FFsteve/zynq_vibration_monitor/report/final_board_record.md

# 最终实物验收记录表

> 2026-11-02 当前版本说明：传感器校准、真实滤波/ILA 数值对照及比赛演练已有记录，用户现确认最终蜂鸣器上板正常。当前下载、版本和复现入口以 [当前交付](current_release.md) 与工程根 README.md 为准；下文阶段描述保留各自历史时点。

范围说明：2026-11-01用户明确按比赛原型目标收尾。**本表是较完整的实物证据清单，不是比赛必须逐项全部通过的门槛**；“未验证”包含证据或版本登记不完整，不应解释为相应核心功能尚未实现。比赛当前完成度与最后建议见 [比赛收尾范围](../docs/competition_closeout_20261101.md)。保留以下实际结果及缺项，下一步默认一次完整演练和材料/版本整理，不继续按表机械追加测试。

最新比赛结果：`filter_test_final/`静止—X报警—正常恢复三种有效状态检查通过，见 [演练报告](competition_rehearsal_validation_20261101.md)。演练已完成，当前转入比赛材料与版本归档，不再把下表扩展未测项作为交付阻塞。

后续用户新增蜂鸣器：独立system_buzzer_top的软件对照及Vivado构建通过，新bit/ltx位于build/buzzer_release/debug，见 [蜂鸣器报告](buzzer_validation_20261101.md)。原演练结论继续对应原版；新声音尚未上板确认，只补报警响/解除停，不将旧截图当作新增蜂鸣器已验证，也不重开完整工程验收。

状态：**比赛核心功能演示已完成，B03、B07及B08按比赛范围通过，进入材料与演示版本归档**。filter_test_4取得3个窗口特征精确匹配及单拍发布证据；filter_test_final完成静止、X报警和有效恢复状态检查。详见 [演练报告](competition_rehearsal_validation_20261101.md)、[第四次报告](filter_test_4_validation_20261101.md)、[第三次报告](filter_test_3_validation_20261101.md)、[更新报告](calibration_firmware_update_20261101.md) 和 [六面结果](sixface_static_pass_20261101.md)。受控物理频响、三轮冷启动和完整工程边界未签收，保留事实，作为可选扩展，不阻塞比赛收尾。当前演示文件身份与材料尚待统一归档。

| 项目 | 待填内容 |
|---|---|
| 日期、操作者、硬件版本 | 未验证 |
| 发布标识及源码清单SHA256 | 未验证 |
| FPGA bit/ltx路径与SHA256 | 未验证 |
| STM32目标、AXF/HEX及SHA256 | 未验证 |
| 原始/滤波模式、计数尺度 | 未验证 |
| 跳帽、供电测量、接线照片 | 未验证 |
| DL16软件/采样率/深度/通道/门限 | 未验证 |
| PC串口或数字fixture、实际COM口 | 未验证 |

| 编号 | 结果 | 原始证据路径、实际值及未通过原因 |
|---|---|---|
| B01 接线/电压 | 未验证 | 待填 |
| B02 固定源原始回传 | 未验证 | 待填 |
| B03 固定源滤波为零 | 通过 | 2026-11-01 fixed_filter_ila_20261101的5秒记录：1250包D0固定1/−1/−32768，D1零三轴，同SEQ/XOR及位值均正确，无内部缺口或UART警告；报告fixed_filter_ila_validation_20261101.md |
| B04 初始化及六字节对照 | 未验证 | 2026-11-01 session01已取得身份/五项配置实际回读及4931组三路一致证据；本次未取得所烧bit/固件哈希，完整版本签收仍待补，详见session01_initialization_zup_20261101.md |
| B05 真实原始回传 | 未验证 | 用户报告当前D0/D1一致，符合raw预期；尚缺同次完整导出及bit/固件标识，不据此签收整机算法 |
| B06 60秒时序和错误统计 | 未验证 | 已完成60秒记录15030包的统计与三路对照，无内部SEQ缺口；120次约3ms间隔，均值3.991964ms、约250.503包/秒，严格均匀采样原因仍待定位，不再列为缺少60秒数据 |
| B07 同次原始/滤波对照 | 通过 | filter_test_3含初始化及SEQ=0首包，4914个完整D1自首包/预热开始与实测D0驱动定点参考全匹配，三轴最大差0，无输入重建/内部缺口；末D1边界截断单列。首包前静默超过12ms按既有超时规则确定滤波初态，不等于FPGA全局冷启动，详见filter_test_3_validation_20261101.md |
| B08 ILA窗口/RMS/峰值/报警 | 通过 | 按比赛功能范围：filter_test_4三窗MS/RMS/峰值及SEQ与参考精确相同、单拍有效与保持通过；filter_test_final新增静止、X报警和正常恢复有效状态，X报警图直接显示0→1及两高窗，恢复时quality/alarm_valid仍为1。解除边沿与全部边界不是本次比赛签收要求，未冒称已逐拍测完。详见competition_rehearsal_validation_20261101.md及filter_test_4_validation_20261101.md |
| B09 受控数字频率/报警 | 未验证 | 待填；无USB-TTL或标准源则说明未执行 |
| B10 中断恢复/三轮冷启动 | 未验证 | filter_test_3取得一次STM32重启后的初始化及首包滤波恢复数值证据；未捕获失效瞬间和同步ILA恢复全程，未做三轮整机冷启动 |
| B11 配置及量值校准 | 未验证 | 六面离线静态及重复性通过；sixface_r1_20261101_validated的C/Python全范围、三个Keil及HEX校核通过；用户已烧入新固件，filter_test_2及3分别取得4947/4915帧I2C新Q16校准到实测D0全匹配。实际下载产物身份、静止瞬态和周期问题仍待闭环，不再列为没有新固件实际输出 |
| B12 版本和完整演示 | 未验证 | 三阶段比赛演练已完成并取得截图；当前演示文件及报告/答辩材料的最终归档尚待整理，未验证不再表示没有完整功能演示 |

最终结论须区分数字内容、实际时序、传感器量值与校准、实物滤波及报警。每项仅填通过/失败/未验证，不自动把工具可生成文件或程序可烧录写成运行通过。
