FFsteve/zynq_vibration_monitor/report/progress_handoff_20261101.md

# 旧对话追溯与项目接续记录

日期：2026-11-01。用户因旧对话打开卡死，要求先追溯进度并充分理解项目。本记录用于后续新对话接续，不代表新增功能或重新签收历史测试。

## 阅读范围与证据等级

- 通过 `read_thread` 分六批读取“分析 UART RX 设计与硬件约束”（`01a14473-9b54-76b3-a507-fd7123c28133`）可返回的46轮记录，游标已到开头，`hasMore=false`。其中包含第七阶段一次失败及随后恢复完成的记录。
- 核对仓库规则、README、项目上下文、下一步、分期计划、第二阶段协议、最终板测表、第七阶段复核和冻结后校准分析，抽查当前完整系统顶层、核心连接、STM32采集和统一回归脚本。
- 本轮没有重新逐张审阅旧附件、重做原理图引脚或供电签核，也没有读取被引用聊天中不可返回的更早内容。历史聊天里的建议不能替代当前源码、实测证据或正式赛事指南。
- 本轮实际执行的是对话读取、Git状态检查、文件存在性与SHA256核验。历史ModelSim/XSim/Vivado/Keil结果仍标为历史执行结果，不冒充本轮重跑。

## 已确认的目标和范围

系统为MPU6050三轴采集，经STM32标准外设库读取与打包，再由Zynq PL接收、解析、去直流、FIR、窗口特征和阈值报警，最后串口回传。以单人可理解、可独立验证的模块组成竞赛演示系统，不承诺工业故障分类能力。

第一版仅PL，RTL使用Verilog，STM32使用Keil MDK和STM32F10x标准外设库。FFT、PS、AXI、Linux、PYNQ及实时图形上位机没有成为本版已批准必选项。重大新RTL仍须先评审设计；常规阶段自检已获授权自动执行，实物测试集中最终阶段。

十字节布局保持：`A5 5A SEQ XH XL YH YL ZH ZL CHK`，XYZ为大端signed16，CHK为SEQ与六个载荷字节的XOR。UART为115200/8N1。包内没有原始/滤波或校准模式标志，必须在采集元数据中记录固件目标、FPGA模式和尺度。

## 七阶段的实际进度

| 阶段 | 已实现内容 | 当前验收边界 |
| --- | --- | --- |
| 一 | UART RX、两级同步、中心采样、停止位检查及恢复、自检 | 历史双工具仿真通过 |
| 二 | 滑动窗口包解析、2ms字节超时、UART TX及链路自检 | 历史双工具仿真通过；损坏与截断后恢复属于明确要求 |
| 三 | 上电复位、回传队列、通信核心、旧top、STM32固定源/传感器目标、PC记录工具 | 历史软件检查通过；FixedSource截图和SensorSource短记录支持基本实物通信闭环 |
| 四 | 三轴去直流、63抽头定点FIR、调度与通信适配 | 历史数值、RTL、自检及隔离实现通过；实物滤波待验收 |
| 五 | 128样本非重叠窗口、均方值、整数RMS、绝对峰值、滞回两窗报警 | 历史双工具和参考对照通过；真实阈值与板测待验收 |
| 六 | 完整system_top、原始/滤波选择、量化、拥塞/复位验证与两模式实现 | 软件集成和实现通过；实物计划没有因仿真通过而自动完成 |
| 七 | 全量回归、raw/filtered/debug下载构建、rc1冻结、日志与波形补充归档、上板方案 | 软件候选版完成；整机B01～B12最终验收尚未完成 |

历史第七阶段汇总为18个RTL、19个不同自检顶层，ModelSim/XSim共42次阶段运行、24次负向拒绝，PC11项以及可移植C、原两个Keil目标通过。三种FPGA构建保留8项DRC Warning，不能写成零警告。

## 接续时不能混淆的实现细节

- 旧 `rtl/top.v` 是此前通信入口；完整算法入口是 `rtl/system_top.v`。不能因下载旧top或看到raw回传，就认为完整算法已经实物验收。
- 当前 `system_top` 默认 `RETURN_FILTERED=0`，两路对应十字节包一致是原始回传的预期。即使STM32使用实验校准固件，raw回传仍应与STM32输出一致。
- 获批的filtered回传将signed18结果算术右移2位装入signed16字段，PC解码后乘4恢复近似尺度；内部18位计算保持。包内没有模式标志。
- 名义采样率250Hz，三轴去直流基线更新系数1/32，63抽头FIR目标为保留5～30Hz、抑制50Hz及以上。实际采样均匀性仍须验证；去直流不等于传感器校准。
- 特征窗口128样本，名义512ms；报警2000置位、1500解除，连续两窗确认，均为演示参数。缺包或质量失效取消窗口并使报警状态无效，不能解释为正常无报警。
- RMS、均方值、峰值、质量与报警没有加入十字节UART字段，需通过内部接口或ILA观察。MARK_DEBUG不自动创建ILA；debug构建的bit与ltx必须配套。
- 原始模式曾被综合优化移除无负载计算支路，后以427位调试快照寄存器保留，并有重新实现证据。不要仅凭网络标记推断算法支路存在。
- GUI曾出现CDC约束顶层/阶段不匹配和FIR系数未登记；修正入口为 `scripts/configure_project_cdc.tcl`。它修正现有工程，不是从零创建完整GUI工程的脚本。

## 实物证据与当前主要问题

历史FixedSource已取得展示包的双路一致证据；SensorSource两份50ms记录各有12组I2C六字节、STM32三轴字段及FPGA回传对应一致。它们证明所检查短记录的通信，不证明长期无丢包、完整算法或正式量值校准。

静止数据曾按预期量程换算约1.34g；Z正反短记录支持约+5288计数的较大中点偏置，但配置实际回读、姿态及长期稳定性未充分确认，不能认定芯片损坏或直接宣称正式校准成功。旧记录还有边界停止位警告及约3ms包间隔，均保留为待查项。

冻结后分析六面共73个完整包，每面实际仅50ms。实验零偏为X约+704.160、Y约−535.333、Z约+5288.417计数，比例约1.007626/0.994537/0.983183。回代主轴接近正负1g是拟合结果，不是独立验证；横轴残差最高约0.137g。

独立 `stm32/keil/vibration_calibration.uvprojx` 的 `SensorCalibratedTrial` 已生成，软件历史检查覆盖196608个轴输入及应用错误恢复，三个Keil目标均有0错误/0警告记录。当前 `formal_calibration_pass=false`，无实验固件已烧录及板测通过证据。原 `SensorSource` 仍输出未校正计数；重新拟合必须使用该原始目标，不能拿实验校准数据二次拟合。

## 本轮实际核验结果

核验开始时执行 `git status --short --branch` 和 `git log -5 --oneline`：工作区干净，当前为main，本地HEAD及本地origin/main跟踪引用为 `4714435`。旧对话最后一轮记录了该提交已推送；本轮没有联网重新核验远端，也没有提交或推送。

因此旧差距报告中“只有初始提交、成果尚未保存Git”的结论已经过时；后续不得继续列为未完成。rc1目录、Git检查点和当前实验校准状态仍应区分。

使用运行时Python执行只读JSON/SHA256/ZIP条目核验（`python.exe -X utf8 -`，标准输入脚本），实际结果如下：

| 检查 | 本轮结果 |
| --- | --- |
| 当前RTL/TB文件数量 | 18/19，与历史汇总一致 |
| rc1的source.zip内文件对冻结清单 | 177项全部匹配 |
| rc1发布载荷对release_manifest | 97项全部匹配 |
| 实验校准validation.json中的源码 | 12项全部匹配 |
| 实验校准固件 | 2项全部匹配 |
| 实验校准证据，相对证据目录解析 | 13项全部匹配 |
| 本地第七阶段结果文件 | PASS_STAGE7_REGRESSION，10步骤，hardware_tested=false；只是读取历史结果 |

当前工作区相对rc1原177项有8项变化：`.gitattributes`、`.gitignore`、`docs/board_test_plan.md`、`docs/next_task.md`、`docs/project_context.md`、`report/ai_devlog.md`、`report/final_board_record.md`、`stm32/app/acquisition.c`。与冻结后的文档、Git及条件校准改动相符；不能把当前全部文件当作原rc1已验收源码。新增文件也不在原177项清单内。本报告和本轮日志追加还会进一步改变工作区，原冻结目录不变。

本轮未对约819MB补充波形ZIP重新执行完整哈希或逐份GUI审阅，补充归档完整性的结论仅引用历史复核记录。

## 下一步与尚未完成的收尾

1. 确认实板正在运行的bit和STM32目标；原始、滤波、实验校准的模式与版本都应留档。
2. 按既有方案补初始化配置实测回读、同配置预热后六面各约20秒，以及重新摆放后的独立第二轮；同时采集至少60秒时序，定位约3ms间隔。
3. 完成filtered量化、ILA窗口/RMS/峰值/报警、断流恢复、长时间和三轮冷启动，依B01～B12回填真实证据。
4. 新增校准测试和实验Keil目标尚未接入 `scripts/run_stage7.ps1` 的原10步骤，当前只存在单独历史通过记录。
5. 干净检出后的完整复现尚无演练证据；GUI从零建工程入口仍未提供。它们属于交付/学习工作流收尾，不自动扩大为新算法阶段。
6. 正式赛事规则全文尚未取得，报告、演示材料与Skill提交的具体格式仍待对照。板测修正或正式校准通过后再决定新候选冻结，不覆盖原rc1或沿用其哈希。

本轮仅新增这份接续说明并追加AI开发日志，没有修改RTL、STM32、约束、冻结包或烧录设置，没有重新运行仿真、综合、实现、Keil或实物操作。
