FFsteve/zynq_vibration_monitor/report/requirements_audit.md

# 最初要求与最终完整性核对

更新提示：本文为2026-10-31历史审计。2026-11-01已收到并读取正式AMD选题指南，且已完成后续校准、实物滤波/窗口及比赛演练；当前状态以 [正式指南对照](competition_guide_gap_analysis_20261101.md) 和 [一晚收尾计划](../docs/competition_evening_plan_20261101.md) 为准，以下“尚未收到规则/尚未上板”等保留为当时记录，不作为当前结论。

核对日期：2026-10-31。依据为本会话用户要求、AGENTS.md、初始README/project_context、原第六/七阶段截图和各阶段实际证据。**结论：PL软件实现、自动验证和可下载交付已形成完整闭环；新版整体实物验收及传感器量值校准尚未完成，不能表述为全部要求已经上板通过。**

没有收到一份可逐条核对的正式竞赛评分/提交规则全文。因此可核对已知项目要求，不能保证对未知评分、格式、原创性或公开许可条款的完全合规。FFT在初始上下文中是可选项，本版未实现，不将其当作已完成能力。

## 按已知要求核对

| 最初要求或后续确认 | 当前成果 | 判定与边界 |
|---|---|---|
| Zynq-7010 + STM32F103C8T6 + MPU6050 | FPGA/STM32应用、图纸核查、既有三端口约束、MPU6050标准库驱动 | 软件/图纸已核对，实际版本、电压和配置仍需现场复核 |
| 第一版仅PL，不学习PS即可推进 | 全部计算在Verilog PL，ILA也使用PL板载时钟 | 满足；未引入PS/AXI/Linux/PYNQ，保留ZPS7-1 Warning |
| Verilog和标准外设库，不用HAL/CubeMX | 18个RTL模块、STM32F10x标准库工程双目标 | 满足，最终实际重建及自检见第七阶段报告 |
| 50MHz、UART引脚/电压以原理图为依据 | U18、K14、M15及LVCMOS33沿用正式约束；新层次CDC精确切断第一级D | 图纸/工具通过，实测电压/频率未替代为已确认 |
| 十字节包、signed16、大端、XOR、SEQ和错误恢复 | 原协议保持，解析器支持坏包和截断恢复 | 满足，全部自检实际执行 |
| STM32采集，不承担FIR | WHO_AM_I、关键配置回读、DATA_RDY轮询、六字节采集及USART发送 | 软件满足，历史短记录通信一致，初始化/长期采样实测待补 |
| 原始数据回传及PC保存 | raw完整回包，PC二进制/CSV/JSON记录 | 已实现和离线验收；线上COM和长记录需实物验收 |
| 去直流、5～30Hz保留、50Hz以上抑制 | Q16基线 + 63抽头定点FIR，参考/RTL频响取证 | 已知设计目标在仿真中通过，实际传感器和采样条件待测 |
| 窗口均方、峰值、RMS、报警 | 128样本，三轴独立，2000/1500演示阈值、两窗确认 | 已实现/仿真，ILA调试下载版已生成；实物窗口与报警待测 |
| 原始/滤波选择 | RETURN_FILTERED综合参数选择；滤波线缆右移2位，PC乘4 | 按用户明确批准实现；无动态切换命令/模式字段，不假称支持 |
| 完整链路、250包/s、拥塞、延迟、复位 | 两模式长序列、三轴隔离、全部历史清理、队列满丢新包 | 软件验收满足；主长序列为压缩参数，另有默认参数验证，实际采样仍待测 |
| 模块自检，只有执行才报通过 | 18模块均有TB，另有UART链路TB；ModelSim/XSim全阶段回归 | 满足，第七阶段保留当前结果、日志和失败修正；ILA只做工具构建，尚未在板上连通 |
| 保存资源、时序和滤波效果数据 | raw/filtered/debug独立源码重建、DRC/CDC、CSV/JSON和哈希 | 工具证据完整，8项DRC Warning如实保留，不等于板测通过 |
| 文档/注释中文、ASCII路径、可复用skill | 已有中文说明，新增项目技能和结构验证，路径/标识符ASCII | 满足；厂商原文件不翻译不修改，未改全局技能目录 |
| 不破坏旧入口/烧录设置 | 旧top/本地XPR保留，最终system_top由独立脚本构建 | 满足；交付bit/ltx/AXF/HEX，不代为下载或改BOOT/Flash设置 |
| 七阶段回归、修复、冻结和交付 | 一键回归、候选冻结清单、源码包、下载包、完整板测方案 | 软件交付完成；冻结标记为v1.0-rc1，最终实物签收仍待执行 |

## 完整性检查发现并补齐的事项

1. 早期host/requirements.txt只有pyserial，缺FIR参考必需的NumPy，本轮补充依赖并记录实际验证版本。
2. 只有DCP无法直接供初学者下载，本轮从最终源码生成三种bit，并将Keil AXF转换为校验过地址/校验和的HEX，不改Keil烧录设置。
3. 原始协议不含RMS/报警，只有MARK_DEBUG不等于能观察；本轮提供独立ILA调试版和配对ltx/probe_map，填补内部实物观测入口，不新增引脚或协议。
4. skill/原为英文占位说明，现提供基于实际失败与验证过程的fir-validation技能及结构验证，未声称做过独立代理行为评测。
5. 受控机械激励未提供，不能把手摇当频响标准；新增离线数字fixtures和显式COM口回放工具，另列需要USB-TTL的数字验收路径，本轮只做假设备自检、不打开真实串口。

## 仍需实物确认的事项

- B01～B12按 [完整上板方案](../docs/board_test_plan.md) 执行，并填写 [实物记录](final_board_record.md)。新版完整链路尚未下载或采集。
- MPU6050较大静态偏差、实际初始化回读、六面记录、校准和真实采样均匀性；演示阈值不是实际故障分类标准。
- bit/ltx的实际JTAG识别、板上50MHz时钟/IO电压、冷启动流程、长记录与实际滤波/报警表现。
- DRC的DSP流水建议、保留观测网无路由负载和ZPS7配置Warning；没有通过降级或屏蔽规则假称零警告。
- 正式比赛评分与公开资料授权若有额外条款，需提供规则全文再核对。源码包不包含用户厂商库和硬件PDF，重新构建STM32仍依赖本地Libraries。

因此当前适合进入完整上板验收，**不适合在尚未执行时宣称最终实物项目全部通过**。板测发现的问题应形成新候选版本，不改冻结源码后沿用旧哈希。
