FFsteve/zynq_vibration_monitor/report/reference_conversation_gap_audit_20261031.md

# 早期实施对话与当前工程的差距核对

核对日期：2026-10-31。对照用户引用的“FPGA学习项目建议”与当前工作区、历史验证结果和最新校准结果。结论：核心PL信号链的软件已经实现；基本通信有实物证据，但项目尚缺完整算法板测、正式量值校准、真实采样稳定性验证，以及Git和可复现交付的收尾。

## 对话读取范围

使用read_thread读取会话 `6a96c59b-b664-83ea-af67-c74b80f26f4b`，turnLimit=10。接口返回5轮、hasMore=false、无更早游标：三份硬件PDF、核心板与工作流交接、沙箱故障、目录/gitignore、Git推送故障。实际返回的正文包含硬件/采集方案、逐模块开发、自检/综合/实测、Git、复现脚本和Skill建议；不只使用用户提供的最后三轮预览。

没有返回更早的完整选题讨论或正式AMD赛道指南全文。旧助手提及的“比赛要求”只能作为待核对线索，不升级为已验证的正式规则。旧聊天的建议、当前用户已批准的范围、可选扩展与正式评分要求应分开。

## 已实现并有软件证据的内容

| 早期方案或工作流 | 当前实际成果 | 当前边界 |
| --- | --- | --- |
| STM32标准库采集MPU6050三轴 | WHO_AM_I、配置回读、DATA_RDY、连续六字节、UART打包 | 初始化实测证据及长期采样仍待补 |
| PL接收、包解析与发送 | UART RX/TX、十字节大端signed16/XOR/SEQ、超时和坏包恢复 | 历史及当前基本通信证据不等于所有板测通过 |
| 处理重力与偏置直流分量 | 三轴去直流与63抽头定点FIR，250Hz/5～30Hz目标 | 去直流不等于传感器量值校准 |
| 特征提取与异常提示 | 128样本窗口、三轴均方/峰值/整数RMS、滞回两窗报警 | 2000/1500为演示阈值，尚无真实故障分类结论 |
| 仿真、综合和量化 | 18RTL/19TB；历史ModelSim/XSim42次阶段运行、24次负向拒绝；三版资源/时序/DRC | 本次读取既有结果，没有重新运行这些任务 |
| PC保存原始数据 | 命令行二进制/CSV/JSON记录、独立协议解析、数字fixture和比对 | 没有实时曲线GUI；当前可读对话未将其规定为第一版必选 |
| AI协作与可复用Skill | AI开发日志、阶段设计/验证文档、skill/fir-validation技能 | 技能结构验证完成，正式赛事格式及独立使用效果仍需对照指南 |
| 从源码构建下载文件 | build_release.ps1/.tcl生成raw/filtered/debug的bit，debug有配对ltx | 该流程不依赖用户本地xpr，但不等于已验证干净克隆全部流程 |

现有 `build/stage7_regression/regression_result.json` 为 `PASS_STAGE7_REGRESSION`。三版 `release_result.txt` 为PASS，raw/filtered/debug的建立裕量分别5.205/8.300/5.432ns、保持裕量0.037/0.028/0.014ns。依据为既有实际执行记录，不将其冒充为本次重跑结果，也不覆盖后续新增C代码的全部验证。

## 尚未完成的工作与建议优先级

| 优先级 | 待办 | 目前依据与验收内容 |
| --- | --- | --- |
| 高 | 正式六面量值校准 | 当前六面均为50ms，共73完整包；实验系数/C代码已验证，但无长记录和独立第二轮，横轴残差最高约0.137g。补同配置每面约20秒、重复摆放与配置回读，固定第一轮参数验证第二轮 |
| 高 | 真实250Hz采样稳定性 | xn有3.00345ms、旧zp有2.99475ms间隔。需至少60秒线缆记录及SEQ/错误统计，定位异常；不能靠改时间标签或零偏参数使其“通过” |
| 高 | 滤波功能的板上量化 | 当前D0/D1一致符合raw预期，只支持原始回传。需filtered版、明确乘4尺度、原始与滤波记录、已知数字频率输入及实际滤波效果证据 |
| 高 | 窗口特征与报警板测 | 使用匹配debug.bit/ltx，通过ILA核对128样本窗口、三轴MS/RMS/峰值、窗口ID、质量无效与报警置位/解除。UART十字节本身没有这些字段 |
| 高 | 长时间/异常恢复/冷启动 | 已有仿真覆盖，但还缺整机实物断流/恢复、复位、三轮冷启动和连续演示记录。按B01～B12逐项回填，不因raw正常而自动通过 |
| 高 | 保存当前成果的Git提交 | 实际git log只有e4145f0初始提交，标签只有v0.0，RTL/仿真/host/脚本等大量未跟踪或未提交。完成范围审查后提交已验证成果；不得把本地rc1文件夹当作已有同名Git标签 |
| 中 | 将新增校准纳入统一回归 | 当前run_stage7.ps1仍只有原10步骤：未调用test_calibration.ps1，也未构建SensorCalibratedTrial。它们单独通过，但还不是统一入口的一部分 |
| 中 | 干净检出的复现演练 | 核对工具版本、参数、NumPy/pyserial、MEM、STM32本地Libraries依赖；在独立干净目录重建并记录结果。源码ZIP和独立build已有证据，Git clone目前却无法取得未提交文件 |
| 中 | GUI工程创建入口 | 没有create_project.tcl。configure_project_cdc.tcl是已打开工程的修正脚本，不负责从零添加全部RTL/TB/XDC/MEM和选择顶层。为学习/演示补一键建工程入口有价值；现有批处理bit构建仍然有效，不把它称作核心算法缺失 |
| 中 | 最新记录与最终版本统一 | README/host说明和最终板测表仍有早期“未上板/仅两STM32目标”等时点描述；实验校准及GUI修正也不属于已冻结rc1。通过板测后统一版本、报告、日志与哈希，再决定新候选冻结 |
| 待规则 | 竞赛提交与Skill实际效果 | 可复用技能、源码包和AI日志已存在；正式报告、演示视频、Skill提交格式/调用效果、开源清单等是否必交及具体格式，需要正式指南原文核对，不从旧助手口述推定 |

Git远程origin已经配置，本轮只读取本地状态，没有联网核对远端是否另有手工上传，也没有commit、tag或push。另发现 `report/evidence/__pycache__/analyze_sensor_capture_20261030.cpython-312.pyc` 仍出现在可提交的未跟踪列表，说明 `!report/**` 放行覆盖了通用缓存排除，正式提交前应完善忽略规则。没有擅自暂存或删除该文件。

## 已更正的旧描述，不应重新当作待实现任务

- 旧对话将PL_GCLK写成U13；本次重新提取并渲染核对 `docs/hardware/zynq_core_2v5.pdf` 第3页，X1的50MHz输出经R7连接PL_GCLK，再接Bank34的U18。U13对应B34_L3_P/PUDC_B。现行top.xdc使用U18，不应改回旧聊天的U13。
- 旧对话推荐PB6/PB7的I2C1；当前根据用户实际扩展板选择通讯接口2的PB10/PB11、I2C2。本次实际读取并渲染F盘扩展板原理图第3页核对，J3/J4的3/4脚分别为PB10/PB11。旧I2C1方案并非必然电气错误，但不应覆盖已确认的当前配置。
- 旧对话中的top_candidate.xdc和四端口带rst_n示例已被正式约束与当前顶层替代；不是还缺外部复位引脚或LED模块。当前上电复位与调试方式已有明确设计。
- 旧对话给出的create_project.tcl等文件名是工作流建议，不要求必须逐字沿用；现有批处理脚本已经承担仿真、综合/实现和资源报告功能。

本次只读的PDF来源：仓库 `docs/hardware/zynq_core_2v5.pdf`，以及用户已提供的 `F:/野火小智STM32F103C8专题资料/5-配套模块/0-野火小智STM32F103C8T6扩展板/原理图_尺寸图/野火小智STM32F103C8T6扩展板原理图.pdf`。原文件未修改或复制到交付目录，渲染图只放在被忽略的build/reference_conversation_audit下。图纸核对不替代板上频率、电压或连接实测。

## 可选扩展与当前范围

FFT/频谱、PS/AXI/Linux/PYNQ、DMP/陀螺仪、OLED和实时图形上位机均未实现。当前已确认版本以PL振动处理为范围，FFT在项目上下文是可选项，其他功能没有获准成为本版必选项。若完整原始指南另有要求，再列入新增范围；不能仅因旧对话提到未来FFT，就推断第一版少做了一整个阶段。

## 本次变更与后续顺序

本次仅新增本核对报告、更新最终板测记录表的状态说明和AI日志，没有修改RTL/STM32程序、参数、约束、Git历史或冻结交付包，没有重新仿真、实现、烧录或采集。

建议先保存当前已验证软件的Git检查点并标明实验校准状态；再完成同配置长记录、采样时序与独立校准；随后验证filtered/ILA/报警及长时间/冷启动；最后补齐统一回归、干净复现、最终报告与新候选冻结。若先改善学习工作流，可先补GUI工程创建脚本，不因此增加FFT或PS范围。
