FFsteve/zynq_vibration_monitor/report/stage7_completion_review.md

# 第七阶段中断前计划的逐项复核

复核日期：2026-10-31。依据为用户补充的原第六/七阶段截图、`docs/stage_plan.md`、中断前形成的第七阶段任务和当前真实文件。**结论：软件任务已完成；发现的波形/部分日志交付遗漏已补齐；原计划的整机冷启动和完整实物演示仍未执行，不能将整个实物验收称为完成。**

本轮没有再次运行全部仿真、综合或Keil，而是核对其已完成日志、当前结果、冻结源码及交付文件哈希；没有代码改动需要重新验证这些功能。没有接线、下载、复位、测量、采集或打开真实串口。

## 原计划逐项对照

| 中断前预定任务 | 本次复核到的实际证据 | 状态 |
|---|---|---|
| 修复已发现问题 | PowerShell stderr包装、ILA比较单元参数及计算分支保留问题均有首次失败与修正后成功记录 | 软件部分完成 |
| 运行全部自检TB | 18个RTL、19个不同TB；ModelSim/XSim共42次阶段运行，当前结果均PASS/errors=0 | 完成，依据既有实际执行记录 |
| 重跑失败案例 | 最终一键回归10步骤成功；三版重新构建成功；边界/错误恢复、负向拒绝覆盖保留 | 完成，不把初次失败当通过 |
| 最终源码重新综合、实现、检查时序/DRC | raw/filtered/debug三版bit、DCP及报告存在；setup/hold分别5.205/0.037、8.300/0.028、5.432/0.014ns | 完成，保留8项DRC Warning，不是零警告 |
| 版本冻结 | rc1源码ZIP的177个文件逐项核验，97项交付载荷哈希一致，ZIP CRC正常 | 完成，冻结候选包未改 |
| 操作说明与上板方案 | `docs/stage7_delivery.md`、`docs/board_test_plan.md`、B01～B12记录表存在，覆盖接线/下载/固定源/传感器/滤波/ILA/恢复 | 文档完成，方案不等于实测 |
| 波形整理 | 原本全部42个WLF/WDB只留在build，rc1交付清单未包含；本轮已另行归档、建立阶段/TB索引并核验每个文件 | 原有交付遗漏，现已补齐 |
| 日志与AI开发记录 | 原源码ZIP含AI日志、候选包含回归日志；原包外的最终构建、首次失败日志现收入补充包，并追加本轮复核记录 | 完成 |
| 从干净启动可重复运行、完整实物演示 | 软件回归/构建与上电复位TB通过；但新版B01～B12仍未实测，没有整机三轮冷启动或ILA硬件采集记录 | 未完成实物验收 |

因此，上一次“软件候选版已完成”的结论成立，但“交付证据整理已经完整”不够严谨：原候选包没有直接收录波形和部分构建/失败日志，本轮已用独立证据包补交。

## 补交内容

原候选包仍为 `build/release/v1.0-rc1/`。补充包单独位于：

```text
build/release/v1.0-rc1-evidence-20261031/
    simulation_waveforms.zip
    evidence_manifest.json
    external_dependencies.json
    logs/
    completion_review.md
    ai_devlog_review.md
    review_manifest.json
```

- 波形ZIP有42个实际仿真文件：每工具21份，包含重复的队列/解析器针对性回归。总原始大小约1.020GB，压缩包818807700字节；没有重新生成或伪造波形。
- `evidence_manifest.json`记录每份波形所属阶段、TB、原路径、压缩包内路径、大小和SHA256；ZIP CRC与逐文件解压哈希均通过。
- `logs/`补入第七阶段最终回归、首次中断、最终构建、ILA首次失败等日志；保存技能结构验证的本次正常结果。
- `external_dependencies.json`是复核时本地88个STM32库文件的指纹，只给出路径与哈希，不分发厂商源码；不冒充此前编译时独立留存的依赖快照。

解压波形ZIP后，可用相应版本的ModelSim打开WLF，或在Vivado中通过 `File -> Simulation Waveform -> Open` 打开WDB。完整系统示例路径为 `modelsim/stage6/system_monitor_core/vsim.wlf` 和 `xsim/stage6/system_monitor_core/stage6_system_monitor_core.wdb`。本轮完成的是文件与归档完整性核验，没有逐份进行GUI波形审阅。

## 冻结与本轮修改的边界

没有改动rc1目录、其中的源码ZIP、bit/ltx、STM32固件或发布清单；也没有修改RTL、STM32源码和原Vivado工程。本轮只新增复核/补充证据，并向工作区 `report/ai_devlog.md`追加复核条目。

因此，冻结源码ZIP内177项仍全部匹配原source_manifest；工作区AI日志是冻结后追加的记录，预期与原快照的AI日志哈希不同，不代表旧包被修改。其他原有冻结源码应继续匹配；本轮新增报告和证据不伪装成rc1原清单的一部分。补充包另有review_manifest记录自身哈希。

## 仍待实际执行

按 [上板方案](../docs/board_test_plan.md) 执行B01～B12，并填写 [实物记录](final_board_record.md)，重点包括新版整机的三轮冷启动、ILA识别和采集、长期采样、传感器初始化/校准，以及真实滤波和报警表现。历史第三阶段短通信记录不能替代这些结果。

本轮没有发现需要重写或重新编译的软件功能遗漏；剩余工作的性质是实物验收。完成这些记录前，准确表述应为“第七阶段软件和交付整理完成，整机实物验收待完成”。
