FFsteve/zynq_vibration_monitor/docs/next_task.md

# 蜂鸣器版本交付与后续设计报告

> 2026-11-02 当前版本说明：传感器校准、真实滤波/ILA 数值对照及比赛演练已有记录，用户现确认最终蜂鸣器上板正常。当前下载、版本和复现入口以 [当前交付](../report/current_release.md) 与工程根 README.md 为准；下文阶段描述保留各自历史时点。

## 当前主线：保存最终工程，再编写设计报告

2026-11-02 用户确认最终蜂鸣器上板正常，并要求先完成 MIT 开源、Git/GitHub 同步、独立工程包和全流程 Skill。当前根 README、skill/README、report/current_release.md 与 scripts/package_final.py 是交付入口；设计报告按用户安排后续完成，优先补充应用价值、系统框图、真实量化/资源时序、优化依据、AI/Skill与复现说明。

保持 Vivado 2020.2 和当前纯 PL 架构，不迁移 PYNQ、不升级工具链、不重开全套板测。以下章节保存此前工作安排，不应重新作为当前待办执行。

## 历史记录：板载蜂鸣器报警扩展

用户在原比赛演练完成后请求增加蜂鸣器。已核对底板/核心板实际图纸及厂家资料：有源BEEP为M14/Bank35，高电平导通。新增alarm_buzzer和独立system_buzzer_top，原system_top及18份既有RTL不变；ModelSim/XSim的模块自检和新旧顶层逐拍对照均通过。已实际生成 `build/buzzer_release/debug/system.bit` 与同目录ltx，独立50MHz实现建立/保持裕量7.377/0.020ns，保留8项DRC Warning。见 [蜂鸣器扩展](buzzer_design.md) 和 [验证报告](../report/buzzer_validation_20261101.md)。下一步仅由用户下载新配对文件，保持当前STM32校准程序，确认静止不响、报警响、解除停；原比赛三图属于旧版，不能替代新增声音的实测，不重新开始完整测试清单。

## 历史记录：按比赛目标收尾

2026-11-01最新状态：`filter_test_final/`三张截图已实际审阅，静止RMS23/23/29且无报警，运动X轴RMS3372并报警001，放稳后RMS17/18/21且报警000，三种状态quality/alarm_valid均为1。报警图还直接显示X位0→1，前后两高窗符合确认规则。**三阶段比赛演练检查通过，默认功能测试结束，下一步材料整理和当前演示文件归档。** 详见 `../report/competition_rehearsal_validation_20261101.md`。

已完成的操作步骤保留于 [一次完整比赛演练](competition_rehearsal_20261101.md)，供现场复现使用，无需为收尾再次重复采集。

用户强调这是独立学生比赛项目。按 [比赛收尾范围](competition_closeout_20261101.md) 执行：核心采集、校准、通信、滤波和窗口数值已取得实物证据，已观察Z报警；下一步只建议一次完整演练，补观察正常解除，整理现有结果和当前演示文件。原B01～B12是完整证据清单，未全部签收不等于比赛功能都没完成。

不再默认要求报警边沿逐拍捕获、全部频点实物回放、三轮冷启动、重复六面/60秒或已覆盖的故障逐项上板；这些保留为可选扩展。演练出现实际功能问题再针对性定位；规则另有明确要求时补相应缺项。保持已测/未测事实，不把缩减范围写成测试通过。

前述 [报警边沿采集](alarm_edge_capture_20261101.md) 方案仍保留，作为可选提高项，不再是默认下一步。

## 最新板测：第四次ILA窗口数值通过，已观察Z报警

2026-11-01的filter_test_4/static及motion均取得原始ILA/CSV，两份CSV与各自.ila嵌入文件相同。static新窗精确匹配本次窗口0，MS/RMS/峰值全相同；motion前后两窗精确匹配本次窗口6/7，三轴全部相同，单拍feature_valid与保持由1024点CSV确认，B08窗口数值子项通过。用户确认static未重配、motion重配过FPGA，两份均在对应DL16期间触发；累计ID5620及54通过数值唯一匹配定位，不因非零重采。

静止4752帧I2C校准/D0/D1一致；运动4829帧实测D0校准匹配，I2C/D1共4834帧连续，D0约3.34秒缺5帧仅作I2C重建，滤波全匹配；缺测后纯实测独立3145帧也匹配。两份各41次约3ms仍在。详见 `../report/filter_test_4_validation_20261101.md`。

运动ILA已见Z轴报警100：窗口6 RMS=2226，下一窗325仍保持100，与参考两窗确认一致；前一高窗2975及后一解除窗416为模型结果，当前ILA没有覆盖置位/解除边沿。下一步优先补正常报警解除与置位边沿的原始ILA及同次输入，然后B10同步中断恢复和三轮冷启动；B09受控数字频率独立待测。无需重复本轮窗口数值或六面校准。以下为历史记录。

本轮使用的操作说明保留于 [ILA同步采集操作](ila_next_capture_20261101.md)，它是已执行记录的方案，不再作为尚缺两份采集的待办。

## 最新板测：第三次记录B07通过，下一步补完整ILA与恢复

2026-11-01 `filter_test_3/` 实际捕获初始化、配置回读及SEQ=0首包，D0共4915帧全部与新Q16校准匹配；4914完整D1从首包起与定点参考精确一致，包括预热，不用重建或舍弃前段，B07本记录通过。末D1为20秒右边界截断，6字节前缀匹配，不当中途丢包。首包前无数据超过12ms、按既有断流重建规则确定滤波初态；不是FPGA全局冷启动。

复位前ILA截图独立核对：ID8AC→8AD，SEQ3E/BD→BE/3D均128点，非零MS/RMS/峰值及开方关系合理，quality/alarm_valid=1、alarm_axes=000、dropped=0。历史重建/作废各6未在图中增加，不将其归于后续采集。没有原始ILA数据，不能与复位后的UART直接逐窗配对。详见 `../report/filter_test_3_validation_20261101.md`。

下一步B08保存静止/移动的原始ILA数据及CSV，继续B09受控连续两窗报警和B10同步中断恢复/三轮冷启动；不再要求重复本次已完成的真实滤波对照或六面校准。本次模型预测37窗RMS最大1099/381/533，低于2000，慢动作不报警符合预期，但不是实测报警验收。41次约3ms短间隔仍在，实际约250.526包/秒，采样均匀性仍待定位。以下为历史接续，最新状态以本节为准。

## 最新板测：新校准输出与真实输入滤波已取得逐帧证据

2026-11-01用户新增 `fixed_filter_ila_20261101/filter_test_2/`，并确认未重新配置FPGA、STM32启动后才记录，约5.76秒开始移动且可能碰探头。实际20秒记录：D1共5010帧连续无误，I2C共5009笔六字节读取，4947帧I2C经新Q16校准与实测D0完全一致。板上新校准公式已得到数值验证，不再列为“没有实际输出”。

D0在5.763～6.041秒受扰，缺62帧并有起止位/Break错误；D1与I2C连续，较支持探测路径受扰，不能直接称FPGA丢62帧。未知初态保守传播并按连续实测段分别预热1024样本后，2892帧三轴D1完全精确匹配参考；另以I2C重建缺测输入，整体后段3986帧也匹配，实测与重建分别标注。详见 `../report/filter_test_2_validation_20261101.md`。

下一步B08真实动态ILA：保留同版debug bit/ltx，用feature_valid触发，保存静止/移动的完整窗口及原始ILA数据、CSV，核对MS/RMS/峰值、SEQ、ID、质量/报警与历史计数。若补严格B07启动证据，则停止STM32、重配FPGA、先开始采集再启动STM32，固定探头后做静止—移动—静止；不再重采六面。本记录39次约3ms短间隔仍在，B07完整启动、B08动态报警、B09受控频率和B10恢复/冷启动尚未整体签收。以下为历史接续，最新状态以本节为准。

## 最新板测：固定源滤波归零通过，进入真实输入对照

2026-11-01用户提供 `report/evidence/fixed_filter_ila_20261101/`。本轮实际离线检查5秒D0/D1各1250完整包，输入固定1/−1/−32768，输出零三轴，对应SEQ/XOR及字节位值全部一致，无内部缺口/警告；B03本份记录通过。间隔平均约3.999949ms、范围3.992～4.002ms，没有约3ms短间隔，但不能因此将SensorSource问题撤销。

ILA截图人工核对质量/报警有效、零MS/RMS/峰值、alarm_axes=000，窗口C1→C2且首末SEQ跨度符合128样本。历史filter_restart/aborted_windows各2，原因未定；左值栏feature_valid=0为起点光标，不等于触发失败，单拍/512ms周期未由截图自动验证。B08只取得固定源零特征证据，不整体签收。

下一步B07：新SensorCalibratedTrial配同版debug，干净启动保存同次D0/D1，以已校正D0驱动参考、D1乘4恢复尺度；先静止和简单运动观察，再进入受控动态/报警。B10另从干净配置记录重建/作废事件和冷启动。详见 `../report/fixed_filter_ila_validation_20261101.md`。

## 当前板上GUI版本：原始回传加ILA

2026-11-01用户说明板上已加载 `vivado_project/zynq_vibration_monitor.runs/impl_1/system_top.bit` 与同目录ltx。本轮只读核对既有产物：顶层system_top、综合日志RETURN_FILTERED=0、u_ila_0共21组427位，生成bit成功；既有路由时序WNS=5.573ns/WHS=0.016ns，保留8项DRC Warning。文件指纹与探针映射见 `report/evidence/gui_bitstream_20261101.json`，未重跑构建或通过硬件管理器读取板上版本。

可以先保持这组文件进行FixedSource＋ILA内部窗口验证。该版为raw回传，D1应与D0相同，不能要求D1零三轴；内部有效窗口MS/RMS/峰值应为0。u_ila_0/probe19为debug_feature_valid_o、probe20为quality_valid、probe18为alarm_valid、probe17为window_id。与预制stage7_ila探针编号不同，按实际ltx信号名设置。

当需要从D1检查滤波数据时，再用RETURN_FILTERED=1的版本或现成配对filtered/debug产物；若修改GUI综合参数则重跑综合/实现/bit并使用新ltx。当前只加ILA并未改变回传选择。以下“D1零三轴”的步骤仍限filtered回传模式。

## 当前接续：校准暂时收尾，转入算法板测

2026-11-01用户明确表示传感器校准暂且结束，询问按原计划继续做什么。保留已完成的六面离线静态、参数更新及软件构建结果；新参数固件实际板测未提供，不能补写为通过。暂不继续采六面或调整参数。

当前首个操作为B03结合B08的固定源测试：STM32原工程选择FixedSource；FPGA使用已生成的filtered版或配对debug bit/ltx，采D0/D1约2～3秒。D0为固定1/−1/−32768，D1应为零三轴且SEQ/XOR正确。通过后以feature_valid触发ILA，检查quality/alarm_valid、window_id和零MS/RMS/峰值、alarm_axes=0。手工ILA版本必须核对RETURN_FILTERED，增加ILA不会自动把raw改为filtered。

随后进行B07真实输入原始/滤波同次对照、B09受控数字频率与报警、B10中断/恢复及三轮冷启动，再补最终回归/版本和B12演示归档。真实输入可用本次SensorCalibratedTrial，D0已校正，D1滤波signed16乘4后与以D0为输入的参考比较；不能再要求I2C原始六字节与校正D0直接相同。没有实际记录不标为通过。

约3ms周期和旧60秒静止瞬态仍是独立未解决项；当前固定源功能验证不依赖先重做传感器标定，真实动态频响签收仍需处理或明确这些时序/信号条件。统一第七阶段校准专项接入和干净复现也保留后续收尾，不重复已有60秒采集只为满足时长。

## 2026-11-01校准参数已更新并完成软件构建

用户授权根据已通过的静态测试更新参数。独立SensorCalibratedTrial已改为 `sixface_r1_20261101_validated`：Q16零偏47687499/−36176278/341942451、比例65840/65180/64097。原SensorSource/FixedSource保持原行为，原始十字节布局、RTL/约束和rc1不改。参数与验证见 `../report/calibration_firmware_update_20261101.md`。

本轮实际通过196608轴值C/Python、错误恢复/固定源绕过、原可移植测试、三个Keil目标0错误/0警告、实际C映射六面30059样本及HEX校验。旧参数/实验固件已另存，当前版本副本在 `build/stm32_calibration_versions/sixface_r1_20261101_validated/`。首次Keil因旧编译器DLL重定位失败，换执行环境后成功，日志均保留。

下一步使用新独立目标或同版HEX由操作者下载，保存代表姿态实际校正输出；本轮未烧录。D0此时已校正，raw回传D1仍应逐包一致，不能再当原始标定数据。周期3ms、静止瞬态、滤波/ILA/报警及冷启动仍单独验收；不要再把“参数尚未更新”列为待办。

## 2026-11-01静态离线指标已通过

最新报告为 `../report/sixface_static_pass_20261101.md`。新增yp_r2b以第一轮固定参数校正后均值约−0.026069/+1.000052/+0.027492g，合成均值1.000789g，满足建议目标。结合xp/xn/zn_r2b和原yn/zp_r2，六面均值指标及三轴偏置/比例重复性全部满足；第一轮参数未改，不必继续为凑均值采六面或重拟合。

结果单独记录offline_static_validation_pass=true，新参数固件板测仍为false。下一步转向这套第一轮参数的新固件落地、定点/恢复/Keil检查及实际输出验证，保留原SensorSource和rc1；旧SensorCalibratedTrial仍是旧短记录参数，未更新。3ms周期和旧60秒瞬态、完整滤波/ILA/报警/冷启动仍各自待查或待验收。

## 2026-11-01补采复核的最新状态

见 `../report/sixface_r2b_validation_20261101.md`。已明确选取原_r2目录内xp/xn/zn的_r2b、新替换yp_r2和原有效yn/zp_r2。新yp不再重复，六份共30059完整D0包，可比通信全部一致，第一轮参数未改。旧重复yp原文件由用户删除，旧报告和派生结果保留。

xp/xn/zn复测均满足既定均值指标，结合yn/zp共5面满足；只剩新yp校正后Z均值+0.091213g超0.05g，主轴与合成幅值均值满足。三轴重复性诊断偏置差+8.93/−24.21/+17.17计数、灵敏度差−0.00417/−0.19546/−0.03263%，均在建议范围。

下一步只针对Y朝上核对姿态后保存yp_r2b，不用全部六面重采或改变第一轮参数；若确认姿态后仍重复超限，再查模型和条件。周期3ms及旧60秒瞬态仍待查，formal_calibration_pass=false，旧实验固件未更新。

## 2026-11-01第二轮验证的最新状态

见 `../report/sixface_r2_validation_20261101.md`。已用第一轮固定参数分析r2六目录，发现yp_r2的三CSV及四路原始采样均重复xn_r2，故仅五份独立记录。Y朝上需要找回真正原记录或补采，单纯重导出当前yp原波形不能修复；Y重复性标为不可评估，不把错误目录计算成器件失效。

有效五面的可比通信均通过，主轴均值误差<0.005g、合成幅值均值约1g；yn/zp满足建议均值指标，xp/xn/zn横轴有0.059～0.084g残差而未满足0.05g目标。X/Z两轮偏置/灵敏度诊断差在建议范围内，但未替换验证参数。下一步先补正确yp，再用固定支撑针对xp/xn/zn复核，保留旧r2记录，不自动六面全重测或重拟合第二轮。

第一轮参数文件及24份r2输入在分析中未改；formal_calibration_pass=false。周期性3ms间隔与旧60秒静止瞬态仍待查，旧实验固件参数未更新。

## 2026-11-01第一轮六面长记录已齐

最新结果见 `../report/sixface_r1_analysis_20261101.md`。用户补齐X/Y并确认同模块、原SensorSource与配置不变、摆稳静止；六份各20秒、共30059完整D0包。六份可比I2C→D0→D1全部一致，首尾片段单列，无内部SEQ缺口。24份原文件哈希前后相同。

新三轴初值b约727.653493/−552.006188/5217.627726计数，k约1.004642976/0.994565297/0.978043625。同批回代非主轴最大均值残差约0.049664g，合成均值约1.000146～1.002082g，但主轴正负1g是拟合结果，尚无独立第二轮，formal_calibration_pass=false。下一步采同配置r2六面各20秒，以这套固定参数独立验证，不再列缺少第一轮X/Y。

xp/yn存在静止瞬态，zn的Y残差接近0.05g，xn横轴有缓慢变化；各新记录均39个约3ms间隔，周期/瞬态问题仍待查。旧实验参数头和SensorCalibratedTrial固件未更新，不能当作本轮六面参数版；本轮未修改功能程序或烧录。

## 2026-11-01无复位Z正反面和60秒结果

同日最新复核：用户已补正确Z朝下I2C导出，14991笔完整事务ACK正确，5009个完整包I2C→D0→D1全部一致；末尾额外一次读取对应截断包头。此前误导出待办已解决，原波形与D0/D1未变；新复核另存 `report/evidence/20261101_noreset_analysis/zn_i2c_recheck/`，不覆盖首次问题证据。

最新结果见 `../report/noreset_zpair_60s_20261101.md`。三个波形实际达到60/20/20秒，完整D0包分别15030/5010/5009，均无内部SEQ缺口。60秒与Z朝上20秒的I2C→D0核对通过；可比D0→D1全部相同，边界片段单列。Z朝下命名为I2C的CSV实际与D0完全相同，应从已保存atkdl重新导出，不必重采。

新Z两点初值bz=5217.627726计数、Sz=16751.809000计数/g、kz=0.978043625，尚未写固件，formal_calibration_pass=false。Z正反20秒已达到时长，可作第一轮初值，不再要求因首末包跨度略短于20秒重采；补同条件X/Y与独立第二轮。

60秒确认120次约3ms间隔，平均每0.502秒重复、发包率约250.503包/秒；时长证据已取得，后续应针对时基/轮询关系定位。用户确认全程固定静止未主动触碰，但6.3/13.4/34.4秒等处有明显原始数值瞬态，Z范围13704～30258，三路一致；原因未查明，不删除后宣称静态精度正常。

## 2026-11-01最新实物记录

已分析用户确认的原SensorSource、Z朝上静止20秒记录，详见 `../report/session01_initialization_zup_20261101.md`。本份记录实际回读75=68及6B=01/1A=02/19=03/1C=00/38=01，初始化证据已补齐；4931完整包I2C→D0→D1全部一致。中途复位形成320.779ms包起点间断，复位后完整包起点跨度18.623761秒，不能拼成正式20秒连续姿态样本。

排除复位后首秒的4415样本中，XYZ均值约675.672/−653.086/21979.931，合成约1.342788g，偏大持续存在。该稳态段平均发包约250.500包/秒，有35个约3ms间隔，后续约每0.5秒重复；1ms轮询与DATA_RDY相位关系是待验证方向，不宣称根因已定位。

当前优先保持原固件与raw回传，预热后采无复位的六面各20秒和独立第二轮，并另补60秒时序记录。无需重采同样的初始化来替代正式姿态记录，也不将本次回读证明追溯套用到旧六份短记录。正式校准、滤波/ILA/报警和最终整机验收仍待完成。

第一、二阶段已获用户接受。第三阶段已完成软件与仿真闭环，并取得基本实物通信证据。2026-10-30 用户同意把传感器偏差后续处理，以第三阶段基本通信成果作为基础，授权进入第四阶段；进一步确认暂按250Hz采样、保留5～30Hz、抑制50Hz及以上设计。

用户于 2026-10-29 开始中途板测，已提供 FixedSource 双路整包回传截图。2026-10-30 授权查看 SensorSource 的已有 50 ms 记录，12 组 I2C 六字节、D0 三轴与 D1 回传逐字节一致，通信闭环通过，见 `../report/sensor_source_validation_20261030.md`。但完全静止时合成值按预期 ±2g 配置换算约 1.34g，量值验收未通过；记录不含初始化回读，需先排查。不能把通信成功等同于全部传感器验收通过。

## 第四阶段当前状态

2026-10-31用户明确批准继续编写，并要求每阶段主要内容完成后自动仿真。四个新RTL和对应自检已完成；ModelSim/XSim均通过，单轴41728样本、三轴4000组、600正常串口包及错误/恢复覆盖；OOC内部时序通过。实际结果见 `../report/stage4_validation.md`，设计见 `stage4_design.md`，复现见 `stage4_test_guide.md`。

第四阶段软件验收已完成；用户随后批准第五阶段具体方案，窗口均方值、峰值、整数RMS与滞回报警也已实现并验收。继续保留原始十字节回传，滤波结果为18位内部接口；板级top、STM32和约束未改。

用户已授权每阶段主要代码完成后由助手自行执行相应自检及必要综合、报告结论，无需再次询问是否运行常规仿真。上板联调集中最终阶段；未实际执行不得声称通过。

## 保留的后续实物事项

- 正反静止对照支持较大Z零偏，详见 `../report/sensor_zdown_validation_20261030.md`；后续补初始化配置回读、六面静止和重复验证，不直接写入约5288的临时补偿。
- 边界停止位提示、较长记录、采样均匀性及回绕继续单独验收。当前数值频响以均匀250Hz为假设，不能用去直流替代校准或把仿真信号称作实测。
- 正式约束已有实现检查与通信证据，详见 `fpga_constraints.md`；ZPS7-1提示及未测电气事项继续保留。

保持第一版仅 PL，不引入 PS、AXI、Linux 或 PYNQ。保持十字节输入约定；需要变更时先获批准。Markdown 和说明性注释继续使用中文，厂商库与 PDF 授权未核实前不公开。

## 第五阶段当前状态与下一步

2026-10-31用户明确确认128样本、2000/1500演示阈值及两窗确认，授权四个RTL和双工具仿真。`isqrt_u36`、`window_features`、`threshold_alarm`、`feature_monitor_core`已完成；ModelSim/XSim四项自检及导出对照、八项非法参数拒绝均通过。完整内部核心隔离OOC检查通过，20ns时钟内部建立/保持裕量9.063ns/0.088ns。

第五阶段软件验收完成，见 `../report/stage5_validation.md`、`stage5_test_guide.md`。原始十字节通信和板级top未改，不会从D1直接看到RMS或报警。

用户已补充原分期截图：第六阶段是系统联调与量化，第七阶段是回归、修复与交付，已持久化在 `stage_plan.md`。第六阶段的原始/滤波选择采用获批的十字节尺度4规则；RMS/峰值/MS仍为内部接口，没有另加结果协议。

最终阶段统一进行板级集成、完整约束/时序和实物验收；MPU6050初始化回读、校准、均匀采样和真实阈值仍为待验证。

## 第六阶段结果与下一步

第六阶段方案已获明确批准。`return_source_select`、`system_monitor_core`、`system_top`及各自自检已完成；ModelSim/XSim通过，长序列两模式各5632包/40窗，所有导出匹配独立参考，拥塞/复位/错误恢复和默认参数通道通过。两种完整顶层独立实现通过，原始/滤波内部建立裕量5.205ns/8.300ns，保持裕量0.037ns/0.028ns。

只标记网络不能保证支路保留，实际修正为427位明确保留的调试快照负载；两模式均保留三轴FIR、三个开方器和报警，旧未连接发送器移除。源模式写入采集元数据，滤波线缆计数乘4恢复尺度。实际证据见 `../report/stage6_validation.md`。

软件与实现部分完成；实物按此前约定集中最终阶段，`../report/stage6_board_record.md`仍为未验证。下一步第七阶段按 `stage_plan.md` 运行全部自检、重跑失败案例、冻结版本、整理说明/波形/日志/AI记录，并对最终源码重新实现、检查时序/DRC及冷启动实物演示。不要把本阶段软件成果称为已经通过新增板测。

## 第七阶段结果与当前唯一待办

2026-10-31完成从全部阶段起的ModelSim/XSim回归、PC11项、可移植C与两个Keil重建；原始/滤波/debug三版重新实现并生成bit，debug有匹配ltx，Keil AXF另转为有效HEX。软件候选版v1.0-rc1，入口见 `stage7_delivery.md`、`../report/stage7_validation.md`。

需求核对见 `../report/requirements_audit.md`：已知软件要求满足，整体实物与传感器校准尚未验收，没有正式评分规则全文不能担保未知条款。当前下一步按 `board_test_plan.md` 从B01～B12逐项操作，填写 `../report/final_board_record.md`；不再自行开始新功能阶段。

没有执行本轮下载、采集或硬件操作。既有基本通信证据不替代新版整体板测；软件/数字内容、真实周期、量值校准和报警物理验证分别签收。若板测需修复，建立rc2并重跑受影响检查，不能修改rc1后沿用冻结哈希。

## 冻结后校准实验的当前待办

2026-10-31已分析四份新X/Y与两份旧Z，每份实际上只有50ms；独立实验校准工程及测试通过，详见 `../report/mpu6050_calibration_analysis_20261031.md`。软件检查通过不代表传感器标定通过，也未由代理执行烧录。

下一步优先使用原SensorSource补采同一配置六面各20秒及独立第二轮、初始化实际回读，重查xn/旧zp约3ms周期与横轴残差。实验SensorCalibratedTrial用于初步对照，其D0已校正，不能再次当原始值拟合。不要将此分支默认为正式rc2；通过实物验证后再决定参数和新冻结版。
