FFsteve/zynq_vibration_monitor/docs/stage_plan.md

# 分期计划与当前进度

本文件用于保存用户确认的分期边界，避免后续上下文压缩后重新猜测。2026-10-31用户补充了第六、七阶段原计划截图；以下两行按截图转录。原截图归档于 `../report/evidence/stage6_7_plan_20261031.png`。

| 阶段 | 原定日期 | 主要任务 | 仿真检查 | 验收目标 |
|---|---|---|---|---|
| 六：系统联调与量化 | 第6天 | 集成完整链路；增加原始/滤波数据选择；保存资源、时序和实测记录 | 250包/s长序列；丢包、坏包、超时后恢复；三轴隔离；处理延迟；输出堵塞；复位清除全部历史状态 | 仿真与板测均能重复演示；取得资源、时序及滤波效果数据 |
| 七：回归、修复与交付 | 第7天 | 修复问题、冻结版本，整理操作说明、波形、日志和AI开发记录 | 运行全部自检TB；重跑失败案例；最终源码重新综合、实现并检查时序与DRC | 从干净启动可重复运行，演示步骤与证据完整 |

第1～5阶段的详细设计和实际结果分别保存在相应 `stage1`～`stage5` 文档与报告中。第五阶段软件验收已经完成；本文件不根据记忆重造此前未保存的分期表。

用户此前选择把新增上板测试集中到最终阶段。因此第六阶段先完成完整链路的软件集成、自检、量化、隔离实现和可复现实测方案；**实测记录只有实际采集后才能填为通过**，整阶段的实物验收保留到最终联调。原计划中的“板测均能重复演示”不会因仿真通过而自动勾选。

第七阶段承担全部回归和最终版本检查；不把第六阶段重新解释成上位机开发阶段。需要新增结果协议或主要RTL时继续遵守AGENTS的方案评审要求。
