FFsteve/zynq_vibration_monitor/skill/pl-sensor-workflow/references/case_study.md

# 本案例的来源与效果

本技能取材于同一学生项目的两个连续聊天，而非只从最终 FIR 文件归纳：

- “分析 UART RX 设计与硬件约束”：后台历史接口读完 46 轮，包含初始只读设计、七阶段规划、中文注释规则、UART/包解析/标准库闭环、图纸适配、逻辑分析仪使用、FIR/特征/报警/系统集成与候选冻结。
- “确认新对话记忆范围”：读取至本次交付请求共 37 轮，包含交接、ILA 配置、六面校准与重复验证、真实滤波/窗口对照、缩减验收、三状态演练、蜂鸣器及竞赛交付。当前轮只导出读取时已有的正文，完成后的执行证据由交付报告和 Git 提交补充。

独立携带本技能时，这两聊天全文不必复制；此处说明证据来源，核心经验已写在可复用参考中。完整工程保留 report/ai_records/old_thread.md、new_thread.md 和 ai_devlog.md。

| 步骤 | 本案例效果 | 不可泛化的部分 |
|---|---|---|
| 图纸/约束 | 纠正 U13→U18；正式引脚和实现 CDC 校核 | 只适用当前板修订，不能复制到另一板 |
| UART 到 MCU 闭环 | 全字节及错误恢复自检；实物 I2C→D0→D1 一致 | XOR 不是强完整性校验，SEQ 不证明传感器没有漏采 |
| FIR/特征 | 独立整数/浮点与双工具 RTL 对照；最终整板时序/资源 | 标称250Hz频段与阈值不是通用健康诊断标准 |
| 校准 | r1 拟合、独立 r2/r2b；实际 Q16 校准输出吻合 | 当前三轴 b/k 只适用本模块；去直流不替代校准 |
| 实测滤波 | 4914 完整回包与独立参考精确匹配；末包边界单列 | 不是受控机械频率响应试验 |
| ILA | 同次三窗九项特征和 SEQ 精确匹配 | 窗号需对齐，旧截图不能与新数据任意拼接 |
| 比赛演练 | 静止→X轴报警→有效恢复，核心演示通过 | 无需由此声称工业长期可靠性或所有解除边沿实测 |
| 蜂鸣器 | 独立模块/顶层、双工具对照、新整板构建；2026-11-02用户确认声音正常 | 未新增声学记录；有源/无源和电气极性须重新核图 |
| 本次交付 | 自有代码MIT、源码/依赖/bit/ltx/HEX身份与真实正文归档 | 设计报告后续完成；厂商代码不变为MIT |

技能迁移效果本次以可配置 CSV 脚本的不同列名案例及错误/空数据/恢复自检为证；整个工作流未在另一块板或独立代理上验证，不把结构校验说成行为验证。
