FFsteve/zynq_vibration_monitor/report/stage6_quantification.csv

axis | frequency_hz | gain_db | wire_restored_gain_db
X | 10 | 0.08319879609594083 | 0.0833488203286592
Y | 30 | 0.15324849195424006 | 0.1528363028581218
Z | 60 | -61.65053816962552 | -61.78334179801678
