FFsteve/zynq_vibration_monitor/report/noreset_zpair_60s_20261101.md

# 无复位Z正反面与60秒记录分析

## 同日补导出I2C后的最新复核

用户已重新导出 `noreset_zn/init_i2c_noreset_zn.csv`，本轮确认其为真正I2C数据，与D0不再相同。实际解析14991笔完整事务，其中3A轮询9981笔、3B六字节读取5010笔，ACK模式全部正确。5009个完整D0包全部找到对应I2C载荷，并与5009个完整D1回包一致；没有内部配对失败。最后一次I2C读取结束于19.9999105秒，随后的D0只在采集尾部捕获到包头A5，不将该额外读取计作已证实丢包。

与此前保存的指纹比较，四份输入中只有用户重导出的I2C CSV改变，原波形及D0/D1保持不变；本轮分析前后新文件SHA256一致。新I2C SHA256为 `219fefb8422d85a041c9db5d136d8fc203442b9237e4b96274bae74c39586dc8`。输出另存于 `report/evidence/20261101_noreset_analysis/zn_i2c_recheck/`，没有覆盖首次误导出分析。

实际执行运行时Python标准输入脚本，导入 `analyze_noreset_20261101`，将OUT指定到上述新目录，调用 `analyze('noreset_zn', SOURCES['noreset_zn'])`，再断言有效I2C、无ACK/内部配对问题、5009组回传一致及仅I2C输入变化。实际退出0，标记 `PASS zn_i2c_recheck`。没有重新采集、修改固件/RTL/约束或硬件操作。

**此前的“Z朝下I2C未验证/待补导出”现已解决。** 下文保留首次分析时的文件问题作为历史记录；数值、两点初值、39次约3ms间隔与正式校准未通过的结论不变。

日期：2026-11-01。用户说明 `60s` 为Z朝上60秒、`noreset_zp` 为Z朝上20秒、`noreset_zn` 为Z朝下20秒，均位于 `report/evidence/20261101_session01/`。用户进一步确认60秒期间全程固定静止、未主动触碰。结论：三份记录时长符合设置、没有复位长间断，完整UART包连续；60秒记录的三路内容对照通过，但Z朝下I2C文件误导出。大Z偏置、约每半秒一次的3ms发包间隔和60秒内的瞬态波动仍需处理，不能宣称正式校准或严格均匀采样通过。

## 实际执行与原始证据

```powershell
& 'C:\Users\QQ165\.cache\codex-runtimes\codex-primary-runtime\dependencies\python\python.exe' -X utf8 report/evidence/analyze_noreset_20261101.py
```

本轮复用上一份记录的逐字节/起止位/位值核查和独立包解码，对I2C解析函数仅增加可选文件名参数，原默认行为不变。新增分析按时间和完整内容配对，不单独用重复回绕的SEQ识别记录。实际运行退出0，结果与原文件SHA256复核通过。

三个原波形ZIP CRC均通过；12份输入文件的分析前后SHA256一致。设置均为20MS/s、Buffer、RLE开启、1.5V门限、D0～D3四路；时长分别为60000/20000/20000ms。导出首末存在截断，完整包首末跨度略短于设置时长，这是正常的有限捕获区间，不能据此要求每个20秒波形再重采。与前份中途复位记录的18.62秒连续段不同，本次没有重启间断。

输出目录为 `report/evidence/20261101_noreset_analysis/`：每份有完整JSON和逐样本CSV，另有 `z_pair_fit.json`。本轮没有重新采集、操作硬件、改固件/RTL/约束或冻结包，也没有运行仿真、Vivado或Keil。

## 文件导出问题

`noreset_zn/init_i2c_noreset_zn.csv` 与同目录D0 UART CSV字节数和SHA256完全相同，内容为 `TX data/TX bits`，不是I2C。其SHA256均为：

```text
84f2f21a6c473ee3c51ea66c58c2ef2fcf4dc924f28402b99b84416ee6fac0f7
```

所以Z朝下可以验证D0→D1和UART数值，但不能据该文件验证I2C→D0。原atkdl保存了四通道，应重新打开后选择I2C解码器导出到新文件，例如 `i2c_noreset_zn_corrected.csv`，保留误导出文件以保持本次指纹证据，无需因此重新采集整份Z朝下。

## 内容与连续性

| 记录 | D0完整包 | D1完整包 | D0→D1可比包 | I2C六字节→D0 | 完整包区间SEQ缺口 |
| --- | --- | --- | --- | --- | --- |
| 60s | 15030 | 15030 | 15030，全部相同 | 15030，全部相同 | 0 |
| noreset_zp | 5010 | 5010 | 5009，全部相同 | 5010，全部相同 | 0 |
| noreset_zn | 5009 | 5010 | 5009，全部相同 | 无有效I2C CSV，未验证 | 0 |

60秒44971笔完整I2C事务（29941笔3A轮询、15030笔3B读取）的ACK模式均正确；Z朝上20秒14990笔完整事务（9980笔3A、5010笔3B）均正确。三个连续完整包区间无重复、候选XOR错误或内部UART警告，分别有59/20/20次正常SEQ回绕。回传包起点延迟均约863～864微秒。

Z朝上20秒在110.95微秒有一次停止位错误及一条缺少停止位的字节注释，均位于首个完整包之前；不能称整份导出零警告，也不把它计作内部正常包失败。首个完整D0包从3.3054ms开始。初始D1有上一包的完整回传，但对应D0在左边界不完整；末尾最后一个D0包对应的D1只捕获到开头，均单列边界而非自动宣布额外回包或丢包。Z朝下同样有左边界额外一份完整D1及首尾不完整D0片段。详细原始字节和时间保留在JSON中。

这些数据支持本次原始包回传，不能证明当前ILA、FIR/RMS/报警已完成板测；没有新增身份/配置初始化事务或本次bit/固件哈希证据。采用前次同会话已验证的配置解释量值，不能声称三次均重新捕获初始化。

## 静态数值与稳定性

以下均保留全部完整包，没有删除瞬态样本：

| 记录 | X均值 | Y均值 | Z均值 | XYZ样本标准差 | 原始合成幅值均值，按16384计数/g |
| --- | --- | --- | --- | --- | --- |
| 60s，Z朝上 | 570.823 | −754.959 | 21976.973 | 103.080 / 137.003 / 271.606 | 1.342650g |
| 20s，Z朝上 | 565.566 | −757.479 | 21969.437 | 88.818 / 44.016 / 54.531 | 1.342162g |
| 20s，Z朝下 | 62.313 | −1370.149 | −11534.181 | 90.193 / 43.167 / 45.016 | 0.708977g |

未见原始XYZ到达signed16端点，但未饱和不代表量值正确。Z正反明显不对称，继续支持较大加性偏置；两个Z朝上记录的Z均值仅差约7.54计数，约0.00046g，平均值有一致性，但60秒内的瞬态和噪声需另行评估。

20秒Z朝上前后半段均值差约−0.60/−1.93/+1.89计数；Z朝下约+0.42/−6.26/−0.34计数。60秒为−4.42/−4.07/−4.23计数。较小的均值差不能掩盖中间的大幅短时波动，也不代表温漂或跨重启稳定性已验证。

## 新Z轴两点初值

只取两个无复位20秒姿态的Z均值：

```text
bz = (21969.436727 - 11534.181274) / 2
   = 5217.627726 计数
Sz = (21969.436727 + 11534.181274) / 2
   = 16751.809000 计数/g
kz = 16384 / Sz = 0.978043625
corrected_z = round((raw_z - bz) * kz)
```

正反记录回代为正负1g是拟合本身的结果，不是独立验收。相较旧短记录初值，bz低约70.79计数，Sz高约0.525%；这些差异可能包含姿态、条件和统计长度影响，不能直接解释为真实偏置漂移或灵敏度变化。

使用这对新参数离线处理另一份60秒Z朝上，Z均值约1.000450g、标准差约0.016214g。这提供额外正面记录的参考，但没有验证独立反面、完整六面、三轴合成精度或跨重启条件；用户也未提供两轮受控姿态验证，因此 `formal_calibration_pass=false`。

本轮没有将初值写入STM32，也不以这两个新Z姿态直接替换旧实验参数头并沿用原验证结论。X/Y仍需同批正式采集与独立第二轮。

## 60秒固定静止记录的瞬态问题

用户已明确全程固定静止、未主动触碰，不能擅自把下列波动归因为用户操作。60秒Z最小13704、最大30258计数；相比Z朝上20秒，标准差由约54.5增至271.6计数。三路逐样本相同，说明异常数值已出现在读取的传感器寄存器数据中，没有证据归因于FPGA回传改值或UART比特误码。

为定位而非删样，显式使用 `abs(Z - 全段中位数21976)>500计数`，相邻异常间隔不超过0.1秒归为一组。这只是分析阈值，不是器件指标；共226个样本、12组，全部样本仍参与上表统计。较突出的组为：

| 时间范围，秒 | 超阈样本数 | 这些样本的Z最小～最大 |
| --- | --- | --- |
| 6.308～6.923 | 75 | 16806～26886 |
| 13.382～13.690 | 40 | 13704～30016 |
| 34.360～34.624 | 52 | 14566～30258 |
| 46.728～46.899 | 26 | 19944～23884 |

5秒分段中，20～25秒、40～45秒、55～60秒的Z标准差分别约43.1、42.1、42.0计数，而30～35秒约605.4计数，说明不能用全段标准差代表稳定背景噪声，也不能只选安静片段宣称整段正常。

根因未验证。外界振动/安装耦合、模块供电/硬件状态、读取过程等应结合同一时刻证据继续排查，不仅凭未主动触碰排除全部外部因素，也不直接判定模块损坏。

## 采样发送时序

| 记录 | 完整包首末跨度 | 平均间隔 | 最小～最大间隔 | 超出3.9～4.1ms的间隔 | 跨度估计发包率 |
| --- | --- | --- | --- | --- | --- |
| 60s | 59.995223s | 3.991964ms | 2.994～4.002ms | 120 | 250.503包/秒 |
| 20s Z朝上 | 19.995743s | 3.991963ms | 2.994～4.002ms | 40 | 250.503包/秒 |
| 20s Z朝下 | 19.992749s | 3.992162ms | 2.99475～4.002ms | 39 | 250.491包/秒 |

三个区间均没有大于12ms的包间断。短间隔均约3ms；60秒的120次短间隔之间，间距均值0.502187秒，范围0.498986～0.502997秒。由此确认此前模式可持续重复，不能归因于此前一次复位或50ms短记录偶然性。

60秒平均发包率比名义250包/秒高约0.201%。1ms轮询量化与传感器/STM32相对时基滑移仍是相容解释，不是已定位结论。当前统计是线上包起点，不直接测得MPU内部每次采样时刻；严格均匀250Hz仍未签收。不能为了让统计好看而删除120个短间隔或修改时间标签。

## 下一步

1. 从已保存Z朝下atkdl重新导出正确I2C CSV，保留本次误导出文件；不必为此重采Z朝下。
2. 新Z正反20秒已达到正式采集时长，可用于第一轮两点初值；补同条件X/Y四面与独立第二轮六面，保留固件/模式、预热和摆放记录。正反面回代正负1g不算独立通过。
3. 在固定支撑、固定环境下复核60秒的瞬态，记录是否与桌面/线缆/其他设备事件相关；若仍出现，结合已有原始波形进一步检查传感器读取和硬件状态。不在根因不明时自动写入正式标定或宣布静态精度通过。
4. 60秒统计证据已经取得，无需重复同样记录只为满足时长。下一步应针对120次短间隔分析DATA_RDY轮询的相位关系；涉及调度或采集改动时先给出小范围方案，重跑受影响软件和实物检查，不直接改FIR系数或分频掩盖问题。
5. 完整滤波、ILA特征与报警、异常恢复和冷启动验收仍独立进行；本轮不替这些项目签收。
