FFsteve/zynq_vibration_monitor/report/session01_initialization_zup_20261101.md

# 20秒初始化与Z朝上记录分析

日期：2026-11-01。用户确认使用原SensorSource，MPU6050固定静止、Z正方向朝上，中间复位一次。结论：本次实际记录达到20秒，身份和关键配置回读正确，4931个完整包的I2C→D0→D1内容对照全部一致；静止量值偏大和约3ms发包间隔仍存在，正式校准与严格均匀采样尚未验收。

## 原始文件和方法

原文件为 `report/evidence/20261101_session01/` 下的 `init_raw.atkdl`、`init_i2c.csv`、`init_d0_uart.csv`、`init_d1_uart.csv`。本轮只读，分析前后SHA256一致，指纹收入独立分析JSON，未覆盖或重命名原记录。

实际执行：

```powershell
& 'C:\Users\QQ165\.cache\codex-runtimes\codex-primary-runtime\dependencies\python\python.exe' -X utf8 report/evidence/analyze_session_20261101.py
```

输出为 `report/evidence/20261101_session01_analysis/analysis.json` 和 `frames.csv`。脚本线性读取GB18030协议CSV，逐字节核对8位数据、起止位标记和位值；十字节解码与独立StreamDecoder交叉核对。I2C逐笔对照地址/寄存器/数据及ACK序列；原始与回传按时间和完整包内容匹配，不只按可能重复回绕的SEQ配对。

首次检查曾因将秒级CSV标签的舍入误差容限设为0.25微秒而失败；修正为1.1微秒后通过。该容限只检查导出标记的一致性，不更改原时间，不把3ms间隔放宽为合格，也不视为原始波形分辨率。可选绘图尝试因运行时没有matplotlib未完成，最终脚本已移除该依赖，不提供未生成的图。

本轮没有运行RTL仿真、Vivado或Keil，没有烧录、复位、重新采集或修改功能源码。文件中已有的复位由用户在此前采集时执行。本轮也未取得bit/固件实物哈希或ILA记录。

## 实际记录与复位分段

波形ZIP CRC通过。配置为20MS/s、20000ms、Buffer、RLE开启，D0～D3四路、1.5V门限；CSV最后的部分数据位到达20秒，确认不是此前50ms短记录。

| 分段 | 完整包数 | 首包起点 | 末包起点 | 首末包起点跨度 | SEQ |
| --- | --- | --- | --- | --- | --- |
| 复位前 | 264 | 0.00110285s | 1.051089s | 1.04998615s | D4开始，DB结束，跨一次FF→00 |
| 复位后 | 4667 | 1.371868s | 19.995629s | 18.623761s | 00开始，3A结束，跨18次FF→00 |

两段最后/最先包的起点相差320.779ms，这是包起点间断，不等于复位按钮按住时间。该间断与用户复位、重新初始化和SEQ从0开始相符，单独保留，不纳入稳态周期统计，也不按模256推断复位期间丢包数。

末尾还有一次I2C六字节读取，但D0仅完整导出下一包的 `A5 5A 3B 02`，随后字节在20秒边界截断；因此4932次完整加速度读取对应4931个完整UART包和末尾一个不完整包。该部分保留，不算已证明的链路丢包。记录最左端另有一笔从事务中途开始的 `0x68 RD: 01`，不冒充完整初始化事务。

## 初始化已获得实物证据

| 时间，秒 | 实际事务 | 判定 |
| --- | --- | --- |
| 1.166636 | 读75→68 | 身份匹配 |
| 1.167034 | 写6B=80 | 软件复位操作 |
| 1.266612 | 写6B=01 | 唤醒/时钟配置，与源码一致 |
| 1.366611～1.367489 | 写1A=02、19=03、1C=00、38=01 | 配置与源码一致 |
| 1.367781 | 读6B→01 | 通过 |
| 1.368180 | 读1A→02 | 通过 |
| 1.368580 | 读19→03 | 通过 |
| 1.368978 | 读1C→00 | 通过 |
| 1.369377 | 读38→01 | 通过 |

以上完整事务的ACK模式均正确。当前记录支持实际加速度量程为±2g、16384计数/g、自检位关闭，不能再把本次静止偏大的量值仅解释为“还没看过实际量程配置”。这不追溯证明此前六份短记录配置全部相同，也不证明芯片型号真伪或全部模拟性能正常。

## 通信对照

- 解析14763笔完整可识别I2C事务，地址/数据ACK模式全部符合预期；包括3A轮询9819次、3B读取4932次和12笔身份/配置事务。
- D0、D1各4931个完整合法十字节包；逐包内容匹配，所有D0三轴载荷都与其前一笔对应I2C六字节相同。
- 两段各自SEQ连续，无重复、内部缺口或候选XOR错误；D0/D1完整字节的位值和起止位标记一致，未出现UART警告注释。
- D1包起点相对D0同包起点平均延后863.860微秒，约863～864微秒。该现象符合本次记录的整包原始回传，不能据此判定FIR/RMS/报警板测通过。
- 尚未提供本次bit/ltx和固件哈希，以上为本份采集的内容验收，不自动填为所有新版本的完整板测。

## Z朝上静止量值

复位后4667个样本的XYZ均值为675.783、−652.873、21979.717计数。为减少按复位及初始化后暂态的影响，再显式排除复位后首秒，保留4415个样本，时间2.374850～19.995629秒，统计如下。原始样本和完整分段统计仍全部保留，不据稳态筛选隐藏异常。

| 轴 | 均值，计数 | 样本标准差，计数 | 最小～最大，计数 | 均值/16384，g |
| --- | --- | --- | --- | --- |
| X | 675.672 | 89.303 | 428～892 | 约+0.04124 |
| Y | −653.086 | 43.419 | −830～−462 | 约−0.03986 |
| Z | 21979.931 | 44.414 | 21602～22204 | 约+1.34155 |

逐样本合成幅值的均值为1.3427877g。稳态前后半段均值差约+1.209/+0.045/−0.628计数，未见这17.62秒内明显的均值漂移；这不等于已经验证温漂、跨重启或长时间稳定性。未见signed16端点饱和。

旧Z朝上短记录均值约21952.67，本次仍约21980，表明偏大现象在较长记录中持续存在。已验证数据从I2C到回传未改变，因此没有证据将其归因于FPGA补码/字节序或UART传输改变。当前数据支持继续调查传感器量值与校准，但仅一个姿态不能独立确定零偏、灵敏度、倾斜与交叉轴误差，也不能判定器件损坏。

不能将本次Z均值减16384所得约5596计数直接当作通用Z零偏；必须与同条件的新Z朝下记录配对，再完成六面与独立第二轮验证。旧实验系数不因本次记录而自动升级为正式参数。

## 包周期仍需处理

| 区间 | 包间隔均值 | 最小～最大 | 超出3.9～4.1ms的间隔 | 跨度估计发包率 |
| --- | --- | --- | --- | --- |
| 复位前 | 3.992343ms | 2.99475～4.002ms | 2个 | 250.479包/秒 |
| 复位后全部 | 3.991376ms | 2.994～4.002ms | 40个 | 250.540包/秒 |
| 复位后去掉首秒 | 3.992021ms | 2.994～4.002ms | 35个 | 250.500包/秒 |

复位后最初三个间隔约2.995/3.003/3.004ms，属重新启动附近现象，已单列。之后短间隔大致每0.499～0.503秒出现一次，表现为可重复的周期模式，并非仅一次随机异常。两路完整包内容和SEQ仍连续，不能据短间隔直接认定串口丢包。

源码 `bsp_time.c` 使用1ms SysTick，`acquisition_poll` 同一毫秒仅轮询一次，SensorSource由DATA_RDY决定是否读取与发送。记录现象与传感器更新节拍相对STM32毫秒轮询的相位滑移/量化相容，约250.5与名义250的差异也值得测量；这是待验证机制，尚不能区分传感器更新、STM32时基、轮询延迟和仪器时基等来源。

UART包起点代表读取/发送事件，不是MPU内部采样时刻。本次不能直接宣称传感器内部发生了相同的3ms采样抖动，也不能宣称严格均匀250Hz已经通过。后续先补60秒记录并结合DATA_RDY轮询时序分析，必要时评审小范围调度改动，不直接改FIR系数或传感器分频来掩盖问题。

## 下一步

1. 这份记录保留为初始化、原始链路和周期排查证据，不覆盖旧文件，也不将复位前后拼接当作20秒连续正式Z正面样本。
2. 保持当前原SensorSource和raw回传，预热约3～5分钟，不在正式姿态记录中复位。Z朝上重新采至少20秒连续静止数据，随后采同条件Z朝下；再补其余四面及独立第二轮，分别保存原波形与D0协议CSV。
3. 当前新记录的实际复位后完整包跨度只有18.62秒，排除首秒后约17.62秒；因此仍需新的连续20秒正式姿态记录。
4. 另采至少60秒D0/D1稳态数据，保存I2C时序更有助于定位1ms轮询与DATA_RDY的相位关系。周期问题和静态校准分开验收，未定位前不把全部算法板测标为通过。
5. 本次初始化缺口已针对这份采集补齐。正式六面校准、完整滤波/ILA/报警和整机冷启动仍待完成，`formal_calibration_pass=false`。
