FFsteve/zynq_vibration_monitor/report/sixface_r1_analysis_20261101.md

# 第一轮六面20秒记录分析

日期：2026-11-01。用户补齐 `noreset_xp/xn/yp/yn`，确认与此前Z正反面为同一模块、同一原SensorSource固件和配置，均摆稳后静止采集。本轮重新分析六面，不混用此前50ms记录，采用补导出后的正确Z朝下I2C文件。

**结论：第一轮六面长记录已齐，完整包的可比通信内容通过。离线三轴两点模型的同批回代残差改善，但仍无独立第二轮，静止瞬态和发送周期问题未解决，正式校准未通过。本轮不改固件参数或烧录。**

## 实际执行与证据

```powershell
& 'C:\Users\QQ165\.cache\codex-runtimes\codex-primary-runtime\dependencies\python\python.exe' -X utf8 report/evidence/analyze_sixface_20261101.py > build/sixface_analysis_20261101.log
```

实际退出0，标记 `PASS sixface_analysis originals_unchanged formal_calibration_pass=false`。另外实际执行结果核对脚本，逐姿态断言单段、SEQ连续、有效I2C/ACK、无内部配对失败、无内部UART警告，并重新核对24份输入SHA256，全部通过。

原始文件位于 `report/evidence/20261101_session01/noreset_*/`，没有重命名、改写或删除。六个原波形ZIP CRC通过，24份原文件分析前后SHA256一致。输出位于 `report/evidence/20261101_sixface_r1_analysis/`，包含六份完整JSON、原始帧CSV、离线校正CSV与 `sixface_fit.json`；校正CSV保留全部完整包，不剔除瞬态样本。

分析器复用既有逐字节位值、起止位核验、独立协议解码、I2C事务及ACK核验，并按时间和内容匹配I2C/D0/D1。均值及参数另以精确有理数计算，再与浮点校正均值交叉核对。没有将离线数学核查称作C实现、RTL仿真或板上校正通过。

## 时长与通信完整性

六份设置均为20MS/s、20000ms、Buffer、RLE、1.5V门限、四通道。完整包首末跨度约19.993～19.997秒，没有复位或超过12ms的断流。首末包略短于波形时长是有限记录边界，不因此要求重采整份数据。

| 姿态 | D0完整包 | D1完整包 | 可比I2C→D0 | 可比D0→D1 | 区间SEQ缺口 |
| --- | --- | --- | --- | --- | --- |
| xp | 5010 | 5010 | 5009 | 5010 | 0 |
| xn | 5010 | 5009 | 5010 | 5009 | 0 |
| yp | 5010 | 5010 | 5010 | 5010 | 0 |
| yn | 5010 | 5010 | 5010 | 5010 | 0 |
| zp | 5010 | 5010 | 5010 | 5009 | 0 |
| zn | 5009 | 5010 | 5009 | 5009 | 0 |

总计30059个完整D0包；表中所有可比项内容均相同，六份完整包区间无重复、候选XOR错误或内部配对失败。新四面各约14990～14991笔完整I2C事务，ACK模式正确。

边界不同步单列：xp首个D0包的I2C读取发生在可比左边界之外；xn最后一包D1只捕获到包头A5；yp最左端有从I2C事务中途开始的RD:01。此前zp起点110.95微秒停止位警告、首尾片段，以及zn首尾不完整包继续保留，不改写为整份零警告；这些都不位于完整可比包区间。详见逐姿态JSON。

这证明本次原始数据链路，没有新增ILA/FIR/RMS/报警板测结论；本轮也未取得新的bit/固件下载哈希或各姿态初始化记录。

## 六面原始数值

| 姿态 | X均值 | Y均值 | Z均值 | XYZ样本标准差，计数 |
| --- | --- | --- | --- | --- |
| xp | 17035.935 | −466.772 | 5970.052 | 93.491 / 52.814 / 63.943 |
| xn | −15580.628 | −1009.294 | 5531.123 | 90.420 / 46.710 / 60.753 |
| yp | 137.576 | 15921.523 | 5352.642 | 90.614 / 49.148 / 57.039 |
| yn | 953.836 | −17025.535 | 5396.094 | 90.435 / 87.194 / 97.498 |
| zp | 565.566 | −757.479 | 21969.437 | 88.818 / 44.016 / 54.531 |
| zn | 62.313 | −1370.149 | −11534.181 | 90.193 / 43.167 / 45.016 |

均未达到signed16端点，主轴正负方向与命名相符。Z在X/Y姿态中仍保持约5350～5970的静态基线，与Z正反中点较大偏置的现象一致，但横轴均值还包含实际姿态分量，不能把每一面的全部横轴均值直接当零偏。

## 第一轮三轴初值

每轴仅用本轴正反面主轴均值，计算 `b=(mu_plus+mu_minus)/2`、`S=(mu_plus-mu_minus)/2`、`k=16384/S`。

| 轴 | 零偏b，计数 | 灵敏度S，计数/g | 比例系数k |
| --- | --- | --- | --- |
| X | +727.653493 | 16308.281038 | 1.004642976 |
| Y | −552.006188 | 16473.528743 | 0.994565297 |
| Z | +5217.627726 | 16751.809000 | 0.978043625 |

离线g值为 `(raw-b)/S`；若后续采用16384计数/g的整数输出，则为 `round((raw-b)*k)`，届时仍需明确足够宽的中间量、舍入和signed16饱和，并测试C实现。本轮只输出JSON中的浮点/精确有理数初值，没有生成新固件参数头。

## 同批数据回代检查

| 姿态 | 校正后X/Y/Z均值，g | 逐样本合成幅值均值，g | 非主轴均值最大绝对值，g |
| --- | --- | --- | --- |
| xp | +1.00000 / +0.00517 / +0.04492 | 1.001034 | 0.044916 |
| xn | −1.00000 / −0.02776 / +0.01871 | 1.000571 | 0.027759 |
| yp | −0.03618 / +1.00000 / +0.00806 | 1.000708 | 0.036183 |
| yn | +0.01387 / −1.00000 / +0.01065 | 1.000185 | 0.013869 |
| zp | −0.00994 / −0.01247 / +1.00000 | 1.000146 | 0.012473 |
| zn | −0.04080 / −0.04966 / −1.00000 | 1.002082 | 0.049664 |

在这批拟合数据中，非主轴均值均处于建议的±0.05g以内，合成幅值均值处于0.97～1.03g以内；其中zn的Y约−0.049664g，接近建议边界，第二轮应特别注意固定支撑和摆放精度。旧短记录曾有约0.137g横轴残差，新数据的同批最大残差较小，但数据条件和参数均改变，不能把前后差异全部归因为算法改进。

**主轴恰为正负1g是两点拟合的直接结果，不是独立精度证明。** 同批均值通过建议目标不等于正式校准通过，也不说明每个样本均在该范围内。仍缺独立第二轮的固定参数验证、重复摆放与必要的跨重启验证。模型只补每轴偏置和比例，不自动拟合轴间矩阵或温漂。

## 瞬态与漂移观察

以主轴相对该面中位数偏离超过500计数定位瞬态（只用于定位，不是验收规格，不删样）：

- xp在约1.605～1.637秒有5个超阈主轴样本，X为16242～17698计数；Z全段范围4940～7300。
- yn在约5.914～6.073秒有26个超阈主轴样本，Y为−18382～−15726；Z全段范围3690～7084。
- xn和yp主轴在此定位规则下没有超阈样本，不能据此声称所有轴或所有形式异常均已排除。
- 此前zp在约0.94和1.25秒也有主轴短时波动，zn主轴没有超过该定位阈值的样本。

用户确认摆稳后静止，不能自动将这些波动归为主动触碰；三路内容一致，来源仍需在传感器读数、机械/环境及读取流程等层面定位。此前60秒记录的较大瞬态仍为未解决事项，不因六面均值回代良好而撤销。

xn的Y/Z前后半段均值差约−26.73/−70.89计数，分别约−0.00162/−0.00423g量级（按本轮灵敏度）。该变化不足以单独确定温漂或倾斜，但应在第二轮和时间分段中复核。其他新记录主轴前后半段均值变化约0.4～2.8计数。

## 周期问题仍然重复

新xp/xn/yp/yn四份各有39个约3ms间隔，平均发包率均约250.491包/秒；zp40个、zn39个。全部完整包区间SEQ连续，没有超过12ms的断流。

这进一步支持约半秒一次的短间隔为可重复时序模式。与此前60秒120次结果一致；1ms轮询与传感器相对节拍滑移仍仅为待验证解释。静态两点校准不修复这个时间问题，不能将比例补偿通过称为均匀250Hz采样通过。

## 下一步与固件边界

1. 第一轮六面采集和内容分析已经完成，不再列为缺少X/Y或Z朝下I2C；保留这套参数，接下来以不改原SensorSource的方式重新摆放，采第二轮六面，每面20秒，另建r2目录避免覆盖。
2. 用本轮固定参数离线处理第二轮，检查主轴、非主轴、合成幅值、波动和时间稳定性；不要为让第二轮通过而反复重拟合第一轮系数。特别检查zn的Y残差、xp/yn瞬态及xn横轴缓慢变化。
3. 针对静止瞬态和周期性短间隔继续定位，不能只增加采集时长而不核对来源；现有60秒证据已取得。
4. 当前 `stm32/app/accel_calibration_params.h` 仍是 `trial_20261031_short_capture` 的旧短记录参数，已有SensorCalibratedTrial固件也不能冒充本轮参数版。用户本轮只要求分析，未改参数、重建或烧录；后续若采用新参数，应明确方案、生成新版本并重跑数值/恢复/编译与实物验证，不覆盖rc1。
5. `formal_calibration_pass=false`；完整FIR/ILA/报警、恢复和冷启动验收仍独立完成。
