FFsteve/zynq_vibration_monitor/report/sixface_static_pass_20261101.md

# 六面固定参数离线静态指标通过记录

日期：2026-11-01。用户补采 `yp_r2b`，文件位于原 `yp_r2` 目录。本轮用第一轮固定参数处理新Y正面，并重新核对其余选定姿态，未修改参数以迎合复测。

**结论：六份独立选定记录均满足此前约定的离线静态均值指标，三轴偏置/比例重复性也满足建议范围。静态数据阶段可以结束，进入新参数固件实现与板上验证，不需要继续为满足均值反复采六面。该结论不代表新固件已烧录，或周期/瞬态及完整算法板测已通过。**

## 实际命令与结果

```powershell
& 'C:\Users\QQ165\.cache\codex-runtimes\codex-primary-runtime\dependencies\python\python.exe' -X utf8 report/evidence/analyze_sixface_r2b_complete_20261101.py > build/sixface_r2b_complete_analysis_20261101.log
```

本轮实际完成六面解析，退出0，原始与第一轮参数指纹通过。随后新增结果范围标记函数并对已有结果实际执行 `finalize_summary()`，写入 `OFFLINE_STATIC_PROJECT_CRITERIA_PASS`；另对40份当前目录文件、第一轮参数及全部条件做断言核查，标记 `PASS all_six_static_criteria_and_integrity`。最终脚本入口已包含标记步骤，后续按上面命令可完整复现。

独立输出位于 `report/evidence/20261101_sixface_r2b_complete_analysis/`，没有覆盖前次yp未通过结果、原第二轮重复保存报告或第一轮参数。结果JSON明确：`offline_static_validation_pass=true`，`firmware_with_fixed_r1_parameters_tested_on_board=false`。原脚本保留的总体 `formal_calibration_pass=false` 用于尚未完成固件落地/板上闭环的边界，不应解释为本次离线静态数据未通过。

## 实际来源与完整性

本轮使用xp_r2目录的xp_r2b、xn_r2目录的xn_r2b、yp_r2目录的新yp_r2b、原yn_r2、原zp_r2和zn_r2目录的zn_r2b。六份波形均20秒、20MS/s，CRC通过；共选定24份输入。目录内同时保留前次数据，分析前后哈希核对覆盖40份当前文件。此前被用户删除的重复yp原文件不计入当前完整性核查，历史指纹与分析仍保留。

总计30059个完整D0包，六份无重复采集、无内部SEQ/XOR/配对问题，可比三路均相同。新yp有5010完整D0包、5010次对应I2C六字节读取，5009个完整可比D1回包；最后一包回传被20秒右边界截断，单列为边界。14990笔完整I2C事务ACK正确，未见UART警告或位值/起止位不一致。

固定参数仍为第一轮b约727.653493/−552.006188/5217.627726，S约16308.281038/16473.528743/16751.809000，k约1.004642976/0.994565297/0.978043625。参数文件SHA256在运算前后相同。

## 新Y朝上结果

新yp_r2b原始XYZ均值为302.508982/15922.378044/5678.174052计数，标准差约90.200/46.237/47.947计数。固定参数校正后：

| 项目 | 本次结果 | 建议目标 |
| --- | --- | --- |
| X均值 | −0.026069g | 非主轴绝对值≤0.05g |
| Y均值 | +1.000052g | 距离+1g≤0.05g |
| Z均值 | +0.027492g | 非主轴绝对值≤0.05g |
| 逐样本合成幅值均值 | 1.000789g | 0.97～1.03g |

原真实yp_r2的Z均值残差约+0.091213g，本次降至+0.027492g，未改变参数。该变化支持姿态/采集条件会影响横轴结果，不等于已唯一证明之前的偏差由倾斜导致。

## 最终选定六面的固定参数结果

| 姿态来源 | X均值，g | Y均值，g | Z均值，g | 合成幅值均值，g | 均值指标 |
| --- | --- | --- | --- | --- | --- |
| xp_r2b | +1.000506 | +0.001563 | +0.005068 | 1.000527 | 满足 |
| xn_r2b | −0.999411 | +0.042283 | −0.039523 | 1.001092 | 满足 |
| yp_r2b | −0.026069 | +1.000052 | +0.027492 | 1.000789 | 满足 |
| yn_r2 | +0.011754 | −0.999515 | −0.031599 | 1.000102 | 满足 |
| zp_r2 | −0.004790 | +0.001714 | +1.000699 | 1.000730 | 满足 |
| zn_r2b | −0.028136 | −0.006725 | −0.998649 | 0.999087 | 满足 |

六份主轴均值误差最大约0.001351g；非主轴均值绝对值最大约0.042283g；合成均值范围0.999087～1.001092g。指标一直沿用原建议，没有临时放宽。该结果是独立于第一轮拟合数据的选定第二轮与针对性复测记录，不冒充一次全新同时完成的六面采集，也保留先前未满足的姿态结果。

## 重复性与验收范围

仅用于诊断、未用于替换验证参数的两点比较：

| 轴 | 第二轮与第一轮零偏差 | 灵敏度相对差 |
| --- | --- | --- |
| X | +8.932034计数 | −0.00417% |
| Y | +4.422954计数 | −0.02166% |
| Z | +17.172872计数 | −0.03263% |

均在约164计数与1%的原建议范围内。通过范围是每姿态静态均值、合成均值及上述参数重复性，不是器件规格认证、跨温度精度保证或每个单样本的误差保证。

新yp在约1.97004～1.978034秒有两个主轴样本相对中位数偏离超过500计数，样本均保留。合成幅值单样本范围约0.9672～1.0413g，不能说每个样本均在0.97～1.03g；原定目标针对均值。之前60秒的明显瞬态仍独立待查，不因本次均值通过而消失。

新yp仍有39个约3ms间隔，平均发包率约250.491包/秒；其余选定姿态也仍有同类模式。均匀采样、DATA_RDY轮询/时基关系、真实滤波、ILA窗口与报警、恢复及冷启动保持各自验收边界。

## 下一步

1. 静态均值采集与独立验证已经达到约定目标，保留第一轮固定参数，不再为改善已满足的均值反复拟合或采六面。
2. 下一阶段可将这套参数用于新的独立实验固件版本，保持原SensorSource可用；先明确参数来源/版本，验证定点舍入与饱和、错误恢复及Keil构建，再由操作者烧录并检查实际输出。旧SensorCalibratedTrial仍为旧短记录参数，不能当成本次新参数固件。
3. 原rc1冻结包保持不变。新固件实测应与已保存原始数据/离线结果对应，板上校正、raw回传、滤波/RMS尺度和演示阈值分别验证。
4. 继续单独定位周期3ms和静止瞬态，不能把静态参数通过写成严格均匀250Hz、动态频响或整体项目完成。

本轮未更新参数头、编译/烧录固件或修改RTL、约束、原始采集、rc1；只新增离线分析入口、结果标记和报告，更新进度与AI日志。
