FFsteve/zynq_vibration_monitor/docs/stage6_design.md

# 第六阶段：完整链路集成与量化方案

日期：2026-10-31。当前状态：**具体方案已获用户批准，实现和实际验证见[验收报告](../report/stage6_validation.md)；实物待最终阶段。** 原分期范围见 [分期计划](stage_plan.md)。

## 目标与保留边界

集成STM32十字节输入、UART接收/包解析、去直流/FIR、窗口MS/RMS/峰值、报警和可选择的UART回传，完成250包/s长序列、丢包/坏包/超时恢复、三轴隔离、延迟、输出堵塞和全状态复位验收。保存实际RTL滤波量化结果、资源和时序报告。

第一版仅PL。STM32采集和十字节输入协议保持现有约定，不引入PS/AXI/Linux，不新增引脚或外部开关。原有 `top` 和本地Vivado工程保留，新增可独立构建的 `system_top`，避免破坏既有第三阶段验证入口。最终是否切换原工程由后续集成步骤明确操作。

此前用户决定最终阶段统一上板。第六阶段准备板测步骤、记录模板和离线分析入口，不自行下载或采集；实物结果保持“未验证”，不能把软件完成写成完整板测通过。

## 原始/滤波回传规则：已确认

已增加综合参数 `RETURN_FILTERED`，只允许0或1：

| 模式 | 回传事件 | 三轴线缆字段 | 使用方法 |
|---|---|---|---|
| 0，默认 | 每个合法原始包 | 原始signed16，不缩放 | 与当前原始回传兼容 |
| 1 | 每个滤波输出 | signed18算术右移2位后成为signed16 | PC按有符号解码后乘4恢复计数尺度 |

回传仍为 `A5 5A SEQ XH XL YH YL ZH ZL CHK`，三轴大端，XOR重新计算。`ACK_ONLY=1`继续保留单字节06兼容模式，优先于载荷长度选择。输入布局与解析规则均不变。

滤波范围-131072～131071全部可表示为右移后的-32768～32767；禁止直接截低16位或静默溢出。Python参考使用 `value//4`，Verilog使用有符号 `>>>2`。还原值为4的整数倍，原值减还原值在0～3之间；这一步不影响内部18位滤波或第五阶段特征/报警。

该转换改变滤波模式的回传尺度，**用户已明确批准并已实现**。原始与滤波模式不自动混发，包内没有模式位，PC必须用明确的采集元数据记录 `raw` 或 `filtered` 及尺度4；不得从数值或包头猜模式。若用户要求完整18位无损回传，需另行评审扩展结果协议，本方案不自行添加。

滤波模式也回传历史预热中的输出，维持每个被接纳滤波样本一包；前62项为预热瞬态，量化分析按SEQ连续性和重启边界剔除。质量状态没有塞进原始轴字段，外部不能只凭一包识别完整质量；第五阶段内部窗口仍严格门控历史有效。

## 新增模块接口与状态

### return_source_select

输入 `clk/rst`、原始valid/SEQ/signed16三轴、滤波valid/SEQ/signed18三轴；参数 `RETURN_FILTERED`。输出一拍 `selected_valid_o`、SEQ和signed16三轴。

只需一组有效/数据快照寄存器，无多拍FSM。参数选择对应支路，原始数据不等待滤波，滤波使用同拍三轴和SEQ并整体右移。没有事件时仅valid清零，数据可保持；rst优先，同拍事件忽略、全部输出清零。接纳到发布1拍定义为：输入在上升沿被接纳后该沿NBA发布，后级在下一沿消费。

不在此模块接受输出反压，避免串口堵塞影响传感器采集、滤波和窗口时序；每个已选事件交由既有 `return_controller` 有界队列处理。

### system_monitor_core

输入 `clk/rst/pl_rx`，以及内部验证/调度用 `tx_pause_i`；板级固定接0。参数沿用UART、队列、滤波间断、窗长及报警参数，增加 `RETURN_FILTERED`。

输出 `pl_tx`、既有原始/滤波/特征/报警接口，新增真实选中发送支路的accepted/dropped/completed/queued计数与overflow事件。接收错误、SEQ和滤波诊断仍单独保存，不能把原始回传旧支路的计数当作新输出计数。

复用完整 `feature_monitor_core`，其旧 `pl_tx` 和旧输出队列诊断不连接；新增选择器、一个既有 `return_controller` 和一个 `uart_tx` 作为唯一外部回传支路。仿真中旧支路存在但不驱动外部TX；综合必须检查未连接旧发送器被移除，避免保留重复发送资源。这样可保持前五阶段源码及旧自检入口稳定。

发送控制沿用队列的IDLE/SEND/ARM_DONE/WAIT_DONE。`tx_pause_i`同时门控送入UART的valid和反馈给队列的ready；已经被UART接纳的字节必须完整发完，done继续返回。暂停只延迟后续字节，不能冻结半个位或把一次握手变成两次。

队列满丢新样本，禁止覆盖已接纳包；滤波和窗口继续运行。默认深度4是等待队列，另有一个在发送的包。暂停撤除后按顺序排空，不额外补造被丢包；SEQ缺口和dropped计数作为证据。暂停太久可能形成超出外部解码器容忍范围的包内间隔，因此板级不提供此暂停功能；它是内部拥塞自检接口，不声称UART支持端到端流控。

### system_top

保留现有三个物理端口名，使用上电复位和 `system_monitor_core`，`tx_pause_i=0`。不猜新按键/LED引脚；源模式在综合时选择。

使用427位带 `MARK_DEBUG/DONT_TOUCH` 的内部调试快照寄存器，采样窗口有效、三轴MS/RMS/峰值、报警有效/状态及必要诊断，为计算支路提供真实保留负载。仅网络标记在实际opt_design中不足，已据失败网表改正；快照多一拍仅影响调试观察，不参与功能反馈。不自行插入ILA或新增时钟；通过综合网表检查去直流/FIR、三个平方根和报警均存在。调试保留的资源开销按实际报告计入。

新板级构建在独立 `build/stage6_implementation/` 中运行，复用已有三端口约束；新增实现专用CDC约束精确匹配新层次的UART第一级同步D，第二级路径仍严格计时。构建前重新核对现有引脚资料与原理图，不变更原有XDC或本地工程缓存。

## 周期合同与带宽

所有处理仍由同一个PL时钟驱动，事件不依赖输出队列ready。已有滤波接纳至结果193拍，原始解析帧至第五阶段对齐特征218拍，窗口末项处理22拍，保持既有合同。

选择器新增一层快照。空队列且未暂停时，以解析器raw_valid发布沿为t=0，预计原始模式TX首起始位在t=4，滤波模式在t=198（原始进入滤波1拍、滤波193拍、选择/队列/发送4拍）；这两个周期已由实际双工具串口起始沿观察通过；窗口特征218拍也已核对。

默认UART每位四舍五入为434拍；十字节线缆发送最低43400拍=868us，独立字节起始时间观测已确认本实现包内无额外间隙，实际整包为43400拍/868us。250包/s产生25000bit/s，名义占115200bit/s的21.70%；不能把带宽余量当作真实采样或零丢包证明。

长序列主自检计划采用 `CLK_HZ=1152000, BAUD=115200` 的压缩配置，每位10拍、每4608拍一个样本，等效250包/s；字节超时2304拍、断流阈值13824拍。与默认50MHz电路参数的名义时间比例约43.4，保留相同baud和每秒样本比率，不称其为真实50MHz长时间板测。另有默认50MHz/115200通道验证真实434拍位宽和200000拍采样间隔。

## 验收合同与实际证据

1. 选择器：全部262144个signed18输入的转换、三轴隔离、原始/滤波事件错拍、SEQ、复位、非法模式。
2. 系统长序列：至少4096个样本（名义16.384s），两种回传模式与18位内部输出、窗口/报警逐项匹配独立Python；多次SEQ回绕，正常负载零输出丢弃。
3. 恢复：坏包头、校验、停止位、九处截断、主动丢包/重复、超时边界、12ms断流后重新预热/建窗；错误不得更新原子样本。默认参数通道另测。
4. 三轴隔离：仅X、仅Y、仅Z变化时其他轴去直流后保持零，窗口及报警无串扰；满量程与输入快照稳定单列。
5. 拥塞：暂停后计数守恒、顺序不变、只丢新包、队列满同时出入、撤暂停恢复；发送暂停不影响滤波/窗口/报警。中途复位清接收缓存、输出队列、当前发送、基线、FIR、窗口、开方、报警和全部诊断。
6. 量化：保存实际RTL原始、18位滤波、16位线缆还原及特征CSV；报告通/阻带、缩放误差、计算和线缆延迟。频率分析剔除预热和重启边界，合成数据明确标注，不冒充实测。
7. ModelSim/XSim均实际执行，当前完成文件/退出码/错误数及导出对照共同评分；新增模块均配自检。第七阶段再执行全部阶段回归与版本冻结。
8. 两种模式分别完成独立板级综合/实现，保存资源、时序、DRC、CDC和保留支路检查；不把第五阶段OOC数字冒充完整板级结果。未通过或警告原样报告。
9. 实物记录模板与操作步骤准备完毕；按用户此前安排留到最终阶段实际填入。没有实际下载/采集不得写实测通过。

## 文件计划

已新增三个RTL：`rtl/return_source_select.v`、`system_monitor_core.v`、`system_top.v`；三个配套自检及串口系统场景/共享检查文件。新增 `sim/run_stage6.ps1` 和ModelSim/XSim/负向用例脚本。

已新增 `host/stage6_reference.py`、`stage6_vectors.py`、`check_stage6_captures.py`，用于转换参考、长序列/异常期望及真实RTL导出评分。现有 `host/capture.py` 继续作为原始二进制采集入口，不把线上包中的数值当作模式标识。

新增 `scripts/check_stage6_implementation.ps1/.tcl`、新层次专用CDC约束；新增测试指南、板测记录模板、实际验证报告及JSON。README、分期计划、上下文、后续任务、AI日志同步。原前五阶段源码/测试、STM32、原始协议、本地Vivado缓存与烧录设置保持已有入口。
