FFsteve/zynq_vibration_monitor/report/stage6_board_record.md

# 第六阶段实物联调记录：待最终阶段执行

状态：**未执行本阶段下载或采集；以下均为待填写项，不是实测证据。** 用户此前选择最终阶段统一上板；原计划及本阶段软件证据分别见 [分期计划](../docs/stage_plan.md)、[验收记录](stage6_validation.md)。

## 运行身份

| 项目 | 原始模式 | 滤波模式 |
|---|---|---|
| 实测日期、操作者 | 未验证 | 未验证 |
| 最终源码/比特流SHA256 | 未验证 | 未验证 |
| 顶层和综合模式 | 计划system_top、RETURN_FILTERED=0，未下载 | 计划system_top、RETURN_FILTERED=1，未下载 |
| 实际UART参数和STM32目标 | 未验证 | 未验证 |
| MPU6050初始化回读、实际采样配置 | 未验证 | 未验证 |
| 仪器版本、采样率、通道和记录深度 | 未验证 | 未验证 |
| 原始记录文件及SHA256 | 未验证 | 未验证 |

## 验收记录

| 实际检查 | 待记录的证据 | 当前状态 |
|---|---|---|
| 冷启动、固定数据通信 | 连续包解码、XOR、SEQ、发送/回传一致或常数去直流后为零 | 未验证 |
| 原始/滤波选择 | 明确下载模式、同次D0/D1完整记录；滤波值解码乘4，剔除预热后对照 | 未验证 |
| 包周期、位宽与延迟 | 115200位时间及4ms包周期分布；用相同包的SEQ对齐，区分计算延迟和串口发送延迟 | 未验证 |
| 较长记录 | 完整包数量、SEQ连续性、实际间断、截断边界和错误统计；保留原始文件 | 未验证 |
| 三轴隔离和滤波效果 | 可重复单轴激励及输入参考，记录振幅/频率与原始、滤波尺度；不能把手摇频率当标准源 | 未验证 |
| 中断与恢复 | 人为中断后的重新通信、重新预热和建窗；不把数据失效视为正常解除 | 未验证 |
| 复位与重新启动 | 冷启动后无旧队列/旧统计，实际操作及首个可用窗口时间 | 未验证 |
| 传感器配置/校准 | 初始化寄存器回读、正反/六面静止、较长重复记录、采样均匀性 | 未验证 |

内部输出堵塞接口板级固定为0，不把TB暂停信号描述成现场UART硬件流控。窗口、RMS和报警本阶段保留内部调试网络，未插入ILA、未新增结果协议；如需在板上直接观察这些内部量，最终阶段先明确观测手段及设计变更。

示波/逻辑记录深度不足时，只验收覆盖范围内的完整事务；不得把开头或末尾截断自动判为线路错误，也不能凭短记录声称长期零丢包。板测量值换算必须与实际传感器配置、校准和回传模式对应。
