FFsteve/zynq_vibration_monitor/docs/competition_closeout_20261101.md

# 比赛项目收尾范围

日期：2026-11-01。用户明确强调这是独立学生比赛项目，要求审视剩余测试是否必要。后续按能重复演示、结果可信、材料可解释的目标收尾，不将完整工程验收表全部勾选作为比赛交付前提。比赛规则全文尚未提供，以下是项目内建议，不代表已核实的主办方强制要求。

最新状态：本文件建议的三阶段演练已由filter_test_final截图完成，见 `../report/competition_rehearsal_validation_20261101.md`。静止、X报警和有效正常恢复均检查通过。下一步只做材料与当前演示文件归档，以下测试建议保留为已执行计划和现场复现参考。

## 已完成的核心证据

- MPU6050身份和配置实际回读，I2C读取、UART组包和FPGA回传闭环。
- 六面离线静态与重复性验证、参数更新、校准固件软件检查及板上输出精确匹配。
- 固定输入滤波归零、真实输入从首包及预热到稳态的定点回传匹配。
- 三个有效ILA窗口的MS/RMS/峰值与同次输入参考精确匹配，单拍发布及保持已核对。
- 实测Z轴报警和下一低窗保持，符合连续两窗规则；正常解除边沿尚未直接取得。
- 既有RTL自检、数字频率量化、综合实现资源及时序报告均有实际执行证据，复用这些报告，避免当作新的实物频响结果。

最新实物证据见 `../report/filter_test_3_validation_20261101.md` 与 `../report/filter_test_4_validation_20261101.md`。原始数据和较严格证据表保留，不因缩小收尾范围就将未测项改为通过。

## 建议保留的最后工作

1. **一次从头到尾的比赛演练。** 从重新上电、按当前已用流程配置FPGA及启动STM32开始，展示静止、运动时滤波/RMS变化和报警，再放稳观察正常解除。总过程约3～5分钟，保存一段视频或若干状态截图即可，不再默认要求每个边沿都有同步原始ILA和UART精确捕获。当前程序由JTAG配置FPGA，演示步骤中明确重新配置这一步，不新增独立启动系统。
2. **基本恢复顺带检查。** 如准备在现场操作STM32复位，在演练中按一次复位，确认能重新出数据和窗口。已有重启后恢复数值证据，不新增逐拍超时失效或边界故障注入的必做要求。若只演示连续运行，该检查属于提高现场把握的建议。
3. **固定演示文件并整理现有材料。** 明确配对FPGA debug bit/ltx和当前新校准STM32程序，整理下载顺序、系统框图、滤波前后对比、RMS/报警结果及既有资源/时序数字。当前新校准固件与旧rc1中原SensorSource不同，演示包写清实际目标和文件，避免误下旧程序。无需为此重建功能代码。

这次演练应确认基本正常解除：Z报警恢复为0且alarm_valid仍为1，不能把复位或断流使有效标志失效的清零当作解除。不要求必须采到20ns变化瞬间。若实际长时间静止仍不正常解除或系统不能重复启动，则属于演示功能问题，应先排查。

## 可选提高项，不再默认阻塞收尾

| 原清单 | 比赛项目处理 |
|---|---|
| alarm_assert/alarm_release边沿精确捕获 | 可选；已给方案保留，用户希望补完整时再做 |
| B09全部数字频点的实物回放 | 可选；保留已执行仿真/RTL量化证据，实物受控频响明确未验证 |
| 专业机械振动台与幅频标定 | 当前目标下不要求增加设备 |
| 三轮或更多整机冷启动 | 缩减为一次完整演练；发现不稳定再针对性复现 |
| 所有错误/截断/超时/队列边界再次上板 | 已有自检覆盖，比赛收尾不逐一重复实物故障注入 |
| 六面继续重复校准、重复60秒记录 | 已有足够对应证据，无新问题不继续追加 |
| 所有文件/每次采集重复登记完整指纹 | 最终演示文件明确归档；分析已有指纹保留，不额外制造采集任务 |
| 完整回归、重新综合和实现 | 功能代码/约束没有新变化时复用既有结果；有修改时执行受影响检查 |

## 限制如何写入比赛材料

当前实际采样约250.5Hz，周期性约3ms短间隔仍存在；此前静止瞬态根因也没有完全定位。将实际条件和现象记录为原型限制，不自动要求在比赛收尾前重写采样架构。若现象使现场出现明显错误结果、误报警或无法解释的失效，再升级为必须处理的问题。

已验证数字运算与受控仿真频响、板上真实输入滤波和窗口数值；精确物理幅频响应尚未用标准机械激励测量。材料按这个范围表述，不把演示门限解释为工业故障标准。若主办方规则另有明确要求，再只补与评分相关的缺项。

## 接续规则

下一步默认进入演练、材料整理和演示版本归档。不要继续自动追加ILA截图、机械重复采样或完整B01～B12签收任务。用户要求更严格验证或演练暴露具体问题时再恢复对应专项。
