FFsteve/zynq_vibration_monitor/docs/competition_evening_plan_20261101.md

# 初级组一晚收尾计划

日期：2026-11-01。依据用户提供的2026 AMD FPGA选题指南，已读取3.3自主选题初级组以及第六部分，并实际查看相关PDF页面。目标是在约5小时净投入、最多6小时内形成可审阅、可复现的本地提交包；本轮为规划，不表示下列成果已经全部生成。报名平台的独立评分细则、截止时间、附件大小及模板仍以平台要求为准，本文件不臆造这些条件。

## 先确定方向

当前Zynq-7010属于初级组允许的Zynq-7000系列；Verilog PL实现可以继续使用，PYNQ是推荐与额外加分方向，今晚不迁移PS/PYNQ、不加FFT、屏幕、神经网络或新通信协议。保留Vivado/XSim2020.2，报告写明沿用现有板卡与验证环境、脚本和实际版本；指南允许其他版本，只要求说明并保证复现，不必今晚升级工具链。

初级组与高级组的提交内容和评分项目相同。Skill和大模型协作交互记录均属本赛道要求，不能因为选择初级组就省略。开源措辞是强烈要求，优先准备可公开的源码、许可及仓库，不将未明确授权的厂商库/PDF纳入自有开源许可。

暂定题目可用“基于Zynq-7010的三轴振动监测与声报警系统”；只有蜂鸣器实物确认成功才把声音写入已实现演示结果。应用定位为设备振动状态观察和教学原型，优势表述为可复现的PL信号处理、三轴特征与可信状态报警，不能包装成未经验证的工业故障诊断。

## 当前成果与真正缺口

| 评分项 | 权重 | 当前可复用证据 | 今晚需要补齐 |
|---|---:|---|---|
| 创新性与应用价值 | 30 | 可用的采集—校准—PL处理—报警链路与实物演练 | 具体应用场景、已有方案简述、软硬件划分理由、作品贡献及边界 |
| 性能与资源优化效果 | 20 | 数值/RTL频响、精度、延迟、raw/filtered/debug和新蜂鸣器资源时序报告 | 基线定义、同口径比较表及可读图，区分实测、仿真和理论估算 |
| 功能正确性与完整性 | 20 | 历史双工具全回归、新校准固件验证、真实滤波/3窗精确匹配、最终3态截图、新蜂鸣器专项自检与构建 | 蜂鸣器实际响停的简短确认；最终版证据索引，注明哪些证据对应旧版/新版 |
| 大模型协作与技能包 | 15 | ai_devlog及现有skill/fir-validation | 补真实问答片段，增强Skill跨项目使用说明、参数替换示例及失败边界 |
| 文档质量与可复现性 | 15 | 分阶段设计、脚本、日志、旧rc1包 | 一份统一设计报告、当前README、最新程序组合、第三方依赖说明和精简提交包 |

已有内容不是从零重写。当前README及部分10月31日报告仍写未上板/未校准、未收到正式规则，需要在当前入口更新，历史报告标注日期并保留，不能批量改历史测试结论。

## 执行顺序与时间预算

以开始工作为T=0，不强行指定钟点。以下串行主线约5小时，额外留30～60分钟处理导出和打包。

| 时间段 | 任务 | 具体产物 | 完成标准 |
|---|---|---|---|
| 0:00～0:15 | 确认演示版本 | 最终下载文件清单、一次响停确认 | 新蜂鸣器版静止不响/报警响/恢复停；10～15分钟内未确认则采用已实测旧debug版作为主提交，蜂鸣器保留为软件已验证扩展，不拖慢主线 |
| 0:15～1:00 | 汇总性能、基线与图表 | metrics_summary.csv、频响/真实数据对比图、资源与时序表 | 所有数值能指向已有JSON/CSV/报告，基线与测量条件明确 |
| 1:00～2:30 | 编写统一设计报告 | report/design_report.md，导出design_report.pdf | 覆盖指南7类报告内容，正文建议约10～15页，图表清晰，不把日志全文塞入正文 |
| 2:30～3:15 | 完善Skill与真实协作记录 | skill/README.md、已有Skill的通用使用示例、report/ai_collaboration.md | 陌生队伍能理解如何替换配置；有真实提示词/回答/纠错，摘要与原文分开 |
| 3:15～4:15 | 修复复现入口并组装提交包 | 当前README、版本清单、依赖/许可说明、submission包及校验清单 | 包里包含最新已选FPGA与校准STM32组合，命令/链接可用，第三方文件边界清楚 |
| 4:15～4:45 | 演示与答辩素材 | 约2～3分钟演示视频或已有三态图配说明、简短讲稿 | 能讲清FPGA做什么、为什么这样划分、实测证明了什么 |
| 4:45～5:00 | 最后核对 | 要求—文件—证据对照表 | 无错误版本/失效链接/虚构数据，待填写队伍信息和公开事项列清楚 |

部分图表可直接放入报告，演示视频可以与第一步响停确认合并，不再重新采六面、20秒/60秒长记录或全部频点实物回放。

## 性能与优化对照的口径

优先使用真实已有数据：10Hz/30Hz/60Hz的RTL增益、完整内部18位与线缆还原精度、3.86µs量级计算流水和UART包起点延迟、FIR群延迟及窗口确认时间、实测约250.5Hz和短间隔、各独立变体的资源与50MHz时序。计算延迟、群延迟、窗口时间和端到端回传延迟分开定义。

至少准备三类比较：未处理输入与去直流/FIR后的信号效果、浮点黄金参考与定点RTL精度、部署变体的资源/可观测性代价。raw/filtered/debug功能和观测负载不同，只能说明模式差异，不能自动称为同功能优化。新蜂鸣器比旧debug减少70LUT是整体映射变化，不是优化成果；增加1FF是实际资源变化。

指南明确要给优化过程及优化前后性能/资源表。目前同功能架构优化的实测前后对照并不充分，这是材料中最需要谨慎处理的一项：先查现有阶段证据是否有可比基线；若没有，不捏造加速倍数或DSP节省率。报告写清串行MAC、定点位宽及三轴并行的设计选择，理论结构代价与实际综合数据分栏。若希望补足这一项并且有一小时以上余量，可另做不接入主系统的单轴FIR串行/并行对照实验；要先明确接口、数值/周期合同并运行验证，不能用仅加宽或堆资源的任意实现凑所谓优化。

预算优先保证真实且完整的提交，独立架构基线实验作为提高项；缺少该实测对照如实说明，不保证这一评分项拿满分。

## 设计报告提纲

1. 应用问题、目标用户/场景、相关方案与作品贡献。
2. 系统框图、数据流、STM32与PL划分依据、器件与工具版本。
3. 十字节协议、错误恢复、关键状态机、单时钟事件推进与时序约束。
4. 传感器校准、去直流、63抽头定点FIR、128点MS/RMS/峰值、滞回与两窗报警；蜂鸣器若确认则列为输出执行支路。
5. 验证方法、仿真与实测结果、基线与优化/资源权衡、时序和已知Warning。
6. 大模型协作实例、真实失败与修正、Skill如何提炼及复用边界。
7. 从零复现的环境、依赖、命令、下载/演示步骤及已知限制。

将实际采样短间隔、静止瞬态、演示阈值和未做标准机械幅频测试如实写入限制。图表注明来源，既有ModelSim/XSim/数值模型结果不改名为实物频响。

## Skill与AI记录的最小完成范围

保留已有fir-validation成果，补“项目无关步骤”和“本项目配置”两层说明，提供一种可替换系数、定点格式或结果CSV的使用例子；有小型实际运行例子证明说明可执行。无需转PYNQ，也不声称获得PYNQ额外加分。

优先提炼真实经验：负数舍入/截断、仅MARK_DEBUG导致计算支路优化丢失、bit与ltx错配、CSV采集边界/重复输入识别、有效状态与快照光标、测试范围与需求匹配。写明适用条件、排查顺序、已验证效果及不适用范围，不能把改了标题的项目专用说明说成通用工具。

ai_devlog已有摘要，但不能完全代替原始交互。挑选4～6组能取得真实原文的提示词、回答和自我纠错，并链接对应代码/失败日志/修复证据；拿不到原文的条目明确写成事后摘要，不伪造对话。原文中的个人信息可脱敏，模型名称/版本只写能确认的内容。

## 工程包与公开仓库

不直接覆盖旧rc1，也不直接把旧package_release.py再次运行后当成最新发布。旧打包器仅收录raw/filtered/debug三版FPGA和FixedSource/SensorSource两固件，遗漏当前新校准固件与蜂鸣器版的实际程序组合，且保留旧物理验证状态。需要更新打包入口或编写明确的比赛组装脚本，纳入选定的新文件及对应测试证据，不伪称全量回归在本轮又运行过。

当前Git跟踪及未跟踪候选共524文件、约1880.20MiB，其中report/evidence约1879.01MiB，且单个60秒I2C CSV约100.88MiB。不要直接git add全部原始采集与缓存。源码、精选验证数据/截图、复现脚本为主包；完整原始记录保留本地，按需另作证据附件。不要删除原始数据来减小提交体积。

当前没有发现候选文件路径中的中文、空格或异常字符。推荐目录是非强制的，不将rtl/整体重命名src/；在README给出与指南src/sim/build/board/data/skill/report的对应表。保留指南/工具明确使用的README.md、SKILL.md等入口名，不进行可能破坏Keil与脚本引用的全仓库改名。

还需补自有代码开源许可选择、第三方依赖来源/本地安装说明、当前文件对应关系及可公开清单。厂商库、原理图/手册和自动生成IP源码不因自有代码选择MIT就自动获得再分发权。现有GitHub origin已配置，但本轮规划不执行推送；先完成可审阅的本地包，再按用户授权发布。

## 今晚不作为主线的事项

- 不新增PS/PYNQ、FFT、显示屏、远程通信或新工业故障模型。
- 不升级Vivado；按指南解释2020.2及实际复现环境。
- 不重做已完成的校准/全量板测；新蜂鸣器只确认一次响停。
- 不为材料好看补写没有发生的测试、优化提升或AI原始对话。
- 不优先制作整套复杂PPT。指南第六部分要求进入决赛的自主选题队伍使用AMD模板提交一页英文海报、隐去队伍信息并A4彩印；该项按决赛阶段和模板处理，今晚有余量先写英文内容草稿，不能把自制版冒充官方模板。

## 最终交付检查

今晚结束时应能找到一份完整设计报告、一张实际指标/基线对照表、一份可用Skill、一组真实AI协作记录、一套最新已选下载文件、清晰复现README、精选实测与仿真证据及可审阅提交包。蜂鸣器实测状态、相关前人资料引用、队伍信息、许可选择和公开仓库发布如未完成，明确列出，避免“都做了但装错版本”。

源指南为用户F盘提供文件，SHA256：c6ad82acd4f7bdcd13bd412e232ed85d05f2a87dd5e2cdd04f9d219f88b569fc。相关页为印刷页19～22及25，即PDF物理页22～25及28。没有将第三方指南复制到公开源码目录。
