FFsteve/zynq_vibration_monitor/report/evidence/20261101_session01_analysis/frames.csv

segment | time_s | seq | x | y | z
0 | 0.00110285 | 212 | 786 | -554 | 22010
0 | 0.005095850000000001 | 213 | 590 | -612 | 21826
0 | 0.00909755 | 214 | 688 | -712 | 21972
0 | 0.0130992 | 215 | 830 | -618 | 22030
0 | 0.0171009 | 216 | 552 | -734 | 22040
0 | 0.0211026 | 217 | 752 | -654 | 21950
0 | 0.025095600000000003 | 218 | 714 | -594 | 21930
0 | 0.029097249999999998 | 219 | 680 | -754 | 21988
0 | 0.03309895 | 220 | 816 | -592 | 22038
0 | 0.037100650000000006 | 221 | 624 | -692 | 22054
0 | 0.0411023 | 222 | 662 | -700 | 22036
0 | 0.045095300000000005 | 223 | 684 | -586 | 21894
0 | 0.049097 | 224 | 558 | -680 | 21926
0 | 0.0530987 | 225 | 794 | -634 | 21914
0 | 0.0571004 | 226 | 696 | -618 | 21902
0 | 0.06110205 | 227 | 596 | -684 | 21968
0 | 0.06509505 | 228 | 812 | -586 | 21934
0 | 0.06909675 | 229 | 614 | -596 | 21952
0 | 0.07309845 | 230 | 726 | -678 | 21902
0 | 0.0771001 | 231 | 750 | -580 | 21924
0 | 0.0811018 | 232 | 624 | -708 | 21942
0 | 0.08509480000000001 | 233 | 746 | -618 | 22004
0 | 0.08909650000000001 | 234 | 634 | -636 | 21974
0 | 0.0930982 | 235 | 664 | -624 | 22016
0 | 0.09709985 | 236 | 792 | -606 | 22000
0 | 0.10110155 | 237 | 630 | -648 | 21964
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
