FFsteve/zynq_vibration_monitor/report/evidence/stage6/samples_comparison.csv

sample_index | synthetic_case | seq | raw_x | raw_y | raw_z | filtered_x_s18 | filtered_y_s18 | filtered_z_s18 | wire_x_s16 | wire_y_s16 | wire_z_s16 | restored_x | restored_y | restored_z
0 | 0 | 251 | 6000 | -7000 | 21900 | 0 | 0 | 0 | 0 | 0 | 0 | 0 | 0 | 0
1 | 0 | 252 | 8487 | -839 | 27888 | 0 | -1 | -1 | 0 | -1 | -1 | 0 | -4 | -4
2 | 0 | 253 | 10818 | 1982 | 22652 | -3 | -7 | -5 | -1 | -2 | -2 | -4 | -8 | -8
3 | 0 | 254 | 12845 | -65 | 16006 | -7 | -13 | -4 | -2 | -4 | -1 | -8 | -16 | -4
4 | 0 | 255 | 14443 | -5872 | 20408 | -10 | -11 | 6 | -3 | -3 | 1 | -12 | -12 | 4
5 | 0 | 0 | 15511 | -12290 | 27606 | -10 | 5 | 12 | -3 | 1 | 3 | -12 | 4 | 12
6 | 0 | 1 | 15980 | -15841 | 24109 | -5 | 27 | 4 | -2 | 6 | 1 | -8 | 24 | 4
7 | 0 | 2 | 15823 | -14599 | 16471 | 0 | 35 | -12 | 0 | 8 | -3 | 0 | 32 | -12
8 | 0 | 3 | 15048 | -9238 | 19009 | 0 | 10 | -19 | 0 | 2 | -5 | 0 | 8 | -20
9 | 0 | 4 | 13705 | -2664 | 26966 | -7 | -37 | -7 | -2 | -10 | -2 | -8 | -40 | -8
10 | 0 | 5 | 11878 | 1560 | 25427 | -15 | -66 | 16 | -4 | -17 | 4 | -16 | -68 | 16
11 | 0 | 6 | 9681 | 1143 | 17277 | -13 | -37 | 30 | -4 | -10 | 7 | -16 | -40 | 28
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
