FFsteve/zynq_vibration_monitor/report/evidence/20261101_noreset_analysis/zn_i2c_recheck/noreset_zn_frames.csv

time_s | seq | x | y | z
0.00317795 | 220 | 26 | -1392 | -11540
0.00717965 | 221 | 162 | -1286 | -11484
0.01118135 | 222 | -78 | -1368 | -11542
0.015174350000000001 | 223 | 132 | -1338 | -11550
0.01917605 | 224 | 82 | -1366 | -11526
0.023177700000000002 | 225 | -94 | -1392 | -11648
0.027179400000000003 | 226 | 190 | -1354 | -11498
0.0311811 | 227 | 32 | -1350 | -11512
0.03517410000000001 | 228 | 2 | -1436 | -11472
0.039175800000000004 | 229 | 106 | -1328 | -11546
0.04317745 | 230 | -52 | -1396 | -11504
0.04717915 | 231 | 156 | -1334 | -11486
0.05118085 | 232 | 82 | -1282 | -11524
0.05517385 | 233 | -36 | -1434 | -11592
0.05917555 | 234 | 256 | -1330 | -11496
0.0631772 | 235 | 22 | -1366 | -11472
0.0671789 | 236 | -8 | -1372 | -11532
0.0711806 | 237 | 112 | -1300 | -11590
0.0751736 | 238 | -58 | -1390 | -11562
0.07917525 | 239 | 110 | -1354 | -11580
0.08317695000000001 | 240 | 108 | -1352 | -11524
0.08717865000000001 | 241 | -28 | -1372 | -11620
0.09118035000000001 | 242 | 138 | -1332 | -11588
0.09517335 | 243 | 4 | -1358 | -11622
0.099175 | 244 | 34 | -1394 | -11544
0.1031767 | 245 | 122 | -1326 | -11494
0.1071784 | 246 | -60 | -1426 | -11508
0.11118005 | 247 | 84 | -1334 | -11506
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
