FFsteve/zynq_vibration_monitor/report/ai_records/old_thread.md

# 分析 UART RX 设计与硬件约束：项目协作正文记录

本文件通过聊天历史接口读取全部分页，保留用户正文及助手对用户展示的答复；不含内部推理、工具调用和原始附件。历史答复可能存在后来纠正的判断，当前结论以项目根 README.md、验证报告和纠错日志为准。嵌入式跨聊天缓存预览省略，避免重复和误当原始对话。
来源聊天ID：`01a14473-9b54-76b3-a507-fd7123c28133`。读取日期：2026-11-02。共 46 轮（当前轮仅保存读取时已产生的正文）。

## 交互 01a14476-d906-7c12-8d17-7caa009df8ee

### 用户

请先阅读项目zynq_vibration_codex_handoff文件夹下的 AGENTS.md、README.md、docs/project_context.md、docs/hardware_pinmap.md、docs/next_task.md，以及 docs/hardware/ 中的四份 PDF。

这是一个使用 Zynq-7010、STM32F103C8T6 和 MPU6050 的 FPGA 振动监测竞赛项目。

zynq_vibration_codex_handoff文件夹是一个包含约束，文档，rtl，仿真，skill，以及stm32部分的文件夹；而vivado_project是用于建立vivado项目的文件夹。

我目前熟悉 Verilog 基础、Testbench 和 STM32 标准库，但尚未学习 Zynq PS 开发。第一阶段仅使用 PL。

请先完成以下任务：

1. 根据原理图核对 FPGA 的 50 MHz 时钟、UART RX/TX 引脚及 IO 电压，检查候选 XDC 是否存在错误。
2. 分析 STM32 到 FPGA 的 UART 数据链路，并检查当前约定的 10 字节数据包格式。
3. 为 UART RX 模块设计输入输出接口、内部状态机、计数器和采样时序。
4. 为 UART RX 制定完整的 Testbench 测试方案。
5. 列出第一阶段需要创建和修改的文件，并说明各个文件的职责。

本轮只进行设计分析，不要修改任何工程文件。

对于无法从原理图确认的事项，请明确指出，不要猜测。

完成后等待我确认，再开始编写 RTL。

### 助手（进度）

我会先阅读交接目录中的说明和四份硬件 PDF，核对引脚与链路约定，再整理 UART RX 的设计和测试方案。本轮只做分析，不修改工程文件；PDF 核对会使用 pdf 技能。

### 助手（进度）

交接文档将引脚约束和数据包格式都标为候选方案，目前也没有已通过的仿真或板测记录。我接下来会重点核对原理图中的时钟、Bank 电源，以及 UART2 与 RS232/RS485 电路的跳线关系。

### 助手（进度）

候选 XDC 使用 U13、K14、M15，50 MHz 的时钟周期写为 20 ns。我正在通过 PDF 图面确认这些引脚的完整连接路径；电源选择电阻和连接器脚号仍需看图核实。UART RX 方案会先采用双触发器同步、位中心采样，并将字节接收与数据包解析分成两个模块。

### 助手（进度）

图面核对发现一个关键错误：50 MHz 的 `PL_GCLK` 接到 **U18（Bank34 的 MRCC 引脚）**，不是候选 XDC 和引脚文档中写的 U13。U13 对应 `B34_L3_P`，另有 1 kΩ 下拉。UART 的 K14、M15 与原理图一致；我会在最终分析中区分这项已确认的错误和仍需实物测量的电压、跳线状态。

### 助手

已阅读指定的 5 份文档、四份 PDF，以及候选 XDC。**发现一项明确错误：50 MHz 时钟应接 U18，候选约束中的 U13 错误。** UART RX/TX 的 K14、M15 与所提供原理图一致。

本轮没有修改工程文件，也没有编写 RTL、运行仿真或执行 Vivado 构建。以下区分原理图结论、设计建议和待实物确认事项。

**1. 时钟、UART 引脚、电压与候选 XDC**

核心板依据：:codex-file-citation{path="D:/Code/zynq_vibration_monitor/zynq_vibration_codex_handoff/docs/hardware/zynq_core_2v5.pdf" purpose="source"}，PDF 第 3、7、10、12 页。

底板依据：:codex-file-citation{path="D:/Code/zynq_vibration_monitor/zynq_vibration_codex_handoff/docs/hardware/zynq_baseboard_v3_9.pdf" purpose="source"}，PDF 第 1、5 页。

| 项目 | 原理图核对结果 | 当前约束判断 |
|---|---|---|
| PL 时钟 | X1 标称 50 MHz，OUT 经 R7＝33 Ω形成 `PL_GCLK`，接 **U18 / IO_L12P_T1_MRCC_34** | **U13 错误，应改为 U18** |
| U13 的实际连接 | `B34_L3_P / IO_L3P_T0_DQS_PUDC_B_34`，该网络有 R8＝1 kΩ下拉 | 不是图中的振荡器时钟输入 |
| FPGA RX | J3.1 → `UART2_RX` → 底板 J2.56 / 核心板 X3.56 → `B35_L20_P` → **K14** | 正确 |
| FPGA TX | **M15** → `B35_L23_N` → 核心板 X3.58 / 底板 J2.58 → `UART2_TX` → J3.2 | 正确 |
| 时钟周期 | 50 MHz 对应 20 ns | `create_clock ... -period 20.000` 正确 |
| Bank34 电源 | 第 7 页接 `VCCIO`；第 10 页由 U8（SPX3819M5-3-3）产生，设计标称 3.3 V | 图纸支持时钟使用 `LVCMOS33` |
| Bank35 电源 | 第 7 页通过标注 0 Ω的 R216、R219 接 +3.3 V；通向 VCCIO 的 R218、R215 标注 NC | 图纸默认装配支持 UART 使用 `LVCMOS33` |
| 共地 | J3.37、J3.39 为 GND；J3.38 为 +3.3 V，J3.40 为 +5 V | 接线时必须辨认脚号 |

因此，[候选 XDC](D:/Code/zynq_vibration_monitor/zynq_vibration_codex_handoff/constr/top_candidate.xdc) 中的时钟引脚，以及 [hardware_pinmap.md](D:/Code/zynq_vibration_monitor/zynq_vibration_codex_handoff/docs/hardware_pinmap.md) 中“PL_GCLK → B34_L3_P → U13”的描述，都需要在获准修改后纠正。

原理图还确认：**UART2 与 RS232/RS485 共用网络。** P1 的 3、4 脚分别为 `UART2_TX`、`UART2_RX`。外部 STM32 驱动 J3.1 前，应断开通往收发器的跳线，避免接收器输出与 STM32 TX 同时驱动。首轮直连测试建议取下 P1 上相关跳帽。

仍不能从这些 PDF 确认的事项：

- 实际核心板、底板是否与所给版本一致。
- 实际 FPGA 的完整器件型号、封装、速度等级。
- 电源选择电阻实际焊接情况，以及 Bank34、Bank35 的实测电压。
- X1 实际输出频率、幅度和振荡器精度。
- P1 当前跳线状态、排针在实物上的朝向。
- STM32 最小板及 USB 转串口模块的实际输出电平；资料中没有它们的原理图。

候选 XDC 也尚未经过 Vivado 验证。后续应给 RX 同步寄存器添加 `ASYNC_REG`，并只针对异步输入到第一级同步寄存器的路径处理时序例外，保留后续同步逻辑的时序检查。不能通过关闭专用时钟路由检查来掩盖 U13 错误。

**2. STM32 → FPGA 链路与 10 字节数据包**

第一阶段链路建议保持为：

```text
MPU6050 → STM32 I2C采集 → USART1 TX
        → J3.1 / K14 → UART RX → 包解析 → 三轴数据寄存器
        → UART TX → M15 / J3.2 → 外置USB串口RXD → PC
```

STM32 和 USB 串口均与 FPGA 共地。此架构仅使用 PL。

传感器原理图：:codex-file-citation{path="D:/Code/zynq_vibration_monitor/zynq_vibration_codex_handoff/docs/hardware/mpu6050_module_schematic.pdf" purpose="source"}，PDF 第 1 页确认模块使用 3.3 V，SCL/SDA 各有 2.2 kΩ上拉，AD0 有 4.7 kΩ下拉，默认 7 位地址为 `0x68`。

模块手册：:codex-file-citation{path="D:/Code/zynq_vibration_monitor/zynq_vibration_codex_handoff/docs/hardware/mpu6050_module_manual.pdf" purpose="source"}，第 5 页接口定义与上述原理图一致；第 6～11 页介绍采样配置、寄存器读取和初始化。

交接文档约定 STM32 使用 PA9、PB6、PB7，但这四份 PDF **不能验证 STM32 最小板的板级连接**。后续 STM32 程序仍使用标准库。

当前包格式长度正确：

| 字节偏移 | 内容 | 解释 |
|---|---|---|
| 0、1 | `A5 5A` | 固定包头 |
| 2 | `SEQ` | 8 位序号 |
| 3、4 | `XH XL` | X 轴，16 位补码，高字节先发 |
| 5、6 | `YH YL` | Y 轴，同上 |
| 7、8 | `ZH ZL` | Z 轴，同上 |
| 9 | `CHK` | 偏移 2～8 的 7 个字节逐字节异或 |

需要区分两种顺序：**轴数据高字节先发，但 UART 每个字节内部仍然低位先发。**

可用于后续验证的样例：

```text
A5 5A 01 00 01 FF FF 80 00 81
```

其含义为 `SEQ=1，X=1，Y=-1，Z=-32768`，校验值为 `81`。

115200、8N1 下，每字节占 10 个串行位：

- 一包占 100 位，耗时约 **868.06 μs**。
- 250 包/s 需要 25,000 bit/s，占链路约 **21.70%**。
- 按 4 ms 一包计算，连续发完一包后约余 3.13 ms。

这些是理论计算，不能证明 STM32 已实现稳定的 250 Hz 采样。`delay_ms(4)` 也不能保证与传感器新数据同步。

包格式可以作为首版，但需在 RTL 前补齐以下约定；以下均为建议，尚未冻结：

- `SEQ` 按模 256 递增；跳号、重复用于诊断，不直接判为校验失败。
- 完整校验成功时，三轴及序号同时更新，`frame_valid` 拉高一个 PL 时钟周期。
- 包解析器采用最近 **10 个字节的滑动窗口**检查包头及校验，避免截断包吞掉紧随其后的完整包；载荷中出现 `A5 5A` 也不立即重启解析。
- 建议合法字节之间超过 **2 ms** 未收到新字节便清空窗口；50 MHz 下为 100,000 周期。STM32 必须在此间隔内连续发送包内字节。
- UART 停止位错误时清空解析窗口，随后重新搜索。

XOR 可以漏检抵消的多位错误及字节交换；无转义包头也可能误匹配。因此该协议只能提供有限检错，不能保证任意损坏流下绝不误收。首版可保持现有格式，本轮不擅自换 CRC。

**3. UART RX 的接口、寄存器与采样时序**

建议独立模块名为 `uart_rx`，只负责接收字节。

| 接口/参数 | 方向或默认值 | 职责 |
|---|---|---|
| `CLK_HZ` | 50,000,000 | 输入时钟频率 |
| `BAUD` | 115,200 | 波特率 |
| `clk` | 输入 | 全部逻辑使用其上升沿 |
| `rst` | 输入 | 高有效同步复位 |
| `rx_i` | 输入 | 异步串行信号 |
| `data_o[7:0]` | 输出 | 最近一次合法接收的字节 |
| `valid_o` | 输出 | 合法字节完成脉冲，持续 1 周期 |
| `framing_error_o` | 输出 | 停止位错误脉冲，持续 1 周期 |
| `busy_o` | 输出 | 正在确认起始位或接收数据、停止位 |

`data_o` 在坏帧时保持上次合法值；`valid_o` 与 `framing_error_o` 不同时有效。首版不设置反压接口，下游必须接收每个有效字节。

内部寄存器建议如下：

| 寄存器 | 位宽 | 用途 |
|---|---:|---|
| `rx_meta`、`rx_sync` | 各 1 | 两级同步，逻辑只使用第二级 |
| `rx_prev` | 1 | 检测同步信号下降沿 |
| `state` | 3 | 五状态 FSM |
| `baud_cnt` | 默认 9 | 半位、整位及恢复等待计时 |
| `bit_idx` | 3 | 数据位索引 0～7 |
| `shift_reg` | 8 | 暂存当前字节 |
| 输出寄存器 | 对应接口 | 保存数据及生成单周期脉冲 |

默认计时参数：

```text
CLKS_PER_BIT = round(50,000,000 / 115,200) = 434
HALF_BIT     = 217
```

等效波特率约为 `115207.37`，分频误差约 **+0.0064%**。采用一个 50 MHz 时钟和计数使能，不生成新的低速逻辑时钟。

| 状态 | 行为与转换 |
|---|---|
| `WAIT_HIGH` | 复位后或坏停止位后进入；要求同步 RX 连续高电平一整位，再进入 `IDLE` |
| `IDLE` | 等待同步 RX 下降沿；检测后开始半位计时，进入 `START` |
| `START` | 半位后检查 RX；低则确认起始位，进入 `DATA`；高则按假起始位丢弃并返回 `IDLE` |
| `DATA` | 每隔一整位采样一次，依次写入 `shift_reg[0]`～`[7]`；完成后进入 `STOP` |
| `STOP` | 再等一整位采样；高则提交字节并返回 `IDLE`；低则报错并进入 `WAIT_HIGH` |

以**识别到同步下降沿的时钟沿为 t=0**：

| 采样点 | 相对周期数 |
|---|---:|
| 起始位中心 | 217 |
| D0 | 651 |
| D1～D6 | 每次再加 434 |
| D7 | 3689 |
| 停止位中心 | 4123 |

物理引脚到这个时间基准另有同步及检测延迟，Testbench 不能将两者混为一谈。

计数器必须明确“等待 N 周期”的定义。例如下降沿处装载 `216`，以后每周期递减，到零时采样，对应等待 217 周期；整位装载 `433`。这能避免常见的多算或少算一周期。

合法停止位在中心确认后直接返回 `IDLE`，可接收仅有一个停止位的连续字节。错误恢复则有明确条件：**先提供至少一整位高电平，再发送新字节**。这样长时间拉低不会持续产生重复错误或伪字节。

该版本采用单点中心采样。数据位中心受干扰时可能收到错误字节，8N1 无法自行识别这种错误，需由上层包校验处理。

模块的 `rst` 是逻辑接口，不代表增加一个尚未核实的板级复位引脚。顶层上电复位方式需在实现时明确。

**4. UART RX 的自检 Testbench 方案**

使用独立的 UART 激励任务，按时间发送串行波形；标称位宽使用 `1/115200 s`，避免激励与 DUT 同用 434 周期而掩盖分频问题。评分器自动检查数据、脉冲数量、顺序和错误恢复。

| 类别 | 测试内容 | 判定标准 |
|---|---|---|
| 复位与空闲 | 高、低电平下复位，长时间空闲 | 无有效数据；低电平启动必须先恢复 |
| 数据覆盖 | 全部 256 个字节；重点 `00/FF/55/AA/01/80/A5/5A` | 每字节恰有一次正确输出 |
| 连续字节 | 一个停止位后立即发下一字节，长随机序列 | 无丢失、重复或乱序 |
| 空闲间隔 | 随机字节间隔 | 正确接收，不产生额外事件 |
| 异步相位 | 起始沿相对 20 ns 时钟遍历多个相位 | 合法帧均正确接收 |
| 波特率偏差 | 发送端相对标称值 ±1%、±2%，叠加小幅边沿抖动 | 作为拟定的正常接收验收范围 |
| 假起始位 | 短低脉冲，起始中心附近前后翻转 | 中心为高则拒收，无 `valid` |
| 坏停止位 | 停止位中心拉低，覆盖不同数据模式 | 一次错误脉冲，无有效字节 |
| BREAK | 持续低电平多个字节时间 | 不反复报错；恢复高电平后可接收 |
| 中途复位 | 在 START、各数据位、STOP 中复位 | 丢弃当前字节，后续恢复 |
| 数据位毛刺 | 在采样点之外及中心注入毛刺 | 按采样模型检查；不错误宣称能纠正毛刺 |
| 参数与边界 | 默认参数及另一组合法分频参数 | 位索引、终值和计时无越界 |

另外加入：

- 全局 watchdog，超时自动失败。
- `valid`、错误脉冲宽度及互斥检查。
- 坏帧后数据保持、复位后输出无未知态检查。
- 输出时间检查，捕获半位/整位计数偏差。
- 可复现的随机种子和首个失败现场。

包解析器另配自检 TB，覆盖负数、序号回绕、错误包头、单字节损坏、插入/删除字节、各位置截断、超时边界、载荷含包头，以及坏流后紧接完整合法包。

数字仿真不能验证真实亚稳态和电气电平；这些需后续 CDC 检查、实现检查及板测补充。

**5. 第一阶段文件与分步验收**

当前 `rtl`、`stm32`、`host` 等目录没有实现源码，`vivado_project` 也为空。以下是拟定文件，**尚未创建**。

交接目录为 [zynq_vibration_codex_handoff](D:/Code/zynq_vibration_monitor/zynq_vibration_codex_handoff)；表中路径均相对该目录。

| 文件 | 动作 | 职责 |
|---|---|---|
| `docs/hardware_pinmap.md` | 修改 | 修正 U18，记录电源、连接路径、跳线及待测项 |
| `constr/top_candidate.xdc` | 修改 | 修正时钟引脚，后续补精确 CDC 约束 |
| `docs/project_context.md` | 修改 | 经确认后冻结包格式及超时、恢复语义 |
| `docs/uart_rx_design.md` | 新建 | 保存接口、FSM、寄存器和周期定义 |
| `docs/test_plan.md` | 新建 | 保存用例、验收标准及板测步骤 |
| `rtl/uart_rx.v` | 新建 | 字节接收、同步、停止位检查与恢复 |
| `sim/tb/tb_uart_rx.v` | 新建 | UART RX 自检 |
| `rtl/packet_parser.v` | 新建 | 滑动窗口、XOR、超时、原子更新三轴数据 |
| `sim/tb/tb_packet_parser.v` | 新建 | 包解析错误与恢复自检 |
| `rtl/uart_tx.v` | 新建 | 向 PC 发送 8N1 字节 |
| `sim/tb/tb_uart_tx.v` | 新建 | TX 数据、位宽、忙状态及连续发送自检 |
| `rtl/power_on_reset.v` | 新建 | 明确的 PL 上电复位 |
| `sim/tb/tb_power_on_reset.v` | 新建 | 复位持续时间与释放检查 |
| `rtl/top.v` | 新建 | 串接接收、解析、ACK及后续整包回传 |
| `sim/tb/tb_top.v` | 新建 | 端到端串行输入与输出自检 |
| `sim/run_xsim.tcl` | 新建 | 可复现地运行仿真 |
| `stm32/app/main.c` | 新建 | 采样调度、序号及发包流程 |
| `stm32/bsp/bsp_i2c1.c/.h` | 新建 | 标准库 I2C 通信及超时 |
| `stm32/bsp/bsp_mpu6050.c/.h` | 新建 | 初始化、WHO_AM_I、连续读取六字节 |
| `stm32/bsp/bsp_usart1.c/.h` | 新建 | 标准库 USART1 配置及二进制发送 |
| `host/check_stream.py` | 新建 | PC 接收、校验、序号检查和原始日志 |
| `README.md`、`docs/next_task.md` | 修改 | 更新运行入口与下一步 |
| `report/ai_devlog.md` | 修改 | 记录采用的设计、纠错与实际验证证据 |

STM32 的 Keil 工程及启动文件需根据实际板卡工程模板纳入，现有资料不足以确认其配置。

在 [vivado_project](D:/Code/zynq_vibration_monitor/vivado_project) 下拟创建 `create_project.tcl`，引用交接目录的源码与约束，避免维护两份源码。完整 FPGA part 必须确认后填写。

建议分四个小步骤实施：

1. **UART RX 独立实现**：完成设计文档、RX 和自检 TB，全部指定用例通过。
2. **包解析**：冻结协议后实现解析器，验证损坏、截断和重新同步。
3. **PL 回传链路**：先验证 ACK，再验证整包回传；完成综合、实现、时序和 DRC 检查。
4. **STM32 与板测**：先发送已知测试包，再接传感器；核实电压、跳线、时钟和真实波特率，保存 PC 日志。

我会等待你确认上述方案后，再开始修改文档、约束和编写第一步 UART RX RTL。

## 交互 01a17b63-8c4f-71f2-9954-e7762435bbce

### 用户

请先不要进行编写，不要修改和创建任何文件，先确定你完全理解了之前的内容以及这个项目。然后先为我进行项目的分期规划，每一个阶段完成哪些模块，每一个阶段完成需要使用仿真进行哪些检查。需要在一周内完成这些内容。

### 助手

我理解了目前的项目状态。本轮只在对话中规划，**不编写代码，不修改或创建任何文件**。

你的项目目标是：MPU6050 采集三轴加速度，STM32 使用标准库完成 I2C 读取和 UART 发包；Zynq-7010 第一阶段仅使用 PL，完成接收、解析、数字处理和向 PC 回传。你目前熟悉 Verilog、Testbench 和 STM32，计划应优先采用能独立仿真的小模块。

目前工程仍处于交接与设计阶段，没有已验证的 RTL、仿真或板测结果。上一轮已从所提供原理图确认：**时钟约束中的 U13 应改为 U18；UART RX 为 K14，TX 为 M15**。实际板卡版本、电压和跳线仍需实物确认。10 字节包格式仍是草案，尚未冻结。

下面按 **7 天完成最小可演示系统**安排。如果从今天开始，对应 **10 月 27 日—11 月 2 日**。核心目标是完成通信闭环，再加入一版 FIR、窗口均方值/峰值和报警；FFT、PS 开发和复杂故障分类不纳入这一周。

**1. 分期与每日安排**

| 阶段 | 时间 | 完成模块与工作 | 必须进行的仿真检查 | 阶段完成条件 |
|---|---|---|---|---|
| 一：冻结接口，完成字节接收 | 第 1 天 | 确认 UART 接口、复位、计时及恢复规则；实现 `uart_rx` 和自检 TB；经确认后纠正约束 | 全部 256 字节；连续字节；异步起始相位；±2% 波特率偏差；假起始位；坏停止位；长低电平；中途复位及恢复 | 无丢字节、重复输出；错误脉冲和恢复行为符合约定 |
| 二：完成协议与发送模块 | 第 2 天 | 冻结 10 字节协议；实现 `packet_parser`、`uart_tx`，分别配自检 TB | 包头搜索；大小端与负数；XOR；序号回绕；插入、删除、截断；超时；载荷含包头；损坏后重新同步；TX 位宽及忙状态 | 合法包原子更新三轴数据；指定错误案例可恢复；TX 输出符合 8N1 |
| 三：打通原始数据闭环 | 第 3 天 | 实现 PL 上电复位、顶层和回传控制；STM32 完成传感器读取及发包；PC 接收日志 | 串行输入→解析→回传端到端自检；连续包；复位；输入错误；发送忙时的新包处理 | 先用 STM32 固定测试包验证，再取得真实传感器原始数据日志 |
| 四：完成一版定点 FIR | 第 4 天 | 明确目标频段，确定系数与定点格式；实现一版 FIR；使用数据有效使能驱动 | 冲激、阶跃、直流、不同频率正弦；正负极值；舍入、饱和、累加溢出；不连续有效输入；与独立参考模型逐样本比较 | 位精确比较通过，延迟、吞吐及数值范围明确 |
| 五：完成特征与报警 | 第 5 天 | 实现去直流/重力分量处理、窗口均方值、峰值和阈值报警；接入 FIR | 恒定输入的去直流效果；窗口边界；平方与累加位宽；峰值；阈值上下及相等；复位和首个窗口 | 正确输出完整窗口特征；报警行为明确；不把均方值直接称为 RMS |
| 六：系统联调与量化 | 第 6 天 | 集成完整链路；增加原始/滤波数据选择；保存资源、时序和实测记录 | 250 包/s 长序列；丢包、坏包、超时后恢复；三轴隔离；处理延迟；输出堵塞；复位清除全部历史状态 | 仿真与板测均能重复演示；取得资源、时序及滤波效果数据 |
| 七：回归、修复与交付 | 第 7 天 | 修复问题，冻结版本，整理操作说明、波形、日志和 AI 开发记录 | 运行全部自检 TB；重跑失败案例；最终源码重新综合、实现并检查时序与 DRC | 从干净启动可重复运行，演示步骤与证据完整 |

这不是要求每天一次性写完多个模块。每个阶段内部仍按“**单模块设计 → 自检仿真 → 集成**”推进。

**2. 模块边界与实现顺序**

建议系统保持以下层次，便于你理解和定位问题：

```text
STM32：
I2C驱动 → MPU6050驱动 → 采样调度 → 数据打包 → USART1发送

FPGA PL：
UART RX → 包解析 → 三轴样本寄存器
                      ↓
              去直流 → FIR
                      ↓
              窗口均方值 / 峰值 → 阈值报警
                      ↓
                回传控制 → UART TX → PC
```

这里有三个需要提前明确的设计原则：

- **UART 按字节工作，解析器按数据包工作，滤波器按有效样本工作。** 不将串口位计时与滤波采样混在一起。
- 后续处理必须由 `sample_valid` 驱动。目标 250 Hz 不代表每经过固定数量的 PL 时钟就必定有一个新样本。
- 三轴分别保存滤波和特征历史。可以复用运算单元，但不能共用一套历史数据。

一周内建议先实现一版 **16 抽头 FIR**，作为可调整的工作起点。具体截止频率、系数和去直流方法，应根据实际采样率、演示振动频率确定，现阶段不直接给定。

**3. 仿真应分三层，不能只看波形**

| 验证层次 | 检查对象 | 主要目的 |
|---|---|---|
| 模块自检 | RX、TX、解析器、复位、去直流、FIR、特征、报警 | 确认模块接口、数值与边界行为正确 |
| 子系统自检 | RX＋解析器；数据处理链；回传控制＋TX | 确认有效脉冲、延迟、忙状态和数据衔接正确 |
| 系统自检 | UART 串行输入到 UART 串行输出 | 确认完整工作负载、错误恢复和最终输出正确 |

每个 TB 都应自动比较结果、统计失败并设置超时退出。**波形用于定位错误，自检结果用于判断通过。**

DSP 参考模型需同时承担两种检查：

- 浮点结果：检查滤波频响和算法效果。
- 定点结果：检查 RTL 的量化、舍入、饱和和逐样本输出。

对于随机测试，保存种子；对于失败测试，保存输入和预期输出，使问题可以重现。

**4. 仿真之外必须安排的检查**

这些工作不能被 Testbench 替代，建议尽早进行：

| 时间 | 检查 | 原因 |
|---|---|---|
| 第 1 天 | 实物版本、芯片型号、电压、J3 脚号和 P1 跳线 | 避免后续软件正确但接线不成立 |
| 第 1～2 天 | 确认 Vivado、仿真器及 Keil 可用 | 避免到联调时才发现工具缺失 |
| 第 3 天 | 观察实际 UART 波形，测量位宽；验证固定包 | 区分串口电气、波特率和协议错误 |
| 第 3 天 | WHO_AM_I、静止重力方向、三轴正负变化和采样间隔 | 验证传感器链路及样本来源 |
| 第 6～7 天 | 综合、实现、时序、DRC、CDC 与资源报告 | RTL 仿真通过不代表可以可靠上板 |

资源量化至少记录：通信基线与加入 DSP 后的 LUT、FF、DSP、BRAM，以及处理延迟和时序裕量。第二种 FIR 架构对比可作为完成核心任务后的加分项，避免它挤占联调时间。

**5. 一周期限下的取舍与检查点**

最关键的检查点是 **第 3 天结束前，必须打通原始数据闭环**。如果到时仍未完成，优先保留第 6、7 天的联调和修复时间，缩减 DSP 范围。

优先级建议为：

1. **必须完成：** UART、包解析及恢复、STM32 采集、PC 日志、原始数据闭环。
2. **竞赛演示目标：** 一版 FIR、去直流、均方值/峰值、简单阈值报警，以及资源和效果记录。
3. **有余力再做：** 第二种 FIR 架构、复杂上位机界面、更多参数配置。

这一周应优先保证一个能够重复演示、具有自检和实测证据的系统。当前继续停留在规划阶段，等待你确认范围和分期后再进入实现。

## 交互 01a17b6f-9025-7ab3-b153-12036cf2cd75

### 用户

你一共规划了七个阶段。请现在先完成第一阶段的任务。并告诉我做了哪些修改，这些修改有什么用。最后告诉我要做哪些测试，如何使用modelsim和vivado对这些测试项目进行测试

### 助手（进度）

我会先检查当前工程和指令，再完成第一阶段：UART RX、自检 Testbench、相关设计说明，以及已确认的时钟约束纠正。完成后会列出修改用途、实际验证结果，并给出 ModelSim 和 Vivado 的测试步骤。

### 助手（进度）

当前工程已把交接目录的内容移到了仓库根目录，我会按现在的目录结构修改。已找到 ModelSim 2020.4；它在沙箱中启动异常，但在沙箱外可以查询版本。接下来会用它运行自检，同时检查本机 Vivado 的可用性。

### 助手（进度）

第一阶段采用已讨论的五状态接收器：两级同步、半位确认起始位、逐位中心采样，以及停止位错误后的高电平恢复等待。自检会覆盖全部 256 个字节、连续发送、波特率偏差和异常恢复；另加一组奇数分频参数，检查计数边界。已找到 Vivado 2020.2，正在准备两个仿真器共用的测试入口。

### 助手（进度）

首轮 ModelSim 自检已通过：两组参数共接收 1,398 个预期字节，8 次停止位错误均按预期报告，错误数为 0。XSim 已完成编译，但运行脚本遇到了 Windows 路径转义问题；我正在修正。随后会重跑两套测试，并把操作步骤和结果写入文档。

### 助手（进度）

ModelSim 和 Vivado XSim 都已通过最终 RTL 的自检：各接收 1,398 个预期字节，8 次预期错误，测试错误数为 0。文档正在补齐图形界面操作、波形观察点和待实物确认的项目。当前交付仍是独立 UART RX，没有板级顶层，因此还不能据此生成可用的上板系统。

### 助手（进度）

首次 ModelSim 脚本调试曾在 `D:\build\modelsim_uart_rx` 留下少量临时文件；路径问题已修正，后续输出均在工程内。

自动审批拒绝了清理操作，理由是项目禁止未经批准的删除命令。我会保留这些文件，不绕过限制；它们不影响工程和测试结果。

### 助手

第一阶段的 **UART RX、自动自检和操作文档已完成**，并已在 **ModelSim 2020.4 和 Vivado XSim 2020.2** 中实际运行通过。

当前完成的是独立接收模块；板卡电压、跳线等仍需实物检查。本轮没有综合、实现或烧录，也没有进入包解析和 UART TX 阶段。

**1. 修改了什么，有什么用**

| 文件 | 修改及用途 |
|---|---|
| [uart_rx.v](D:/Code/zynq_vibration_monitor/rtl/uart_rx.v) | 新增接收器：默认 50 MHz、115200、8N1；包括两级同步、中心采样、停止位检查和错误恢复 |
| [tb_uart_rx.v](D:/Code/zynq_vibration_monitor/sim/tb/tb_uart_rx.v) | 新增自检 TB，自动检查接收数据、事件脉冲、计时及异常恢复，不需要人工逐个看波形判定 |
| [run_uart_rx.ps1](D:/Code/zynq_vibration_monitor/sim/run_uart_rx.ps1) | 新增一键运行入口，调用两个仿真器并检查退出码和本次结果，避免旧结果造成“假通过” |
| [ModelSim 脚本目录](D:/Code/zynq_vibration_monitor/sim/modelsim)及 [XSim 脚本](D:/Code/zynq_vibration_monitor/sim/xsim/run_uart_rx.tcl) | 提供编译、运行、结果检查及波形观察入口 |
| [设计说明](D:/Code/zynq_vibration_monitor/docs/uart_rx_design.md) | 明确接口、寄存器、五状态 FSM、采样周期和使用限制 |
| [测试操作指南](D:/Code/zynq_vibration_monitor/docs/stage1_test_guide.md) | 提供中文测试清单、ModelSim/Vivado 命令及 GUI 操作步骤 |
| [候选 XDC](D:/Code/zynq_vibration_monitor/constr/top_candidate.xdc)、[引脚文档](D:/Code/zynq_vibration_monitor/docs/hardware_pinmap.md) | 将错误的时钟引脚 U13 改为 **U18**，补充连接路径和待实测事项 |

时钟纠正依据是核心板原理图第 3 页：:codex-file-citation{path="D:/Code/zynq_vibration_monitor/docs/hardware/zynq_core_2v5.pdf" purpose="source"}。

另外更新了 README、项目状态、下一步任务及 AI 开发日志。完整 **15 个文件的修改清单**见 [验证报告](D:/Code/zynq_vibration_monitor/report/stage1_validation.md)。

接收器输出含义：

- `data_o`：最近一个合法字节。
- `valid_o`：合法字节完成时拉高一个时钟周期。
- `framing_error_o`：停止位错误时拉高一个周期，不提交错误字节。
- `busy_o`：正在接收。
- `rst`：高有效同步复位，使用前必须执行。

**2. 已完成哪些测试**

两套仿真器都得到：

```text
PASS tb_uart_rx: bytes=1398 framing=8 errors=0
```

其中 `framing=8` 是主动注入、正确识别的错误事件；**`errors=0` 才表示测试没有失败**。

测试覆盖：

- 全部 256 种字节、连续发送、随机数据和间隔。
- 20 个异步起始相位。
- 发送端 ±1%、±2% 波特率偏差及逐位抖动。
- 假起始位、坏停止位、长时间低电平及恢复。
- 接收中途复位、输入低电平时复位。
- 数据毛刺、输出保持、单周期脉冲和精确计时。
- 434 和 33 两种分频，检查计数器边界。

**3. 你如何重新运行测试**

推荐先在 PowerShell 执行：

```powershell
Set-Location D:\Code\zynq_vibration_monitor

# ModelSim
.\sim\run_uart_rx.ps1 -Simulator modelsim

# Vivado 自带的 XSim
.\sim\run_uart_rx.ps1 -Simulator xsim

# 或者一次运行两套
.\sim\run_uart_rx.ps1 -Simulator both
```

脚本已配置本机安装路径。通过时应看到上述 PASS 汇总。日志、结果和波形分别保存在：

- [ModelSim 输出目录](D:/Code/zynq_vibration_monitor/build/modelsim_uart_rx)
- [XSim 输出目录](D:/Code/zynq_vibration_monitor/build/xsim_uart_rx)

**ModelSim 图形界面观察波形：**

1. 编译 `uart_rx.v` 和 `tb_uart_rx.v`。
2. 仿真顶层选择 **`tb_uart_rx`**。
3. 加载 [波形脚本](D:/Code/zynq_vibration_monitor/sim/modelsim/wave_uart_rx.do)。
4. 执行 `run -all`，检查 PASS。
5. 重点观察 `rx_i`、`rx_sync`、`state`、`baud_cnt`、`bit_idx`、`data_o` 和两个事件输出。

**Vivado 图形界面行为仿真：**

1. 新建 RTL Project，将 `uart_rx.v` 添加为 **Design Source**。
2. 将 `tb_uart_rx.v` 添加为 **Simulation Source**。
3. 仿真顶层设为 **`tb_uart_rx`**。
4. 本次**不要添加候选 XDC**，它针对未来板级顶层。
5. 选择 **Run Simulation → Run Behavioral Simulation**。
6. 在仿真 Tcl Console 执行 `run all`，检查 PASS。

完整仿真约 **64.3 ms**，默认运行 1000 ns 不够。两个 GUI 的可复制命令和逐步说明均在 [测试指南](D:/Code/zynq_vibration_monitor/docs/stage1_test_guide.md)。

你还需核对实际板卡版本、完整芯片型号、Bank 电压、50 MHz 输出和 P1 跳线。当前没有板级顶层及回传功能，暂不进行烧录测试。

另：是否允许清理首次脚本调试误生成的 [临时目录](D:/build/modelsim_uart_rx)？其中仅有本次生成的配置、日志和仿真库。

自动审批拒绝了该删除操作，理由是[项目指令](D:/Code/zynq_vibration_monitor/AGENTS.md)要求删除命令获得批准；目录已保留，不影响工程和测试结果。

## 交互 01a17cef-6edc-7fb3-8c13-7b1d22a39283

### 用户

PS D:\Code\zynq_vibration_monitor> .\sim\run_uart_rx.ps1 -Simulator modelsim
.\sim\run_uart_rx.ps1 : 无法加载文件 D:\Code\zynq_vibration_monitor\sim\run_uart_rx.ps1，因为在此系统上禁止运行脚本。有
关详细信息，请参阅 https:/go.microsoft.com/fwlink/?LinkID=135170 中的 about_Execution_Policies。
所在位置 行:1 字符: 1
+ .\sim\run_uart_rx.ps1 -Simulator modelsim
+ ~~~~~~~~~~~~~~~~~~~~~
    + CategoryInfo          : SecurityError: (:) []，PSSecurityException
    + FullyQualifiedErrorId : UnauthorizedAccess

重新运行测试时出现如上报错，请给出原因和解决方案

### 助手（进度）

这个报错发生在脚本启动前，原因是 PowerShell 执行策略拦截了 `.ps1` 文件。我会核对微软文档，给你一个仅对本次运行生效的解决办法。

### 助手

这是 **PowerShell 执行策略禁止运行 `.ps1` 脚本**导致的，测试尚未启动，因此不是 UART RTL 或 ModelSim 的错误。

建议使用**仅本次进程生效**的方式运行。在当前 PowerShell 中执行：

```powershell
Set-Location D:\Code\zynq_vibration_monitor

powershell.exe -NoProfile -ExecutionPolicy Bypass -File ".\sim\run_uart_rx.ps1" -Simulator modelsim
```

其中：

- `-NoProfile`：不加载个人 PowerShell 配置。
- `-ExecutionPolicy Bypass`：允许此次新进程运行脚本。
- 进程退出后失效，**不会永久修改系统或用户执行策略**。[微软说明](https://learn.microsoft.com/en-us/powershell/module/microsoft.powershell.core/about/about_execution_policies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)

运行 Vivado XSim 或两套测试，只需替换最后一个参数：

```powershell
powershell.exe -NoProfile -ExecutionPolicy Bypass -File ".\sim\run_uart_rx.ps1" -Simulator xsim

powershell.exe -NoProfile -ExecutionPolicy Bypass -File ".\sim\run_uart_rx.ps1" -Simulator both
```

成功时应看到：

```text
PASS tb_uart_rx: bytes=1398 framing=8 errors=0
```

如果仍然出现相同的执行策略报错，请执行并发给我结果：

```powershell
Get-ExecutionPolicy -List
```

如果限制来自 `MachinePolicy` 或 `UserPolicy`，说明可能由组策略强制设置，上面的进程级参数无法覆盖，需要进一步确认该策略来源。[策略优先级说明](https://learn.microsoft.com/en-us/powershell/module/microsoft.powershell.core/about/about_execution_policies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)

## 交互 01a17cf5-6e34-7dc0-b3ff-fd05c57c2ffc

### 用户

对你刚才完成的第一阶段的任务。其中的markdown文档以及rtl源码和sim的tb仿真文件中的注释都修改为中文。之后完成任务的时候，这些文档和注释也用中文写出

### 助手（进度）

我会把第一阶段新增或修改的 Markdown 文档，以及 RTL、Testbench 中的注释改成中文，保留代码标识符、命令和测试行为。同时会将后续使用中文文档和注释的要求写入项目指令。

### 助手（进度）

RTL 和 Testbench 的说明性注释已改为中文，代码逻辑和测试输出保持原样。接下来会翻译设计说明与验证记录，保留可复制的命令和真实日志，并检查中文编码是否影响工具读取。

### 助手

已完成：

- 第一阶段 Markdown 文档已改为中文。
- [RTL](D:/Code/zynq_vibration_monitor/rtl/uart_rx.v)、[Testbench](D:/Code/zynq_vibration_monitor/sim/tb/tb_uart_rx.v) 及仿真脚本、XDC 的说明性注释已改为中文。
- 已将后续文档和注释使用中文的要求写入 [AGENTS.md](D:/Code/zynq_vibration_monitor/AGENTS.md)，以后按此执行。
- [测试指南](D:/Code/zynq_vibration_monitor/docs/stage1_test_guide.md) 已补充你遇到的 PowerShell 执行策略问题及启动命令。

检查确认：非注释代码、标识符和日志字符串未变；ModelSim、XSim 重新编译通过。本轮未重跑完整仿真。

## 交互 01a17d06-ed5f-75c0-8a2b-a24124913315

### 用户

第一阶段的成果是否可以，也是否需要进行上板测试？如果可以，应该要能看到哪些现象才能说明程序在板上正常运行？

### 助手（进度）

我先核对当前接收器接口、约束和测试记录，再区分“现阶段能否直接上板”与“补充测试顶层后应观察什么现象”。

### 助手

**可以做上板测试，也需要最终做，但当前第一阶段成果还不能直接作为完整板级工程烧录。**

`uart_rx.v` 是可综合模块，目前缺少板级测试顶层、可靠复位和接收结果的观察通道。现阶段完成的是“模块设计与仿真验证”；上板验证建议在进入 FIR 前完成，可以与第二阶段后的通信闭环测试合并进行。

**1. 现在上板还需要补什么**

最小测试系统可以是：

```text
PC 串口助手 → USB串口发送端 → FPGA UART RX
                                    ↓
                         接收计数、最后字节、错误计数
                                    ↓
                            Vivado ILA 观察
```

需要补充：

- **测试顶层**：实例化 UART RX，连接板上时钟和接收引脚。
- **复位逻辑**：保证配置完成后执行有效复位。
- **观察寄存器**：保存接收字节数、最近字节、停止位错误次数。
- **ILA 调试核**：通过 JTAG 在 Vivado 中观察这些寄存器和接收信号。
- **板级约束与实现检查**：核实实际器件、引脚、电压，完成综合、实现、时序和 DRC 检查。

ILA 可以捕获 FPGA 内部信号及触发事件，适合验证当前只有 RX、没有 TX 的阶段，无需学习 PS。[AMD ILA 说明](https://docs.amd.com/r/2020.2-English/ug908-vivado-programming-debugging/ILA?contentId=9umeCeAmOLwuXB5kgc8cjw)

**2. 应看到哪些现象**

建议按以下顺序验收。表中的计数器属于需要新增的测试顶层，当前尚未实现。

| 测试 | 操作 | 正常现象 |
|---|---|---|
| 启动与复位 | 配置 FPGA，执行复位 | 接收计数、错误计数清零；没有伪接收事件 |
| 空闲 | 保持发送端空闲 | `valid_o=0`，错误计数不增加 |
| 单字节 | 以十六进制发送 `55` | 最近字节变为 `55`，接收计数增加 1，出现一个有效脉冲 |
| 不同位模式 | 发送 `00 FF 55 AA A5 5A 01 80` | 按顺序接收，计数增加 8，错误计数不增加 |
| 连续发送 | 连续发送大量已知字节 | 接收数量与发送数量一致，数据顺序正确 |
| 再次复位 | 接收若干字节后复位 | 状态与计数恢复初始值，之后仍可正常接收 |
| 错误与恢复 | 用支持 BREAK 的发送端保持线路低，再恢复高并发送合法字节 | 长低电平产生一次停止位错误，不反复计数；恢复后可接收合法字节 |

串口助手设置为 **115200、8 数据位、无校验、1 停止位、无流控**。发送测试字节时选 **HEX/十六进制发送**，关闭自动附加回车换行。

例如，HEX 模式发送 `55` 是一个字节 `0x55`；文本模式发送字符串 `55` 则是两个 `0x35`，两者的计数和数据不同。

**3. ILA 波形中怎样判断正确**

主要观察：

- `rx_sync`：同步后的串行输入。
- `data_o`、`valid_o`：实际接收到什么、何时接收完成。
- `framing_error_o`：停止位错误事件。
- 接收计数、错误计数。
- 必要时观察 `state`、`baud_cnt`、`bit_idx`。

对于一个正常字节，应看到：

1. 起始位后进入接收状态。
2. 数据位按低位到高位采样。
3. 停止位确认后，`data_o` 为预期值。
4. `valid_o` 只持续一个时钟周期，50 MHz 下为 **20 ns**。
5. 错误计数保持不变。

**连续发送只看“最终计数和最后一个字节”还不够。** 要验证中间数据没有错误，应通过 ILA 抽查，或在测试顶层增加递增序列检查器，统计数据不匹配次数。

**4. LED 和串口窗口能说明什么**

LED 可以作为辅助提示，例如：

- 心跳灯闪烁：说明相关时钟和计数逻辑在运行。
- 每收到字节翻转或点亮约 100 ms：说明发生了接收事件。
- 错误灯锁存点亮：说明检测到停止位错误。

但不能将 `valid_o` 直接接 LED 后期待看见闪烁，它只有 20 ns；LED 也不能证明收到的字节值正确。

另外，**目前只有接收模块，PC 串口助手的接收窗口没有回显是正常的**。要看到 FPGA 返回字符，还需实现 UART TX。

我的建议是：保留当前第一阶段的仿真成果，下一步先补一个“**RX＋观察寄存器＋ILA**”的小测试顶层进行硬件验证。首次测试用 PC 发送已知字节，验证接收链路后，再接 STM32 和 MPU6050。接线前仍需完成[引脚文档](D:/Code/zynq_vibration_monitor/docs/hardware_pinmap.md)中的电压、板卡版本和跳线检查。

本轮没有修改文件，上述板级测试顶层尚未实现。

## 交互 01a17d18-5696-7f41-9184-2655ef2d0dc1

### 用户

暂时不进行上板测试。第一阶段暂时完成。先继续完成你之前规划的第二阶段的任务。

### 助手（进度）

我会先检查第一阶段后的工程状态，再完成第二阶段：包解析器、UART TX、各自的自检 Testbench 和中文文档。

第二阶段需要冻结协议。我会先整理待确认的规则；等待确认期间，可以独立推进 UART TX。

### 助手（进度）

现有协议的 10 字节布局、大小端和 XOR 校验保持不变。第二阶段将按此前方案补齐这些规则：字节间隔达到 2 ms 时丢弃未完成窗口；UART 停止位错误时清空窗口；滑动搜索包头；合法包一次性更新三轴数据。序号按模 256 检查连续性，跳号或重复只作诊断，不拒收合法包。

UART TX 使用 `valid/ready` 握手，完整发送 8N1 后报告完成，并支持连续字节。测试将分别检查两模块，再验证 TX→RX→解析器的仿真链路。本轮不增加板级顶层，也不进行上板操作。

### 助手（进度）

两个模块及三套自检已写好，开始运行 ModelSim。

重点检查三处边界：超时同拍到达的字节不能拼接旧包；TX 连续发送必须保留完整停止位；坏包不能覆盖最近一次合法的三轴输出。第一阶段的 RX 源码和自检文件保持不变。

### 助手（进度）

ModelSim 三套自检已通过：

- 解析器接收了 118 个预期合法包，错误与恢复检查通过。
- TX 两组参数共完成 666 帧，20 帧由复位按预期终止。
- TX→RX→解析器链路传输 103 个字节，得到 8 个预期合法包，并通过了校验错误、2 ms 超时和 BREAK 后恢复检查。

初次运行发现 TB 把“只剩一个 A5”的截断也计为校验错误；它尚未形成完整包头，已纠正这一期望计数。XSim 交叉验证正在运行。

### 助手（进度）

XSim 的三套自检也全部通过，结果与 ModelSim 一致，六次运行的测试失败数均为 0。

我正在补齐中文验证记录和复现命令。入口会使用你此前可用的单进程执行策略方式；后续结果统一保存在工程 `build` 目录。按你的要求，本轮没有进行综合、实现或上板测试。

### 助手

第二阶段已完成，**ModelSim 2020.4 和 Vivado XSim 2020.2 的三套自检均实际运行通过**。按你的要求，没有进行上板测试。

本轮新增的主要内容：

| 文件 | 用途 |
|---|---|
| [packet_parser.v](D:/Code/zynq_vibration_monitor/rtl/packet_parser.v) | 解析十字节包，完成 XOR 校验、三轴原子更新、超时清除和损坏后的重新同步 |
| [uart_tx.v](D:/Code/zynq_vibration_monitor/rtl/uart_tx.v) | 通过 `valid/ready` 握手发送 8N1 字节，支持连续发送和复位终止 |
| [第二阶段测试入口](D:/Code/zynq_vibration_monitor/sim/run_stage2.ps1) | 自动运行解析器、TX 和 TX→RX→解析器链路测试 |
| [设计说明](D:/Code/zynq_vibration_monitor/docs/stage2_design.md) | 说明接口、状态机、周期时序和协议规则 |

现有十字节布局保持不变。本次明确了默认 **2 ms 字节超时**；错误包不覆盖最近合法数据；序号跳号或重复只报告诊断，仍接收校验正确的包。第一阶段 RX 源码及其自检文件保持不变。

每个仿真器的结果如下：

| 测试 | 结果 |
|---|---|
| 包解析器 | 118 个预期合法包；损坏、插入、删除、截断、超时边界和恢复检查通过 |
| UART TX | 两组参数共完成 666 帧，另有 20 帧由复位按预期终止 |
| 串行模块链路 | 103 字节、8 个合法包；校验错误、2 ms 超时、BREAK 和复位恢复检查通过 |

**六次最终运行的测试失败数均为 0。** 详细证据及完整修改清单见[验证报告](D:/Code/zynq_vibration_monitor/report/stage2_validation.md)。

你可以这样重新运行：

```powershell
Set-Location D:\Code\zynq_vibration_monitor
powershell.exe -NoProfile -ExecutionPolicy Bypass -File .\sim\run_stage2.ps1 -Simulator both
```

只运行某项时，在末尾添加 `-Test packet_parser`、`-Test uart_tx` 或 `-Test uart_packet_link`。

中文的 ModelSim、Vivado 图形界面步骤和波形观察说明见[第二阶段测试指南](D:/Code/zynq_vibration_monitor/docs/stage2_test_guide.md)。当前尚未进行综合、实现，也尚未增加板级顶层、STM32 固件或 PC 回传控制。

## 交互 01a17d43-c936-7813-ac6a-888b51805af4

### 用户

本次，即第二阶段的成果是否可以，也是否需要进行上板测试？如果可以，应该要能看到哪些现象才能说明程序在板上正常运行？

### 助手（进度）

我会核对第二阶段的接口和测试范围，说明补齐板级顶层后可以怎样测试，以及哪些现象能证明整包解析和发送正确。本轮只做分析，不修改工程。

### 助手

**第二阶段的模块可以用于上板验证，也需要最终做硬件验证；但当前工程仍缺少板级测试顶层，不能直接把现有仿真工程烧录后期待看到完整功能。**

与第一阶段相比，现在已经具备 RX、包解析器和 TX，补齐少量控制逻辑后，可以验证“PC 发包 → FPGA 解析 → PC 收到结果”的通信闭环。建议在进入 FIR 前完成这项验证，也可以安排在第三阶段统一进行。你此前暂缓上板的决定仍然保持。

**1. 上板前还需要补齐哪些内容**

需要一个小型测试顶层，负责：

- 连接板上时钟，提供可靠的同步复位。
- 连接 RX→包解析器。
- 保存合法包的序号、三轴数据和诊断计数。
- 将保存的数据按字节交给 TX，正确处理 `valid/ready` 握手。
- 处理发送忙时的新包，避免数据被覆盖。
- 完成实际器件、引脚、电压检查，以及综合、实现、时序和 DRC 检查。

可加入 ILA 观察内部信号。它支持在硬件事件上触发并捕获内部数据，适合查看三轴数据和单周期事件。[AMD ILA 说明](https://docs.amd.com/r/2020.2-English/ug908-vivado-programming-debugging/ILA?contentId=9umeCeAmOLwuXB5kgc8cjw)

这些板级控制逻辑目前尚未实现。

**2. 最推荐的测试方式**

先用 PC 发送已知数据，不接 MPU6050：

```text
PC HEX发包 → USB串口 → FPGA RX → 包解析
                                     ↓
                             保存合法三轴数据
                                     ↓
PC HEX收包 ← USB串口 ← FPGA TX ← 回传控制
```

回传控制应当**只在包解析成功后，将保存的数据重新组包发送**。这样才能验证解析器；简单地逐字节回显不能证明包头、校验和三轴解析正确。

串口设置采用 **115200、8N1、无流控、HEX 收发**，关闭自动附加回车换行。首次测试可每隔 100 ms 发送一包，先确认功能，再增加发送速率。

**3. 应看到哪些正常现象**

先发送这个合法包：

```text
A5 5A 01 00 01 FF FF 80 00 80
```

应得到：

| 项目 | 预期结果 |
|---|---|
| 序号 | `01` |
| X | `1` |
| Y | `-1` |
| Z | `-32768` |
| 整包有效事件 | 恰好一次 |
| 校验错误、超时、序号错误 | 复位后首次接收此包时均不增加 |
| 回传 | 若采用上述整包回传方案，应收到同一组序号及三轴数据 |

这里需要纠正我最早分析中的一个笔误：**这个组合的 CHK 应为 `80`，此前写成 `81` 是我计算错误。** 当前 RTL 和 TB 使用逐字节 XOR 计算。

接下来进行错误与恢复测试：

| 测试 | 操作 | 能说明正常工作的现象 |
|---|---|---|
| 校验错误 | 把上述包最后一个字节改成 `81` | 校验错误事件增加；三轴数据保持；不回传为合法包 |
| 错误包头 | 修改 `A5 5A` 后发送 | 不产生合法包事件；随后发送正确包能恢复 |
| 截断与超时 | 只发送前几字节，等待例如 10 ms | 未完成窗口超时清除；随后完整包正常接收 |
| 正常包间空闲 | 完整合法包后等待较长时间 | 不产生超时事件，因为合法包后窗口已清空 |
| 序号连续 | 发送校验正确的连续序号 | 每包接收一次，序号错误计数不增加 |
| 序号跳号或重复 | 发送对应校验正确的包 | 仍接收并更新数据，同时报告序号不连续 |
| 复位恢复 | 接收部分包后复位，再发完整包 | 不提交旧的半包；复位后首个合法包重新建立序号基准 |
| 连续负载 | 连续发送大量已知包并统计 | 收发包数、顺序、序号和三轴数值一致，无非预期诊断 |

超时测试的 10 ms 是为了留出操作和系统调度余量。**精确的 2 ms 边界应通过 ILA、逻辑分析仪或可控发送源观察，普通串口助手不适合逐拍验证。**

**4. ILA 中还应看到什么**

重点观察：

- `frame_valid_o`：每个合法包一拍，50 MHz 下为 **20 ns**。
- `seq_o、x_o、y_o、z_o`：只有整包成功后同时更新。
- `checksum_error_o、timeout_o、seq_error_o`：与注入条件一致。
- TX 的 `valid_i、ready_o、done_o`：每次握手发送一个字节，完整发送后产生完成事件。

对于当前 TX，在确认输入时钟为 50 MHz 后，串行输出应为：

- 空闲高电平。
- 每位约 **8.68 μs**。
- 起始位低，D0～D7 低位先发，停止位高。
- 一个完整 8N1 字节约 **86.8 μs**。

**LED 闪烁只能辅助证明存在活动。更有说服力的验收证据是：合法包正确解析、坏包不提交、异常后恢复，以及连续发送时数据与数量一致。**

本轮没有修改文件或进行上板操作。当前已完成的是第二阶段的模块与仿真验证，上述板级顶层和回传控制可在第三阶段补齐。

## 交互 01a17d45-f5c0-7c73-b2a1-1860d968a41f

### 用户

暂时不进行上板测试。第二阶段暂时完成。先继续完成你之前规划的第三阶段的任务。

### 助手（进度）

我会按第三阶段推进，并继续暂缓上板：先检查现有接口，设计顶层、上电复位、ACK/整包回传和发送忙时的处理，再补齐端到端自检、STM32 标准库采集代码及 PC 日志工具。能在本机验证的部分会实际运行；依赖板卡或 Keil 工程配置的部分会明确标注。

### 助手

STM32 端是否有已经能正常编译的 STM32F103C8T6 Keil 标准库工程？如果有，请给出本机工程目录及系统时钟配置；如果没有，回复“没有”即可。我会先继续完成 FPGA/PC 部分和可移植的 STM32 源码。

### 用户

<send_user_message_question_reply>
[{"questionItemId":"[\"request_user_input_async\",\"call_735d50fdabc54ea7b1e8052b3159d549\",0]","question":"STM32 端是否有已经能正常编译的 STM32F103C8T6 Keil 标准库工程？如果有，请给出本机工程目录及系统时钟配置；如果没有，回复“没有”即可。我会先继续完成 FPGA/PC 部分和可移植的 STM32 源码。","answer":"有，我已经放到当前工程目录的stm32文件夹下了，名叫Libraries。里面有CMSIS和STM32F10X的库"}]
</send_user_message_question_reply>

### 助手（进度）

收到，我会直接检查 `stm32/Libraries` 中的 CMSIS 和标准库版本，再据此编译检查固件接口，避免使用替代库。FPGA 回传部分会采用“当前发送包＋有界等待队列”；队列满时丢弃新包并计数，已开始发送的数据保持不变。

### 助手（进度）

顶层和回传控制已写好，正在准备仿真。整包模式只在解析成功后重新组包；ACK 模式每个被接纳的合法包返回 `06`，两种模式互斥，不改变输入协议。

测试会特别检查满队列时同拍出入队，以及连续 TX 握手后不能把上一字节的 `done` 误当作整包完成。

### 助手（进度）

ModelSim 的复位、回传控制、核心和顶层自检已通过；顶层测试已覆盖 250 包/s 输入，并生成两种回传模式的原始捕获。PC 的七项离线测试也已通过。

首次核心测试因 TB 等待时间只够单字节回传而提前验收，已改为等待完整十字节，数据和计数检查保持不变。接下来会用 PC 工具验收仿真捕获，并编译固定数据源和传感器两种固件配置；这些都不替代真实串口或传感器测试。

### 助手（进度）

XSim 交叉验证发现，TB 最初一组负数激励出现了未知值，导致校验失败；ModelSim 中没有出现这一现象。我已定位到这组激励，会改成显式 16 位计算，并增加发送前的未知值检查，再重跑受影响测试。

这是 TB 的跨仿真器兼容问题，目前不据此判定 RTL 出错。STM32 的编码、采集调度和故障重试代码也已写好，接下来会同时做模拟依赖测试和真实 ARMCC 编译。

### 助手（进度）

收到，你提供的是标准外设库和 CMSIS，尚不是完整的 Keil 应用工程。我会以这些库为基础补齐第三阶段的 STM32 工程。

FPGA 顶层和回传链路已通过 ModelSim、Vivado XSim 仿真，包括连续包、坏包恢复、截断超时，以及 ACK 和整包回传。接下来完成 STM32 编译验证和 PC 日志交叉检查；继续暂缓上板。

### 助手（进度）

PC 工具已成功读取两种仿真器生成的回传数据：整包模式逐项匹配 24 组序号和三轴值，ACK 模式收到 24 个 `06`，两种仿真器的捕获字节一致。

STM32 应用的模拟依赖测试也已通过，覆盖全部 65536 种有符号 16 位编码值、4 ms 调度、发送失败和传感器错误恢复。这些是软件测试结果，真实 I2C 和串口仍待上板验证。

### 助手（进度）

两个 STM32 目标都已用本机 Keil ARMCC 编译、链接通过，均为 0 错误、0 警告：`FixedSource` 发送固定已知数据，`SensorSource` 执行 MPU6050 初始化、数据就绪轮询和六字节采集。

你提供的库文件未被修改。工程使用的“外部 8 MHz、系统 72 MHz”是库中的软件配置，实物晶振尚未确认。我正在整理中文复现步骤和验证记录。

### 助手（进度）

第三阶段的自动检查已全部通过：4 项 FPGA 自检在两种仿真器下通过，7 项 PC 测试通过，STM32 的 C 测试与 Python 交叉解码通过，两个 Keil 目标也已通过一键脚本全量重建。

测试指南将包含 ModelSim 波形查看、Vivado 行为仿真、PC 离线日志检查和 Keil 重建步骤。本轮验证到软件与仿真闭环；真实传感器日志和板级验收继续暂缓。

### 助手

已使用你提供的 `stm32/Libraries`，完成第三阶段的**软件与仿真部分**，继续暂缓上板。

本次完成了：

- **FPGA**：新增上电复位、回传队列、通信核心和 [顶层 top.v](/D:/Code/zynq_vibration_monitor/rtl/top.v)。支持 ACK 或整包回传，并处理发送繁忙、队列满和复位恢复。
- **STM32**：建立 [Keil 工程](/D:/Code/zynq_vibration_monitor/stm32/keil/vibration_monitor.uvprojx)，提供固定数据、MPU6050 采集两个目标，使用标准外设库。你提供的库文件没有修改。
- **PC**：新增协议解析和记录工具，保存原始二进制、三轴 CSV、统计 JSON。
- **文档与测试**：新增中文设计说明、自检 TB、执行脚本及验证记录；输入十字节协议保持不变。

实际验证结果：

| 检查 | 结果 |
|---|---|
| ModelSim、Vivado XSim | 四项新增自检均通过 |
| PC 单元测试 | 7 项通过 |
| 仿真捕获→PC | 每套仿真器整包 24 组、ACK 24 个，内容匹配 |
| STM32 软件测试 | 全部 65536 个补码值编码及错误恢复检查通过 |
| Keil 两个目标全量编译 | 均为 0 错误、0 警告 |

你可以在项目根目录运行：

```powershell
powershell.exe -NoProfile -ExecutionPolicy Bypass -File .\sim\run_stage3.ps1 -Simulator both
powershell.exe -NoProfile -ExecutionPolicy Bypass -File .\stm32\build_keil.ps1
```

详细操作请看 [第三阶段测试指南](/D:/Code/zynq_vibration_monitor/docs/stage3_test_guide.md)，其中包含 ModelSim 波形查看、Vivado 行为仿真、PC 离线检查和 Keil 重建步骤。完整修改清单及实际证据见 [验证记录](/D:/Code/zynq_vibration_monitor/report/stage3_validation.md)。

**尚未进行综合、实现或板测，也没有真实传感器日志。** STM32 实物晶振、I2C 通信和实际采样时序仍待确认；当前未开始第四阶段。

## 交互 01a17d71-bd55-7033-8668-12876a922936

### 用户

本次，即第三阶段的成果是否可以，也是否需要进行上板测试？如果可以，应该要能看到哪些现象才能说明程序在板上正常运行？

### 助手（进度）

我先核对第三阶段的测试说明、顶层配置和 STM32 两种数据源，明确哪些结果可以上板观察，以及哪些条件仍需确认。本轮只说明验收方法，不进行烧录或板测。

### 助手

**第三阶段适合进行上板验证，而且要确认“真实采集与通信闭环正常”，最终需要上板测试。** 目前通过的是仿真、软件测试和编译，尚不能证明实际 I2C、电平、时钟和接线正常。

当前可以保留“暂缓上板”的决定；但第三阶段的实物验收仍应标为待完成。本次没有修改文件或进行烧录。

上板前还需确认完整 FPGA 型号、正式引脚约束、IO 电压与跳线、STM32 晶振配置，并完成 Vivado 综合、实现、时序及 DRC 检查。**现在还不能直接将候选 XDC 当作已经验收的板级约束。**

建议按下面的顺序测试，每一步通过后再进入下一步：

| 步骤 | 配置 | 正常运行应观察到的现象 |
|---|---|---|
| 1. 固定数据＋ACK | STM32 选择 `FixedSource`，FPGA 设置 `ACK_ONLY=1` | PC 持续收到十六进制 `06`，目标约每秒 250 个；停止发送后，待已有数据发完，ACK 停止 |
| 2. 固定数据＋整包 | STM32 保持 `FixedSource`，FPGA 设置 `ACK_ONLY=0`，这是当前默认值 | PC 解码值始终为 **X=1、Y=-1、Z=-32768**；序号按 0…255 循环，校验正确 |
| 3. 真实传感器 | STM32 切换 `SensorSource`，FPGA 保持整包回传 | WHO_AM_I 正确、初始化成功，三轴数据持续更新；静止、翻转、轻微移动时变化合理 |
| 4. 异常与恢复 | 使用可控测试源发送坏校验包、截断包，再发送好包 | 坏包不产生正常响应；后续好包能继续被正确接收和回传，无需重新烧录 |
| 5. 连续运行与重启 | 连续记录，再分别重启 STM32、FPGA | 正常运行期间没有持续误码或停顿；重启后恢复通信，允许出现重启导致的序号重新开始 |

固定数据整包模式最容易判断。预期前两个包为：

```text
A5 5A 00 00 01 FF FF 80 00 81
A5 5A 01 00 01 FF FF 80 00 80
```

它们的三轴相同，序号与校验字节随之变化。**不能只凭“串口有数据”判断通过**：需要同时检查包头、长度、校验、负数解析和序号连续性。

真实传感器模式还应检查：

- 在 Keil 中观察 `g_acquisition`：`who_am_i=0x68`、`online=1`，`samples` 和 `tx_packets` 持续增加。
- 正常连接时，`sensor_errors`、`tx_errors` 不应持续增加。
- 静止时读数允许有偏置和噪声，也会包含重力；翻转方向后，相关轴的重力分量应发生变化。
- 实际输出速率应接近目标 250 组/秒。PC 收到分块的时间不能精确证明传感器每次采样间隔，必要时使用逻辑分析仪检查。

以后进行板测时，可以用现有 PC 工具记录整包：

```powershell
python -m pip install -r host/requirements.txt
python -X utf8 host/capture.py --port COM5 --mode frame --seconds 10 --output build/board_stage3_fixed_01
```

`COM5` 要换成实际串口，输出目录每次使用新名称。稳定运行期间重点检查 `checksum_errors`、`seq_discontinuities`、`duplicates`；记录开始或结束恰好截到半包，需要单独判断。

当前顶层**没有 LED 指示或屏幕显示功能**，主要验收依据是 PC 原始日志、解码结果，以及必要的 Keil/逻辑分析仪观察。ACK 只能初步证明响应链路，固定包整包回传才能检查内容，传感器测试再验证真实采集。

操作与文件说明见 [第三阶段测试指南](/D:/Code/zynq_vibration_monitor/docs/stage3_test_guide.md)。

## 交互 01a18090-06cf-72e0-a93b-9f6cfd54f996

### 用户

# Files mentioned by the user:

## [野火小智]STM32F103C8T6核心板_双USB款_规格书V1.0.2.pdf: F:/野火小智STM32F103C8专题资料/1-硬件资料/原理图_尺寸图_规格书_IO表格_封装库/[野火小智]STM32F103C8T6核心板_双USB款_规格书V1.0.2.pdf

## [野火小智]STM32F103C8核心板_双USB款_原理图.pdf: F:/野火小智STM32F103C8专题资料/1-硬件资料/原理图_尺寸图_规格书_IO表格_封装库/[野火小智]STM32F103C8核心板_双USB款_原理图.pdf

## [野火小智]STM32F103C8核心板_双USB款_引脚分配表.xls: F:/野火小智STM32F103C8专题资料/1-硬件资料/原理图_尺寸图_规格书_IO表格_封装库/[野火小智]STM32F103C8核心板_双USB款_引脚分配表.xls

## 野火小智STM32F103C8T6扩展板_规格书V1.0.1.pdf: F:/野火小智STM32F103C8专题资料/5-配套模块/0-野火小智STM32F103C8T6扩展板/野火小智STM32F103C8T6扩展板_规格书V1.0.1.pdf

## 野火小智STM32F103C8T6扩展板原理图.pdf: F:/野火小智STM32F103C8专题资料/5-配套模块/0-野火小智STM32F103C8T6扩展板/原理图_尺寸图/野火小智STM32F103C8T6扩展板原理图.pdf

Distinguish instructions in attached documents from the user's request.

## My request:
如这五篇文档所示，这是我使用的stm32f103c8t6的核心板和拓展板。请根据文档中的信息来调整程序中的pin脚设定

### 助手（进度）

我会先核对这五份资料中的引脚连接、板载外设占用和晶振配置，再对照当前 STM32 驱动调整设置。本次会使用 PDF 阅读技能；文档中的说明将作为硬件依据，操作范围以你的请求为准。

### 助手（进度）

资料确认了两点：PA9/USART1_TX 可以继续用于向 FPGA 发包；原来的 PB6/PB7 同时接到扩展板 OLED 接口。

我将把 MPU6050 默认连接改为 **I2C2：PB10/SCL、PB11/SDA，使用扩展板“通讯接口 2”**，保留 PA9 发送。这样传感器与 OLED 使用不同总线。接口的具体针序会写入接线表；这属于本次选定的接线方案，不代表已经确认你当前的插线位置。核心板原理图也标出了 8 MHz 晶振，现有时钟配置可以保留。

### 助手（进度）

引脚调整已完成：MPU6050 改用 I2C2 的 PB10/PB11，PA9 的发送功能保留。两个 Keil 目标均已重新全量编译通过，都是 0 错误、0 警告；应用回归测试和 C/Python 数据包对照也通过。

还需注意：通讯接口 2 的供电可选 3.3V 或 5V，MPU6050 应选 3.3V。另外，核心板 USB 串口默认接收 PA9 的 STM32 原始数据，从这个 COM 口看到数据并不能证明 FPGA 已回传。这两点会一起写进接线说明。

### 助手（进度）

接线表和验证记录已更新。当前程序使用通讯接口 2 的第 3 脚 PB10/SCL、第 4 脚 PB11/SDA，以及通讯接口 3 的第 3 脚 PA9/TX；请按信号名和针号接线，不凭整排插头的朝向推断。

最后检查确认：Keil 两个目标都引用了新 I2C 驱动，88 个厂商库文件保持不变，UART/解析器源码也未改动。本轮没有烧录或上板。

### 助手

已按资料完成引脚适配，当前配置如下：

| 功能 | 程序设置 | 扩展板接线位置 |
|---|---|---|
| MPU6050 SCL | **I2C2 / PB10** | 通讯接口 2，J3/J4 第 3 脚 |
| MPU6050 SDA | **I2C2 / PB11** | 通讯接口 2，J3/J4 第 4 脚 |
| MPU6050 GND | GND | 通讯接口 2，第 5 脚 |
| MPU6050 3V3 | VCC4，选为 **3.3V** | 通讯接口 2，第 6 脚 |
| 发往 FPGA 的 TX | **USART1 / PA9**，保持不变 | 通讯接口 3，J9/J10 第 3 脚 |

传感器从 PB6/PB7 改到 PB10/PB11，使它与 OLED 使用不同总线。PB6/PB7 原方案也可以共享总线，本次选择独立 I2C2，便于后续调试。

主要修改：

- 新增 [board_pinmap.h](/D:/Code/zynq_vibration_monitor/stm32/config/board_pinmap.h)，集中管理引脚和外设时钟。
- 将驱动改名为 [bsp_i2c.c](/D:/Code/zynq_vibration_monitor/stm32/bsp/bsp_i2c.c)，同步更新初始化、收发、错误恢复、调用处和两个 Keil 目标。
- 保留 PA9 发送、现有十字节协议及 8 MHz 外部晶振配置。原理图已确认晶振标称值，实际频率尚未测量。

**接线时注意：通讯接口 2 的 VCC4 不是固定 3.3V。** 图纸显示 J32 的 2—3 接通选择 3.3V；仍需核对实物针号和电压。核心板 USB 串口默认看到 PA9 的 STM32 原始包，不能据此判断 FPGA 回传正常。

两个 Keil 目标已全量重建，均为 **0 错误、0 警告**；应用回归及 32 包 C/Python 对照通过。厂商库未改，本轮未烧录、未上板。

完整依据、修改清单和测试命令见 [引脚核查记录](/D:/Code/zynq_vibration_monitor/docs/stm32_board_review.md)。

核查来源：
:codex-file-citation{path="F:/野火小智STM32F103C8专题资料/1-硬件资料/原理图_尺寸图_规格书_IO表格_封装库/[野火小智]STM32F103C8核心板_双USB款_原理图.pdf" purpose="source"}
:codex-file-citation{path="F:/野火小智STM32F103C8专题资料/5-配套模块/0-野火小智STM32F103C8T6扩展板/原理图_尺寸图/野火小智STM32F103C8T6扩展板原理图.pdf" purpose="source"}
:codex-file-citation{path="F:/野火小智STM32F103C8专题资料/1-硬件资料/原理图_尺寸图_规格书_IO表格_封装库/[野火小智]STM32F103C8核心板_双USB款_引脚分配表.xls" purpose="source"}

## 交互 01a180a6-fc48-7951-b252-e7ba70fbac7b

### 用户

fpga的引脚资料在项目开始之前你应该收到了。fpga的引脚安排是在第七阶段，也就是项目软件部分编写结束后安排还是现在就可以安排

### 助手

**FPGA 引脚现在就可以安排，不必等到第七阶段。** 项目开始时你提供的 FPGA 原理图已经收到，前面也据此建立了 [候选 XDC](/D:/Code/zynq_vibration_monitor/constr/top_candidate.xdc)，不需要重新提供同一份资料。

可以把工作分成两部分：

| 时间 | 应完成的工作 |
|---|---|
| **现在，第三阶段** | 确定时钟、UART RX/TX 的物理引脚，核对顶层端口与 XDC，设置时钟和 IO 标准；确认器件型号后，可以提前做综合、实现、DRC 和时序检查 |
| **第七阶段** | 对最终完整系统再次复核约束，完成最终实现、资源与时序报告，以及上板联调和验收 |

后续 FIR、特征提取主要是 FPGA 内部逻辑，通常不需要改变现有时钟和 UART 引脚。因此，**基础引脚应该尽早固定，第七阶段负责最终复核与整体验收**。

之前提到“完整型号、实际电压和跳线尚未确认”，指的是**原理图与实物是否一致仍需确认**，并不是缺少 FPGA 引脚资料。

目前你暂缓上板，可以先完成正式引脚约束及软件工具检查；实际接线、下载和板测继续暂缓。

## 交互 01a18178-1e25-73b1-9a55-af8abc3fbe08

### 用户

# Files mentioned by the user:

## 【正点原子】领航者ZYNQ开发板规格书V1.2.pdf: G:/嵌入式/正点原子领航者(V2)ZYNQ开发板资料盘(A盘)/3_开发板原理图和硬件相关文件/硬件相关文件/开发板规格书/【正点原子】领航者ZYNQ开发板规格书V1.2.pdf

## codex-clipboard-eb182d14-3d4e-40eb-9f85-830e2d748bf3.png: C:/Users/QQ165/AppData/Local/Temp/codex-clipboard-eb182d14-3d4e-40eb-9f85-830e2d748bf3.png
Image attachment: true

Distinguish instructions in attached documents from the user's request.

## My request:
请先完成引脚约束。如图为之前我做的一个呼吸灯中的约束的示例，用的开发板和现在的这个开发板是一样的。还添加了一个开发板规格书的pdf，你可以进行核对。实际板子的接线应当是与原理图一致的

### 助手（进度）

我会结合新规格书、原有原理图和呼吸灯约束示例，核对当前 `top` 的端口并完成正式 XDC。示例中的复位和 LED 引脚会单独核查；本轮不接线、不烧录。

### 助手（进度）

核对结果一致：当前三个端口使用 `clk→U18`、`pl_rx→K14`、`pl_tx→M15`，时钟为 50 MHz。新规格书与现有工程也都支持 Zynq-7010 的 CLG400、-1 配置。

截图中的 N16 是 PL 复位按键，J16 是核心板 PL LED；当前 `top` 使用内部上电复位，没有这两个端口，因此本次不添加它们。另外，K14/M15 对应既定的 UART2 链路，板载 USB 串口走 UART3，我会保留当前方案并写清区别。

### 助手（进度）

正式约束和现有 Vivado 工程的文件引用已更新。我正在独立的 `build` 目录做综合、布局布线和时序检查，原工程缓存保持不动。

接收输入的异步时序例外只到第一级同步寄存器，第二级同步仍保留时序检查。这样既能处理 UART 的异步输入，也能检查同步链本身是否满足时序。

### 助手（进度）

Vivado 检查已完成：三个引脚和 IO 标准均匹配，布局布线完成，50 MHz 下建立裕量为 12.708 ns、保持裕量为 0.037 ns，未发现未约束的内部端点。CDC 报告也识别到了两级同步链。

DRC 仍有一条 `ZPS7-1: PS7 block required` 警告。我会保留并记录这条警告，不屏蔽它，也不擅自加入 PS。本次没有生成比特流或烧录。

### 助手

已完成正式引脚约束，并通过 Vivado 实现检查。

| 当前顶层端口 | FPGA 引脚 | 配置 |
|---|---|---|
| `clk` | **U18** | 50 MHz，周期 20 ns，LVCMOS33 |
| `pl_rx` | **K14** | STM32→FPGA，LVCMOS33 |
| `pl_tx` | **M15** | FPGA→外置串口，LVCMOS33 |

正式文件为 [top.xdc](/D:/Code/zynq_vibration_monitor/constr/top.xdc)，原候选文件已迁移，现有 Vivado 工程引用也已更新。另增加 [UART 接收同步约束](/D:/Code/zynq_vibration_monitor/constr/uart_rx_cdc.xdc)，保留两级同步寄存器之间的时序检查。

截图中的 N16 复位、J16 LED 已核对，但当前 `top` 没有对应端口，因此本次没有添加这两项，也没有修改 RTL。

实际检查结果：

- 综合、布局、布线完成。
- 建立裕量 **12.708 ns**，保持裕量 **0.037 ns**。
- 未约束内部端点为 **0**。
- DRC 无错误或严重警告，仍保留一条 **ZPS7-1：PS7 block required** 警告；未屏蔽、未擅自加入 PS。

**注意：K14/M15 是 UART2，板载 USB 串口使用 UART3。** 当前方案继续使用外置 USB 串口接收 FPGA 回包。

详细修改、依据和复现命令见 [FPGA 约束说明](/D:/Code/zynq_vibration_monitor/docs/fpga_constraints.md)。本轮未生成比特流、未烧录或上板。

核对来源：
:codex-file-citation{path="G:/嵌入式/正点原子领航者(V2)ZYNQ开发板资料盘(A盘)/3_开发板原理图和硬件相关文件/硬件相关文件/开发板规格书/【正点原子】领航者ZYNQ开发板规格书V1.2.pdf" purpose="source"}
:codex-file-citation{path="D:/Code/zynq_vibration_monitor/docs/hardware/zynq_core_2v5.pdf" purpose="source"}
:codex-file-citation{path="D:/Code/zynq_vibration_monitor/docs/hardware/zynq_baseboard_v3_9.pdf" purpose="source"}

## 交互 01a1818a-a8af-7463-b6d6-d8d5e6270d27

### 用户

请生成一个文档告诉我目前fpga开发板和stm32开发板之间应该如何接线

### 助手（进度）

我会把当前接线方案整理成一份中文文档，写清 STM32、FPGA 和 MPU6050 的连接器针号，以及供电、共地、串口跳帽和上电前检查项，并再次对照原理图核对。

### 助手（进度）

接线指南已写好：主表先列出两板之间需要的两根线，后面补充 FPGA 回传 PC、MPU6050 接线和跳帽设置。文档中特别区分了两块板上同名的 J3，以及板载 USB 串口与当前 UART2 通道，避免接错。现在做最后的链接和格式检查。

### 助手

已生成中文文档：[FPGA 与 STM32 接线指南](/D:/Code/zynq_vibration_monitor/docs/wiring_guide.md)。

文档包含：

- 两块开发板之间的逐针接线表。
- FPGA 回传 PC 的外置 USB 串口接法。
- MPU6050 接线与 3.3V 供电选择。
- 跳帽设置、连接器辨认和上电前检查表。

已对照原理图及当前代码核对。本次仅修改文档，没有修改程序、约束或进行板测。

## 交互 01a1819f-8134-7f22-a7c9-e844ae8044c8

### 用户

# Files mentioned by the user:

## 逻辑分析仪pro 参数规格.pdf: F:/说明书/逻辑分析仪pro 参数规格.pdf

Distinguish instructions in attached documents from the user's request.

## My request:
我现在有逻辑分析仪，这是逻辑分析仪的参数。请告诉我目前测试要如何使用逻辑分析仪分析信号

### 助手（进度）

我先读取这台逻辑分析仪的规格，再结合当前接线和第三阶段程序，整理探头接法、采样率、触发条件，以及 UART、I2C 的预期波形和排查方法。

### 助手（进度）

这台仪器的性能足够检查当前 UART 和 I2C，先用 **20 MS/s、4 路输入、1.6 V 门限**即可，不需要一开始就用 1 GHz。规格表同时列了 DL32 和 DL32 Plus，这组设置适用于两者。

建议先测 STM32 固定数据输出，再测 I2C，最后同时比较 FPGA 输入与回传。项目目前还没有生成、下载比特流，所以在此之前，FPGA 没有回包不能作为接收逻辑故障的证据。

### 助手

这台分析仪足够完成当前测试，**先用 20 MS/s，不需要使用 1 GHz 采样率**。我已整理好完整的 [逻辑分析仪测试指南](/D:/Code/zynq_vibration_monitor/docs/logic_analyzer_guide.md)，建议按下面顺序操作。

目前尚未生成、下载 FPGA 比特流，因此可以先测运行了固件的 STM32；检查 FPGA 回包时，必须确认板上已经运行当前设计。

**1．连接输入探头**

保留原来的板间接线，让探头并接到信号上。建议分配如下：

| 分析仪通道 | 信号 | 探测位置 |
|---|---|---|
| CH0 | STM32→FPGA UART | FPGA 底板 J3 第 1 脚 |
| CH1 | FPGA 回传 UART | FPGA 底板 J3 第 2 脚 |
| CH2 | MPU6050 SCL | STM32 扩展板通讯接口 2，第 3 脚 PB10 |
| CH3 | MPU6050 SDA | STM32 扩展板通讯接口 2，第 4 脚 PB11 |
| GND | 公共地 | 已共地的板卡 GND |

CH0～CH3 是建议的逻辑通道分配，实际线缆按仪器丝印确认。**使用输入探头，不启用仪器的 PWM 输出；分析仪必须与两块板共地。**

**2．先测 STM32 固定数据**

STM32 使用 `FixedSource` 目标，先只观察 CH0：

| 设置 | 建议值 |
|---|---|
| 采样率 | **20 MS/s** |
| 门限 | **1.6V**，针对当前标称 3.3V 信号 |
| 模式 | Buffer，单次捕获 |
| 捕获时长 | 20 ms |
| 触发 | CH0 下降沿 |
| UART 解码 | **115200、8N1、低位先发、空闲高、不反相** |
| 显示格式 | 十六进制 |

正常应看到：

- 单个位时间约 **8.68 μs**。
- 一个字节约 **86.8 μs**。
- 十字节包约 **0.87 ms**，包起点间隔目标约 **4 ms**。
- 固定三轴值为 **1、-1、-32768**，序号递增。

从程序启动处捕获，前两包应为：

```text
A5 5A 00 00 01 FF FF 80 00 81
A5 5A 01 00 01 FF FF 80 00 80
```

中途开始采集时，序号不必从 0 开始。连续相同数据位会形成较长平台，不能把任意一个平台宽度都当成单个位宽。

**3．同时检查 FPGA 输入和回传**

FPGA 运行当前设计后，同时采集 CH0、CH1，各添加一个相同配置的 UART 解码器：

- CH0 看输入数据包。
- 当前默认整包回传模式下，CH1 应输出内容一致的十字节包。
- 只有运行 `ACK_ONLY=1` 的 FPGA 设计，才应每包返回一个 `06`。
- CH0 正确、CH1 没响应：检查 FPGA 下载状态、输入校验和引脚。
- CH1 正确、PC 没收到：检查外置串口 RXD、共地和 COM 口。

当前使用 UART2，**领航者板载 USB 串口不是这条回传通道**。

**4．再测 MPU6050 的 I2C**

STM32 切换 `SensorSource`，添加 I2C 解码器，指定 CH2=SCL、CH3=SDA。

捕获初始化时，时长改为 **500 ms**，先开始采集，再复位 STM32。首先应看到读取 WHO_AM_I：

```text
START → 68写 ACK → 75 ACK → 重复START
      → 68读 ACK → 数据68 NACK → STOP
```

注意两个常见误区：

- 地址显示为七位 `68`，或原始地址字节 `D0/D1`，都可能正确。
- **最后一个读数据字节后的 NACK 是主机正常结束读取**；地址阶段 NACK 才需要排查。

稳定运行时，SCL 名义频率约 **100 kHz**，应看到读取 `3A` 状态，以及从 `3B` 开始连续读取六字节。这六字节应与随后 UART 包中的三轴载荷一致。初始化包含两段约 100 ms 等待，不能一启动就要求出现均匀的 4 ms 数据包。

完整指南还包含异常定位和证据保存方法。本轮没有实际采集波形，以上均为依据程序推导的预期结果。

仪器参数依据：
:codex-file-citation{path="F:/说明书/逻辑分析仪pro 参数规格.pdf" purpose="source"}

## 交互 01a18561-f4e0-73e1-9b8d-714948498560

### 用户

# Files mentioned by the user:

## 逻辑分析仪产品差异说明.xlsx: F:/说明书/逻辑分析仪产品差异说明.xlsx

## ATK-Logic_CN.pdf: F:/说明书/ATK-Logic_CN.pdf

Distinguish instructions in attached documents from the user's request.

## My request:
你可能需要修改一下刚才逻辑分析仪的测试方案。我实际购买的型号是DL16而不是DL32。第一份文件为两者区别的xlsx文件。第二份文件为逻辑分析仪的说明书，其中有DL16的参数

### 助手（进度）

我会以你实际购买的 DL16 为准，核对差异表和说明书，重点修订采样率、门限、模式及软件操作步骤。先前按 DL32 规格给出的设置，会明确标出哪些需要更正。

### 助手（进度）

已确认：DL16 的 Buffer 最高为 **250 MS/s**、硬件缓存为 **1 Gbit**，使用 USB2.0 和 2.54 mm 20 针接口；不支持上一版提到的 Roll 和串行触发。不过，当前推荐的 **20 MS/s、1.6 V 门限**可以保留，检查 UART/I2C 的接法和预期数据也不变。

新手册还补齐了 ATK-Logic 的菜单步骤。我会把触发改为普通下降沿，并说明：协议解码不等于协议触发，“循环采集”也不等于 Roll 模式。

### 助手（进度）

指南已按 DL16 更新，并补充了 ATK-Logic 的具体菜单路径。

启动事务的捕获方法也作了调整：稳态通信仍用“Buffer＋正常＋下降沿触发”；要抓上电后的首包或 MPU6050 初始化，则用“Buffer＋立即＋2 秒”，确认采样开始后尽早复位 STM32，避免预采样或已有通信提前触发而漏掉启动过程。

### 助手

已按你实际购买的 **DL16** 修订了原来的 [逻辑分析仪测试指南](/D:/Code/zynq_vibration_monitor/docs/logic_analyzer_guide.md)。

**20 MS/s、1.6V 门限仍然适用**，需要更正的是仪器能力和部分操作方法：

| 项目 | 实际 DL16 |
|---|---|
| Buffer 最高采样率 | **250 MS/s，16 路** |
| 硬件缓存 | **1 Gbit**，不是 3.5 Gbit |
| 接口 | USB2.0、2.54 mm 标准 20 针接口 |
| 运行模式 | Buffer、Stream，**没有 Roll** |
| 触发 | 使用基本边沿/电平触发，不采用之前提到的串行高级触发 |
| PWM 输出 | 2 路，本次保持关闭 |

已对照差异表和说明书核查：
:codex-file-citation{path="F:/说明书/逻辑分析仪产品差异说明.xlsx" purpose="source" sheet="产品差异" range="B6:D14"}
:codex-file-citation{path="F:/说明书/ATK-Logic_CN.pdf" purpose="source"}

目前建议使用下面两组设置：

| 测试目的 | 模式与采集方式 | 采样率／时间 | 触发 |
|---|---|---|---|
| 稳态 UART、FPGA 输入与回传 | Buffer＋正常 | **20 MS/s、100 ms** | CH0 下降沿 |
| MPU6050 稳态 I2C | Buffer＋正常 | **20 MS/s、100 ms** | CH3/SDA 下降沿，其余不设条件 |
| 启动首包、MPU6050 初始化 | **Buffer＋立即** | **20 MS/s、2 s** | 立即模式忽略触发；确认采样开始后尽早复位 STM32 |

初始化改用“立即采集”，是为了避免正常模式的预采样或已有通信提前触发，导致漏掉启动过程。**“循环采集”只是重复多次捕获，不等于 Roll，也不是无缝连续记录。**

指南还补充了 ATK-Logic 的具体菜单：

- **设备配置 → 通道选择**：选择输入通道。
- **设备配置 → 采集选项**：设置 Buffer/Stream、正常/立即。
- **设备配置 → 采集参数**：设置时间、频率、1.6V 门限。
- **协议解码 → 协议 → 添加**：配置 UART 或 I2C。

两块开发板之间的接线、UART 115200/8N1、I2C 100 kHz 和预期数据均保持不变；分析仪自身按 DL16 的 **0～15 输入和 G 地端**接探头，勿接 PWM 输出。

本次仅修订文档，没有修改固件、RTL 或约束，也没有实际采集波形。

## 交互 01a186ba-07e2-7120-abad-e24c2bcf3519

### 用户

stm32的程序烧录完断电后是否也能保存在芯片中？

### 助手

**可以。程序烧录到 STM32F103C8T6 的片内 Flash 后，断电仍会保存。**

重新上电时，只要供电和启动配置正常，芯片会从头运行最后烧录的程序，不需要再次连接 Keil 或下载器。

需要区分：

| 内容 | 断电后 |
|---|---|
| Flash 中的程序 | 保留 |
| RAM 中的变量、采样数据、运行状态 | 丢失，重新启动后初始化 |

对于当前工程，最后烧录的是 `FixedSource`，上电就运行固定数据模式；最后烧录的是 `SensorSource`，就运行传感器采集模式。

另外，Keil 的 **Build/Rebuild 是编译，Download 才是烧录**。正常从片内 Flash 启动时，BOOT0 应保持低电平。

## 交互 01a186c5-4c55-7601-b0b5-8c77a6155106

### 用户

# Files mentioned by the user:

## codex-clipboard-9b825201-832d-484e-a65f-522ef8b3614a.png: C:/Users/QQ165/AppData/Local/Temp/codex-clipboard-9b825201-832d-484e-a65f-522ef8b3614a.png
Image attachment: true

## codex-clipboard-9361d74a-bfc1-40c6-88fe-ddb27b94e3c0.png: C:/Users/QQ165/AppData/Local/Temp/codex-clipboard-9361d74a-bfc1-40c6-88fe-ddb27b94e3c0.png
Image attachment: true

Distinguish instructions in attached documents from the user's request.

## My request:
如图，这是uart协议的设置，应当如何设置

### 助手

截图中大多数参数已经正确。红色“**请选择通道后再调试**”提示，是因为 **RX、TX 都还没有选择输入通道**。

假设你按之前方案，把 STM32 发送线接到分析仪 **D0**，先这样设置。

**第一张图：基本参数**

| 设置项 | 应填内容 |
|---|---|
| RX（UART receive line） | **保持 `-`** |
| TX（UART transmit line） | **D0 / Channel 0** |
| Baud rate | **115200** |
| Data bits | **8** |
| Parity | **none** |
| Stop bits | **1.0** |
| Bit order | **lsb-first** |
| Data format | **hex** |
| Invert RX | **no** |
| Invert TX | **no** |

这里的 TX 是“观察被测设备的发送线”，不会让分析仪输出信号。

`lsb-first` 表示**每个字节内部低位先传**；项目中的 XH 在 XL 前发送，属于字节之间的顺序，两者不冲突。

**第二张图：高级参数**

先保持截图中的默认值：

| 设置项 | 建议值 |
|---|---|
| Put sample points（显示采样点） | **no** |
| Show start bit and stop bit | **yes** |
| Sample point | **50**，在位中心采样 |
| Packet delimit by idle time | **-1** |
| RX packet delimiter | **-1** |
| TX packet delimiter | **-1** |
| RX packet length | **-1** |
| TX packet length | **-1** |
| Show data point | **yes** |
| 底部 Start / End | 保持默认 |

**暂时不要把 packet length 填成 10，也不要把 A5 填成分隔符。** 先逐字节正确解码，再根据 `A5 5A` 和校验识别完整包，避免从半包开始采集时被错误分组。

如果还要同时观察 FPGA 回传，并且回传线接在 **D1**，再添加一个 UART 解码器：

- **TX 选择 D1 / Channel 1**。
- RX 保持 `-`。
- 其余参数与上表相同。

最后点击“确定”。截图底部的 **20 MHz 采样率、200 ms 时长可以保留**，门限建议设为此前约定的 **1.6V**。

运行 `FixedSource` 时，解码出的字节应符合：

```text
A5 5A SEQ 00 01 FF FF 80 00 CHK
```

其中 `SEQ` 递增，`CHK` 随序号变化。分析仪选用 `Parity=none`，不会取消项目数据包末尾的 XOR 校验。

## 交互 01a186c8-617e-7de2-81ce-cb7181946433

### 用户

# Files mentioned by the user:

## codex-clipboard-27b5bf0b-9c05-4320-9fda-5644e91d849d.png: C:/Users/QQ165/AppData/Local/Temp/codex-clipboard-27b5bf0b-9c05-4320-9fda-5644e91d849d.png
Image attachment: true

Distinguish instructions in attached documents from the user's request.

## My request:
这是I2C的协议，应该如何设置

### 助手（进度）

我先确认 `shifted` 地址显示选项的含义，再按之前 D2 接 SCL、D3 接 SDA 的探头方案给你对应设置。

### 助手

按之前的探头分配：**D2 接 SCL，D3 接 SDA**，这个窗口这样设置：

| 设置项 | 应选内容 |
|---|---|
| **SCL** | **D2 / Channel 2** |
| **SDA** | **D3 / Channel 3** |
| Displayed slave address format | **shifted**，保持不变 |
| Display packets | **hex** |
| Show data point | **yes** |
| 底部 Start / End | 保持默认 |

选择完 SCL、SDA 后，点击“确定”。如果探头实际接在其它通道，应按实际接线选择，不能只照填 D2、D3。

`shifted` 表示去掉地址字节中的读写位，显示七位从机地址。因此当前 MPU6050 应显示 **68**，读写方向另外标注为 W/R。若选择 `unshifted`，地址阶段会显示原始字节 **D0（写）或 D1（读）**，不代表地址错误。[地址显示选项的实现依据](https://github.com/sigrokproject/libsigrokdecode/blob/master/decoders/i2c/pd.py)

采集时注意：

- **采样率保持 20 MHz（20 MS/s），门限建议 1.6V**。
- I2C 解码不需要设置波特率，它根据 SCL 解码；程序的 SCL 名义频率为 **100 kHz**。
- 测稳态通信：用 **Buffer＋正常**，CH3/SDA 下降沿触发，其它通道不设触发。
- 抓初始化：用 **Buffer＋立即、2 秒**，确认开始采样后尽早复位 STM32。

STM32 需要运行 **`SensorSource`**。`FixedSource` 不执行 MPU6050 读写，只有 UART 固定数据。

初始化时，应能找到类似下面的 WHO_AM_I 读取：

```text
START → 68 W → ACK → 75 → ACK
      → 重复START → 68 R → ACK → 数据68 → NACK → STOP
```

最后数据字节后的 **NACK 是主机正常结束读取**；如果地址阶段就出现 NACK，再检查供电、地址和接线。

## 交互 01a186d0-9276-7b70-9aec-b56278dc12d4

### 用户

我目前的stm32开发板和fpga开发板间接线是这样：stm32的gnd接fpga的gnd，stm32的pa9接fpga的k14。然后fpga的K14(RX)和COM2_TX用跳线帽连接，M15(TX)和COM2_RX用跳线帽连接。这样是对的吗？如果还需要连接其他的线，请告诉我。电脑与设备之间我目前连接了这几条线：FPGA的下载器，STM32的DAP烧录装置，逻辑分析仪的USB线。电脑和设备之间还需要连接什么线？请告诉我。目前是第三阶段后的中途测试阶段

### 助手（进度）

STM32 共地、PA9 接 FPGA K14 的方向是对的。但你描述的 COM2 跳帽可能把板载 RS-232 收发器的输出也接到了 K14，造成两个输出同时驱动。我先核对 P1/COM2 原理图；确认前请先断电，暂时取下这两组 COM2 跳帽。

### 助手（进度）

原理图确认，底板 COM2 是 RS-232 通道，P1 会把它的接收器输出接到 UART2_RX。STM32 已直接驱动 K14 时，不应再接这条 COM2_TX 路径。

如果当前只用 DL16 看波形和解码，不需要新增电脑数据线；还需把分析仪探头接到数据线并共地。若要用串口助手或项目的 PC 程序收包，则需要另外接 USB 转 3.3V TTL 串口通道。

### 助手

**前两根线接得对：两板共地、STM32 PA9 → FPGA K14。当前直连方案下，你描述的两组 COM2 跳帽应取下。**

这里的 COM2 指领航者底板的 **DB9 RS-232 通道及其 P1 跳帽**。如果你说的是另一个独立模块，需要另行确认。

**1．为什么 COM2 跳帽不能继续连接**

按底板原理图，COM2 接收器的输出可以经 P1 接到 K14。此时可能变成：

```text
STM32 PA9 输出 ─────┐
                   ├── FPGA K14 输入
COM2 接收器输出 ────┘
```

这会让两个输出共同驱动同一根线。即使 COM2 的 DB9 没连接电脑，也不能假定接收器输出处于高阻态。

因此，请在断电后：

- 保留 **STM32 PA9 → K14**。
- 保留 **STM32 GND → FPGA GND**。
- 取下 **K14↔COM2_TX、M15↔COM2_RX** 这两组跳帽。
- 不再把 UART2 接到 RS232/RS485 路径。

该判断依据底板原理图第 1 页；扩展口针号见第 5 页：
:codex-file-citation{path="D:/Code/zynq_vibration_monitor/docs/hardware/zynq_baseboard_v3_9.pdf" purpose="source"}

**2．目前只用逻辑分析仪测试，需要这样接**

| 连接 | 接法 |
|---|---|
| STM32 发送到 FPGA | PA9 → FPGA 底板 **J3.1／K14** |
| 两板共地 | STM32 GND → FPGA GND |
| DL16 通道 0 | 并接 **J3.1／K14**，观察输入 |
| DL16 通道 1 | 并接 **J3.2／M15**，观察 FPGA 回传 |
| DL16 地线 G | 接两板已经共地的 GND |

**分析仪 USB 连接电脑之外，还必须接上述探头和地线。** USB 线不会自动读取开发板上的信号。

当前 STM32 不接收 FPGA 回包，所以**不需要把 M15 接到 STM32 PA10**。

**3．你现在的三条电脑连接，各自有什么用**

| 已有连接 | 用途 |
|---|---|
| FPGA 下载器 | 下载 FPGA 设计、JTAG 调试 |
| STM32 DAP | 烧录和调试 STM32 |
| DL16 USB | 将探头采集的波形交给 ATK-Logic 解码 |

**如果目前只在 ATK-Logic 中看波形和字节，这三条电脑连接可以保留，不必新增串口 USB 连接。**

如果还要用**串口助手或项目 PC 程序接收 FPGA 数据**，则需要另加 USB 转 **3.3V TTL** 串口通道：

```text
FPGA J3.2／M15 ──→ USB-TTL 模块 RXD
FPGA GND      ─── USB-TTL 模块 GND
USB-TTL 模块  ──USB──→ 电脑
```

该模块的 **TXD、VCC、3V3、5V 不接开发板**。现有 FPGA 下载器和 STM32 DAP 不代替这个串口通道；领航者板载 USB 串口也不会自动收到当前 UART2/M15 的回包。

**4．还要确认供电和运行程序**

- FPGA 使用开发板原有的正常供电方式，不依赖下载器给整板供电。
- STM32 是否已经由 DAP 供电取决于你的实际接法，不能仅凭 DAP 已连接判断；确认板卡正常供电。
- 两板只共地，不互连两板的 3.3V／5V 电源脚。
- FPGA 必须已经下载当前 `top` 对应的设计，插着下载器不等于已经配置成功。
- 中途测试建议先运行 STM32 **FixedSource**，排除 MPU6050 因素，再检查 K14 输入与 M15 回传。

我已将这次 COM2 跳帽问题及三条 USB 连接的区别补充到 [接线指南](/D:/Code/zynq_vibration_monitor/docs/wiring_guide.md)。实物跳帽位置尚未看到照片，上述 COM2 判断按你提供的底板原理图进行。

## 交互 01a186dd-96c3-75f3-92d9-08edfcd433d6

### 用户

现在要如何操作让STM32发送数据，并从逻辑分析仪上位机中检测。stm32应该运行什么程序

### 助手（进度）

我先核对当前 Keil 工程里的目标和发送逻辑，再给你按顺序操作的步骤。这一步先运行固定数据程序，只测 STM32 的 UART 输出，不依赖 MPU6050 或 FPGA 回包。

### 助手

现在先让 STM32 运行现有工程的 **`FixedSource`（固定数据发送）目标**。它会通过 PA9 持续发送数据，**不需要 MPU6050 正常工作，也不依赖 FPGA 回包**，适合先检查 STM32 和逻辑分析仪。

**1．选择、编译并烧录程序**

打开 [Keil 工程](/D:/Code/zynq_vibration_monitor/stm32/keil/vibration_monitor.uvprojx)，依次操作：

1. 在 Keil 顶部目标下拉框选择 **`FixedSource`**。
2. 执行 **Rebuild**，确认编译无错误。
3. 确认当前目标使用你已经能正常烧录的 DAP 配置。
4. 点击 **Download**，把程序写入 STM32。
5. 下载完成后，让 STM32 正常运行。可退出调试后按一次 STM32 复位键；如果正停在调试断点，点击 **Run／F5**。

两个目标共用 [main.c](/D:/Code/zynq_vibration_monitor/stm32/app/main.c)，区别是：

| Keil 目标 | 编译配置 | 当前用途 |
|---|---|---|
| **FixedSource** | `APP_FIXED_SOURCE=1` | 发送固定数据，**现在选这个** |
| SensorSource | `APP_FIXED_SOURCE=0` | 初始化 MPU6050，采到数据后发送 |

无需重新写程序，也不用修改 `main.c`。

**2．先只连接和观察 STM32 发送线**

为减少干扰，第一次建议先单独测试 STM32：

```text
STM32 PA9 ───── DL16 数字输入 0
STM32 GND ──── DL16 G
DL16 USB ───── 电脑
```

可以暂时断开 PA9 到 FPGA 的连接。若保留板间连接，应先确认前面提到的 COM2 跳帽已经断开、两板正常供电并共地。

STM32 也必须正常供电；DAP 已连电脑并不自动说明你的实际供电接法正确。

**3．在 ATK-Logic 中开始检测**

第一次先用“立即采集”，避免一直等待触发：

| 项目 | 设置 |
|---|---|
| 启用输入 | **通道 0** |
| 运行模式 | **Buffer** |
| 采集方式 | **立即** |
| 采样率 | **20 MHz／20 MS/s** |
| 采样时间 | **200 ms** |
| 门限 | **1.6V** |

UART 解码器设置：

| 项目 | 设置 |
|---|---|
| TX | **D0／Channel 0** |
| RX | **`-`** |
| 波特率 | **115200** |
| 数据位／校验／停止位 | **8／none／1.0** |
| 位序 | **lsb-first** |
| 数据格式 | **hex** |
| 反相 | **no** |

点击“确定”，再点击右侧“开始采集”。**此时不需要配置 I2C 解码器。**

**4．正常应看到什么**

程序目标约每 **4 ms** 发送一个十字节包：

```text
A5 5A SEQ 00 01 FF FF 80 00 CHK
```

如果正好从复位开始捕获，前两包是：

```text
A5 5A 00 00 01 FF FF 80 00 81
A5 5A 01 00 01 FF FF 80 00 80
```

中途采集时，序号不从 0 开始也正常。应重点确认：

- 包头重复出现 **A5 5A**。
- 序号递增，255 后回到 0。
- 固定载荷始终为 **00 01 FF FF 80 00**。
- 单个位时间约 **8.68 μs**，相邻包起点约 **4 ms**。

如果要抓复位后的第一个包，可把立即采集时长改为 **2 秒**，确认采样开始后尽早按一次 STM32 复位键。

这一步看到正确字节后，就能确认 **STM32 已经在发送固定数据、DL16 能正确解码**；接下来再接回 FPGA，检查它的回传。

## 交互 01a186e5-fd03-72c0-be86-111b8cc4222d

### 用户

# Files mentioned by the user:

## codex-clipboard-6f4ea01c-a35c-4717-a4f9-beb5590596be.png: C:/Users/QQ165/AppData/Local/Temp/codex-clipboard-6f4ea01c-a35c-4717-a4f9-beb5590596be.png
Image attachment: true

## codex-clipboard-189b7c30-f962-4c2d-8329-31c161286d36.png: C:/Users/QQ165/AppData/Local/Temp/codex-clipboard-189b7c30-f962-4c2d-8329-31c161286d36.png
Image attachment: true

## codex-clipboard-7057ae95-8668-4a07-9507-28f35aaa2938.png: C:/Users/QQ165/AppData/Local/Temp/codex-clipboard-7057ae95-8668-4a07-9507-28f35aaa2938.png
Image attachment: true

## codex-clipboard-ca0d179e-1223-46b5-9829-befbb21fd64a.png: C:/Users/QQ165/AppData/Local/Temp/codex-clipboard-ca0d179e-1223-46b5-9829-befbb21fd64a.png
Image attachment: true

Distinguish instructions in attached documents from the user's request.

## My request:
如图，这是连续四次p0采集到的uart数据。这样说明程序是正常的吗？如果是，下一步应该进行什么测试？

### 助手（进度）

我会先逐包核对截图中的序号、三轴值和 XOR 校验，再区分哪些项目已得到实测支持、哪些还需要下一步验证。

### 助手

**是的，这四个包完全符合 `FixedSource` 的预期，可以把“STM32 固定数据发送”记为初步验证通过。**

我逐包核对了：

| 序号 SEQ | 三轴数据 | 截图中的 CHK | 校验结果 |
|---|---|---|---|
| 9A | 1、-1、-32768 | 1B | 正确 |
| 9B | 1、-1、-32768 | 1A | 正确 |
| 9C | 1、-1、-32768 | 1D | 正确 |
| 9D | 1、-1、-32768 | 1C | 正确 |

包头 `A5 5A`、十字节长度、负数表示、序号递增和 XOR 都正确。固定载荷下，校验满足：

```text
CHK = SEQ XOR 81
```

不过，截图没有时间刻度，所以**还不能据此确认 4 ms 发送周期，也尚未验证 FPGA 回传和 MPU6050**。

下一步按以下顺序做。

**1．先补两项时间测量**

保持 STM32 运行 `FixedSource`，在同一段采集中测量：

- **单个位时间：约 8.68 μs**。不要把连续几个相同位形成的平台当成一个位。
- **相邻数据包起点间隔：约 4 ms**。测相邻两个包中，第一个 `A5` 的起始位下降沿之间的时间。

再保留一段 1～2 秒的记录，检查序号有没有跳号、重复，并确认 `FF → 00` 正常回绕。四张截图只能证明展示出来的这四包正确。

**2．然后测试 FPGA 固定数据回传**

STM32 继续使用 `FixedSource`，先不切换传感器程序。

确认 FPGA 已下载并运行第三阶段当前 `top`，然后同时观察：

| 分析仪通道 | 观察对象 |
|---|---|
| D0 | FPGA 输入线，即 STM32 发来的数据 |
| D1 | FPGA 回传线 |

两路各配置 UART **115200、8N1、hex、不反相**，使用同一次采集。

当前 FPGA 默认是**整包回传模式**，所以应看到：

```text
D0 输入：A5 5A 9A 00 01 FF FF 80 00 1B
D1 回传：A5 5A 9A 00 01 FF FF 80 00 1B
```

同一序号对应的三轴和校验必须一致。**默认应收到十字节包，不是单字节 `06`。** 同时保持之前要求的 COM2/P1 冲突跳帽断开。

如果 FPGA 尚未下载当前设计，或者仍运行呼吸灯程序，不能用“没有回包”判断 UART 接收逻辑故障。

**3．固定数据闭环通过后，再测 MPU6050**

将 STM32 切换为 `SensorSource`，检查：

1. WHO_AM_I 返回 `68`。
2. 初始化配置回读正确。
3. 从 `3B` 连续读到六字节加速度。
4. I2C 六字节与随后 UART 包中的三轴字段一致。
5. FPGA 回传的数据继续与输入一致。

若 FPGA 暂时还没准备好，也可以先独立进行这项 STM32＋MPU6050 测试。

我已保存这四张截图及 [核查记录](/D:/Code/zynq_vibration_monitor/report/stm32_fixed_uart_validation.md)，没有修改程序。

## 交互 01a187df-fddd-7900-bccf-9c3901d6810a

### 用户

# Files mentioned by the user:

## codex-clipboard-ae005a38-2d42-42e2-a8ca-1b5e5da0d1f5.png: C:/Users/QQ165/AppData/Local/Temp/codex-clipboard-ae005a38-2d42-42e2-a8ca-1b5e5da0d1f5.png
Image attachment: true

## codex-clipboard-26f310e6-83ee-4c26-88fc-c126e5600f78.png: C:/Users/QQ165/AppData/Local/Temp/codex-clipboard-26f310e6-83ee-4c26-88fc-c126e5600f78.png
Image attachment: true

## codex-clipboard-af8ca87e-8a6a-4db5-828c-e1ab275eef28.png: C:/Users/QQ165/AppData/Local/Temp/codex-clipboard-af8ca87e-8a6a-4db5-828c-e1ab275eef28.png
Image attachment: true

## codex-clipboard-e01bfa2c-aafc-416d-9d0d-5fd3658d0565.png: C:/Users/QQ165/AppData/Local/Temp/codex-clipboard-e01bfa2c-aafc-416d-9d0d-5fd3658d0565.png
Image attachment: true

Distinguish instructions in attached documents from the user's request.

## My request:
目前我的D1连接的是FPGA板上的M15(TX)。出现如图中的结果。图1中有两个白色方框，上面的是单个位时间。图2为相邻数据包间隔。图3和图4为两次数据包起点间标签的时间。请分析是否正确。暂时还没有测量sensorsource的结果。只有fixedsource

### 助手（进度）

我先核对几组时间数值，并区分“单个位宽”“包间空闲时间”和“包起点到包起点的周期”。图中 D1 已出现延后的发送波形，我也会说明它目前能支持哪些结论。

### 助手（进度）

单个位宽 8.7 μs 符合 115200 波特率；两个包起点的标签相差 3.99305 ms，也接近程序设定的 4 ms。图2显示的是边沿之间的长高电平，工具给出的 318.24 Hz 不能当作发包频率。D1 已有响应波形，下一步需要解码 D1，逐包核对它是否与 D0 的内容一致。

### 助手

**目前的位宽和发包周期基本符合 FixedSource 的预期，D1 也出现了回传方向的波形。但还需要解码 D1 的内容，才能确认 FPGA 完整通信闭环正常。**

逐图分析如下：

| 图片 | 测量结果 | 判断 |
|---|---|---|
| 图1 | 单个位宽 **8.7 μs** | 符合 115200 波特率，理论值约 **8.68 μs** |
| 图1 | 周期 **17.4 μs**、频率 **57.47 kHz** | 对应两个位宽的高低交替周期，不能把这个频率当作波特率 |
| 图2 | 长高电平 **3.13365 ms** | 与两个包之间的空闲区相符，不能把它当作发包周期 |
| 图3、4 | 两个包起点标签的时间差 | **105.1087 − 101.11565 = 3.99305 ms**，接近目标 **4 ms** |

**图2的两个白框为什么不同？**

`3.1423 ms − 3.13365 ms = 8.65 μs`，约为一个 UART 位时间。这是工具测量高电平宽度和相邻边沿周期的区别，所以显示的 **318.24 Hz 不是程序的发包频率**。

十字节采用 8N1，每字节包含起始位、8个数据位、停止位，总共100位，发送时间约为：

```text
100 ÷ 115200 ≈ 0.868 ms
```

因此，约4 ms发送一包，中间有约3.13 ms空闲是合理的。注意：波形上的长高电平可能包含最后一个停止位，它与“完整数据包结束后的空闲时间”不完全相同。

**图3、4的周期是否合格？**

本次测得 **3.99305 ms**，比4 ms短 **6.95 μs，约0.174%**，目前可以判断为基本吻合，暂时不需要修改程序。

但应再检查两个标签是否都落在 **A5 的起始位下降沿**。建议跨连续20个包间隔测量，目标总时长约80 ms，再除以20，并观察各相邻间隔是否稳定。单次测量还不能证明长期周期稳定。

**D1出现波形说明了什么？**

按你说明的 D1 接点，图3下方延后出现的串行波形，与“FPGA接收整包、解析后再发送”的行为相符。

不过，当前图片看不清 D1 的完整解码字节，**有波形只能说明输出有活动，还不能证明回传内容正确**。

下一步保持 **FixedSource**，先完成以下检查：

1. 给 D1 添加独立 UART 解码：`TX=D1`、`RX不选`、`115200`、`8N1`、低位先发、十六进制、不反相。
2. 同次捕获中，展开 D0、D1 各一个完整十字节包，比较包头、SEQ、三轴和 CHK。当前默认整包回传模式下，两路对应包应逐字节一致。
3. 连续比较多个包，确认 D1 没有额外重复、跳号或校验错误。

例如，若 D0 是：

```text
A5 5A 9A 00 01 FF FF 80 00 1B
```

对应的 D1 也应是相同十字节；实际序号可以不同于示例，但两路对应包必须一致。

**暂时继续用 FixedSource 完成这一步即可，SensorSource 尚未测试，不计入本次结论。**

已将截图和分析补入[核查记录](D:/Code/zynq_vibration_monitor/report/stm32_fixed_uart_validation.md)，同步更新项目状态与 AI 日志；没有修改程序、RTL 或引脚约束。

## 交互 01a187e8-01ca-7cd3-a700-4aa34eb21ac5

### 用户

# Files mentioned by the user:

## codex-clipboard-87286c41-13d8-4a8e-84a0-f6809fa29656.png: C:/Users/QQ165/AppData/Local/Temp/codex-clipboard-87286c41-13d8-4a8e-84a0-f6809fa29656.png
Image attachment: true

## codex-clipboard-9b03f886-9b07-4275-8123-02fa00c13d84.png: C:/Users/QQ165/AppData/Local/Temp/codex-clipboard-9b03f886-9b07-4275-8123-02fa00c13d84.png
Image attachment: true

Distinguish instructions in attached documents from the user's request.

## My request:
如图，这里取了两个D0和D1的数据解码，是一样的。其他的也是一样。此处仍然是fixedsource

### 助手（进度）

这两张图中，D0 与 D1 的十字节内容逐一相同，序号分别为 CB、CC。我会再核对校验值，并把这次固定数据回传的板测证据记录到项目中。

### 助手

**这两组结果正确，可以确认所展示的 FixedSource 数据已完成 STM32→FPGA→UART 回传，基本通信闭环板测通过。**

核对结果如下：

| 截图 | D0 与 D1 | 序号 | 三轴数据 | XOR 校验 |
|---|---|---|---|---|
| 图1 | 十字节完全一致 | `CB` | `1、-1、-32768` | `4A`，正确 |
| 图2 | 十字节完全一致 | `CC` | `1、-1、-32768` | `4D`，正确 |

序号 `CB→CC` 连续。结合之前约 **8.7 μs 位宽、4 ms 发包周期**的测量，结果与当前设计一致。D1 在接收完整包后回传，也符合程序行为。

目前可以记录为：**固定数据的发送、FPGA 接收及整包回传基本功能正常。** 长时间无丢包、异常帧恢复和真实传感器采集仍需分别验证。

接下来建议：

1. **保存当前采集文件**，再保留一段1～2秒的双路记录，检查对应包一致、序号连续，并观察一次 `FF→00` 回绕。
2. 然后进入 **SensorSource 测试**：在 Keil 中选择 `SensorSource`，重新编译并下载 STM32。FPGA 继续运行当前整包回传程序，无需修改 RTL。
3. 按[逻辑分析仪测试指南](D:/Code/zynq_vibration_monitor/docs/logic_analyzer_guide.md)，检查：
   - 初始化时 `WHO_AM_I` 寄存器 `75` 读回 `68`；
   - 从寄存器 `3B` 开始读取的六字节，与 D0 包内的三轴六字节一致；
   - D1 对应包与 D0 完全一致。

SensorSource 下三轴不再固定为 `1、-1、-32768`；静止时允许有噪声，缓慢转动传感器时应随姿态变化。

已保存两张截图并更新[验证记录](D:/Code/zynq_vibration_monitor/report/stm32_fixed_uart_validation.md)、项目状态和 AI 日志。本轮没有修改程序或约束。

## 交互 01a18ab0-feab-7663-92fb-4f400194b6e9

### 用户

已经采集使用sensorsource的数据，你可以操控我的电脑打开任务栏中的ATK LogicView自行查看数据是否可以通过测试

### 助手（进度）

我会使用 computer-use 技能打开 ATK LogicView，查看当前采集中的 I2C、D0 和 D1 解码，核对传感器数据与 FPGA 回传是否一致。先保留现有采集，不重新采样或烧录。

### 助手（进度）

当前记录为50 ms、20 MS/s。我已看到传感器模式的三轴数据，以及读取 `3A` 状态寄存器的 I2C 事务。正在核对完整包和对应的六字节传感器读数；这段记录是否包含上电初始化，还需要检查，暂不把身份和配置检查判为通过。

### 助手（进度）

已导出三路协议记录并完成交叉核对：12组完整数据都满足“I2C 六字节＝D0 三轴字段＝D1 回传”，XOR 正确，序号 ED～F8 连续。D1 另有一个 EC 包，其输入在采集开始处被截断，不是多发了一包。

当前通信链路可以判为通过。另有一个约3 ms的发送间隔，其余接近4 ms；我会在报告中保留这个差异，并将通信通过与采样周期、传感器精度的验收分开说明。

### 助手

这段 SensorSource 数据采集时，MPU6050 是完全静止平放，还是正在移动、转动或振动？这会影响对三轴数值大小的判断。
- 完全静止平放
- 正在移动或振动
- 记不清

### 用户

<send_user_message_question_reply>
[{"questionItemId":"[\"request_user_input_async\",\"call_28db5986e97646f18ae3064829851f05\",0]","question":"这段 SensorSource 数据采集时，MPU6050 是完全静止平放，还是正在移动、转动或振动？这会影响对三轴数值大小的判断。","answer":"完全静止平放"}]
</send_user_message_question_reply>

### 助手（进度）

收到。静止平放时，Z 轴读数约为21900，这一点需要单独核查。我会使用 PDF 技能对照模块手册：当前源码设定为 ±2g，静止时三轴合成值通常应接近16384，而本次约为21975，相当于1.34g。

这说明数据传输已核对正确，但传感器测量值暂时不能判为通过。我会保留这一差异，不改写为“数值正常”，也不直接修改校准参数。

### 助手（进度）

核查结果和原始数据已保存。结论是：这50 ms内的“I2C 读取→STM32 打包→FPGA 回传”通过；静止量值约1.34g仍待排查，当前记录也没有覆盖初始化配置回读。

下一步应先补一段包含复位初始化的采集，重点核对 `1C=00`，再比较 Z 朝上、朝下的静止读数。目前没有修改程序或加入偏移补偿。

### 助手

**已打开 ATK-LogicView 检查并导出数据：本次通信闭环通过，但传感器静止量值尚不能通过验收。**

| 检查项 | 结果 |
|---|---|
| I2C 六字节与 D0 三轴字段 | 12组完整数据全部一致 |
| D0 与 D1 完整十字节包 | 12组全部一致 |
| 序号、XOR | ED～F8 连续，校验全部正确 |
| I2C 应答 | 37笔完整事务的 ACK/NACK 模式正确 |
| 初始化身份和配置 | 本段未捕获，待检查 |
| 静止测量值 | 存在明显偏差，待排查 |

例如其中一组：

```text
I2C：01 DA FE DC 55 C2
D0 ：A5 5A ED 01 DA FE DC 55 C2 83
D1 ：A5 5A ED 01 DA FE DC 55 C2 83
三轴：X=474，Y=-292，Z=21954
```

因此，这段数据从传感器读出后，经 STM32 打包和 FPGA 回传，内容保持正确。

**需要重点检查静止读数。** 你确认采集时完全静止平放，12组数据的平均值约为：

```text
X = 549.5
Y = -289.2
Z = 21952.7
```

若实际量程与源码中的 `1C=00` 一致，即 ±2g、16384计数/g，则三轴合成值约为 **1.34g**，偏离静止时约1g的预期。量程换算依据见模块手册第7页。:codex-file-citation{path="D:/Code/zynq_vibration_monitor/docs/hardware/mpu6050_module_manual.pdf" purpose="source"}

这不能直接归因为芯片损坏，也不应直接减去一个常数。下一步建议：

1. **补初始化捕获**：设置“立即采集、2秒”，开始后复位 STM32。检查身份 `75→68`，以及配置写入和回读，尤其是 **`1C=00` 的量程和自检位**。
2. **补正反静止记录**：分别让 Z 朝上、朝下，静置后采集，用于区分零偏与比例问题。
3. **补较长稳态记录**：本次有一个约2.995 ms的包间隔，其余接近4 ms，尚不能判定严格周期和长期稳定性通过。

已保存[原始波形](D:/Code/zynq_vibration_monitor/report/evidence/sensor_source_20261030.atkdl)、三路CSV及[核查报告](D:/Code/zynq_vibration_monitor/report/sensor_source_validation_20261030.md)，并更新项目记录。**没有修改 STM32/FPGA 程序，也没有重新采集或烧录。**

## 交互 01a18ac5-47f5-74a1-9e61-00cc6b4f8c70

### 用户

这次让Z朝下静止采集。请操控电脑使用atklogicview分析。

### 助手（进度）

我会打开 ATK-LogicView 查看这次 Z 朝下的记录，核对 I2C、D0、D1 是否一致，再与上次静止数据比较，判断 Z 轴的正反读数是否对称。会先保存现有采集，不重新采样或烧录。

### 助手（进度）

本次12个完整包的 D0、D1 内容一致，Z 轴也已变为负值，平均约 −11376；上次正值约为 +21953。若两次配置相同，这种明显的不对称更像是存在较大的零偏，而不是单纯量程比例错误。我会继续核对 I2C 原始字节，并计算正反读数的中点和半差；暂不修改校准参数。

### 助手

两次静止采集之间，是否仅翻转了 MPU6050，STM32 程序和传感器配置都没有改动？
- 仅翻转，程序配置未改
- 重新烧录了相同 SensorSource
- 程序或配置有改动

### 用户

<send_user_message_question_reply>
[{"questionItemId":"[\"request_user_input_async\",\"call_3a4c4c9e4cce4abc8fcb9c993cbd7068\",0]","question":"两次静止采集之间，是否仅翻转了 MPU6050，STM32 程序和传感器配置都没有改动？","answer":"仅翻转，程序配置未改"}]
</send_user_message_question_reply>

### 助手（进度）

确认两次只翻转、程序配置未改后，计算得到 Z 轴正反均值的中点约为 +5288，半差约为16664计数，后者接近标称16384计数/g。这支持“较大 Z 零偏”的判断，但两次各只有12组数据，且姿态未精确校准，暂不能直接作为最终校准参数。

另外，D1 在采集起点附近有一条停止位错误提示，位于首个完整包之前；后续12组完整包均核对正确。我会保留这条提示，并在报告中注明边界限制。

### 助手

**已通过 ATK-LogicView 检查：本次完整数据包的通信正常，Z 翻转后变为负值；正反读数表明，Z 轴很可能存在较大的零偏。**

本次50 ms记录中：

- **12组完整数据**均满足：I2C六字节＝D0三轴字段＝D1回传字段。
- 序号 `66～71` 连续，完整包 XOR 全部正确。
- 包起点间隔平均约 **4.00010 ms**，符合约4 ms的目标。

两次静止数据的均值为：

| 姿态 | X | Y | Z |
|---|---:|---:|---:|
| 上次正向 | 549.50 | −289.17 | **+21952.67** |
| 本次 Z 朝下 | 2939.00 | −902.00 | **−11375.83** |

你已确认两次仅翻转、程序配置未改。若两个姿态近似正反水平，可以初步估算：

```text
Z 零偏 ≈ (正向均值＋反向均值)÷2
       ≈ +5288.42 计数

Z 正反半差 ≈ 16664.25 计数
```

**正反读数的中点明显偏离零，支持“较大 Z 零偏”的判断。** 但每次只有12组数据，姿态也未精确校准，因此现在不能直接把5288写进程序作为最终补偿。

另有一条需要保留的边界现象：D1 在采集起点附近 **80.95 μs** 出现停止位错误，位于首个完整包之前，符合窗口从上一帧中途开始时的解码失步现象；目前不能确定唯一原因。后续12个完整包均正常，不能将整段描述为“零错误”。

下一步优先补**复位初始化捕获**，确认身份与配置回读，尤其是 `1C=00`；随后做较长的六面静止记录，再确定校准方案。当前无需修改 FPGA RTL。

已保存[原始波形](D:/Code/zynq_vibration_monitor/report/evidence/sensor_zdown_20261030.atkdl)、三路CSV和[正反对照报告](D:/Code/zynq_vibration_monitor/report/sensor_zdown_validation_20261030.md)。**未修改固件、RTL或约束，未重新采样或烧录。**

## 交互 01a18ae5-7141-7ad2-85ec-e237bc2e55e2

### 用户

暂时先不要开始任务。总结是：现在主要的问题是MPU6050的零偏问题，STM32和FPGA的功能完整性没有问题。之前预定该做的测试基本都通过。是否如此？

### 助手

**基本方向正确，但应限定为“已验证的通信链路正常”，还不能说全部功能和预定测试都已通过。** 现在先不开展任何新任务。

目前可以确认：

- **STM32 读取、打包正常**：所检查的 I2C 六字节与 UART 三轴字段一致。
- **FPGA 接收和整包回传正常**：对应 D0、D1 内容一致，完整包的序号和 XOR 正确。
- **基本通信时序符合预期**：位宽对应115200波特率，发包间隔总体接近4 ms。
- **此前的软件仿真与编译检查已通过**，包括仿真中的错误和恢复用例。

当前主要待查的是：**传感器静止原始读数明显不对称，较大的 Z 轴零偏是主要怀疑方向。** 但还没有完整确认实际配置，因此不能直接确定为 MPU6050 芯片自身的问题。

尚未完成的实物验收包括：初始化身份与配置回读、较长时间稳定性、异常输入后的恢复，以及传感器量值和校准验证。采集边界的停止位警告也尚未独立复核。

因此，适合当前项目的总结是：

> **STM32—FPGA 的基本数据通信闭环已经验证通过；当前主要问题集中在传感器静态量值偏差。第三阶段的基本通信目标已达到，完整实物验收仍有少量项目待补。**

## 交互 01a18aec-086c-7013-8a65-853bd852323c

### 用户

如果MPU6050零偏问题可以后续调整，那么第三阶段任务就基本完成。请你开始之前预定的第四阶段任务。

### 助手（进度）

我会先核对原定第四阶段的范围、现有接口和验收要求。传感器静态偏差会继续作为待解决项保留。按项目约定，新增较大规模 RTL 前，我会先完成第四阶段设计说明，等你确认后再编码。

### 助手

第四阶段 FIR 的目标振动频段目前是否有明确要求？若还没有，我先以250 Hz采样、保留约5～30 Hz、抑制50 Hz及以上作为可调整的仿真设计目标。
- 暂按5～30 Hz设计
- 已有明确频段，我补充说明
- 先只完成通用模块，不定频段

### 用户

<send_user_message_question_reply>
[{"questionItemId":"[\"request_user_input_async\",\"call_ddebf6ae36d7414ab8c40803888b2a04\",0]","question":"第四阶段 FIR 的目标振动频段目前是否有明确要求？若还没有，我先以250 Hz采样、保留约5～30 Hz、抑制50 Hz及以上作为可调整的仿真设计目标。","answer":"暂按5～30 Hz设计"}]
</send_user_message_question_reply>

### 助手（进度）

已按你的回复，将第四阶段的暂定目标设为：250 Hz采样下，保留5～30 Hz、抑制50 Hz及以上。方案会采用三轴独立去直流，再接定点 FIR 低通，并先用仿真验证。

去直流可以减小恒定偏置和固定姿态重力对后续振动特征的影响，但不能替代 MPU6050 校准。当前十字节协议和原始数据回传会保留，便于继续对照原始值。

### 助手（进度）

数值模型已完成首轮检查：63抽头 FIR 配合去直流后，5～30 Hz 的增益约为 −0.107～+0.156 dB，50 Hz及以上的最差衰减约59 dB；18组数值用例通过。

还需区分两种延迟：FIR 的信号群延迟约124 ms，PL 的计算时间则预计约4 μs。前者是滤波器特性，后者仍需编写 RTL 后验证。

### 助手（进度）

具体设计和测试计划已写入文档。滤波结果采用18位内部接口，供后续特征模块使用；原始 UART 回传继续用于对照。设计也明确了忙时输入的丢弃计数、缺包后重建历史、12 ms断流恢复，以及四个模块各自的自检要求。

正在做最后的文件和证据核对。本轮尚未编写新 RTL，也没有运行新模块的 ModelSim、Vivado 或板测。

### 助手

**第四阶段已启动，已完成具体设计、系数生成和数值验证，尚未编写新 RTL。**

按你确认的频段，方案为：

| 项目 | 方案 |
|---|---|
| 处理对象 | X、Y、Z 三轴独立处理 |
| 数据路径 | 去直流 → 63抽头定点 FIR 低通 |
| 名义采样率 | 250 Hz |
| 频率目标 | 保留5～30 Hz，抑制50 Hz及以上 |
| 内部结果 | 18位，供后续特征提取使用 |
| UART | 保留现有十字节原始数据回传 |

去直流可以减小恒定偏置的影响，**不代表 MPU6050 已完成校准**。

已实际运行18组、共41728个样本的数值检查，包括冲激、阶跃、正负极值、随机数据和正弦信号：

- 5～30 Hz增益：约 **−0.107～+0.156 dB**。
- 50 Hz及以上最差衰减：约 **59 dB**。
- 当前整数模型相对独立浮点参考的最大误差：约 **0.93计数**。

FIR信号群延迟约124 ms；PL计算延迟设计目标约3.86 μs，后者仍待RTL验证。

本轮新增了数值参考程序、系数文件，以及：

- [第四阶段设计说明](D:/Code/zynq_vibration_monitor/docs/stage4_design.md)：接口、位宽、状态机、周期和文件职责。
- [完整测试计划](D:/Code/zynq_vibration_monitor/docs/stage4_test_plan.md)：正常、错误、恢复及双仿真器验收。
- [数值验证记录](D:/Code/zynq_vibration_monitor/report/stage4_design_validation.md)：实际命令和结果。

**请确认是否按这套方案继续编写 RTL 和自检 Testbench。**

需要此处确认的依据是项目 [AGENTS.md](D:/Code/zynq_vibration_monitor/AGENTS.md) 明确要求：“先解释设计……编写较大规模的新 RTL 前，等待用户批准。”当前具体设计已可评审；尚未运行新模块的 ModelSim、Vivado 综合或板测。

## 交互 01a18fdc-dbcc-79b2-8df5-92bea2637cb7

### 用户

第三阶段结束后已经完成了一次较大的测试。我是否可以等到最终阶段结束后再进行测试？

### 助手

**可以把后续上板测试集中到最终阶段，但每阶段的仿真测试仍应完成。**

第三阶段已经验证了基本通信链路，可以作为后续开发基础。建议这样安排：

| 测试类型 | 安排 |
|---|---|
| 模块自检 Testbench | 每完成一个模块就运行 |
| 阶段集成仿真 | 每阶段结束时运行，检查新旧模块连接 |
| 综合、资源和时序检查 | 新增较多逻辑后进行 |
| 烧录、逻辑分析仪、实物联调 | 可以集中到最终阶段 |

例如第四阶段仍需通过仿真检查 FIR 数值、舍入、溢出、时序、复位和缺包恢复；这些检查不需要接开发板。这样能及时定位问题，避免最后同时排查多个阶段。

MPU6050 的初始化配置回读、零偏校准、长期采样稳定性和真实滤波效果，可以保留到最终上板验收。此前的短记录说明基本通信正常，不能替代这些项目。

**后续可以按“每阶段完成软件与仿真验收，最终统一上板联调”的方式推进。**

## 交互 01a18fde-2ec4-76d0-be47-e5efe9803d00

### 用户

你之前是不是提到第四阶段还有RTL和Testbench没有写完

### 助手

是的。**第四阶段目前完成的是设计和数值验证，RTL 与 Testbench 尚未开始编写。**

已完成：

- 三轴去直流与63抽头 FIR 的设计，包括接口、位宽、状态机和时序。
- 系数生成、Python 数值参考，以及18组数值用例检查。
- RTL 文件职责和完整测试计划。

尚未完成：

- 去直流、FIR、三轴调度和通信适配的 RTL。
- 各模块的自检 Testbench。
- ModelSim、Vivado XSim 仿真，以及综合、资源和时序检查。

当时停在等待你确认具体实现方案的位置，这是项目 `AGENTS.md` 对较大规模新 RTL 的要求。因此，**第四阶段还没有完成，数值模型通过也不等于 RTL 仿真通过。**

## 交互 01a18fdf-d76a-7ce2-bb6e-60ab8dde0713

### 用户

那么请继续编写第四阶段未完成的内容。仿真测试你应该可以调用modelsim的xsim自行完成。那么每次阶段的主要内容编写完成后请你自行进行仿真并给出结论。

### 助手（进度）

我会按已确认的第四阶段方案完成 RTL、自检 Testbench 和运行脚本，自行运行 ModelSim、Vivado XSim，并检查综合资源与时序。之后每阶段主要代码完成后，我也会自行运行相应仿真并报告结果；上板联调留到最终阶段。

### 助手（进度）

四个 RTL 模块已写好：单轴去直流、串行 FIR、三轴调度和通信适配层。现有板级顶层及原始 UART 回传路径没有改动。

接下来会逐项验证数值是否匹配 Python 参考、输出是否符合190/193拍时序，以及忙时丢弃、序号跳变和断流后能否恢复。编译成功还不能作为通过结论。

### 助手（进度）

ModelSim 和 XSim 的四项自检均已通过，RTL 导出的数值也与 Python 参考一致。集成测试覆盖了600包、序号回绕、坏校验、停止位错误、截断及恢复。

隔离实现检查中，建立时序满足20 ns目标，但0 ns抽象接口约束出现了保持违例。我正在区分接口边界与模块内部路径，暂不把它写成整体时序通过。

### 助手（进度）

滤波模块的内部时序检查已通过：50 MHz目标下，建立裕量9.198 ns、保持裕量0.117 ns；资源为2282个 LUT、3901个寄存器和3个 DSP。OOC 端口仍需在最终系统中补齐连接时序，DRC 的现有警告也会如实保留。

另外，正负半单位舍入、忙时保持请求、缺失系数文件和非法断流参数的检查均已通过。现在正在完成截断位置覆盖和测试文档。

### 助手

**第四阶段剩余的 RTL、Testbench 和脚本已完成，软件验收通过。**

新增了三轴去直流、63抽头定点 FIR、三轴调度和通信适配层，并配套自检。

我已实际执行：

| 检查 | 结论 |
|---|---|
| ModelSim 四项自检 | 全部通过，errors=0 |
| Vivado XSim 四项自检 | 全部通过，errors=0 |
| RTL 输出与 Python 参考对照 | 通过 |
| 缺失系数、非法参数拒绝检查 | 通过 |
| 隔离综合与内部时序 | 通过 |

覆盖了41728个单轴样本、4000组三轴数据、600个正常串口包，以及坏校验、停止位错误、九个截断位置、序号异常、断流和复位恢复。

新增滤波模块使用 **2282 LUT、3901 FF、3 DSP**；50 MHz目标下，内部建立/保持裕量为 **9.198 ns / 0.117 ns**。OOC仍有警告及接口约束待集成，不能视为完整板级签核。

**当前板级 top 和原始 UART 协议未改，滤波结果是18位内部接口。** 上板滤波验证、传感器校准仍留到最终联调。

完整修改和证据见[验证报告](D:/Code/zynq_vibration_monitor/report/stage4_validation.md)，操作见[测试指南](D:/Code/zynq_vibration_monitor/docs/stage4_test_guide.md)。复查命令：

```powershell
powershell.exe -NoProfile -ExecutionPolicy Bypass -File .\sim\run_stage4.ps1 -Simulator both
```

后续每阶段完成主要实现后，我会继续自行运行相应仿真并报告结论。

## 交互 01a18ff6-0775-75c0-a00b-8aaa17d464b1

### 用户

接下来继续完成之前预定的第五阶段任务。

### 助手（进度）

我会先核对第五阶段的预定范围和第四阶段的滤波接口，再确定窗口特征与报警的设计。按项目约定，较大规模新 RTL 需要先评审具体接口和时序；本轮会先完成可评审的方案与数值验证。

### 助手（进度）

第五阶段的预定内容是窗口均方值、峰值和阈值报警。我拟在此基础上直接输出整数 RMS：采用128样本窗口（名义512 ms），三轴分别计算。

报警先用可参数化的演示阈值：RMS达到2000计数、连续两个窗口后置位；降到1500计数、连续两个窗口后解除。这些不是实际故障标准。缺包、断流或滤波历史不足时会清空统计，并将报警状态标为无效；UART继续保留原始数据回传。

### 助手

第五阶段的具体方案已写入 docs/stage5_design.md：128样本窗口，三轴均方值/峰值/整数RMS，演示阈值2000置位、1500解除，连续两窗确认；缺包清窗并使报警状态无效，保留原始UART。AGENTS.md要求主要新RTL先确认具体设计。是否按此方案继续编写四个RTL、自检并自动运行ModelSim/XSim？
- 确认方案，继续实现并自动仿真
- 调整窗口或阈值后再实现

### 用户

<send_user_message_question_reply>
[{"questionItemId":"[\"request_user_input_async\",\"call_e10cffb556714c039883fe6752e94662\",0]","question":"第五阶段的具体方案已写入 docs/stage5_design.md：128样本窗口，三轴均方值/峰值/整数RMS，演示阈值2000置位、1500解除，连续两窗确认；缺包清窗并使报警状态无效，保留原始UART。AGENTS.md要求主要新RTL先确认具体设计。是否按此方案继续编写四个RTL、自检并自动运行ModelSim/XSim？","answer":"确认方案，继续实现并自动仿真"}]
</send_user_message_question_reply>

### 助手（进度）

已确认。我会按这份方案完成第五阶段 RTL 和自检 Testbench，自动运行 ModelSim、XSim，并检查与现有滤波、UART 链路的集成。完成后会说明仿真结论和仍需最终上板验证的内容。

### 助手（进度）

四个 RTL 模块已写入：整数开方、窗口统计、滞回报警和链路适配。正在建立独立期望向量，重点检查最负数的平方与绝对值、窗口最后一项，以及缺包或清理后是否会泄漏旧结果。

### 助手（进度）

三个独立模块的 ModelSim 自检已通过。集成测试发现两处需要修正：从解析器发布原始帧到对齐特征，实际是218拍，设计说明漏算了进入滤波器的一拍；复位测试也需要留出 UART 既有的空闲高电平等待时间。我会修正说明和测试激励后重新验证。

### 助手（进度）

ModelSim 的四项自检和实际 RTL 导出对照均已通过，原始 UART 回包也逐字节一致。12个合成数据窗口中，报警按预期置位并解除；九处截断、坏校验、停止位错误、断流和序号跳变后均能恢复。XSim 和隔离布局布线检查正在运行。

### 助手（进度）

ModelSim、XSim 的四项自检、RTL 导出对照和八项非法参数测试均已通过。完整内部核心的隔离布局布线检查也通过：50MHz目标下，内部建立/保持裕量为9.063ns和0.088ns。正在整理复现指南和验收记录，并保留工具警告及最终板测边界。

### 助手

第五阶段已完成，**软件仿真验收通过**。

本次新增四个模块：

| 模块 | 用途 |
|---|---|
| `isqrt_u36` | 计算整数平方根 |
| `window_features` | 统计三轴均方值、RMS和绝对峰值 |
| `threshold_alarm` | 实现滞回报警和连续窗口确认 |
| `feature_monitor_core` | 连接UART、滤波、窗口统计与报警 |

默认采用128样本窗口，名义更新间隔512ms；报警阈值为2000置位、1500解除，均需连续两窗确认。缺包、断流或质量失效时取消窗口，并将报警状态标为无效。

实际验证结果：

- **ModelSim、XSim四项自检全部通过，错误数均为0。**
- 覆盖10033个开方输入、109个统计窗口、2200个合法UART回传包，以及错误、截断和恢复测试。
- 两套仿真器的实际RTL输出均与Python参考一致。
- Vivado隔离布局布线通过：50MHz目标下，内部建立/保持裕量为 **9.063ns / 0.088ns**；工具警告已记录。

自行复现可运行：

```powershell
powershell.exe -NoProfile -ExecutionPolicy Bypass -File .\sim\run_stage5.ps1 -Simulator both
```

详细内容见[验收报告](D:/Code/zynq_vibration_monitor/report/stage5_validation.md)和[仿真操作指南](D:/Code/zynq_vibration_monitor/docs/stage5_test_guide.md)。新增文档和注释均使用中文。

当前D1仍回传原始数据，RMS和报警是内部接口，等待最终板级集成。本阶段尚未上板；传感器校准、真实阈值及完整板级时序仍留待最终验证。

## 交互 01a19012-8065-77a2-aa91-8c217e50e929

### 用户

# Files mentioned by the user:

## codex-clipboard-ca48bdde-41ce-4385-b867-62f82a62959c.png: C:/Users/QQ165/AppData/Local/Temp/codex-clipboard-ca48bdde-41ce-4385-b867-62f82a62959c.png
Image attachment: true

Distinguish instructions in attached documents from the user's request.

## My request:
为避免因为上下文压缩导致记忆丢失，我附了一张之前规划的的第六和第七阶段的任务图。现在第五阶段已完成，请继续完成第六阶段的任务。

### 助手（进度）

截图明确了第六阶段的范围：完整链路集成、原始/滤波数据选择，以及长序列、异常恢复、延迟和输出堵塞测试。我会先核对现有接口，整理具体集成方案；涉及回传协议的选择会先确认，再编写主要 RTL。

### 助手（进度）

当前滤波结果是18位，现有十字节回包的三轴字段各为16位，需要先明确转换规则。我建议保留十字节布局：默认回传原始值；滤波模式将18位结果算术右移2位，上位机乘4还原计数尺度，量化误差小于4计数。两种模式通过综合参数选择，避免混用数据尺度。

我也会把截图中的第六、七阶段计划写入项目文档。上板测试继续按你此前的安排集中到最终阶段，本阶段会明确区分软件验收和待补实测。

### 助手

第六阶段方案已写入 docs/stage6_design.md：新增完整系统核心和独立顶层，以综合参数选择原始/滤波回传；滤波值算术右移2位放入现有十字节包，PC乘4恢复尺度；内部18位计算不变，并完成双工具自检、拥塞/复位测试和两种模式的资源时序检查。AGENTS.md要求主要新RTL及协议语义调整先确认。是否按此方案实现？
- 确认上述方案，继续实现并自动测试
- 滤波结果需要18位无损回传，请调整方案

### 用户

<send_user_message_question_reply>
[{"questionItemId":"[\"request_user_input_async\",\"call_c82dc3418463434eb6e0b4d2bc2d3133\",0]","question":"第六阶段方案已写入 docs/stage6_design.md：新增完整系统核心和独立顶层，以综合参数选择原始/滤波回传；滤波值算术右移2位放入现有十字节包，PC乘4恢复尺度；内部18位计算不变，并完成双工具自检、拥塞/复位测试和两种模式的资源时序检查。AGENTS.md要求主要新RTL及协议语义调整先确认。是否按此方案实现？","answer":"确认上述方案，继续实现并自动测试"}]
</send_user_message_question_reply>

### 助手（进度）

方案已确认。我会按右移2位的回传规则实现，保留内部18位计算；随后完成长序列、三轴隔离、拥塞和复位测试，并分别检查原始、滤波两种模式的完整实现结果。

### 助手（进度）

选择器已通过全部262144个18位输入的 ModelSim 自检，确认负数右移规则和极值都正确。系统核心与独立顶层也已写入；接下来验证完整串口链路，重点检查输出暂停时滤波和窗口能否继续运行，以及复位后是否会残留旧数据。

### 助手（进度）

完整系统的长序列仿真正在运行。我会按 PDF 技能流程重新核对原理图，再复用现有三端口约束进行独立板级构建，检查完整计算链路能否在实际约束下保留并通过时序。

### 助手（进度）

ModelSim 的完整系统测试已通过，长序列、异常恢复、输出堵塞和复位用例均未发现数据不一致。Vivado 构建目前停在“计算分支是否保留”的检查：脚本按预期层次名查找开方器时没有找到对象。我会先检查综合网表，确认是层次名变化还是分支被优化掉，再继续。

### 助手（进度）

网表确认，原始回传模式下的滤波和统计支路确实在优化阶段被移除了：本次构建中，仅有 `MARK_DEBUG/KEEP` 没能保住这些无外部负载的网络。我已补上明确的保留属性，并保留“分支必须存在”的验收检查，正在重跑两种模式。ModelSim、XSim 的功能测试和导出对照均已通过。

### 助手（进度）

进一步检查发现，保留属性落在了跨层网络上，实际驱动寄存器仍可被删除。我会改用小规模、明确保留的内部调试快照寄存器作为负载，并继续检查整个计算分支是否存在。这不会改变回传协议或处理时序；额外资源会计入最终报告。

### 助手（进度）

新的网表检查已确认：原始模式也保留了三轴 FIR、三个开方器、窗口和报警支路，旧的未连接发送器已被移除，外部只保留一个 UART TX。最终顶层的双工具回归也通过了，包括默认波特率下的坏包恢复和调试快照检查。

实际 RTL 导出的量化结果为：10Hz约+0.083dB、30Hz约+0.153dB、60Hz约−61.65dB；线缆缩放还原误差为0～3计数。这些是合成输入的仿真结果。

### 助手（进度）

两种模式的完整板级实现均已通过，计算支路保留检查和 CDC 检查也通过。50MHz下，原始模式建立/保持裕量为5.205ns/0.037ns，滤波模式为8.300ns/0.028ns。DRC仍有已记录的警告，最终下载前会继续处理。

我正在补齐最后一项线缆时间证据：从独立串口观测中核对包内字节间隔、整包发送时间和默认4ms周期，然后整理报告。

### 助手（进度）

最终双工具验收已完成：默认4ms包周期、包内无额外字节间隙，以及868µs整包发送时间均已核对。量化数据、两种模式的资源/时序/CDC/DRC报告和源码哈希已归档；前两阶段验收快照中的39项源码哈希保持一致。正在完成文档、编码和链接检查。

### 助手

第六阶段的**软件联调、量化和完整实现检查已完成**。实物测试按此前约定留到最终阶段。

本次完成：

- 新增完整系统入口 `system_top`，支持综合参数选择原始/滤波回传。滤波线缆数据解码后需乘4，内部18位计算保持不变。
- ModelSim、XSim各五项自检全部通过。两种模式各验证5632包、40个窗口，并覆盖错误恢复、三轴隔离、输出堵塞和全状态复位。
- 实际RTL量化结果：10Hz约 **+0.083dB**、30Hz约 **+0.153dB**、60Hz约 **−61.65dB**；线缆还原误差为0～3计数。

两种模式均完成50MHz板级布局布线：

| 模式 | LUT / FF | 建立裕量 | 保持裕量 |
|---|---:|---:|---:|
| 原始 | 3401 / 6101 | 5.205ns | 0.037ns |
| 滤波 | 3324 / 6091 | 8.300ns | 0.028ns |

每种模式保留8项DRC警告，具体原因已记录；尚未生成比特流或上板。

可重新运行：

```powershell
powershell.exe -NoProfile -ExecutionPolicy Bypass -File .\sim\run_stage6.ps1 -Simulator both
```

已保存[原第六、七阶段计划](D:/Code/zynq_vibration_monitor/docs/stage_plan.md)、[验收报告](D:/Code/zynq_vibration_monitor/report/stage6_validation.md)和[操作指南](D:/Code/zynq_vibration_monitor/docs/stage6_test_guide.md)。原Vivado工程仍保留旧入口，新成果使用独立的 `system_top`。

## 交互 01a19031-f4f1-7db3-bd21-9e1094271197

### 用户

现在完成最后一个阶段第七阶段。完成后先检查一遍项目是否完整符合最初的要求。并为我生成完整的上版测试方案。

### 助手（进度）

我会按第七阶段计划完成全量回归、最终源码重建和交付整理，再逐项核对最初要求。上板测试方案会覆盖接线、下载、固定数据、真实传感器、滤波效果和报警验证，并明确哪些项目已通过软件检查、哪些仍待实测。

### 助手（进度）

全量回归已开始。核对中发现，最终交付还需要补齐两个入口：可直接下载的比特流，以及在板上观察 RMS、峰值和报警的手段。我会生成原始版、滤波版和独立 ILA 调试版；调试版通过现有 JTAG 观测内部信号，不增加引脚，也不引入 PS。

接线和仪器部分会继续按 PDF 技能复核原始资料，再写入测试方案。

### 助手（进度）

原理图和 DL16 手册已重新核对；目前没有发现需要改动的接线定义。前四阶段回归已通过，后续测试仍在运行。

`skill/` 中还只有早期的英文占位说明。我会使用 skill-creator，把已经实际验证过的 FIR 定点检查、双工具仿真和资源取证流程整理成项目内可复用技能，不改动全局技能目录。

### 助手（进度）

原始版和滤波版已生成比特流，时序检查通过。ILA 调试版首次生成被 Vivado 拒绝，原因是启用采集条件后，比较单元数量至少需要2个，当前设置为1个。我会修正这个调试核参数后重建，功能 RTL 保持不变。

### 助手（进度）

上板方案会分两条路径：用你现有的设备完成固定源、SensorSource、恢复和 ILA 观察；精确验证滤波频响时，再用受控数字激励，避免把手摇传感器当作标准正弦源。

我会提供离线生成的测试数据和手动回放工具。回放需要额外的3.3V USB-TTL模块，并先断开 STM32 PA9，避免两个发送端同时驱动 FPGA RX；本轮不会打开真实串口。

### 助手（进度）

三种比特流和调试版探针文件都已生成。ILA 调试版的50MHz建立/保持裕量为5.432ns/0.014ns，尚未下载到板上。

新增回放工具的离线自检已通过。最终一键回归曾遇到 PowerShell 把 unittest 的正常 stderr 进度当作异常，我已修正包装脚本，正在验证完整入口能顺利跑完。

### 助手（进度）

最终一键回归已全部通过：全部 RTL 自检、PC协议与回放工具测试、C/Python对照，以及 FixedSource、SensorSource 两个 Keil 目标均成功；Keil为0错误、0警告。

需求核对的结论是：软件和工具验证链路已完整，但新版整机板测、传感器校准和真实采样稳定性仍待验证。我会将当前成果冻结为 `v1.0-rc1` 软件候选版，并在交付文档中保留这些边界。

## 交互 01a19103-6c9c-77b1-9877-4c606bae396b

### 用户

之前第七阶段由于额度不足中断，请继续未完成的部分

### 助手（进度）

我会先核对已有的回归、构建记录和交付目录，从未完成的打包、哈希核验与文档检查处继续，避免重复运行已通过的测试。

### 助手（进度）

已补齐中断前未完成的冻结包：`v1.0-rc1` 包含177个自有源码/文档文件和97项交付文件，三版 FPGA、两套 STM32 固件及上板测试数据均已归档。现在进行最后一遍独立哈希与压缩包核验，并确认完整上板方案的链接可用。

### 助手

已继续完成第七阶段剩余的打包、冻结和完整性核验，生成 **v1.0-rc1 软件候选版**。

- ModelSim/XSim全部阶段回归通过；PC测试、C/Python对照及两个Keil目标通过。
- 已提供原始版、滤波版、ILA调试版，以及STM32的AXF/HEX。
- 177个源码/文档文件、97项交付文件的哈希与源码ZIP校验均通过。

请查看：

1. [完整上板测试方案](D:/Code/zynq_vibration_monitor/docs/board_test_plan.md)：接线、下载、DL16、滤波、ILA报警、异常恢复及冷启动。
2. [最初要求完整性核对](D:/Code/zynq_vibration_monitor/report/requirements_audit.md)。
3. [第七阶段验收报告](D:/Code/zynq_vibration_monitor/report/stage7_validation.md)。
4. [交付包清单](D:/Code/zynq_vibration_monitor/build/release/v1.0-rc1/release_manifest.json)。

核对结论是：**已知软件要求已满足；新版整机板测、传感器校准和真实采样稳定性仍待验证。** 本轮没有操作硬件。

接下来按方案从 **B01接线复核 → B02 FixedSource＋原始版通信** 开始。

## 交互 01a19109-9843-7ad2-a20d-7c0369d5af92

### 用户

请重新检查第七阶段与上一次中断前预定的任务完成是否完整。

### 助手（进度）

我会把中断前的第七阶段计划与当前文件、回归日志、发布包逐项对照，重点检查是否有“文档写了完成、实际成果却缺失”的情况。发现遗漏后会补齐，并说明哪些任务已完成、哪些仍待实物验证。

### 助手（进度）

复核确认，全量回归和三版最终构建都已实际完成，冻结包哈希也一致。但发现一项交付整理遗漏：仿真波形，以及最终构建、首次失败的部分日志，还留在 `build` 中，没有收入交付包。

我会补做独立证据包，保留原 `rc1` 冻结内容不变。另外，原计划中的“整机冷启动和实物演示”确实尚未执行，仍不能列为完成。

### 助手（进度）

证据补充包已生成：42份 ModelSim/XSim 波形全部归档，ZIP及逐文件SHA256校验通过；构建和失败修复日志也已补入。原 `rc1` 的177项冻结源码和97项交付文件保持不变。

复核结论是：第七阶段的软件任务已完成；原计划中的整机冷启动、ILA实机采集和完整实物演示仍待执行。

### 助手

已按中断前的原计划重新核对。**软件与交付任务现已完整，但整机实物验收尚未完成。**

| 预定任务 | 复核结果 |
|---|---|
| 全部TB回归、失败案例重跑 | 已完成，有实际日志 |
| 最终综合、实现、时序与DRC检查 | 已完成，保留8项DRC警告 |
| 源码及固件冻结、操作说明、AI记录 | 已完成 |
| 波形和日志整理 | **发现遗漏，本轮已补齐** |
| 整机冷启动、ILA实机采集、完整演示 | 尚未执行 |

具体遗漏是：42份仿真波形及部分构建、首次失败日志原先只留在 `build`，没有收入交付包。现在已生成独立证据补充包，逐文件哈希和ZIP校验通过，**原rc1冻结包未改动**。

详见[逐项复核报告](D:/Code/zynq_vibration_monitor/report/stage7_completion_review.md)及[补充包清单](D:/Code/zynq_vibration_monitor/build/release/v1.0-rc1-evidence-20261031/review_manifest.json)。

因此，上次“完成”的表述应限定为软件收尾与交付；原计划中的实物验收仍需按上板方案执行。

## 交互 01a1912e-74eb-7c82-abde-496b2f747946

### 用户

 [Vivado 12-4739] set_false_path:No valid object(s) found for '-to [get_pins u_core/u_processing/filtering/communication/u_rx/rx_meta_reg/D]'. [D:/Code/zynq_vibration_monitor/constr/system_uart_rx_cdc.xdc:2]
Resolution: Check if the specified object(s) exists in the current design. If it does, ensure that the correct design hierarchy was specified for the object. If you are working with clocks, make sure create_clock was used to create the clock object before it is referenced.

在vivado open elaborated design时出现如上警告

### 助手（进度）

我会先检查这份 CDC 约束的用途和工程加载设置，确认警告是否因为实现阶段约束被提前加载到 Elaborated Design，再修正适用阶段。

### 助手（进度）

找到了两处配置问题：

- `system_uart_rx_cdc.xdc` 被勾选了用于综合，Vivado会在展开设计时提前读取它。
- 磁盘工程保存的顶层仍是旧 `top`，但新旧两份 CDC 约束同时启用。你报错中的长路径属于 `system_top`。

我会提供一段按顶层选择 CDC 文件的修正脚本，并在隔离工程中验证。修正会保留真正的同步链约束，不用忽略警告来掩盖对象错误。

### 助手（进度）

已在隔离工程中复现相同的 `12-4739` 警告。修正配置后，旧顶层的展开设计已不再出现该警告；正在检查完整系统顶层，并确认综合后约束能命中第一级同步寄存器、第二级同步路径仍正常计时。

### 助手（进度）

两种顶层的隔离检查均已通过：修正后的展开设计不再出现 `12-4739`；综合后，CDC 目标各命中一个寄存器引脚，第二级同步路径仍正常计时。修正脚本和操作说明已准备好，你在当前 Vivado 工程中执行两行 Tcl 命令即可应用。

### 助手

这是 **CDC 约束的加载阶段和顶层配置不匹配**导致的，不需要修改 UART RTL。

我检查到当前磁盘工程中：

- 顶层仍是旧的 `top`，报错路径属于完整系统 `system_top`。
- 新旧两份 CDC 约束同时启用，且 `system_uart_rx_cdc.xdc` 被设置为用于综合。它应仅用于实现阶段。[AMD 官方说明](https://docs.amd.com/r/2024.1-English/ug903-vivado-using-constraints/Synthesis-and-Implementation-Constraint-Files)

请按以下操作修正：

1. 关闭当前 **Elaborated Design**，回到工程界面。
2. 在 Vivado 下方 **Tcl Console** 执行：

   ```tcl
   set vibration_top system_top
   source D:/Code/zynq_vibration_monitor/scripts/configure_project_cdc.tcl
   ```

3. 确认出现 `PASS project_cdc top=system_top`，然后重新执行 **Open Elaborated Design**。

脚本会选择完整系统顶层、禁用旧 CDC，并将新 CDC 设置为仅用于实现。

我已用 Vivado 2020.2 在隔离工程中验证：两种顶层修正后均不再出现该警告，综合后的目标引脚匹配正确，第二级同步路径仍正常计时。没有直接改写你正在打开的工程，也没有修改 RTL 或原 XDC 内容。

详细操作与测试证据见：[警告修正说明](D:/Code/zynq_vibration_monitor/docs/vivado_cdc_warning_fix.md)。

## 交互 01a1913b-23e6-70c0-822f-fb0cf2cc481c

### 用户

 [Synth 8-4445] could not open $readmem data file 'fir_lp_63_q16.mem'; please make sure the file is added to project and has read permission, ignoring [D:/Code/zynq_vibration_monitor/rtl/fir_lp_serial.v:29]

如上，执行命令后仍然出现警告

### 助手（进度）

这条警告表示 Vivado 找不到 FIR 系数文件。我会检查 `$readmemh` 的引用和工程文件配置，补齐加载方式，并实际验证综合时能读到系数。

### 助手（进度）

系数文件存在且可读取，但当前 GUI 工程没有登记它。上次隔离检查把系数复制到了运行目录，因此没覆盖到这个工程资源缺失的情况。

我会补上系数文件的工程登记，并用独立工程按实际 `Run Synthesis` 流程验证。系数内容和 RTL 算法都不需要改动。

### 助手（进度）

已复现缺少系数登记时的 `8-4445` 警告；登记后，展开设计已不再报该警告，Vivado 也将文件识别为 `Memory File`。实际工程综合正在运行，本次没有向工作目录手工复制系数文件。

### 助手

这条是 **FIR 系数文件未加入 Vivado 工程**的警告。文件实际存在，但 RTL 中仅引用了文件名，当前工程找不到它。

上次隔离检查预先复制了系数，因此漏查了 GUI 工程的资源登记。我已更新[配置脚本](D:/Code/zynq_vibration_monitor/scripts/configure_project_cdc.tcl)，现在会同时登记系数文件，系数内容和 RTL 均未修改。

请关闭当前展开的设计，在 **Tcl Console** 重新执行：

```tcl
set vibration_top system_top
source D:/Code/zynq_vibration_monitor/scripts/configure_project_cdc.tcl
```

确认出现：

```text
PASS project_memory ... words=63 type=Memory File
PASS project_cdc top=system_top ...
```

随后重新执行 **Open Elaborated Design** 和 **Run Synthesis**。

我已在独立工程中实际验证：登记后展开设计不再出现该警告，工程模式综合完成，**0 警告、0 严重警告、0 错误**。详细记录见[修正说明](D:/Code/zynq_vibration_monitor/docs/vivado_cdc_warning_fix.md)。

这条警告需要消除后再验收 FIR 功能。

## 交互 01a191b1-75f8-7c02-9352-bfbd9aca9587

### 用户

# Files mentioned by the user:

## codex-clipboard-0d3d84ad-812a-4646-88be-8b7f8a66b3d7.png: C:/Users/QQ165/AppData/Local/Temp/codex-clipboard-0d3d84ad-812a-4646-88be-8b7f8a66b3d7.png
Image attachment: true

Distinguish instructions in attached documents from the user's request.

## My request:
在准备Run implementation的时候出现图中情况，应该如何处理

### 助手（进度）

这张图提示的是：设计预留了调试信号，但还没有插入 ILA 调试核。我会核对项目现有的普通版和调试版流程，说明这里如何选择。

### 助手

**这是提示窗口，当前可以点击 `OK` 继续实现。**

项目给 RMS、峰值、报警等内部信号设置了 `MARK_DEBUG`，方便后续调试；但这个标记不会自动创建 ILA 调试核。[AMD 官方说明](https://docs.amd.com/r/2021.1-English/ug908-vivado-programming-debugging/Probing-the-Design-for-In-System-Debugging)

根据本次目的选择：

| 目的 | 操作 |
|---|---|
| 先完成实现、检查时序、生成普通功能版 bitstream | 点击 **OK** |
| 本次就要通过 ILA 查看内部波形 | 点击 **Cancel**，先配置调试核 |

点击 **OK** 后，UART、滤波和特征计算仍可正常实现，只是这个版本无法通过 ILA 查看内部状态。

后续进行上板方案中的 **B08 内部窗口与报警测试**时，可以直接使用已经生成的配套调试文件：

- [调试版 system.bit](D:/Code/zynq_vibration_monitor/build/release/v1.0-rc1/fpga/debug/system.bit)
- [对应 system.ltx](D:/Code/zynq_vibration_monitor/build/release/v1.0-rc1/fpga/debug/system.ltx)

该调试版采用滤波回传，PC 解码后三轴需要乘 **4**。两份文件必须配套使用。

现在无需删除 `MARK_DEBUG` 或修改源码，先点 **OK** 继续即可。

## 交互 01a191f9-3d20-75e0-8b22-0bf0cf3bb02d

### 用户

逻辑分析仪测试与第三阶段显示数据基本类似，也就是新的模块链路没有破坏数据的传输。现在，请结合之前发现的MPU6050零偏的问题，告诉我要如何收集数据并进行校准

### 助手（进度）

我会先核对当前 MPU6050 配置、此前正反放置的数据和已有采集工具，再给你具体的六面静置采集与校准步骤，并区分零偏修正和比例校准。

### 助手（进度）

当前固件会回读量程等关键配置，适合先保留不变、采集原始数据。校准应使用 D0 上的 STM32 原始数据，或 FPGA 的 raw 回传；经过 FPGA 去直流和 FIR 的数据不能用于估计静态零偏。

此前 Z 轴约 `+5288` 计数仍只是两段短记录的初估。这次需要六个姿态的较长记录，并另采一轮验证，才能判断补偿是否稳定有效。

### 助手

建议采用**六面静置校准：先采集原始数据，计算三轴零偏和比例系数，再用另一轮数据验证**。此前 Z 轴约 `+5288` 计数只是短记录的初估，暂时不要直接写入程序。

完整方案已保存到：[MPU6050 采集与校准说明](D:/Code/zynq_vibration_monitor/docs/mpu6050_calibration.md)。

1. **保持现有 SensorSource 程序，先确认实际配置。**

   用逻辑分析仪捕获一次初始化过程，核对配置读回，尤其是：

   - `WHO_AM_I(0x75)=0x68`
   - `ACCEL_CONFIG(0x1C)=0x00`
   - `CONFIG(0x1A)=0x02`
   - `SMPLRT_DIV(0x19)=0x03`

   对应当前设计目标为 ±2g、16384 计数/g、250 样本/s。先完成初始化核查，再通电静置约 3～5 分钟，保持安装和环境条件稳定。

2. **使用未经 FPGA 滤波的原始数据。**

   优先采集你现在 **D0 上的 STM32 UART**。也可以使用已确认一致的 FPGA **raw 回传**。

   **不能使用 filtered/debug 版回传来估计零偏**：FPGA 去直流已经移除了静态分量，乘 4 也无法恢复。

3. **采集六个姿态，每个姿态稳定记录 20 秒。**

   根据传感器轴标识摆放，用支撑固定，避免手持。每次翻转后放手等待 3～5 秒，再开始记录。

| 文件编号 | 放置要求 | 校正后的目标 X/Y/Z，单位 g |
|---|---|---|
| `xp_r1` | X 正方向竖直向上 | +1 / 0 / 0 |
| `xn_r1` | X 正方向竖直向下 | -1 / 0 / 0 |
| `yp_r1` | Y 正方向竖直向上 | 0 / +1 / 0 |
| `yn_r1` | Y 正方向竖直向下 | 0 / -1 / 0 |
| `zp_r1` | Z 正方向竖直向上 | 0 / 0 / +1 |
| `zn_r1` | Z 正方向竖直向下 | 0 / 0 / -1 |

不要未经核实就把“元件面朝上”等同于“Z 正方向朝上”。

第一轮完成后，**重新摆放，再采第二轮六个姿态**，文件后缀改为 `_r2`。第一轮计算参数，第二轮独立验证，共 12 份记录。

4. **DL16 按下面设置采集并保存。**

   - 只启用现有 D0，UART 仍为 **115200、8N1、lsb-first、不反相、hex**。
   - 长记录优先使用 **Stream**，采样率可选 **5 MS/s**；若无此档，选可用的 10 或 20 MS/s。
   - 每个姿态记录 **20 秒**，名义约 5000 包。
   - 若无法连续记录 20 秒，可以同一姿态分成多段，例如 10 段、每段 2 秒，并全部保存。

   每份记录保存 **原始 `.atkdl` 文件和 D0 的 UART 协议解码 CSV**，例如 `xp_r1.atkdl`、`xp_r1_uart.csv`。截图不适合计算正式系数；波形 BIN 也不等于解码后的 UART 字节。

5. **计算每轴的零偏和比例。**

   先检查包头、XOR、序号连续性，再将 XYZ 按**大端、有符号 16 位**还原。每份记录统计有效包数、均值、标准差、最小/最大值，并比较前后半段是否漂移。

   以 X 轴为例，设正面记录中 X 的均值为 `μ+`，反面记录中 X 的均值为 `μ−`：

   ```text
   零偏 bx = (μ+ + μ−) / 2
   灵敏度 Sx = (μ+ − μ−) / 2       单位：计数/g

   校正后 ax = (raw_x − bx) / Sx   单位：g
   ```

   若继续保持 16384 计数/g 的整数表示：

   ```text
   corrected_x = round((raw_x − bx) × 16384 / Sx)
   ```

   Y、Z 分别使用自己的正反记录计算。这种方法同时估计偏置和比例。[ADI 两点校准说明](https://www.analog.com/en/resources/app-notes/2020/07/22/16/49/an-1057.html)

   **不要直接减去某一个平放姿态的全部三轴均值**，那样会把该姿态的重力分量也作为零偏扣除。

6. **用第二轮数据验收，再固化参数。**

   使用第一轮得到的固定参数处理第二轮数据。摆放准确时，应看到：

   - 主轴接近 `+1g` 或 `−1g`，另外两轴接近 `0g`。
   - 三轴合成幅值接近 `1g`，而非三轴同时为零。
   - 前后半段均值稳定，重复摆放后结果接近。

   可先以主轴误差不超过 `0.05g`、合成幅值均值在 `0.97～1.03g` 作为项目初步目标；这是建议验收目标，不是器件出厂保证。

验证通过后，再把参数应用到 **STM32 读取加速度之后、UART 打包之前**，明确整数舍入和溢出处理，并重新检查回传、滤波与 RMS/报警路径。本次仅新增校准方案并更新开发日志，尚未修改固件或写入补偿值。

## 交互 01a19216-6015-78a3-b98d-86510821beb4

### 用户

现在采集了x朝上。请你根据之前的操控经验告诉我如何保存

### 助手（进度）

我先核对 ATK-Logic 的保存和导出入口，给你准确步骤。这次需要保存原始波形，以及 D0 的 UART 协议解码 CSV。

### 助手

这次 X 正方向朝上的记录，建议保存为 **`xp_r1`**。按之前使用 ATK-Logic 的方法，需要保存两个文件。

1. **保存原始波形**

   点击左上角 **文件 → 另存为**，保存为：

   ```text
   D:\Code\zynq_vibration_monitor\data\measured\mpu6050_calibration\xp_r1.atkdl
   ```

   文件夹不存在时可以新建。`.atkdl` 用于以后重新打开完整波形，务必先保存，再开始下一次采集。

2. **导出 D0 的 UART 解码 CSV**

   在右侧 **协议解码 → 数据** 中，通过 **更多/协议选择** 切换到 **D0 对应的 UART 解码器**，确认其通道是 `TX = Channel 0`。

   等待解码完成，点击数据表上方的 **“导出协议数据”** 按钮。鼠标停在图标上可以查看提示。格式选择 CSV；如果提供范围选项，选择整段记录，保存为：

   ```text
   D:\Code\zynq_vibration_monitor\data\measured\mpu6050_calibration\xp_r1_uart.csv
   ```

   注意：这里要导出**协议数据**；“文件 → 导出原始数据”得到的波形 BIN 不能代替这个 CSV。

3. **保存后确认**

   - 文件夹里有 `xp_r1.atkdl` 和 `xp_r1_uart.csv`。
   - CSV 包含时间和 UART 十六进制字节，可看到反复出现的 `A5 5A`。
   - 保留软件导出的原始 CSV，不必用 Excel 重新保存。
   - 记下这次实际采集时长、姿态和是否全程静止。

下一面如果采集 X 正方向朝下，就对应保存为 **`xn_r1.atkdl`、`xn_r1_uart.csv`**。

## 交互 01a1921b-700f-76e1-85a2-74ad49ede6b0

### 用户

现在采集了y朝上。请你根据之前的操控经验告诉我如何保存

### 助手

这次 **Y 正方向朝上、第一轮采集**，保存编号用 **`yp_r1`**。

1. **保存原始波形**

   点击 **文件 → 另存为**，保存到之前的文件夹：

   ```text
   D:\Code\zynq_vibration_monitor\data\measured\mpu6050_calibration\yp_r1.atkdl
   ```

2. **导出 D0 的 UART 数据**

   在右侧 **协议解码 → 数据** 中，选择 D0 对应的 UART 解码器，确认 `TX = Channel 0`。

   点击 **“导出协议数据”**，选择 CSV，导出整段记录，保存为：

   ```text
   D:\Code\zynq_vibration_monitor\data\measured\mpu6050_calibration\yp_r1_uart.csv
   ```

   注意选择“导出协议数据”，不要用“导出原始数据”的波形 BIN 代替。

3. **确认两个文件都已保存**，记录本次实际采集时长和是否全程静止，再开始下一面采集。不要覆盖之前的 `xp_r1` 文件。

## 交互 01a1921d-f6d2-74f3-a4cb-e66738bbea62

### 用户

x，y的正反两面都采集完毕，结合你之前采集的z正反两面数据，请进行分析并修正。

### 助手（进度）

我会先查找新保存的 X、Y 正反面记录，检查解码、样本量和静止稳定性，再与此前 Z 轴记录比较。此前 Z 数据每面只有约 12 组，我会先判断它是否足以参与校准，再决定参数如何修正。

### 助手

这次 X/Y 四份记录与此前 Z 正反面记录，是否使用同一个 MPU6050，且 STM32 固件、量程和传感器配置均未改变？
- 是，同一模块且程序和配置未改
- 有更换模块或修改程序／配置
- 不能确定

### 助手（进度）

四份新记录都找到了，但每份实际仍是 **50 ms、12～13 个完整包**，并非计划的 20 秒。完整包的校验和序号连续性检查通过。

六面数据算出的零偏初值约为 X：`+704`、Y：`−535`、Z：`+5288` 计数；同时，X 朝上和旧 Z 朝下记录的横轴残差较大，可能与摆放倾斜有关。我会生成离线校正结果和质量报告，明确这些系数目前能支持到什么程度。

### 用户

<send_user_message_question_reply>
[{"questionItemId":"[\"request_user_input_async\",\"call_aa0974e2fe8844cdaaa2cd741fa71175\",0]","question":"这次 X/Y 四份记录与此前 Z 正反面记录，是否使用同一个 MPU6050，且 STM32 固件、量程和传感器配置均未改变？","answer":"z的正反面是在第三阶段采集的，MPU6050相同"}]
</send_user_message_question_reply>

### 助手（进度）

收到，同一模块的旧 Z 记录可以用于本次初步估计，但跨阶段配置一致性仍未获得实测证明。

我会保留原始采集模式，新增一个单独的“实验校准”固件目标：在 STM32 打包前做三轴减偏和比例校正，输出仍按 16384 计数/g 表示。这个版本用于验证初值，不作为正式校准通过的版本；原始记录和冻结交付包都会保留。

### 助手（进度）

实验校准版的代码已写好。它使用 64 位中间量做定点运算，并处理舍入和有符号 16 位饱和；Keil 中也保留了校正前后数值的观察变量。

接下来会实际运行三轴全输入范围的 C/Python 对照、采集错误恢复测试，以及 Keil 编译。这些检查验证代码实现，传感器精度仍需较长记录和独立复测确认。

### 助手（进度）

软件检查已通过：三轴共 **196608 个输入值**的定点结果与独立参考一致，和理想浮点校正相比最多差 1 个计数；原始两目标及实验校准目标的 Keil 编译均为 0 错误、0 警告。

另外，新 X 朝下记录中有一次约 **3.003 ms** 的包间隔，旧 Z 朝上记录也有类似现象。我会将它单独记录为待核查的采样时序问题；零偏补偿不能修复这一点。

### 助手

已完成六面数据分析，并新增了**实验校准固件**。当前可以试验补偿效果，但还不能判定正式校准完成。

根据四份新 X/Y 记录和此前 Z 正反记录，得到以下初值：

| 轴 | 零偏，计数 | 比例系数 |
|---|---:|---:|
| X | +704.160 | 1.007626 |
| Y | −535.333 | 0.994537 |
| Z | +5288.417 | 0.983183 |

校正公式为：

```text
校正值 = round((原始值 − 零偏) × 比例系数)
```

输出仍按 **16384 计数/g** 表示。

实际数据还有三个限制：

- 六份记录均只有 **50 ms、12～13 个完整包**，共 73 包，尚无长记录和独立第二轮验证。
- 校正后部分横轴仍有约 `0.066～0.137g` 残差，可能涉及摆放倾斜、偏置变化或交叉轴误差。
- X 朝下有一次约 `3.003 ms` 包间隔，旧 Z 朝上也有类似现象；本次补偿没有修复采样时序。

程序已做以下修改：

- 新增三轴定点校正模块，使用 64 位中间量，处理舍入和 signed16 饱和。
- 新增独立的 [实验校准 Keil 工程](D:/Code/zynq_vibration_monitor/stm32/keil/vibration_calibration.uvprojx)，目标为 **`SensorCalibratedTrial`**。
- 原来的 `SensorSource` 继续发送原始数据，十字节布局和 XOR 保持不变。

验证已实际完成：

- 三轴共 **196608 个输入值**通过 C/Python 对照，最终整数结果与理想浮点校正最多相差 1 个计数。
- 错误恢复、饱和和固定源绕过检查通过。
- 三个 Keil 目标均为 **0 错误、0 警告**。

已生成[实验校准 HEX](D:/Code/zynq_vibration_monitor/build/stm32/SensorCalibratedTrial/vibration_monitor.hex)，**尚未烧录或板测**。完整结果见[分析与修正报告](D:/Code/zynq_vibration_monitor/report/mpu6050_calibration_analysis_20261031.md)。

下一步应补齐同一次预热后的六面长记录及第二轮验证。**补采原始数据时使用原 `SensorSource`；实验版的 D0 已经校正，不能再次当作原始数据拟合。**

## 交互 01a19233-9ed8-7500-abd2-c66636dc657b

### 用户

还有一个问题。我用逻辑分析仪的d0接pa9，d1接fpga的m15(tx)，也就是你之前给出的接线。在现在的程序运行中这两个在逻辑分析仪中uart解码的数据是一样的。这是正确的吗

### 助手

**如果 FPGA 运行的是原始回传模式，两路解码数据相同就是正确的。**

数据路径是：

```text
STM32 PA9 → D0观察 → FPGA接收、校验 → M15发送 → D1观察
```

FPGA 收到合法包后重新发送，因此对应包的**序号、XYZ 和校验字节应完全一致**，D1 的数据包会延后出现。

不同模式的预期如下：

| FPGA 模式 | D0 与 D1 的关系 |
|---|---|
| `raw`，`RETURN_FILTERED=0` | 对应十字节包应一致 |
| `filtered` 或已交付的 `debug` 版 | XYZ 通常不同；D1 是滤波结果，解码后需乘4恢复尺度 |

当前 `system_top` 的默认值是 **`RETURN_FILTERED=0`**。如果你没有修改这个参数就生成并下载 bitstream，看到两路一致符合预期，但这只能验证回传链路，不能证明滤波和报警功能已经通过板测。

另外，**即使 STM32 已烧录实验校准版，两路在 raw 模式下仍应一致**：校准发生在 STM32 打包之前，所以 D0 已经是校正值，FPGA 再原样回传给 D1。

因此，检查校准效果应看同一姿态下 XYZ 的实际数值，以及校准前后的差异；不能通过 D0、D1 是否不同来判断校准是否生效。

## 交互 01a19243-58a9-76d1-9d44-0bed495f666f

### 用户

[此处为跨聊天引用缓存；来源标识保留在原聊天，不将其当成本聊天的独立交互。]
## My request:
[FPGA学习项目建议](chatgpt-conversation://6a96c59b-b664-83ea-af67-c74b80f26f4b) 请看这段对话中的内容。这里面讲到了这个项目具体的实施。请检查现在还差哪些内容。

### 助手（进度）

我会先读取这段对话中项目实施方案的完整内容，再与当前代码、测试报告和板测记录逐项核对，区分已完成、有待验证和尚未实现的内容。

### 助手（进度）

目前接口返回了这段对话的 5 轮内容，主要涉及硬件、开发流程、Git、复现脚本和 Skill；没有返回更早的完整选题方案或正式赛事指南。

核对中发现两项交付缺口：本地 Git 仍只有最初的提交，各阶段成果尚未形成提交历史；另外，完整滤波、RMS 和报警的板上验收仍缺证据。旧对话里的硬件说明也有版本差异，我会使用 PDF 技能再核对原理图，避免把已更正的内容列成待办。

### 助手（进度）

进一步核对后，工程收尾还有两点需要补齐：

- 统一的第七阶段回归入口尚未包含新增的实验校准测试；它们目前是单独测试通过的。
- 已有从源码生成 bitstream 的脚本，但还没有原对话建议的“一键创建完整 Vivado GUI 工程”入口，也没有干净检出的复现演练记录。

FFT、PS、实时图形上位机不属于目前已确认的第一版范围。我会将这些扩展项与实际缺口分开列出。

### 助手

我读取了该链接目前可访问的 **5 轮内容**，并与当前工程核对。**核心 PL 功能的软件已实现，但完整板测和工程交付还没有收尾。** 此前只强调剩余板测，不够完整。

目前主要还差以下内容：

| 待完成项目 | 当前情况与缺口 |
|---|---|
| **正式传感器校准** | 实验补偿程序已完成，但六面记录每份只有50 ms，缺少长记录、配置实测回读和独立第二轮验证 |
| **采样周期稳定性** | 已发现约3 ms的包间隔，尚未定位；需要至少60秒记录，检查周期、序号、错误及缺包 |
| **FIR板上效果验证** | D0/D1相同说明raw回传正常，不能证明滤波有效；还需filtered模式、明确尺度和已知输入的效果对照 |
| **特征与报警板测** | RMS、峰值、均方值和报警已通过仿真，但缺少ILA实物记录及置位、解除验证 |
| **整机可靠性验收** | 还需长时间运行、断流恢复、复位和三轮冷启动演示 |
| **Git版本管理** | 本地目前仍只有初始提交 `e4145f0` 和标签 `v0.0`，大量阶段成果尚未提交；本地rc1目录不等于Git版本已经保存 |
| **统一回归与复现** | 新增校准测试目前单独通过，尚未纳入第七阶段统一入口；也没有干净检出后的完整复现记录 |
| **竞赛交付核对** | Skill、源码包和AI日志已有，但正式报告、演示材料、Skill效果证据等具体要求，仍需赛事指南原文确认 |

另外，原对话建议的 **`create_project.tcl` 一键创建GUI工程**目前没有实现。已有脚本可以直接从源码生成 bitstream，因此这是工作流完善项，不是缺少核心算法。

按目前批准的第一版范围，**不需要为了补齐项目而立即添加 FFT、PS、Linux 或图形上位机**。应先完成现有链路的量化板测和交付闭环。

建议顺序是：**保存当前Git检查点 → 校准与采样检查 → 滤波/ILA/报警板测 → 长时间及冷启动 → 统一回归、干净复现和最终冻结。**

详细核对已写入[项目差距报告](D:/Code/zynq_vibration_monitor/report/reference_conversation_gap_audit_20261031.md)，并更新了[实物验收记录](D:/Code/zynq_vibration_monitor/report/final_board_record.md)。本次仅修改文档，没有修改程序、重新运行仿真或操作硬件。

## 交互 01a1924c-9a05-7ce3-b276-02727f5fd84d

### 用户

先将当前内容上传到git

### 助手（进度）

我会先检查 Git 远程、待提交文件和忽略规则，排除缓存与厂商库，再将当前源码、文档和选定测试证据提交并推送。

### 助手（进度）

待提交内容约 5.3 MB，没有混入 Vivado 工程缓存或厂商库。我发现两份 Python 缓存仍会被提交，会先补齐忽略规则，并设置 Git 保留文件的原始字节，避免换行转换破坏已有哈希证据，然后推送到当前的 `origin/main`。

### 助手（进度）

暂存检查完成：本次有 277 个文件变更，约 5.3 MB；暂存内容与工作区原始字节一致，缓存和厂商文件已排除。现在创建当前进度的提交并推送，提交中会保留“实验校准、完整板测待验收”的状态。

### 助手

已成功提交并推送到 GitHub 的 `main` 分支。

- 提交：[4714435](https://github.com/FFsteve/zynq_vibration_monitor/commit/4714435652d021a20c757520b8574498cf6123eb)
- 包含源码、文档和选定测试证据，共 277 个文件变更。
- 已确认远端与本地提交一致，工作区干净。

构建产物、Vivado 缓存、厂商库及原始 PDF 按忽略规则保留在本地。
