FFsteve/zynq_vibration_monitor/report/evidence/fpga_fixed_return_20261029_01.png

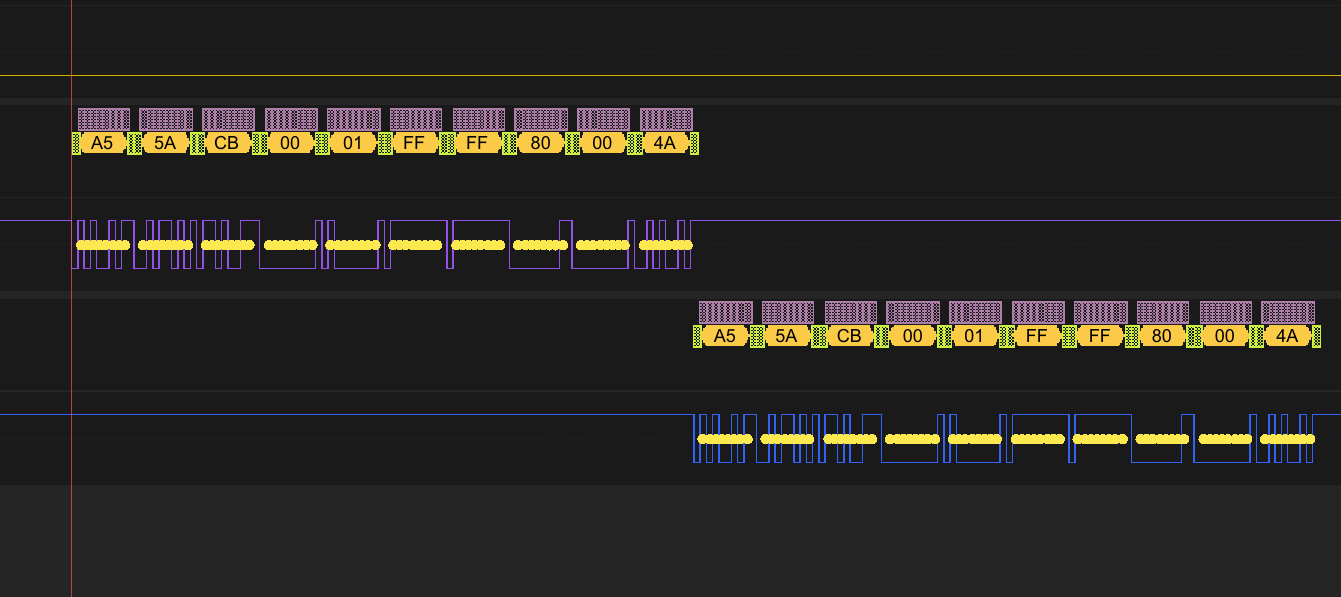
report/evidence/fpga_fixed_return_20261029_01.png
