FFsteve/zynq_vibration_monitor/report/evidence/stage6_7_plan_20261031.png

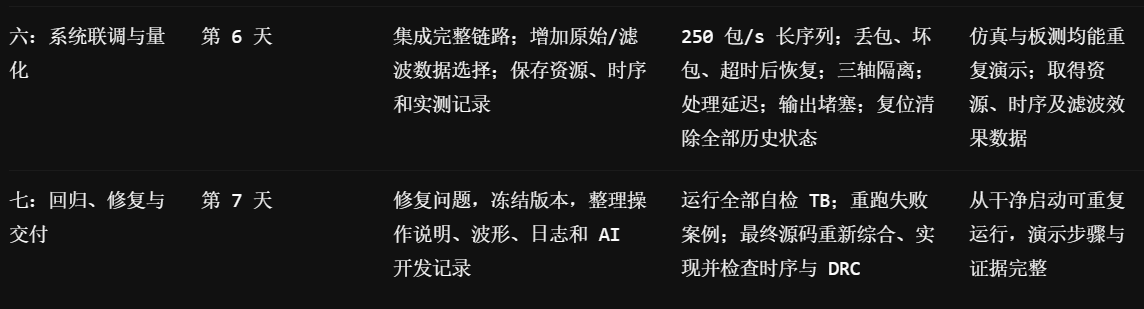
report/evidence/stage6_7_plan_20261031.png
