FFsteve/zynq_vibration_monitor/report/evidence/stm32_fixed_uart_20261029_04.png

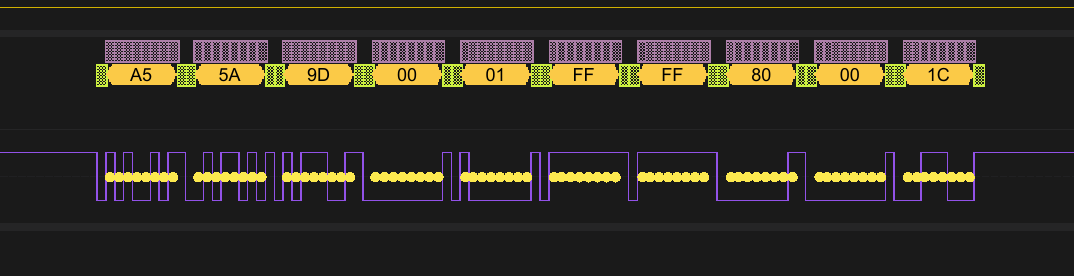
report/evidence/stm32_fixed_uart_20261029_04.png
