FFsteve/zynq_vibration_monitor/report/evidence/stm32_fixed_uart_timing_20261029_02.png

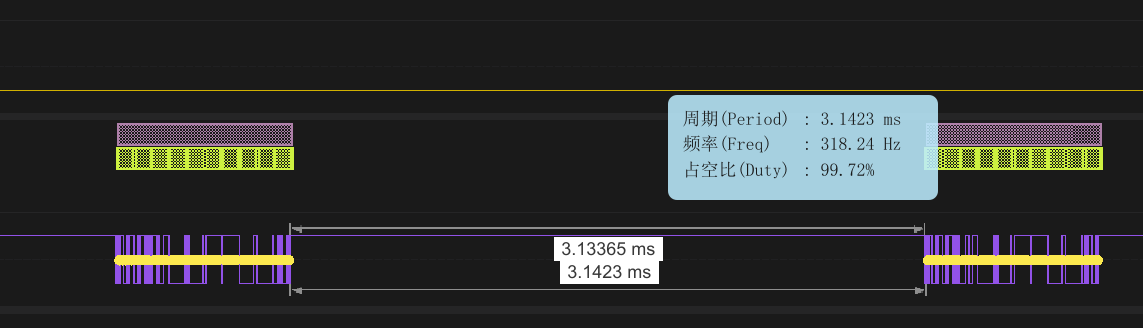
report/evidence/stm32_fixed_uart_timing_20261029_02.png
