FFsteve/zynq_vibration_monitor/report/evidence/stm32_fixed_uart_timing_20261029_03.png

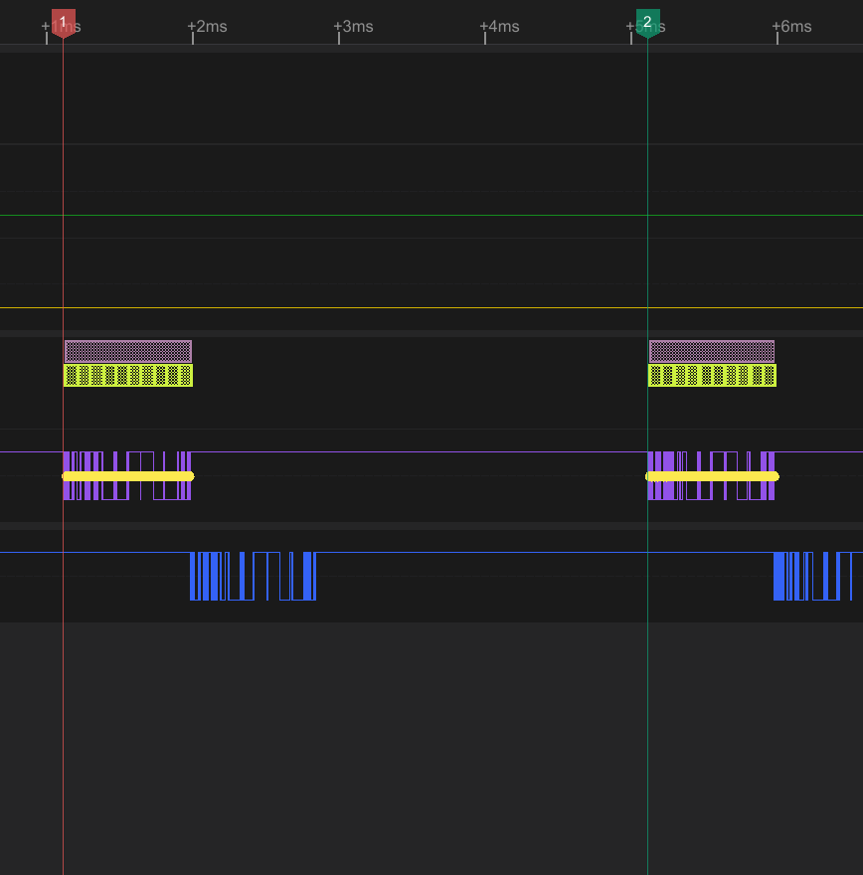
report/evidence/stm32_fixed_uart_timing_20261029_03.png
