FFsteve/zynq_vibration_monitor/board/stm32/keil_build.txt

*** Using Compiler 'V5.06 update 7 (build 960)', folder: 'D:\Keil_v5\Main_Program\ARM\ARMCC\Bin'
Rebuild target 'SensorCalibratedTrial'
compiling main.c...
compiling bsp_time.c...
compiling sample_packet.c...
compiling acquisition.c...
compiling accel_calibration.c...
compiling mpu6050.c...
compiling system_stm32f10x.c...
assembling startup_stm32f10x_md.s...
compiling core_cm3.c...
compiling stm32f10x_gpio.c...
compiling stm32f10x_rcc.c...
compiling bsp_usart1.c...
compiling misc.c...
compiling stm32f10x_i2c.c...
compiling bsp_i2c.c...
compiling stm32f10x_usart.c...
linking...
Program Size: Code=4444 RO-data=304 RW-data=60 ZI-data=1084  
"..\..\build\stm32\SensorCalibratedTrial\vibration_monitor.axf" - 0 Error(s), 0 Warning(s).
Build Time Elapsed:  00:00:01
