FFsteve/zynq_vibration_monitor/report/competition_guide_gap_analysis_20261101.md

# 正式指南对照与今晚优先级

日期：2026-11-01。依据用户提供的2026 AMD赛道选题指南3.3及第六部分。PDF共28页，相关页面已读取并渲染核对。本文件替代10月31日“尚未收到正式规则”的当前状态判断，不改写历史测试事实。完整执行安排见 [一晚计划](../docs/competition_evening_plan_20261101.md)。

| 条款 | 核对结果 | 优先级与动作 |
|---|---|---|
| 3.3.1初级组器件 | Zynq-7010属于允许范围，具体型号XC7Z010CLG400-1应写入报告 | 已满足技术范围；队员年级由报名信息自行核对 |
| 3.3.2实现方式 | 纯Verilog PL允许，PYNQ为推荐 | 不迁移架构，不补PS/PYNQ |
| 3.3.3.1工具版本 | 允许其他版本，须解释并可复现 | P0：报告明确Vivado/XSim2020.2、ModelSim2020.4、Keil ARM5.06及Python依赖 |
| 3.3.3.1大模型协作 | 必须有提示词、回答与纠错记录 | P0：已有ai_devlog，补真实交互原文/导出片段，摘要与原文分开 |
| 3.3.3.1/3.3.5.2 Skill | 必须提交，核心评价可复用性 | P0：增强现有Skill参数化使用例子、失效条件与实际可运行示例；不虚构通用PYNQ加分 |
| 3.3.3.2实物跑通 | 原核心演练及精确数值证据已取得，新蜂鸣器尚待实际发声确认 | P0：5～15分钟确认新输出或选已有实测版本作为主版本 |
| 3.3.3.3开源 | 指南强烈要求开源，并推荐可再分发许可 | P0：补许可/第三方边界与公开清单，已有origin不代表当前新增文件已发布；本轮不推送 |
| 3.3.4基线与优化 | 已有频响、精度、资源及时序；同功能架构优化的实测前后对照不充分 | P0：定义基线并如实展示；独立架构对照为有余量时提高项，不伪造节省率 |
| 3.3.5.1工程包 | 源码/TB/脚本/报告存在，旧rc1遗漏最新程序组合 | P0：最新明确组合与证据组装，区分旧全回归、新校准和新蜂鸣器专项验证 |
| 3.3.5.3设计报告 | 当前为分阶段报告，缺统一参赛正文 | P0：统一报告覆盖7类要求，复用已有真实数据 |
| 3.3.5.4目录 | 推荐结构非强制，当前rtl等布局可保留 | P0：README目录映射，检查命名，不做全仓库重命名 |
| 3.3.5.5评分 | 30/20/20/15/15 | 今晚优先叙述贡献、量化、Skill与复现，停止无关重复测试 |
| 第六部分英文海报 | 进入决赛时按AMD模板，一页英文、无队伍信息、A4彩印 | P2：余量先写内容；未取得模板时不冒充最终海报 |
| 第六部分评分细则与时间 | 另以正式细则/平台公告为准 | 最后核对平台文件格式/大小/截止要求，本文不臆造规则 |

风险集中在材料与版本组织：README及历史审计仍有未板测/未校准的过时入口；旧打包脚本不能直接产生当前最终组合；当前候选数据约1.84GiB，多为原始采集，宜精选证据和分附件。功能本身无需为了“初级组”或PYNQ推荐而重写。
