FFsteve/zynq_vibration_monitor/board/validation/buzzer_build.txt

****** Vivado v2020.2 (64-bit)
  **** SW Build 3064766 on Wed Nov 18 09:12:45 MST 2020
  **** IP Build 3064653 on Wed Nov 18 14:17:31 MST 2020
    ** Copyright 1986-2020 Xilinx, Inc. All Rights Reserved.

source D:/Code/zynq_vibration_monitor/scripts/build_buzzer.tcl
# set root [file normalize [file join [file dirname [info script]] ..]]
# foreach label {debug} {
#     set mode [expr {$label eq "raw" ? 0 : 1}]
#     set out [file join $root build buzzer_release $label]
#     file mkdir $out
#     cd $out
#     set result [file join $out implementation_result.txt]
#     set f [open $result w];puts $f "NOT_RUN";close $f
#     create_project -in_memory -part xc7z010clg400-1
#     foreach name {uart_rx uart_tx packet_parser power_on_reset return_controller monitor_core dc_remove fir_lp_serial vibration_filter filter_monitor_core isqrt_u36 window_features threshold_alarm feature_monitor_core return_source_select system_monitor_core system_top alarm_buzzer system_buzzer_top} {
#         read_verilog [file join $root rtl ${name}.v]
#     }
#     read_xdc [file join $root constr top.xdc]
#     read_xdc [file join $root constr buzzer.xdc]
#     synth_design -top system_buzzer_top -part xc7z010clg400-1 -generic RETURN_FILTERED=$mode
#     read_xdc [file join $root constr system_uart_rx_cdc.xdc]
#     foreach {port pin bank} {clk U18 34 pl_rx K14 35 pl_tx M15 35 beep M14 35} {
#         set object [get_ports $port]
#         if {[llength $object]!=1 || [get_property PACKAGE_PIN $object] ne $pin || [get_property IOSTANDARD $object] ne "LVCMOS33"} {error "IO mismatch: $port"}
#         if {[get_property BANK [get_package_pins $pin]] ne $bank} {error "Bank mismatch: $port"}
#     }
#     if {[llength [get_ports]]!=4 || [get_property PERIOD [get_clocks pl_clk_50m]]!=20.000} {error "Top interface or clock mismatch"}
#     set prefix u_core/u_processing/filtering/communication/u_rx
#     foreach name {rx_meta_reg rx_sync_reg} {
#         set object [get_cells $prefix/$name]
#         if {[llength $object]!=1 || ![get_property ASYNC_REG $object]} {error "Missing synchronizer $name"}
#     }
#     # 没有插入ILA时，明确保留�?标�?�的观测网络，不能仅依赖综合阶�?�KEEP�?
#     set debug_nets [get_nets -hier -filter {MARK_DEBUG == 1}]
#     if {[llength $debug_nets]==0} {error "Missing marked observation networks"}
#     set_property DONT_TOUCH true $debug_nets
#     set debug_registers [get_cells -hier -filter {NAME =~ debug_* && IS_SEQUENTIAL == 1}]
#     if {[llength $debug_registers]<400} {error "Missing physical observation registers"}
#     set_property DONT_TOUCH true $debug_registers
#     if {$label eq "debug"} {
#         create_debug_core stage7_ila ila
#         set_property C_DATA_DEPTH 1024 [get_debug_cores stage7_ila]
#         set_property C_TRIGIN_EN false [get_debug_cores stage7_ila]
#         set_property C_TRIGOUT_EN false [get_debug_cores stage7_ila]
#         set_property C_ADV_TRIGGER false [get_debug_cores stage7_ila]
#         set_property C_INPUT_PIPE_STAGES 0 [get_debug_cores stage7_ila]
#         set_property C_EN_STRG_QUAL true [get_debug_cores stage7_ila]
#         set_property ALL_PROBE_SAME_MU true [get_debug_cores stage7_ila]
#         set_property ALL_PROBE_SAME_MU_CNT 2 [get_debug_cores stage7_ila]
#         set clock_net [get_nets -of_objects [get_pins clk_IBUF_BUFG_inst/O]]
#         if {[llength $clock_net]!=1} {error "Missing buffered PL debug clock"}
#         connect_debug_port stage7_ila/clk $clock_net
#         set probe_index 0
#         set map_file [open probe_map.tsv w]
#         puts $map_file "probe\tsignal\twidth"
#         foreach {signal width} {
#             feature_valid_o 1 quality_valid_o 1 alarm_valid_o 1 alarm_axes_o 3
#             window_id_o 32 seq_start_o 8 seq_end_o 8
#             ms_x_o 35 ms_y_o 35 ms_z_o 35 rms_x_o 18 rms_y_o 18 rms_z_o 18
#             peak_x_o 18 peak_y_o 18 peak_z_o 18 rx_frame_count_o 32
#             dropped_count_o 32 completed_count_o 32 filter_restart_count_o 32 aborted_windows_o 32
#         } {
#             if {$probe_index>0} {create_debug_port stage7_ila probe}
#             set port stage7_ila/probe$probe_index
#             set_property port_width $width [get_debug_ports $port]
#             set signals [list]
#             if {$width==1} {
#                 set signals [get_nets debug_$signal]
#             } else {
#                 for {set bit 0} {$bit<$width} {incr bit} {
#                     set net_name [format {debug_%s[%d]} $signal $bit]
#                     set bit_net [get_nets $net_name]
#                     if {[llength $bit_net]!=1} {error "Missing debug bit $net_name"}
#                     lappend signals $bit_net
#                 }
#             }
#             if {[llength $signals]!=$width} {error "Debug probe width mismatch $signal"}
#             connect_debug_port $port $signals
#             puts $map_file "$probe_index\t$signal\t$width"
#             incr probe_index
#         }
#         close $map_file
#         implement_debug_core
#         set hub [get_debug_cores -quiet dbg_hub]
#         if {[llength $hub]} {set_property C_CLK_INPUT_FREQ_HZ 50000000 $hub}
#     }
#     opt_design
#     write_checkpoint -force optimized_system.dcp
#     report_utilization -hierarchical -file preflight_utilization.rpt
#     set cell_file [open optimized_cells.tsv w]
#     foreach cell [get_cells -hier] {puts $cell_file "[get_property NAME $cell]\t[get_property REF_NAME $cell]"}
#     close $cell_file
#     # 两模式都必须保留完整计算分支，旧的无输出发送支�?必须�?移除�?
#     set f [open hierarchy_check.txt w]
#     foreach pattern {*features/ux/* *features/uy/* *features/uz/* *alarm/* *processing/fxu/* *processing/fyu/* *processing/fzu/*} {
#         set objects [get_cells -hier -filter "NAME =~ $pattern"]
#         if {[llength $objects]==0} {error "Computation branch missing: $pattern"}
#         puts $f "$pattern cells=[llength $objects]"
#     }
#     set transmitters [get_cells -hier -filter {NAME =~ */u_tx}]
#     if {[llength $transmitters]!=1 || [get_property NAME $transmitters] ne "u_core/u_tx"} {error "Unexpected UART TX branches: $transmitters"}
#     puts $f "uart_tx=[get_property NAME $transmitters]"
#     close $f
#     place_design
#     route_design
#     report_utilization -hierarchical -file utilization_hierarchical.rpt
#     report_utilization -file utilization.rpt
#     report_timing_summary -report_unconstrained -file timing_summary.rpt
#     report_drc -file drc.rpt
#     report_cdc -details -file cdc.rpt
#     report_io -file io.rpt
#     report_exceptions -file exceptions.rpt
#     set registers [all_registers -clock pl_clk_50m]
#     set max_path [get_timing_paths -from $registers -to $registers -delay_type max -max_paths 1]
#     set min_path [get_timing_paths -from $registers -to $registers -delay_type min -max_paths 1]
#     if {[llength $max_path]!=1 || [llength $min_path]!=1} {error "Missing internal timing paths"}
#     set setup [get_property SLACK $max_path];set hold [get_property SLACK $min_path]
#     report_timing -of_objects $max_path -file internal_setup.rpt
#     report_timing -of_objects $min_path -file internal_hold.rpt
#     set sync_path [get_timing_paths -from [get_pins $prefix/rx_meta_reg/Q] -to [get_pins $prefix/rx_sync_reg/D] -max_paths 1]
#     if {[llength $sync_path]!=1} {error "Synchronizer internal path missing"}
#     report_timing -of_objects $sync_path -file rx_sync_timing.rpt
#     if {$setup<0 || $hold<0} {error "Timing failed mode=$mode setup=$setup hold=$hold"}
#     if {[llength [get_drc_violations -quiet -filter {SEVERITY == Error || SEVERITY == {Critical Warning}}]]} {error "DRC error or critical warning"}
#     write_checkpoint -force routed_system.dcp
#     set f [open $result w];puts $f "PASS buzzer_implementation mode=$mode setup_slack=$setup hold_slack=$hold";close $f
#     # 生成�?供人工下载的成果；不调用Hardware Manager或program_hw_devices�?
#     if {$label eq "debug"} {write_debug_probes -force system.ltx}
#     write_bitstream -force system.bit
#     if {![file exists system.bit]} {error "Bitstream missing"}
#     set f [open release_result.txt w]
#     puts $f "PASS buzzer_release variant=$label mode=$mode setup_slack=$setup hold_slack=$hold"
#     close $f
#     puts "PASS buzzer release $label setup=$setup hold=$hold"
#     close_project
# }
Command: synth_design -top system_buzzer_top -part xc7z010clg400-1 -generic RETURN_FILTERED=1
Starting synth_design
Attempting to get a license for feature 'Synthesis' and/or device 'xc7z010'
INFO: [Common 17-349] Got license for feature 'Synthesis' and/or device 'xc7z010'
INFO: [Device 21-403] Loading part xc7z010clg400-1
INFO: [Synth 8-7079] Multithreading enabled for synth_design using a maximum of 2 processes.
INFO: [Synth 8-7078] Launching helper process for spawning children vivado processes
INFO: [Synth 8-7075] Helper process launched with PID 24076
---------------------------------------------------------------------------------
Starting RTL Elaboration : Time (s): cpu = 00:00:05 ; elapsed = 00:00:06 . Memory (MB): peak = 1138.398 ; gain = 0.000
---------------------------------------------------------------------------------
INFO: [Synth 8-6157] synthesizing module 'system_buzzer_top' [D:/Code/zynq_vibration_monitor/rtl/system_buzzer_top.v:4]
	Parameter RETURN_FILTERED bound to: 1 - type: integer 
	Parameter CLK_HZ bound to: 50000000 - type: integer 
	Parameter BAUD bound to: 115200 - type: integer 
	Parameter RESET_HOLD_CLKS bound to: 1024 - type: integer 
	Parameter BYTE_TIMEOUT_CLKS bound to: 100000 - type: integer 
	Parameter ACK_ONLY bound to: 0 - type: integer 
	Parameter QUEUE_DEPTH bound to: 4 - type: integer 
	Parameter GAP_TIMEOUT_CLKS bound to: 600000 - type: integer 
	Parameter WINDOW_LOG2 bound to: 7 - type: integer 
	Parameter COEFF_FILE bound to: fir_lp_63_q16.mem - type: string 
INFO: [Synth 8-6157] synthesizing module 'power_on_reset' [D:/Code/zynq_vibration_monitor/rtl/power_on_reset.v:4]
	Parameter HOLD_CLKS bound to: 1024 - type: integer 
	Parameter W bound to: 10 - type: integer 
	Parameter LAST bound to: 10'b1111111111 
INFO: [Synth 8-6155] done synthesizing module 'power_on_reset' (1#1) [D:/Code/zynq_vibration_monitor/rtl/power_on_reset.v:4]
INFO: [Synth 8-6157] synthesizing module 'system_monitor_core' [D:/Code/zynq_vibration_monitor/rtl/system_monitor_core.v:4]
	Parameter RETURN_FILTERED bound to: 1 - type: integer 
	Parameter CLK_HZ bound to: 50000000 - type: integer 
	Parameter BAUD bound to: 115200 - type: integer 
	Parameter BYTE_TIMEOUT_CLKS bound to: 100000 - type: integer 
	Parameter ACK_ONLY bound to: 0 - type: integer 
	Parameter QUEUE_DEPTH bound to: 4 - type: integer 
	Parameter GAP_TIMEOUT_CLKS bound to: 600000 - type: integer 
	Parameter WINDOW_LOG2 bound to: 7 - type: integer 
	Parameter RMS_ON bound to: 2000 - type: integer 
	Parameter RMS_OFF bound to: 1500 - type: integer 
	Parameter ASSERT_WINDOWS bound to: 2 - type: integer 
	Parameter RELEASE_WINDOWS bound to: 2 - type: integer 
	Parameter COEFF_FILE bound to: fir_lp_63_q16.mem - type: string 
INFO: [Synth 8-6157] synthesizing module 'feature_monitor_core' [D:/Code/zynq_vibration_monitor/rtl/feature_monitor_core.v:4]
	Parameter CLK_HZ bound to: 50000000 - type: integer 
	Parameter BAUD bound to: 115200 - type: integer 
	Parameter BYTE_TIMEOUT_CLKS bound to: 100000 - type: integer 
	Parameter ACK_ONLY bound to: 0 - type: integer 
	Parameter QUEUE_DEPTH bound to: 4 - type: integer 
	Parameter GAP_TIMEOUT_CLKS bound to: 600000 - type: integer 
	Parameter WINDOW_LOG2 bound to: 7 - type: integer 
	Parameter RMS_ON bound to: 2000 - type: integer 
	Parameter RMS_OFF bound to: 1500 - type: integer 
	Parameter ASSERT_WINDOWS bound to: 2 - type: integer 
	Parameter RELEASE_WINDOWS bound to: 2 - type: integer 
	Parameter COEFF_FILE bound to: fir_lp_63_q16.mem - type: string 
INFO: [Synth 8-6157] synthesizing module 'filter_monitor_core' [D:/Code/zynq_vibration_monitor/rtl/filter_monitor_core.v:4]
	Parameter CLK_HZ bound to: 50000000 - type: integer 
	Parameter BAUD bound to: 115200 - type: integer 
	Parameter BYTE_TIMEOUT_CLKS bound to: 100000 - type: integer 
	Parameter ACK_ONLY bound to: 0 - type: integer 
	Parameter QUEUE_DEPTH bound to: 4 - type: integer 
	Parameter GAP_TIMEOUT_CLKS bound to: 600000 - type: integer 
	Parameter COEFF_FILE bound to: fir_lp_63_q16.mem - type: string 
INFO: [Synth 8-6157] synthesizing module 'monitor_core' [D:/Code/zynq_vibration_monitor/rtl/monitor_core.v:4]
	Parameter CLK_HZ bound to: 50000000 - type: integer 
	Parameter BAUD bound to: 115200 - type: integer 
	Parameter BYTE_TIMEOUT_CLKS bound to: 100000 - type: integer 
	Parameter ACK_ONLY bound to: 0 - type: integer 
	Parameter QUEUE_DEPTH bound to: 4 - type: integer 
INFO: [Synth 8-6157] synthesizing module 'uart_rx' [D:/Code/zynq_vibration_monitor/rtl/uart_rx.v:6]
	Parameter CLK_HZ bound to: 50000000 - type: integer 
	Parameter BAUD bound to: 115200 - type: integer 
	Parameter SAFE_BAUD bound to: 115200 - type: integer 
	Parameter BIT_CLKS bound to: 434 - type: integer 
	Parameter HALF_CLKS bound to: 217 - type: integer 
	Parameter COUNT_WIDTH bound to: 9 - type: integer 
	Parameter BIT_LAST bound to: 9'b110110001 
	Parameter HALF_LAST bound to: 9'b011011000 
	Parameter WAIT_HIGH bound to: 3'b000 
	Parameter IDLE bound to: 3'b001 
	Parameter START bound to: 3'b010 
	Parameter DATA bound to: 3'b011 
	Parameter STOP bound to: 3'b100 
INFO: [Synth 8-6155] done synthesizing module 'uart_rx' (2#1) [D:/Code/zynq_vibration_monitor/rtl/uart_rx.v:6]
INFO: [Synth 8-6157] synthesizing module 'packet_parser' [D:/Code/zynq_vibration_monitor/rtl/packet_parser.v:5]
	Parameter BYTE_TIMEOUT_CLKS bound to: 100000 - type: integer 
	Parameter COUNT_WIDTH bound to: 17 - type: integer 
	Parameter TIMEOUT_LAST bound to: 17'b11000011010011111 
INFO: [Synth 8-6155] done synthesizing module 'packet_parser' (3#1) [D:/Code/zynq_vibration_monitor/rtl/packet_parser.v:5]
INFO: [Synth 8-6157] synthesizing module 'return_controller' [D:/Code/zynq_vibration_monitor/rtl/return_controller.v:4]
	Parameter ACK_ONLY bound to: 0 - type: integer 
	Parameter QUEUE_DEPTH bound to: 4 - type: integer 
	Parameter PW bound to: 2 - type: integer 
	Parameter CW bound to: 3 - type: integer 
	Parameter IDLE bound to: 2'b00 
	Parameter SEND bound to: 2'b01 
	Parameter ARM_DONE bound to: 2'b10 
	Parameter WAIT_DONE bound to: 2'b11 
INFO: [Synth 8-226] default block is never used [D:/Code/zynq_vibration_monitor/rtl/return_controller.v:74]
INFO: [Synth 8-6155] done synthesizing module 'return_controller' (4#1) [D:/Code/zynq_vibration_monitor/rtl/return_controller.v:4]
INFO: [Synth 8-6157] synthesizing module 'uart_tx' [D:/Code/zynq_vibration_monitor/rtl/uart_tx.v:5]
	Parameter CLK_HZ bound to: 50000000 - type: integer 
	Parameter BAUD bound to: 115200 - type: integer 
	Parameter SAFE_BAUD bound to: 115200 - type: integer 
	Parameter BIT_CLKS bound to: 434 - type: integer 
	Parameter COUNT_WIDTH bound to: 9 - type: integer 
	Parameter BIT_LAST bound to: 9'b110110001 
	Parameter IDLE bound to: 2'b00 
	Parameter START bound to: 2'b01 
	Parameter DATA bound to: 2'b10 
	Parameter STOP bound to: 2'b11 
INFO: [Synth 8-226] default block is never used [D:/Code/zynq_vibration_monitor/rtl/uart_tx.v:66]
INFO: [Synth 8-6155] done synthesizing module 'uart_tx' (5#1) [D:/Code/zynq_vibration_monitor/rtl/uart_tx.v:5]
INFO: [Synth 8-6155] done synthesizing module 'monitor_core' (6#1) [D:/Code/zynq_vibration_monitor/rtl/monitor_core.v:4]
INFO: [Synth 8-6157] synthesizing module 'vibration_filter' [D:/Code/zynq_vibration_monitor/rtl/vibration_filter.v:4]
	Parameter GAP_TIMEOUT_CLKS bound to: 600000 - type: integer 
	Parameter COEFF_FILE bound to: fir_lp_63_q16.mem - type: string 
	Parameter GW bound to: 20 - type: integer 
	Parameter GAP_LAST bound to: 20'b10010010011110111111 
	Parameter GAP_LIMIT bound to: 600000 - type: integer 
	Parameter IDLE bound to: 2'b00 
	Parameter DC bound to: 2'b01 
	Parameter FIR bound to: 2'b10 
	Parameter WAIT_RESULT bound to: 2'b11 
INFO: [Synth 8-6157] synthesizing module 'dc_remove' [D:/Code/zynq_vibration_monitor/rtl/dc_remove.v:4]
INFO: [Synth 8-6155] done synthesizing module 'dc_remove' (7#1) [D:/Code/zynq_vibration_monitor/rtl/dc_remove.v:4]
INFO: [Synth 8-6157] synthesizing module 'fir_lp_serial' [D:/Code/zynq_vibration_monitor/rtl/fir_lp_serial.v:4]
	Parameter OUT_WIDTH bound to: 18 - type: integer 
	Parameter COEFF_FILE bound to: fir_lp_63_q16.mem - type: string 
	Parameter IDLE bound to: 3'b000 
	Parameter LOAD bound to: 3'b001 
	Parameter MUL bound to: 3'b010 
	Parameter ACC bound to: 3'b011 
	Parameter ROUND bound to: 3'b100 
	Parameter OUTPUT_MAX bound to: 42'sb000000000000000000000000011111111111111111 
	Parameter OUTPUT_MIN bound to: 42'sb111111111111111111111111100000000000000000 
INFO: [Synth 8-3876] $readmem data file 'fir_lp_63_q16.mem' is read successfully [D:/Code/zynq_vibration_monitor/rtl/fir_lp_serial.v:29]
INFO: [Synth 8-6155] done synthesizing module 'fir_lp_serial' (8#1) [D:/Code/zynq_vibration_monitor/rtl/fir_lp_serial.v:4]
INFO: [Synth 8-226] default block is never used [D:/Code/zynq_vibration_monitor/rtl/vibration_filter.v:75]
INFO: [Synth 8-6155] done synthesizing module 'vibration_filter' (9#1) [D:/Code/zynq_vibration_monitor/rtl/vibration_filter.v:4]
INFO: [Synth 8-6155] done synthesizing module 'filter_monitor_core' (10#1) [D:/Code/zynq_vibration_monitor/rtl/filter_monitor_core.v:4]
INFO: [Synth 8-6157] synthesizing module 'window_features' [D:/Code/zynq_vibration_monitor/rtl/window_features.v:4]
	Parameter WINDOW_LOG2 bound to: 7 - type: integer 
	Parameter LG bound to: 7 - type: integer 
	Parameter N bound to: 128 - type: integer 
	Parameter SW bound to: 43 - type: integer 
	Parameter CW bound to: 7 - type: integer 
	Parameter IDLE bound to: 3'b000 
	Parameter MUL bound to: 3'b001 
	Parameter ACC bound to: 3'b010 
	Parameter ROOT_START bound to: 3'b011 
	Parameter ROOT_WAIT bound to: 3'b100 
INFO: [Synth 8-6157] synthesizing module 'isqrt_u36' [D:/Code/zynq_vibration_monitor/rtl/isqrt_u36.v:4]
INFO: [Synth 8-6155] done synthesizing module 'isqrt_u36' (11#1) [D:/Code/zynq_vibration_monitor/rtl/isqrt_u36.v:4]
INFO: [Synth 8-6155] done synthesizing module 'window_features' (12#1) [D:/Code/zynq_vibration_monitor/rtl/window_features.v:4]
INFO: [Synth 8-6157] synthesizing module 'threshold_alarm' [D:/Code/zynq_vibration_monitor/rtl/threshold_alarm.v:4]
	Parameter RMS_ON bound to: 2000 - type: integer 
	Parameter RMS_OFF bound to: 1500 - type: integer 
	Parameter ASSERT_WINDOWS bound to: 2 - type: integer 
	Parameter RELEASE_WINDOWS bound to: 2 - type: integer 
	Parameter ON_WIDE bound to: 2000 - type: integer 
	Parameter OFF_WIDE bound to: 1500 - type: integer 
	Parameter ON_SQUARE bound to: 36'b000000000000001111010000100100000000 
	Parameter OFF_SQUARE bound to: 36'b000000000000001000100101010100010000 
INFO: [Synth 8-6155] done synthesizing module 'threshold_alarm' (13#1) [D:/Code/zynq_vibration_monitor/rtl/threshold_alarm.v:4]
INFO: [Synth 8-6155] done synthesizing module 'feature_monitor_core' (14#1) [D:/Code/zynq_vibration_monitor/rtl/feature_monitor_core.v:4]
INFO: [Synth 8-6157] synthesizing module 'return_source_select' [D:/Code/zynq_vibration_monitor/rtl/return_source_select.v:4]
	Parameter RETURN_FILTERED bound to: 1 - type: integer 
INFO: [Synth 8-6155] done synthesizing module 'return_source_select' (15#1) [D:/Code/zynq_vibration_monitor/rtl/return_source_select.v:4]
INFO: [Synth 8-6155] done synthesizing module 'system_monitor_core' (16#1) [D:/Code/zynq_vibration_monitor/rtl/system_monitor_core.v:4]
INFO: [Synth 8-6157] synthesizing module 'alarm_buzzer' [D:/Code/zynq_vibration_monitor/rtl/alarm_buzzer.v:4]
INFO: [Synth 8-6155] done synthesizing module 'alarm_buzzer' (17#1) [D:/Code/zynq_vibration_monitor/rtl/alarm_buzzer.v:4]
INFO: [Synth 8-6155] done synthesizing module 'system_buzzer_top' (18#1) [D:/Code/zynq_vibration_monitor/rtl/system_buzzer_top.v:4]
---------------------------------------------------------------------------------
Finished RTL Elaboration : Time (s): cpu = 00:00:08 ; elapsed = 00:00:09 . Memory (MB): peak = 1205.562 ; gain = 67.164
---------------------------------------------------------------------------------
---------------------------------------------------------------------------------
Start Handling Custom Attributes
---------------------------------------------------------------------------------
---------------------------------------------------------------------------------
Finished Handling Custom Attributes : Time (s): cpu = 00:00:09 ; elapsed = 00:00:10 . Memory (MB): peak = 1205.562 ; gain = 67.164
---------------------------------------------------------------------------------
---------------------------------------------------------------------------------
Finished RTL Optimization Phase 1 : Time (s): cpu = 00:00:09 ; elapsed = 00:00:10 . Memory (MB): peak = 1205.562 ; gain = 67.164
---------------------------------------------------------------------------------
Netlist sorting complete. Time (s): cpu = 00:00:01 ; elapsed = 00:00:00.147 . Memory (MB): peak = 1205.562 ; gain = 0.000
INFO: [Project 1-570] Preparing netlist for logic optimization

Processing XDC Constraints
Initializing timing engine
Parsing XDC File [D:/Code/zynq_vibration_monitor/constr/top.xdc]
Finished Parsing XDC File [D:/Code/zynq_vibration_monitor/constr/top.xdc]
INFO: [Project 1-236] Implementation specific constraints were found while reading constraint file [D:/Code/zynq_vibration_monitor/constr/top.xdc]. These constraints will be ignored for synthesis but will be used in implementation. Impacted constraints are listed in the file [.Xil/system_buzzer_top_propImpl.xdc].
Resolution: To avoid this warning, move constraints listed in [.Xil/system_buzzer_top_propImpl.xdc] to another XDC file and exclude this new file from synthesis with the used_in_synthesis property (File Properties dialog in GUI) and re-run elaboration/synthesis.
Parsing XDC File [D:/Code/zynq_vibration_monitor/constr/buzzer.xdc]
Finished Parsing XDC File [D:/Code/zynq_vibration_monitor/constr/buzzer.xdc]
INFO: [Project 1-236] Implementation specific constraints were found while reading constraint file [D:/Code/zynq_vibration_monitor/constr/buzzer.xdc]. These constraints will be ignored for synthesis but will be used in implementation. Impacted constraints are listed in the file [.Xil/system_buzzer_top_propImpl.xdc].
Resolution: To avoid this warning, move constraints listed in [.Xil/system_buzzer_top_propImpl.xdc] to another XDC file and exclude this new file from synthesis with the used_in_synthesis property (File Properties dialog in GUI) and re-run elaboration/synthesis.
Completed Processing XDC Constraints

Netlist sorting complete. Time (s): cpu = 00:00:00 ; elapsed = 00:00:00.003 . Memory (MB): peak = 1341.035 ; gain = 0.000
INFO: [Project 1-111] Unisim Transformation Summary:
No Unisim elements were transformed.

Constraint Validation Runtime : Time (s): cpu = 00:00:00 ; elapsed = 00:00:00.068 . Memory (MB): peak = 1341.035 ; gain = 0.000
---------------------------------------------------------------------------------
Finished Constraint Validation : Time (s): cpu = 00:00:19 ; elapsed = 00:00:21 . Memory (MB): peak = 1341.035 ; gain = 202.637
---------------------------------------------------------------------------------
---------------------------------------------------------------------------------
Start Loading Part and Timing Information
---------------------------------------------------------------------------------
Loading part: xc7z010clg400-1
---------------------------------------------------------------------------------
Finished Loading Part and Timing Information : Time (s): cpu = 00:00:19 ; elapsed = 00:00:21 . Memory (MB): peak = 1341.035 ; gain = 202.637
---------------------------------------------------------------------------------
---------------------------------------------------------------------------------
Start Applying 'set_property' XDC Constraints
---------------------------------------------------------------------------------
---------------------------------------------------------------------------------
Finished applying 'set_property' XDC Constraints : Time (s): cpu = 00:00:19 ; elapsed = 00:00:21 . Memory (MB): peak = 1341.035 ; gain = 202.637
---------------------------------------------------------------------------------
INFO: [Synth 8-802] inferred FSM for state register 'state_reg' in module 'uart_tx'
INFO: [Synth 8-802] inferred FSM for state register 'state_reg' in module 'vibration_filter'
INFO: [Synth 8-802] inferred FSM for state register 'state_reg' in module 'window_features'
---------------------------------------------------------------------------------------------------
                   State |                     New Encoding |                Previous Encoding 
---------------------------------------------------------------------------------------------------
                    IDLE |                               00 |                               00
                   START |                               01 |                               01
                    DATA |                               10 |                               10
                    STOP |                               11 |                               11
---------------------------------------------------------------------------------------------------
INFO: [Synth 8-3354] encoded FSM with state register 'state_reg' using encoding 'sequential' in module 'uart_tx'
---------------------------------------------------------------------------------------------------
                   State |                     New Encoding |                Previous Encoding 
---------------------------------------------------------------------------------------------------
                    IDLE |                             0001 |                               00
                      DC |                             0010 |                               01
                     FIR |                             0100 |                               10
             WAIT_RESULT |                             1000 |                               11
---------------------------------------------------------------------------------------------------
INFO: [Synth 8-3354] encoded FSM with state register 'state_reg' using encoding 'one-hot' in module 'vibration_filter'
---------------------------------------------------------------------------------
Finished RTL Optimization Phase 2 : Time (s): cpu = 00:00:21 ; elapsed = 00:00:24 . Memory (MB): peak = 1341.035 ; gain = 202.637
---------------------------------------------------------------------------------
---------------------------------------------------------------------------------
Start RTL Component Statistics 
---------------------------------------------------------------------------------
Detailed RTL Component Info : 
+---Adders : 
	   2 Input   43 Bit       Adders := 3     
	   3 Input   42 Bit       Adders := 3     
	   2 Input   42 Bit       Adders := 3     
	   3 Input   34 Bit       Adders := 3     
	   3 Input   33 Bit       Adders := 3     
	   2 Input   20 Bit       Adders := 1     
	   3 Input   19 Bit       Adders := 3     
	   2 Input   18 Bit       Adders := 3     
	   2 Input   17 Bit       Adders := 3     
	   2 Input   10 Bit       Adders := 1     
	   2 Input    9 Bit       Adders := 4     
	   2 Input    8 Bit       Adders := 9     
	   2 Input    7 Bit       Adders := 4     
	   2 Input    6 Bit       Adders := 9     
	   2 Input    5 Bit       Adders := 3     
	   2 Input    4 Bit       Adders := 3     
	   2 Input    3 Bit       Adders := 7     
	   2 Input    2 Bit       Adders := 4     
+---XORs : 
	   7 Input      8 Bit         XORs := 3     
+---Registers : 
	               80 Bit    Registers := 3     
	               43 Bit    Registers := 3     
	               41 Bit    Registers := 3     
	               36 Bit    Registers := 3     
	               35 Bit    Registers := 12    
	               32 Bit    Registers := 11    
	               20 Bit    Registers := 1     
	               19 Bit    Registers := 6     
	               18 Bit    Registers := 42    
	               17 Bit    Registers := 195   
	               16 Bit    Registers := 9     
	               10 Bit    Registers := 1     
	                9 Bit    Registers := 3     
	                8 Bit    Registers := 22    
	                7 Bit    Registers := 7     
	                6 Bit    Registers := 9     
	                5 Bit    Registers := 3     
	                4 Bit    Registers := 3     
	                3 Bit    Registers := 14    
	                2 Bit    Registers := 2     
	                1 Bit    Registers := 60    
+---RAMs : 
	              224 Bit	(4 X 56 bit)          RAMs := 2     
+---Muxes : 
	   2 Input   80 Bit        Muxes := 8     
	   2 Input   79 Bit        Muxes := 2     
	   6 Input   43 Bit        Muxes := 3     
	   2 Input   42 Bit        Muxes := 6     
	   6 Input   41 Bit        Muxes := 3     
	   2 Input   36 Bit        Muxes := 3     
	   2 Input   34 Bit        Muxes := 3     
	   2 Input   32 Bit        Muxes := 3     
	   2 Input   20 Bit        Muxes := 1     
	   4 Input   20 Bit        Muxes := 1     
	   2 Input   19 Bit        Muxes := 3     
	   2 Input   18 Bit        Muxes := 15    
	   6 Input   18 Bit        Muxes := 3     
	   2 Input   17 Bit        Muxes := 9     
	   2 Input    9 Bit        Muxes := 6     
	   6 Input    9 Bit        Muxes := 1     
	   4 Input    9 Bit        Muxes := 2     
	   6 Input    8 Bit        Muxes := 1     
	   2 Input    8 Bit        Muxes := 2     
	   6 Input    7 Bit        Muxes := 4     
	   2 Input    7 Bit        Muxes := 9     
	   6 Input    6 Bit        Muxes := 9     
	   2 Input    6 Bit        Muxes := 12    
	   6 Input    4 Bit        Muxes := 1     
	   2 Input    4 Bit        Muxes := 5     
	   6 Input    3 Bit        Muxes := 4     
	   3 Input    3 Bit        Muxes := 2     
	   4 Input    3 Bit        Muxes := 2     
	   7 Input    3 Bit        Muxes := 3     
	   2 Input    3 Bit        Muxes := 11    
	   2 Input    2 Bit        Muxes := 9     
	   3 Input    2 Bit        Muxes := 2     
	   4 Input    2 Bit        Muxes := 4     
	   6 Input    1 Bit        Muxes := 245   
	   2 Input    1 Bit        Muxes := 283   
	   5 Input    1 Bit        Muxes := 2     
	   3 Input    1 Bit        Muxes := 5     
	   4 Input    1 Bit        Muxes := 35    
	   9 Input    1 Bit        Muxes := 2     
	   7 Input    1 Bit        Muxes := 4     
---------------------------------------------------------------------------------
Finished RTL Component Statistics 
---------------------------------------------------------------------------------
---------------------------------------------------------------------------------
Start Part Resource Summary
---------------------------------------------------------------------------------
Part Resources:
DSPs: 80 (col length:40)
BRAMs: 120 (col length: RAMB18 40 RAMB36 20)
---------------------------------------------------------------------------------
Finished Part Resource Summary
---------------------------------------------------------------------------------
---------------------------------------------------------------------------------
Start Cross Boundary and Area Optimization
---------------------------------------------------------------------------------
DSP Report: Generating DSP accumulator0, operation Mode is: C+(A2*B2)'.
DSP Report: register sample_reg_reg is absorbed into DSP accumulator0.
DSP Report: register coefficient_reg_reg is absorbed into DSP accumulator0.
DSP Report: register product_reg_reg is absorbed into DSP accumulator0.
DSP Report: operator product_reg0 is absorbed into DSP accumulator0.
DSP Report: operator accumulator0 is absorbed into DSP accumulator0.
DSP Report: Generating DSP accumulator0, operation Mode is: C+(A2*B2)'.
DSP Report: register sample_reg_reg is absorbed into DSP accumulator0.
DSP Report: register coefficient_reg_reg is absorbed into DSP accumulator0.
DSP Report: register product_reg_reg is absorbed into DSP accumulator0.
DSP Report: operator product_reg0 is absorbed into DSP accumulator0.
DSP Report: operator accumulator0 is absorbed into DSP accumulator0.
DSP Report: Generating DSP accumulator0, operation Mode is: C+(A2*B2)'.
DSP Report: register sample_reg_reg is absorbed into DSP accumulator0.
DSP Report: register coefficient_reg_reg is absorbed into DSP accumulator0.
DSP Report: register product_reg_reg is absorbed into DSP accumulator0.
DSP Report: operator product_reg0 is absorbed into DSP accumulator0.
DSP Report: operator accumulator0 is absorbed into DSP accumulator0.
DSP Report: Generating DSP px_reg, operation Mode is: (A2*B2)'.
DSP Report: register sx_reg is absorbed into DSP px_reg.
DSP Report: register sx_reg is absorbed into DSP px_reg.
DSP Report: register px_reg is absorbed into DSP px_reg.
DSP Report: operator px0 is absorbed into DSP px_reg.
DSP Report: Generating DSP py_reg, operation Mode is: (A2*B2)'.
DSP Report: register sy_reg is absorbed into DSP py_reg.
DSP Report: register sy_reg is absorbed into DSP py_reg.
DSP Report: register py_reg is absorbed into DSP py_reg.
DSP Report: operator py0 is absorbed into DSP py_reg.
DSP Report: Generating DSP pz_reg, operation Mode is: (A2*B2)'.
DSP Report: register sz_reg is absorbed into DSP pz_reg.
DSP Report: register sz_reg is absorbed into DSP pz_reg.
DSP Report: register pz_reg is absorbed into DSP pz_reg.
DSP Report: operator pz0 is absorbed into DSP pz_reg.
---------------------------------------------------------------------------------
Finished Cross Boundary and Area Optimization : Time (s): cpu = 00:00:43 ; elapsed = 00:00:47 . Memory (MB): peak = 1341.035 ; gain = 202.637
---------------------------------------------------------------------------------
---------------------------------------------------------------------------------
Start ROM, RAM, DSP, Shift Register and Retiming Reporting
---------------------------------------------------------------------------------

ROM: Preliminary Mapping	Report
+--------------+------------+---------------+----------------+
|Module Name   | RTL Object | Depth x Width | Implemented As | 
+--------------+------------+---------------+----------------+
|fir_lp_serial | p_0_out    | 64x18         | LUT            | 
|fir_lp_serial | p_0_out    | 64x18         | LUT            | 
|fir_lp_serial | p_0_out    | 64x18         | LUT            | 
|fir_lp_serial | p_0_out    | 64x18         | LUT            | 
+--------------+------------+---------------+----------------+

Distributed RAM: Preliminary Mapping	Report (see note below)
+------------------+---------------------------+-----------+----------------------+--------------+
|Module Name       | RTL Object                | Inference | Size (Depth x Width) | Primitives   | 
+------------------+---------------------------+-----------+----------------------+--------------+
|system_buzzer_top | u_core/u_return/queue_reg | Implied   | 4 x 56               | RAM32M x 10	 | 
+------------------+---------------------------+-----------+----------------------+--------------+

Note: The table above is a preliminary report that shows the Distributed RAMs at the current stage of the synthesis flow. Some Distributed RAMs may be reimplemented as non Distributed RAM primitives later in the synthesis flow. Multiple instantiated RAMs are reported only once.

DSP: Preliminary Mapping	Report (see note below)
+----------------+-------------+--------+--------+--------+--------+--------+------+------+------+------+-------+------+------+
|Module Name     | DSP Mapping | A Size | B Size | C Size | D Size | P Size | AREG | BREG | CREG | DREG | ADREG | MREG | PREG | 
+----------------+-------------+--------+--------+--------+--------+--------+------+------+------+------+-------+------+------+
|fir_lp_serial   | C+(A2*B2)'  | 18     | 17     | 41     | -      | 41     | 1    | 1    | 0    | -    | -     | 1    | 0    | 
|fir_lp_serial   | C+(A2*B2)'  | 18     | 17     | 41     | -      | 41     | 1    | 1    | 0    | -    | -     | 1    | 0    | 
|fir_lp_serial   | C+(A2*B2)'  | 18     | 17     | 41     | -      | 41     | 1    | 1    | 0    | -    | -     | 1    | 0    | 
|window_features | (A2*B2)'    | 18     | 18     | -      | -      | 36     | 1    | 1    | -    | -    | -     | 1    | 0    | 
|window_features | (A2*B2)'    | 18     | 18     | -      | -      | 36     | 1    | 1    | -    | -    | -     | 1    | 0    | 
|window_features | (A2*B2)'    | 18     | 18     | -      | -      | 36     | 1    | 1    | -    | -    | -     | 1    | 0    | 
+----------------+-------------+--------+--------+--------+--------+--------+------+------+------+------+-------+------+------+

Note: The table above is a preliminary report that shows the DSPs inferred at the current stage of the synthesis flow. Some DSP may be reimplemented as non DSP primitives later in the synthesis flow. Multiple instantiated DSPs are reported only once.
---------------------------------------------------------------------------------
Finished ROM, RAM, DSP, Shift Register and Retiming Reporting
---------------------------------------------------------------------------------
---------------------------------------------------------------------------------
Start Applying XDC Timing Constraints
---------------------------------------------------------------------------------
---------------------------------------------------------------------------------
Finished Applying XDC Timing Constraints : Time (s): cpu = 00:00:54 ; elapsed = 00:01:00 . Memory (MB): peak = 1353.074 ; gain = 214.676
---------------------------------------------------------------------------------
---------------------------------------------------------------------------------
Start Timing Optimization
---------------------------------------------------------------------------------
---------------------------------------------------------------------------------
Finished Timing Optimization : Time (s): cpu = 00:01:01 ; elapsed = 00:01:07 . Memory (MB): peak = 1446.262 ; gain = 307.863
---------------------------------------------------------------------------------
---------------------------------------------------------------------------------
Start ROM, RAM, DSP, Shift Register and Retiming Reporting
---------------------------------------------------------------------------------

Distributed RAM: Final Mapping	Report
+------------------+---------------------------+-----------+----------------------+--------------+
|Module Name       | RTL Object                | Inference | Size (Depth x Width) | Primitives   | 
+------------------+---------------------------+-----------+----------------------+--------------+
|system_buzzer_top | u_core/u_return/queue_reg | Implied   | 4 x 56               | RAM32M x 10	 | 
+------------------+---------------------------+-----------+----------------------+--------------+

---------------------------------------------------------------------------------
Finished ROM, RAM, DSP, Shift Register and Retiming Reporting
---------------------------------------------------------------------------------
---------------------------------------------------------------------------------
Start Technology Mapping
---------------------------------------------------------------------------------
---------------------------------------------------------------------------------
Finished Technology Mapping : Time (s): cpu = 00:01:05 ; elapsed = 00:01:12 . Memory (MB): peak = 1447.324 ; gain = 308.926
---------------------------------------------------------------------------------
---------------------------------------------------------------------------------
Start IO Insertion
---------------------------------------------------------------------------------
---------------------------------------------------------------------------------
Start Flattening Before IO Insertion
---------------------------------------------------------------------------------
---------------------------------------------------------------------------------
Finished Flattening Before IO Insertion
---------------------------------------------------------------------------------
---------------------------------------------------------------------------------
Start Final Netlist Cleanup
---------------------------------------------------------------------------------
---------------------------------------------------------------------------------
Finished Final Netlist Cleanup
---------------------------------------------------------------------------------
---------------------------------------------------------------------------------
Finished IO Insertion : Time (s): cpu = 00:01:10 ; elapsed = 00:01:17 . Memory (MB): peak = 1447.324 ; gain = 308.926
---------------------------------------------------------------------------------
---------------------------------------------------------------------------------
Start Renaming Generated Instances
---------------------------------------------------------------------------------
---------------------------------------------------------------------------------
Finished Renaming Generated Instances : Time (s): cpu = 00:01:10 ; elapsed = 00:01:17 . Memory (MB): peak = 1447.324 ; gain = 308.926
---------------------------------------------------------------------------------
---------------------------------------------------------------------------------
Start Rebuilding User Hierarchy
---------------------------------------------------------------------------------
---------------------------------------------------------------------------------
Finished Rebuilding User Hierarchy : Time (s): cpu = 00:01:12 ; elapsed = 00:01:19 . Memory (MB): peak = 1447.324 ; gain = 308.926
---------------------------------------------------------------------------------
---------------------------------------------------------------------------------
Start Renaming Generated Ports
---------------------------------------------------------------------------------
---------------------------------------------------------------------------------
Finished Renaming Generated Ports : Time (s): cpu = 00:01:12 ; elapsed = 00:01:19 . Memory (MB): peak = 1447.324 ; gain = 308.926
---------------------------------------------------------------------------------
---------------------------------------------------------------------------------
Start Handling Custom Attributes
---------------------------------------------------------------------------------
---------------------------------------------------------------------------------
Finished Handling Custom Attributes : Time (s): cpu = 00:01:12 ; elapsed = 00:01:19 . Memory (MB): peak = 1447.324 ; gain = 308.926
---------------------------------------------------------------------------------
---------------------------------------------------------------------------------
Start Renaming Generated Nets
---------------------------------------------------------------------------------
---------------------------------------------------------------------------------
Finished Renaming Generated Nets : Time (s): cpu = 00:01:12 ; elapsed = 00:01:19 . Memory (MB): peak = 1447.324 ; gain = 308.926
---------------------------------------------------------------------------------
---------------------------------------------------------------------------------
Start Writing Synthesis Report
---------------------------------------------------------------------------------

Report BlackBoxes: 
+-+--------------+----------+
| |BlackBox name |Instances |
+-+--------------+----------+
+-+--------------+----------+

Report Cell Usage: 
+------+--------+------+
|      |Cell    |Count |
+------+--------+------+
|1     |BUFG    |     1|
|2     |CARRY4  |   319|
|3     |DSP48E1 |     6|
|5     |LUT1    |   209|
|6     |LUT2    |   748|
|7     |LUT3    |   469|
|8     |LUT4    |   448|
|9     |LUT5    |   337|
|10    |LUT6    |  1638|
|11    |MUXF7   |   306|
|12    |MUXF8   |   153|
|13    |RAM32M  |    10|
|14    |FDRE    |  6087|
|15    |FDSE    |     5|
|16    |IBUF    |     2|
|17    |OBUF    |     2|
+------+--------+------+
---------------------------------------------------------------------------------
Finished Writing Synthesis Report : Time (s): cpu = 00:01:12 ; elapsed = 00:01:19 . Memory (MB): peak = 1447.324 ; gain = 308.926
---------------------------------------------------------------------------------
Synthesis finished with 0 errors, 0 critical warnings and 0 warnings.
Synthesis Optimization Runtime : Time (s): cpu = 00:00:59 ; elapsed = 00:01:15 . Memory (MB): peak = 1447.324 ; gain = 173.453
Synthesis Optimization Complete : Time (s): cpu = 00:01:12 ; elapsed = 00:01:19 . Memory (MB): peak = 1447.324 ; gain = 308.926
INFO: [Project 1-571] Translating synthesized netlist
Netlist sorting complete. Time (s): cpu = 00:00:00 ; elapsed = 00:00:00.141 . Memory (MB): peak = 1459.156 ; gain = 0.000
INFO: [Netlist 29-17] Analyzing 794 Unisim elements for replacement
INFO: [Netlist 29-28] Unisim Transformation completed in 0 CPU seconds
INFO: [Project 1-570] Preparing netlist for logic optimization
Parsing XDC File [D:/Code/zynq_vibration_monitor/constr/top.xdc]
Finished Parsing XDC File [D:/Code/zynq_vibration_monitor/constr/top.xdc]
Parsing XDC File [D:/Code/zynq_vibration_monitor/constr/buzzer.xdc]
Finished Parsing XDC File [D:/Code/zynq_vibration_monitor/constr/buzzer.xdc]
INFO: [Opt 31-138] Pushed 0 inverter(s) to 0 load pin(s).
Netlist sorting complete. Time (s): cpu = 00:00:00 ; elapsed = 00:00:00.003 . Memory (MB): peak = 1459.156 ; gain = 0.000
INFO: [Project 1-111] Unisim Transformation Summary:
  A total of 10 instances were transformed.
  RAM32M => RAM32M (RAMD32(x6), RAMS32(x2)): 10 instances

INFO: [Common 17-83] Releasing license: Synthesis
61 Infos, 0 Warnings, 0 Critical Warnings and 0 Errors encountered.
synth_design completed successfully
synth_design: Time (s): cpu = 00:01:23 ; elapsed = 00:01:35 . Memory (MB): peak = 1459.156 ; gain = 320.758
Parsing XDC File [D:/Code/zynq_vibration_monitor/constr/system_uart_rx_cdc.xdc]
Finished Parsing XDC File [D:/Code/zynq_vibration_monitor/constr/system_uart_rx_cdc.xdc]
INFO: [Timing 38-35] Done setting XDC timing constraints.
INFO: [Chipscope 16-329] Generating Script for core instance : dbg_hub 
INFO: [IP_Flow 19-234] Refreshing IP repositories
INFO: [IP_Flow 19-1704] No user IP repositories specified
INFO: [IP_Flow 19-2313] Loaded Vivado IP repository 'D:/Xilinx/Vivado/2020.2/data/ip'.
INFO: [IP_Flow 19-3806] Processing IP xilinx.com:ip:xsdbm:3.0 for cell dbg_hub_CV.
INFO: [Chipscope 16-329] Generating Script for core instance : stage7_ila 
INFO: [IP_Flow 19-3806] Processing IP xilinx.com:ip:ila:6.2 for cell stage7_ila_CV.
INFO: [Chipscope 16-78] labtools_xsdbm_v3 netlist file is 'd:/Code/zynq_vibration_monitor/build/buzzer_release/debug/.Xil/Vivado-12048-LAPTOP-1OLLF8TS/dbg_hub_CV.0/out/dcp/dbg_hub_0.edf'.
INFO: [Chipscope 16-78] labtools_ila_v6 netlist file is 'd:/Code/zynq_vibration_monitor/build/buzzer_release/debug/.Xil/Vivado-12048-LAPTOP-1OLLF8TS/stage7_ila_CV.0/out/dcp/stage7_ila_1.edf'.
implement_debug_core: Time (s): cpu = 00:00:10 ; elapsed = 00:03:47 . Memory (MB): peak = 1760.109 ; gain = 144.953
Command: opt_design
Attempting to get a license for feature 'Implementation' and/or device 'xc7z010'
INFO: [Common 17-349] Got license for feature 'Implementation' and/or device 'xc7z010'
Running DRC as a precondition to command opt_design

Starting DRC Task
INFO: [DRC 23-27] Running DRC with 2 threads
INFO: [Project 1-461] DRC finished with 0 Errors
INFO: [Project 1-462] Please refer to the DRC report (report_drc) for more information.

Time (s): cpu = 00:00:03 ; elapsed = 00:00:02 . Memory (MB): peak = 1760.109 ; gain = 0.000

Starting Cache Timing Information Task
INFO: [Timing 38-35] Done setting XDC timing constraints.
Ending Cache Timing Information Task | Checksum: 1c88d9a50

Time (s): cpu = 00:00:01 ; elapsed = 00:00:00.859 . Memory (MB): peak = 1760.109 ; gain = 0.000

Starting Logic Optimization Task

Phase 1 Generate And Synthesize Debug Cores
INFO: [Chipscope 16-329] Generating Script for core instance : dbg_hub 
INFO: [IP_Flow 19-3806] Processing IP xilinx.com:ip:xsdbm:3.0 for cell dbg_hub_CV.
Netlist sorting complete. Time (s): cpu = 00:00:00 ; elapsed = 00:00:00.043 . Memory (MB): peak = 1975.715 ; gain = 0.000
Phase 1 Generate And Synthesize Debug Cores | Checksum: 200e57bd5

Time (s): cpu = 00:00:03 ; elapsed = 00:01:50 . Memory (MB): peak = 1975.715 ; gain = 44.734

Phase 2 Retarget
INFO: [Opt 31-138] Pushed 0 inverter(s) to 0 load pin(s).
INFO: [Opt 31-49] Retargeted 0 cell(s).
Phase 2 Retarget | Checksum: 2584d9c7b

Time (s): cpu = 00:00:05 ; elapsed = 00:01:51 . Memory (MB): peak = 1975.715 ; gain = 44.734
INFO: [Opt 31-389] Phase Retarget created 4 cells and removed 21 cells
INFO: [Opt 31-1021] In phase Retarget, 64 netlist objects are constrained preventing optimization. Please run opt_design with -debug_log to get more detail. 

Phase 3 Constant propagation
INFO: [Opt 31-138] Pushed 0 inverter(s) to 0 load pin(s).
Phase 3 Constant propagation | Checksum: 23498bede

Time (s): cpu = 00:00:05 ; elapsed = 00:01:51 . Memory (MB): peak = 1975.715 ; gain = 44.734
INFO: [Opt 31-389] Phase Constant propagation created 0 cells and removed 16 cells
INFO: [Opt 31-1021] In phase Constant propagation, 47 netlist objects are constrained preventing optimization. Please run opt_design with -debug_log to get more detail. 

Phase 4 Sweep
Phase 4 Sweep | Checksum: 2618cdfae

Time (s): cpu = 00:00:06 ; elapsed = 00:01:52 . Memory (MB): peak = 1975.715 ; gain = 44.734
INFO: [Opt 31-389] Phase Sweep created 0 cells and removed 46 cells
INFO: [Opt 31-1021] In phase Sweep, 1713 netlist objects are constrained preventing optimization. Please run opt_design with -debug_log to get more detail. 

Phase 5 BUFG optimization
Phase 5 BUFG optimization | Checksum: 2618cdfae

Time (s): cpu = 00:00:06 ; elapsed = 00:01:52 . Memory (MB): peak = 1975.715 ; gain = 44.734
INFO: [Opt 31-662] Phase BUFG optimization created 0 cells of which 0 are BUFGs and removed 0 cells.

Phase 6 Shift Register Optimization
INFO: [Opt 31-1064] SRL Remap converted 0 SRLs to 0 registers and converted 0 registers of register chains to 0 SRLs
Phase 6 Shift Register Optimization | Checksum: 2618cdfae

Time (s): cpu = 00:00:06 ; elapsed = 00:01:52 . Memory (MB): peak = 1975.715 ; gain = 44.734
INFO: [Opt 31-389] Phase Shift Register Optimization created 0 cells and removed 0 cells

Phase 7 Post Processing Netlist
Phase 7 Post Processing Netlist | Checksum: 2618cdfae

Time (s): cpu = 00:00:06 ; elapsed = 00:01:53 . Memory (MB): peak = 1975.715 ; gain = 44.734
INFO: [Opt 31-389] Phase Post Processing Netlist created 0 cells and removed 0 cells
INFO: [Opt 31-1021] In phase Post Processing Netlist, 57 netlist objects are constrained preventing optimization. Please run opt_design with -debug_log to get more detail. 
Opt_design Change Summary
=========================

-------------------------------------------------------------------------------------------------------------------------
|  Phase                        |  #Cells created  |  #Cells Removed  |  #Constrained objects preventing optimizations  |
-------------------------------------------------------------------------------------------------------------------------
|  Retarget                     |               4  |              21  |                                             64  |
|  Constant propagation         |               0  |              16  |                                             47  |
|  Sweep                        |               0  |              46  |                                           1713  |
|  BUFG optimization            |               0  |               0  |                                              0  |
|  Shift Register Optimization  |               0  |               0  |                                              0  |
|  Post Processing Netlist      |               0  |               0  |                                             57  |
-------------------------------------------------------------------------------------------------------------------------

Starting Connectivity Check Task

Time (s): cpu = 00:00:00 ; elapsed = 00:00:00.050 . Memory (MB): peak = 1975.715 ; gain = 0.000
Ending Logic Optimization Task | Checksum: 1497d4a9a

Time (s): cpu = 00:00:07 ; elapsed = 00:01:53 . Memory (MB): peak = 1975.715 ; gain = 44.734

Starting Power Optimization Task
INFO: [Pwropt 34-132] Skipping clock gating for clocks with a period < 2.00 ns.
INFO: [Timing 38-35] Done setting XDC timing constraints.
INFO: [Pwropt 34-9] Applying IDT optimizations ...
INFO: [Pwropt 34-10] Applying ODC optimizations ...
Running Vector-less Activity Propagation...

Finished Running Vector-less Activity Propagation

Starting PowerOpt Patch Enables Task
INFO: [Pwropt 34-162] WRITE_MODE attribute of 0 BRAM(s) out of a total of 12 has been updated to save power. Run report_power_opt to get a complete listing of the BRAMs updated.
INFO: [Pwropt 34-201] Structural ODC has moved 0 WE to EN ports
Number of BRAM Ports augmented: 12 newly gated: 0 Total Ports: 24
Ending PowerOpt Patch Enables Task | Checksum: f76d622c

Time (s): cpu = 00:00:00 ; elapsed = 00:00:00.164 . Memory (MB): peak = 2093.891 ; gain = 0.000
Ending Power Optimization Task | Checksum: f76d622c

Time (s): cpu = 00:00:08 ; elapsed = 00:00:05 . Memory (MB): peak = 2093.891 ; gain = 118.176

Starting Final Cleanup Task
Ending Final Cleanup Task | Checksum: f76d622c

Time (s): cpu = 00:00:00 ; elapsed = 00:00:00 . Memory (MB): peak = 2093.891 ; gain = 0.000

Starting Netlist Obfuscation Task
Netlist sorting complete. Time (s): cpu = 00:00:00 ; elapsed = 00:00:00.018 . Memory (MB): peak = 2093.891 ; gain = 0.000
Ending Netlist Obfuscation Task | Checksum: 109647c4f

Time (s): cpu = 00:00:00 ; elapsed = 00:00:00.019 . Memory (MB): peak = 2093.891 ; gain = 0.000
INFO: [Common 17-83] Releasing license: Implementation
109 Infos, 36 Warnings, 0 Critical Warnings and 0 Errors encountered.
opt_design completed successfully
opt_design: Time (s): cpu = 00:00:22 ; elapsed = 00:02:04 . Memory (MB): peak = 2093.891 ; gain = 333.781
INFO: [Timing 38-35] Done setting XDC timing constraints.
INFO: [Timing 38-480] Writing timing data to binary archive.
Writing placer database...
Writing XDEF routing.
Writing XDEF routing logical nets.
Writing XDEF routing special nets.
Write XDEF Complete: Time (s): cpu = 00:00:00 ; elapsed = 00:00:00.059 . Memory (MB): peak = 2093.891 ; gain = 0.000
INFO: [Common 17-1381] The checkpoint 'D:/Code/zynq_vibration_monitor/build/buzzer_release/debug/optimized_system.dcp' has been generated.
write_checkpoint: Time (s): cpu = 00:00:10 ; elapsed = 00:00:07 . Memory (MB): peak = 2093.891 ; gain = 0.000
Command: place_design
Attempting to get a license for feature 'Implementation' and/or device 'xc7z010'
INFO: [Common 17-349] Got license for feature 'Implementation' and/or device 'xc7z010'
INFO: [DRC 23-27] Running DRC with 2 threads
INFO: [Vivado_Tcl 4-198] DRC finished with 0 Errors
INFO: [Vivado_Tcl 4-199] Please refer to the DRC report (report_drc) for more information.
Running DRC as a precondition to command place_design
INFO: [DRC 23-27] Running DRC with 2 threads
INFO: [Vivado_Tcl 4-198] DRC finished with 0 Errors
INFO: [Vivado_Tcl 4-199] Please refer to the DRC report (report_drc) for more information.

Starting Placer Task
INFO: [Place 30-611] Multithreading enabled for place_design using a maximum of 2 CPUs

Phase 1 Placer Initialization

Phase 1.1 Placer Initialization Netlist Sorting
Netlist sorting complete. Time (s): cpu = 00:00:00 ; elapsed = 00:00:00.015 . Memory (MB): peak = 2093.891 ; gain = 0.000
Phase 1.1 Placer Initialization Netlist Sorting | Checksum: ea64e05d

Time (s): cpu = 00:00:00 ; elapsed = 00:00:00.034 . Memory (MB): peak = 2093.891 ; gain = 0.000
Netlist sorting complete. Time (s): cpu = 00:00:00 ; elapsed = 00:00:00.012 . Memory (MB): peak = 2093.891 ; gain = 0.000

Phase 1.2 IO Placement/ Clock Placement/ Build Placer Device
Phase 1.2 IO Placement/ Clock Placement/ Build Placer Device | Checksum: 11ed240ca

Time (s): cpu = 00:00:01 ; elapsed = 00:00:01 . Memory (MB): peak = 2093.891 ; gain = 0.000

Phase 1.3 Build Placer Netlist Model
Phase 1.3 Build Placer Netlist Model | Checksum: 1571f6abb

Time (s): cpu = 00:00:07 ; elapsed = 00:00:06 . Memory (MB): peak = 2093.891 ; gain = 0.000

Phase 1.4 Constrain Clocks/Macros
Phase 1.4 Constrain Clocks/Macros | Checksum: 1571f6abb

Time (s): cpu = 00:00:07 ; elapsed = 00:00:06 . Memory (MB): peak = 2093.891 ; gain = 0.000
Phase 1 Placer Initialization | Checksum: 1571f6abb

Time (s): cpu = 00:00:07 ; elapsed = 00:00:06 . Memory (MB): peak = 2093.891 ; gain = 0.000

Phase 2 Global Placement

Phase 2.1 Floorplanning
Phase 2.1 Floorplanning | Checksum: 1aa0b1141

Time (s): cpu = 00:00:09 ; elapsed = 00:00:07 . Memory (MB): peak = 2093.891 ; gain = 0.000

Phase 2.2 Update Timing before SLR Path Opt
Phase 2.2 Update Timing before SLR Path Opt | Checksum: 210cc94ff

Time (s): cpu = 00:00:11 ; elapsed = 00:00:08 . Memory (MB): peak = 2093.891 ; gain = 0.000

Phase 2.3 Global Placement Core

Phase 2.3.1 Physical Synthesis In Placer
INFO: [Physopt 32-1035] Found 0 LUTNM shape to break, 328 LUT instances to create LUTNM shape
INFO: [Physopt 32-1044] Break lutnm for timing: one critical 0, two critical 0, total 0, new lutff created 0
INFO: [Physopt 32-775] End 1 Pass. Optimized 149 nets or cells. Created 0 new cell, deleted 149 existing cells and moved 0 existing cell
INFO: [Physopt 32-65] No nets found for high-fanout optimization.
INFO: [Physopt 32-232] Optimized 0 net. Created 0 new instance.
INFO: [Physopt 32-775] End 1 Pass. Optimized 0 net or cell. Created 0 new cell, deleted 0 existing cell and moved 0 existing cell
INFO: [Physopt 32-670] No setup violation found.  DSP Register Optimization was not performed.
INFO: [Physopt 32-670] No setup violation found.  Shift Register to Pipeline Optimization was not performed.
INFO: [Physopt 32-670] No setup violation found.  Shift Register Optimization was not performed.
INFO: [Physopt 32-670] No setup violation found.  BRAM Register Optimization was not performed.
INFO: [Physopt 32-670] No setup violation found.  URAM Register Optimization was not performed.
INFO: [Physopt 32-949] No candidate nets found for dynamic/static region interface net replication
INFO: [Physopt 32-775] End 1 Pass. Optimized 0 net or cell. Created 0 new cell, deleted 0 existing cell and moved 0 existing cell
Netlist sorting complete. Time (s): cpu = 00:00:00 ; elapsed = 00:00:00.015 . Memory (MB): peak = 2093.891 ; gain = 0.000

Summary of Physical Synthesis Optimizations
============================================

-----------------------------------------------------------------------------------------------------------------------------------------------------------
|  Optimization                                     |  Added Cells  |  Removed Cells  |  Optimized Cells/Nets  |  Dont Touch  |  Iterations  |  Elapsed   |
-----------------------------------------------------------------------------------------------------------------------------------------------------------
|  LUT Combining                                    |            0  |            149  |                   149  |           0  |           1  |  00:00:00  |
|  Very High Fanout                                 |            0  |              0  |                     0  |           0  |           1  |  00:00:00  |
|  DSP Register                                     |            0  |              0  |                     0  |           0  |           0  |  00:00:00  |
|  Shift Register to Pipeline                       |            0  |              0  |                     0  |           0  |           0  |  00:00:00  |
|  Shift Register                                   |            0  |              0  |                     0  |           0  |           0  |  00:00:00  |
|  BRAM Register                                    |            0  |              0  |                     0  |           0  |           0  |  00:00:00  |
|  URAM Register                                    |            0  |              0  |                     0  |           0  |           0  |  00:00:00  |
|  Dynamic/Static Region Interface Net Replication  |            0  |              0  |                     0  |           0  |           1  |  00:00:00  |
|  Total                                            |            0  |            149  |                   149  |           0  |           3  |  00:00:01  |
-----------------------------------------------------------------------------------------------------------------------------------------------------------

Phase 2.3.1 Physical Synthesis In Placer | Checksum: 7b4a29a5

Time (s): cpu = 00:00:30 ; elapsed = 00:00:20 . Memory (MB): peak = 2093.891 ; gain = 0.000
Phase 2.3 Global Placement Core | Checksum: 131bc2226

Time (s): cpu = 00:00:30 ; elapsed = 00:00:21 . Memory (MB): peak = 2093.891 ; gain = 0.000
Phase 2 Global Placement | Checksum: 131bc2226

Time (s): cpu = 00:00:30 ; elapsed = 00:00:21 . Memory (MB): peak = 2093.891 ; gain = 0.000

Phase 3 Detail Placement

Phase 3.1 Commit Multi Column Macros
Phase 3.1 Commit Multi Column Macros | Checksum: eead1338

Time (s): cpu = 00:00:32 ; elapsed = 00:00:22 . Memory (MB): peak = 2093.891 ; gain = 0.000

Phase 3.2 Commit Most Macros & LUTRAMs
Phase 3.2 Commit Most Macros & LUTRAMs | Checksum: b373a4a4

Time (s): cpu = 00:00:35 ; elapsed = 00:00:24 . Memory (MB): peak = 2093.891 ; gain = 0.000

Phase 3.3 Area Swap Optimization
Phase 3.3 Area Swap Optimization | Checksum: e76df3e8

Time (s): cpu = 00:00:36 ; elapsed = 00:00:24 . Memory (MB): peak = 2093.891 ; gain = 0.000

Phase 3.4 Pipeline Register Optimization
Phase 3.4 Pipeline Register Optimization | Checksum: 11948c712

Time (s): cpu = 00:00:36 ; elapsed = 00:00:24 . Memory (MB): peak = 2093.891 ; gain = 0.000

Phase 3.5 Small Shape Detail Placement
Phase 3.5 Small Shape Detail Placement | Checksum: cf066ff8

Time (s): cpu = 00:00:42 ; elapsed = 00:00:33 . Memory (MB): peak = 2093.891 ; gain = 0.000

Phase 3.6 Re-assign LUT pins
Phase 3.6 Re-assign LUT pins | Checksum: 12a4290d3

Time (s): cpu = 00:00:43 ; elapsed = 00:00:34 . Memory (MB): peak = 2093.891 ; gain = 0.000

Phase 3.7 Pipeline Register Optimization
Phase 3.7 Pipeline Register Optimization | Checksum: 1864cb9ea

Time (s): cpu = 00:00:44 ; elapsed = 00:00:34 . Memory (MB): peak = 2093.891 ; gain = 0.000
Phase 3 Detail Placement | Checksum: 1864cb9ea

Time (s): cpu = 00:00:44 ; elapsed = 00:00:35 . Memory (MB): peak = 2093.891 ; gain = 0.000

Phase 4 Post Placement Optimization and Clean-Up

Phase 4.1 Post Commit Optimization
INFO: [Timing 38-35] Done setting XDC timing constraints.

Phase 4.1.1 Post Placement Optimization
Post Placement Optimization Initialization | Checksum: 2297bdefa

Phase 4.1.1.1 BUFG Insertion

Starting Physical Synthesis Task

Phase 1 Physical Synthesis Initialization
INFO: [Physopt 32-721] Multithreading enabled for phys_opt_design using a maximum of 2 CPUs
INFO: [Physopt 32-619] Estimated Timing Summary | WNS=11.036 | TNS=0.000 |
Phase 1 Physical Synthesis Initialization | Checksum: 18fb26b8e

Time (s): cpu = 00:00:02 ; elapsed = 00:00:01 . Memory (MB): peak = 2093.891 ; gain = 0.000
INFO: [Place 46-33] Processed net u_reset/rst, BUFG insertion was skipped due to placement/routing conflicts.
INFO: [Place 46-56] BUFG insertion identified 1 candidate nets. Inserted BUFG: 0, Replicated BUFG Driver: 0, Skipped due to Placement/Routing Conflicts: 1, Skipped due to Timing Degradation: 0, Skipped due to Illegal Netlist: 0.
Ending Physical Synthesis Task | Checksum: 16d734483

Time (s): cpu = 00:00:02 ; elapsed = 00:00:01 . Memory (MB): peak = 2093.891 ; gain = 0.000
Phase 4.1.1.1 BUFG Insertion | Checksum: 2297bdefa

Time (s): cpu = 00:00:52 ; elapsed = 00:00:41 . Memory (MB): peak = 2093.891 ; gain = 0.000
INFO: [Place 30-746] Post Placement Timing Summary WNS=11.036. For the most accurate timing information please run report_timing.

Time (s): cpu = 00:00:52 ; elapsed = 00:00:41 . Memory (MB): peak = 2093.891 ; gain = 0.000
Phase 4.1 Post Commit Optimization | Checksum: 1de923e3b

Time (s): cpu = 00:00:53 ; elapsed = 00:00:41 . Memory (MB): peak = 2093.891 ; gain = 0.000

Phase 4.2 Post Placement Cleanup
Phase 4.2 Post Placement Cleanup | Checksum: 1de923e3b

Time (s): cpu = 00:00:53 ; elapsed = 00:00:41 . Memory (MB): peak = 2093.891 ; gain = 0.000

Phase 4.3 Placer Reporting

Phase 4.3.1 Print Estimated Congestion
INFO: [Place 30-612] Post-Placement Estimated Congestion 
 ____________________________________________________
|           | Global Congestion | Short Congestion  |
| Direction | Region Size       | Region Size       |
|___________|___________________|___________________|
|      North|                1x1|                1x1|
|___________|___________________|___________________|
|      South|                1x1|                1x1|
|___________|___________________|___________________|
|       East|                1x1|                1x1|
|___________|___________________|___________________|
|       West|                1x1|                1x1|
|___________|___________________|___________________|

Phase 4.3.1 Print Estimated Congestion | Checksum: 1de923e3b

Time (s): cpu = 00:00:53 ; elapsed = 00:00:42 . Memory (MB): peak = 2093.891 ; gain = 0.000
Phase 4.3 Placer Reporting | Checksum: 1de923e3b

Time (s): cpu = 00:00:53 ; elapsed = 00:00:42 . Memory (MB): peak = 2093.891 ; gain = 0.000

Phase 4.4 Final Placement Cleanup
Netlist sorting complete. Time (s): cpu = 00:00:00 ; elapsed = 00:00:00.016 . Memory (MB): peak = 2093.891 ; gain = 0.000

Time (s): cpu = 00:00:53 ; elapsed = 00:00:42 . Memory (MB): peak = 2093.891 ; gain = 0.000
Phase 4 Post Placement Optimization and Clean-Up | Checksum: 1efa44d78

Time (s): cpu = 00:00:53 ; elapsed = 00:00:42 . Memory (MB): peak = 2093.891 ; gain = 0.000
Ending Placer Task | Checksum: 15f85b7ce

Time (s): cpu = 00:00:53 ; elapsed = 00:00:42 . Memory (MB): peak = 2093.891 ; gain = 0.000
INFO: [Common 17-83] Releasing license: Implementation
141 Infos, 36 Warnings, 0 Critical Warnings and 0 Errors encountered.
place_design completed successfully
place_design: Time (s): cpu = 00:00:59 ; elapsed = 00:00:46 . Memory (MB): peak = 2093.891 ; gain = 0.000
Command: route_design
Attempting to get a license for feature 'Implementation' and/or device 'xc7z010'
INFO: [Common 17-349] Got license for feature 'Implementation' and/or device 'xc7z010'
Running DRC as a precondition to command route_design
INFO: [DRC 23-27] Running DRC with 2 threads
INFO: [Vivado_Tcl 4-198] DRC finished with 0 Errors
INFO: [Vivado_Tcl 4-199] Please refer to the DRC report (report_drc) for more information.

Starting Routing Task
INFO: [Route 35-254] Multithreading enabled for route_design using a maximum of 2 CPUs
Checksum: PlaceDB: b8c90f5e ConstDB: 0 ShapeSum: a6bca870 RouteDB: 0

Phase 1 Build RT Design
Phase 1 Build RT Design | Checksum: 10cd79d5b

Time (s): cpu = 00:00:16 ; elapsed = 00:00:14 . Memory (MB): peak = 2093.891 ; gain = 0.000
Post Restoration Checksum: NetGraph: ca7a2a73 NumContArr: 425d72e8 Constraints: 0 Timing: 0

Phase 2 Router Initialization

Phase 2.1 Create Timer
Phase 2.1 Create Timer | Checksum: 10cd79d5b

Time (s): cpu = 00:00:17 ; elapsed = 00:00:15 . Memory (MB): peak = 2093.891 ; gain = 0.000

Phase 2.2 Fix Topology Constraints
Phase 2.2 Fix Topology Constraints | Checksum: 10cd79d5b

Time (s): cpu = 00:00:17 ; elapsed = 00:00:15 . Memory (MB): peak = 2093.891 ; gain = 0.000

Phase 2.3 Pre Route Cleanup
Phase 2.3 Pre Route Cleanup | Checksum: 10cd79d5b

Time (s): cpu = 00:00:17 ; elapsed = 00:00:15 . Memory (MB): peak = 2093.891 ; gain = 0.000
 Number of Nodes with overlaps = 0

Phase 2.4 Update Timing
Phase 2.4 Update Timing | Checksum: 1eef9c54b

Time (s): cpu = 00:00:26 ; elapsed = 00:00:22 . Memory (MB): peak = 2093.891 ; gain = 0.000
INFO: [Route 35-416] Intermediate Timing Summary | WNS=11.217 | TNS=0.000  | WHS=-0.200 | THS=-275.296|

Phase 2.5 Update Timing for Bus Skew

Phase 2.5.1 Update Timing
Phase 2.5.1 Update Timing | Checksum: 186db8821

Time (s): cpu = 00:00:33 ; elapsed = 00:00:26 . Memory (MB): peak = 2093.891 ; gain = 0.000
INFO: [Route 35-416] Intermediate Timing Summary | WNS=11.217 | TNS=0.000  | WHS=N/A    | THS=N/A    |

Phase 2.5 Update Timing for Bus Skew | Checksum: 1f8c22d04

Time (s): cpu = 00:00:33 ; elapsed = 00:00:26 . Memory (MB): peak = 2093.891 ; gain = 0.000
Phase 2 Router Initialization | Checksum: 2160f9243

Time (s): cpu = 00:00:33 ; elapsed = 00:00:26 . Memory (MB): peak = 2093.891 ; gain = 0.000

Router Utilization Summary
  Global Vertical Routing Utilization    = 0 %
  Global Horizontal Routing Utilization  = 0 %
  Routable Net Status*
  *Does not include unroutable nets such as driverless and loadless.
  Run report_route_status for detailed report.
  Number of Failed Nets               = 15932
    (Failed Nets is the sum of unrouted and partially routed nets)
  Number of Unrouted Nets             = 15932
  Number of Partially Routed Nets     = 0
  Number of Node Overlaps             = 0

Phase 3 Initial Routing

Phase 3.1 Global Routing
Phase 3.1 Global Routing | Checksum: 2160f9243

Time (s): cpu = 00:00:33 ; elapsed = 00:00:26 . Memory (MB): peak = 2093.891 ; gain = 0.000
Phase 3 Initial Routing | Checksum: 165d54126

Time (s): cpu = 00:00:37 ; elapsed = 00:00:29 . Memory (MB): peak = 2093.891 ; gain = 0.000

Phase 4 Rip-up And Reroute

Phase 4.1 Global Iteration 0
 Number of Nodes with overlaps = 869
 Number of Nodes with overlaps = 2
 Number of Nodes with overlaps = 0
INFO: [Route 35-416] Intermediate Timing Summary | WNS=7.377  | TNS=0.000  | WHS=N/A    | THS=N/A    |

Phase 4.1 Global Iteration 0 | Checksum: 6ae0267d

Time (s): cpu = 00:00:45 ; elapsed = 00:00:35 . Memory (MB): peak = 2093.891 ; gain = 0.000

Phase 4.2 Global Iteration 1
 Number of Nodes with overlaps = 0
INFO: [Route 35-416] Intermediate Timing Summary | WNS=7.377  | TNS=0.000  | WHS=N/A    | THS=N/A    |

Phase 4.2 Global Iteration 1 | Checksum: 1dd664597

Time (s): cpu = 00:00:46 ; elapsed = 00:00:35 . Memory (MB): peak = 2093.891 ; gain = 0.000
Phase 4 Rip-up And Reroute | Checksum: 1dd664597

Time (s): cpu = 00:00:46 ; elapsed = 00:00:35 . Memory (MB): peak = 2093.891 ; gain = 0.000

Phase 5 Delay and Skew Optimization

Phase 5.1 Delay CleanUp

Phase 5.1.1 Update Timing
Phase 5.1.1 Update Timing | Checksum: 1a69fb1f4

Time (s): cpu = 00:00:47 ; elapsed = 00:00:36 . Memory (MB): peak = 2093.891 ; gain = 0.000
INFO: [Route 35-416] Intermediate Timing Summary | WNS=7.377  | TNS=0.000  | WHS=N/A    | THS=N/A    |

Phase 5.1 Delay CleanUp | Checksum: 152f541ab

Time (s): cpu = 00:00:47 ; elapsed = 00:00:36 . Memory (MB): peak = 2093.891 ; gain = 0.000

Phase 5.2 Clock Skew Optimization
Phase 5.2 Clock Skew Optimization | Checksum: 152f541ab

Time (s): cpu = 00:00:48 ; elapsed = 00:00:36 . Memory (MB): peak = 2093.891 ; gain = 0.000
Phase 5 Delay and Skew Optimization | Checksum: 152f541ab

Time (s): cpu = 00:00:48 ; elapsed = 00:00:36 . Memory (MB): peak = 2093.891 ; gain = 0.000

Phase 6 Post Hold Fix

Phase 6.1 Hold Fix Iter

Phase 6.1.1 Update Timing
Phase 6.1.1 Update Timing | Checksum: 18e45ebec

Time (s): cpu = 00:00:50 ; elapsed = 00:00:38 . Memory (MB): peak = 2093.891 ; gain = 0.000
INFO: [Route 35-416] Intermediate Timing Summary | WNS=7.377  | TNS=0.000  | WHS=0.020  | THS=0.000  |

Phase 6.1 Hold Fix Iter | Checksum: 200589876

Time (s): cpu = 00:00:50 ; elapsed = 00:00:38 . Memory (MB): peak = 2093.891 ; gain = 0.000
Phase 6 Post Hold Fix | Checksum: 200589876

Time (s): cpu = 00:00:50 ; elapsed = 00:00:38 . Memory (MB): peak = 2093.891 ; gain = 0.000

Phase 7 Route finalize

Router Utilization Summary
  Global Vertical Routing Utilization    = 7.38485 %
  Global Horizontal Routing Utilization  = 9.82445 %
  Routable Net Status*
  *Does not include unroutable nets such as driverless and loadless.
  Run report_route_status for detailed report.
  Number of Failed Nets               = 0
    (Failed Nets is the sum of unrouted and partially routed nets)
  Number of Unrouted Nets             = 0
  Number of Partially Routed Nets     = 0
  Number of Node Overlaps             = 0

Phase 7 Route finalize | Checksum: 1b9a7f785

Time (s): cpu = 00:00:50 ; elapsed = 00:00:38 . Memory (MB): peak = 2093.891 ; gain = 0.000

Phase 8 Verifying routed nets

 Verification completed successfully
Phase 8 Verifying routed nets | Checksum: 1b9a7f785

Time (s): cpu = 00:00:50 ; elapsed = 00:00:38 . Memory (MB): peak = 2093.891 ; gain = 0.000

Phase 9 Depositing Routes
Phase 9 Depositing Routes | Checksum: 16f0f35b0

Time (s): cpu = 00:00:52 ; elapsed = 00:00:40 . Memory (MB): peak = 2093.891 ; gain = 0.000

Phase 10 Post Router Timing
INFO: [Route 35-57] Estimated Timing Summary | WNS=7.377  | TNS=0.000  | WHS=0.020  | THS=0.000  |

INFO: [Route 35-327] The final timing numbers are based on the router estimated timing analysis. For a complete and accurate timing signoff, please run report_timing_summary.
Phase 10 Post Router Timing | Checksum: 16f0f35b0

Time (s): cpu = 00:00:52 ; elapsed = 00:00:41 . Memory (MB): peak = 2093.891 ; gain = 0.000
INFO: [Route 35-16] Router Completed Successfully

Time (s): cpu = 00:00:52 ; elapsed = 00:00:41 . Memory (MB): peak = 2093.891 ; gain = 0.000

Routing Is Done.
INFO: [Common 17-83] Releasing license: Implementation
156 Infos, 36 Warnings, 0 Critical Warnings and 0 Errors encountered.
route_design completed successfully
route_design: Time (s): cpu = 00:01:01 ; elapsed = 00:00:46 . Memory (MB): peak = 2093.891 ; gain = 0.000
INFO: [Timing 38-91] UpdateTimingParams: Speed grade: -1, Delay Type: min_max.
INFO: [Timing 38-191] Multithreading enabled for timing update using a maximum of 2 CPUs
WARNING: [Timing 38-436] There are set_bus_skew constraint(s) in this design. Please run report_bus_skew to ensure that bus skew requirements are met.
Command: report_drc -file drc.rpt
INFO: [IP_Flow 19-1839] IP Catalog is up to date.
INFO: [DRC 23-27] Running DRC with 2 threads
INFO: [Coretcl 2-168] The results of DRC are in file D:/Code/zynq_vibration_monitor/build/buzzer_release/debug/drc.rpt.
report_drc completed successfully
INFO: [Timing 38-91] UpdateTimingParams: No interconnect No Cell Dly, Speed grade: -1, Delay Type: min_max.
INFO: [Timing 38-191] Multithreading enabled for timing update using a maximum of 2 CPUs
INFO: [Timing 38-314] The report_cdc command only analyzes and reports clock domain crossing paths where clocks have been defined on both source and destination sides. Ports with no input delay constraint are skipped. Please run check_timing to verify there are no missing clock definitions in your design, nor any unconstrained input port.
report_io: Time (s): cpu = 00:00:00 ; elapsed = 00:00:00.049 . Memory (MB): peak = 2093.891 ; gain = 0.000
INFO: [Timing 38-91] UpdateTimingParams: Speed grade: -1, Delay Type: min_max.
INFO: [Timing 38-191] Multithreading enabled for timing update using a maximum of 2 CPUs
INFO: [Timing 38-35] Done setting XDC timing constraints.
INFO: [Timing 38-35] Done setting XDC timing constraints.
INFO: [Timing 38-480] Writing timing data to binary archive.
Writing placer database...
Writing XDEF routing.
Writing XDEF routing logical nets.
Writing XDEF routing special nets.
Write XDEF Complete: Time (s): cpu = 00:00:07 ; elapsed = 00:00:02 . Memory (MB): peak = 2093.891 ; gain = 0.000
INFO: [Common 17-1381] The checkpoint 'D:/Code/zynq_vibration_monitor/build/buzzer_release/debug/routed_system.dcp' has been generated.
write_checkpoint: Time (s): cpu = 00:00:11 ; elapsed = 00:00:07 . Memory (MB): peak = 2093.891 ; gain = 0.000
Command: write_bitstream -force system.bit
Attempting to get a license for feature 'Implementation' and/or device 'xc7z010'
INFO: [Common 17-349] Got license for feature 'Implementation' and/or device 'xc7z010'
Running DRC as a precondition to command write_bitstream
INFO: [IP_Flow 19-1839] IP Catalog is up to date.
INFO: [DRC 23-27] Running DRC with 2 threads
WARNING: [DRC DPOP-1] PREG Output pipelining: DSP u_core/u_processing/filtering/processing/fxu/accumulator0 output u_core/u_processing/filtering/processing/fxu/accumulator0/P[47:0] is not pipelined (PREG=0). Pipelining the DSP48 output will improve performance and often saves power so it is suggested whenever possible to fully pipeline this function.  If this DSP48 function was inferred, it is suggested to describe an additional register stage after this function.  If the DSP48 was instantiated in the design, it is suggested to set the PREG attribute to 1.
WARNING: [DRC DPOP-1] PREG Output pipelining: DSP u_core/u_processing/filtering/processing/fyu/accumulator0 output u_core/u_processing/filtering/processing/fyu/accumulator0/P[47:0] is not pipelined (PREG=0). Pipelining the DSP48 output will improve performance and often saves power so it is suggested whenever possible to fully pipeline this function.  If this DSP48 function was inferred, it is suggested to describe an additional register stage after this function.  If the DSP48 was instantiated in the design, it is suggested to set the PREG attribute to 1.
WARNING: [DRC DPOP-1] PREG Output pipelining: DSP u_core/u_processing/filtering/processing/fzu/accumulator0 output u_core/u_processing/filtering/processing/fzu/accumulator0/P[47:0] is not pipelined (PREG=0). Pipelining the DSP48 output will improve performance and often saves power so it is suggested whenever possible to fully pipeline this function.  If this DSP48 function was inferred, it is suggested to describe an additional register stage after this function.  If the DSP48 was instantiated in the design, it is suggested to set the PREG attribute to 1.
WARNING: [DRC DPOP-2] MREG Output pipelining: DSP u_core/u_processing/features/px_reg multiplier stage u_core/u_processing/features/px_reg/P[47:0] is not pipelined (MREG=0). Pipelining the multiplier function will improve performance and will save significant power so it is suggested whenever possible to fully pipeline this function.  If this multiplier was inferred, it is suggested to describe an additional register stage after this function.  If there is no registered adder/accumulator following the multiply function, two pipeline stages are suggested to allow both the MREG and PREG registers to be used.  If the DSP48 was instantiated in the design, it is suggested to set both the MREG and PREG attributes to 1 when performing multiply functions.
WARNING: [DRC DPOP-2] MREG Output pipelining: DSP u_core/u_processing/features/py_reg multiplier stage u_core/u_processing/features/py_reg/P[47:0] is not pipelined (MREG=0). Pipelining the multiplier function will improve performance and will save significant power so it is suggested whenever possible to fully pipeline this function.  If this multiplier was inferred, it is suggested to describe an additional register stage after this function.  If there is no registered adder/accumulator following the multiply function, two pipeline stages are suggested to allow both the MREG and PREG registers to be used.  If the DSP48 was instantiated in the design, it is suggested to set both the MREG and PREG attributes to 1 when performing multiply functions.
WARNING: [DRC DPOP-2] MREG Output pipelining: DSP u_core/u_processing/features/pz_reg multiplier stage u_core/u_processing/features/pz_reg/P[47:0] is not pipelined (MREG=0). Pipelining the multiplier function will improve performance and will save significant power so it is suggested whenever possible to fully pipeline this function.  If this multiplier was inferred, it is suggested to describe an additional register stage after this function.  If there is no registered adder/accumulator following the multiply function, two pipeline stages are suggested to allow both the MREG and PREG registers to be used.  If the DSP48 was instantiated in the design, it is suggested to set both the MREG and PREG attributes to 1 when performing multiply functions.
WARNING: [DRC RTSTAT-10] No routable loads: 25 net(s) have no routable loads. The problem bus(es) and/or net(s) are dbg_hub/inst/BSCANID.u_xsdbm_id/CORE_XSDB.UUT_MASTER/U_ICON_INTERFACE/U_CMD6_RD/U_RD_FIFO/SUBCORE_FIFO.xsdbm_v3_0_0_rdfifo_inst/inst_fifo_gen/gconvfifo.rf/grf.rf/gntv_or_sync_fifo.gl0.rd/gr1.gr1_int.rfwft/aempty_fwft_i, dbg_hub/inst/BSCANID.u_xsdbm_id/CORE_XSDB.UUT_MASTER/U_ICON_INTERFACE/U_CMD7_CTL/ctl_reg[2:0], dbg_hub/inst/BSCANID.u_xsdbm_id/CORE_XSDB.UUT_MASTER/U_ICON_INTERFACE/U_CMD1/ctl_reg_en_2[1], dbg_hub/inst/BSCANID.u_xsdbm_id/CORE_XSDB.UUT_MASTER/U_ICON_INTERFACE/U_CMD7_CTL/ctl_reg_en_2[1], dbg_hub/inst/BSCANID.u_xsdbm_id/SWITCH_N_EXT_BSCAN.bscan_switch/m_bscan_capture[0], dbg_hub/inst/BSCANID.u_xsdbm_id/SWITCH_N_EXT_BSCAN.bscan_switch/m_bscan_drck[0], dbg_hub/inst/BSCANID.u_xsdbm_id/SWITCH_N_EXT_BSCAN.bscan_switch/m_bscan_runtest[0], dbg_hub/inst/BSCANID.u_xsdbm_id/CORE_XSDB.UUT_MASTER/U_ICON_INTERFACE/U_CMD6_RD/U_RD_FIFO/SUBCORE_FIFO.xsdbm_v3_0_0_rdfifo_inst/inst_fifo_gen/gconvfifo.rf/grf.rf/gntv_or_sync_fifo.gl0.wr/gwhf.whf/overflow, dbg_hub/inst/BSCANID.u_xsdbm_id/CORE_XSDB.UUT_MASTER/U_ICON_INTERFACE/U_CMD6_WR/U_WR_FIFO/SUBCORE_FIFO.xsdbm_v3_0_0_wrfifo_inst/inst_fifo_gen/gconvfifo.rf/grf.rf/gntv_or_sync_fifo.gl0.wr/gwhf.whf/overflow, dbg_hub/inst/BSCANID.u_xsdbm_id/CORE_XSDB.UUT_MASTER/U_ICON_INTERFACE/U_CMD6_RD/U_RD_FIFO/SUBCORE_FIFO.xsdbm_v3_0_0_rdfifo_inst/inst_fifo_gen/gconvfifo.rf/grf.rf/gntv_or_sync_fifo.gl0.rd/gras.rsts/ram_empty_i, dbg_hub/inst/BSCANID.u_xsdbm_id/CORE_XSDB.UUT_MASTER/U_ICON_INTERFACE/U_CMD6_WR/U_WR_FIFO/SUBCORE_FIFO.xsdbm_v3_0_0_wrfifo_inst/inst_fifo_gen/gconvfifo.rf/grf.rf/gntv_or_sync_fifo.gl0.wr/gwas.wsts/ram_full_i, dbg_hub/inst/BSCANID.u_xsdbm_id/CORE_XSDB.UUT_MASTER/U_ICON_INTERFACE/U_CMD6_WR/U_WR_FIFO/SUBCORE_FIFO.xsdbm_v3_0_0_wrfifo_inst/inst_fifo_gen/gconvfifo.rf/grf.rf/rstblk/rd_rst_reg[0], dbg_hub/inst/BSCANID.u_xsdbm_id/SWITCH_N_EXT_BSCAN.bscan_inst/s_bscan_tms, stage7_ila/inst/ila_core_inst/u_ila_regs/U_XSDB_SLAVE/s_daddr_o[13], stage7_ila/inst/ila_core_inst/u_ila_regs/U_XSDB_SLAVE/s_daddr_o[14]... and (the first 15 of 23 listed).
WARNING: [DRC ZPS7-1] PS7 block required: The PS7 cell must be used in this Zynq design in order to enable correct default configuration.
INFO: [Vivado 12-3199] DRC finished with 0 Errors, 8 Warnings
INFO: [Vivado 12-3200] Please refer to the DRC report (report_drc) for more information.
INFO: [Designutils 20-2272] Running write_bitstream with 2 threads.
Loading data files...
Loading site data...
Loading route data...
Processing options...
Creating bitmap...
Creating bitstream...
Writing bitstream ./system.bit...
INFO: [Vivado 12-1842] Bitgen Completed Successfully.
INFO: [Project 1-120] WebTalk data collection is mandatory when using a WebPACK part without a full Vivado license. To see the specific WebTalk data collected for your design, open the usage_statistics_webtalk.html or usage_statistics_webtalk.xml file in the implementation directory.
INFO: [Common 17-83] Releasing license: Implementation
179 Infos, 45 Warnings, 0 Critical Warnings and 0 Errors encountered.
write_bitstream completed successfully
write_bitstream: Time (s): cpu = 00:00:27 ; elapsed = 00:00:25 . Memory (MB): peak = 2491.754 ; gain = 397.863
PASS buzzer release debug setup=7.377 hold=0.020
INFO: [Common 17-206] Exiting Vivado at Sun Nov  1 23:29:10 2026...
PASS buzzer_release variant=debug mode=1 setup_slack=7.377 hold_slack=0.020
