FFsteve/zynq_vibration_monitor/report/filter_test_2_validation_20261101.md

# 校准后真实输入与滤波回传核查

日期：2026-11-01。原始记录：`report/evidence/fixed_filter_ila_20261101/filter_test_2/`。

## 结论与范围

本次数据证实新校准公式已体现在STM32实际发送值中，且真实输入下FPGA回传与既有定点滤波参考一致。只用完整实测D0、对各连续段单独排除未知初态影响后，2892帧三轴回传全部精确匹配。另用I2C校准公式补全62帧D0缺测后，整体后段3986帧也精确匹配；补全值明确标记为重建，不作为实测D0。

用户确认本次没有重新配置FPGA，STM32已启动后才开始记录；约5.76～6.05秒开始移动模块，可能碰到探头或线缆。因此不将首包视作滤波初始化，不把本记录签成从冷启动开始的完整验收。D0在上述时段发生采集错误，但D1和I2C连续，较支持D0探测/采集路径受扰；仅凭本记录不能定位具体接触点或电气原因，也不能将D0的62帧缺测认定为FPGA丢包。

本次目录包含波形归档、I2C CSV和两路UART CSV，没有新增ILA导出。不能由UART包推断内部窗口RMS、峰值、报警或历史重建计数已经通过。

## 原始记录与通信

归档CRC通过，实际设置20秒、20MS/s、Buffer、RLE启用、1.5V门限。四个原文件分析前后SHA256一致，完整指纹保存在派生JSON。

| 通道 | 实际结果 | 含义 |
|---|---|---|
| I2C | 14989笔完整事务；3A读取9980次、3B六字节读取5009次；ACK及事务检查无异常 | 可以独立校核传感器读取值 |
| D0 | 4948个完整有效包；4处SEQ不连续，累计缺62帧；16条警告/Break标记、8处字节停止位问题 | 5.763～6.041秒附近受扰；不是一份完整无错输入记录 |
| D1 | 5010个完整有效包；SEQ从FA连续绕回至8B，共20次回绕；校验、起止位检查无错，无丢弃字节、重复或SEQ缺口 | FPGA回传全程连续，包括D0测量异常时段 |

D0的两个主要包起点间隔为168.001ms和78.992ms，另有两处单包缺测。D1没有对应中断，I2C也保留其间的读取记录。用户所述移动/可能碰触的时间与异常相符，接触受扰仍属于有依据的推断，尚非已定位根因。

D1平均包间隔3.992159ms，范围2.994～4.011ms，实际约250.491包/秒；39次约3ms短间隔仍约每0.5秒出现，与此前SensorSource现象一致。SEQ连续并不能证明严格均匀250Hz采样。受控频响及时间轴解释仍需保留这个限制。

## 新校准固件输出

采用已保存的 `sixface_r1_20261101_validated` 参数，按固件Q16零偏/比例、舍入和饱和规则，从每笔I2C六字节原始值重算D0。4947帧可配对记录三轴全部精确相同，无校准差异；首个D0对应的I2C发生在采集左边界之前，没有对应完整事务，单独排除。

这证实板上输出行为符合新校准公式；本次未从芯片回读Flash或直接读取下载产物指纹，不能由数值匹配补写实际烧录HEX的身份验证。

0～5.5秒作为移动前观察段，共1378帧。D0均值X/Y/Z为−132.774/−599.511/16457.110计数，约−0.00810/−0.03659/+1.00446g，符合近似Z朝上；该短记录不替代已完成的六面独立验证。I2C读取结束至校正D0包起点平均138.948µs，范围128.150～151.200µs。

## 定点滤波逐帧对照

参考严格采用现有RTL顺序：基线Q16以误差算术右移5位更新、去直流结果舍入、63抽头Q16 FIR、舍入及signed18饱和，再算术右移2位成为UART的signed16。系数文件指纹与rc1源码清单一致。实际对照的是完整打包后的三轴整数；D1乘4只恢复尺度，不能恢复被右移丢掉的两位，因此不宣称内部signed18低两位已逐位核验。

FPGA未重配使初始基线和FIR历史未知。分析没有将首样本当作实际初始化：从signed32基线全范围保守传播上下界，按系数正负计算FIR输出区间；首62个样本之后旧FIR历史被覆盖，再保守跳过1024个样本。以下检查点的输出上下界均收敛为同一个UART整数，实际D1与该整数相同。

| 对照来源 | 检查时间，按D1包起点 | 检查帧数 | 三轴结果 |
|---|---|---:|---|
| 首段1444帧连续实测D0，独立处理初态 | 4.089153～5.762125秒 | 420 | 全部精确匹配 |
| 末段3496帧连续实测D0，独立处理初态 | 10.133072～19.997929秒 | 2472 | 全部精确匹配 |
| 合计，仅实测D0，不借助缺测重建 | 两段 | 2892 | 最大差X/Y/Z均为0 |
| 整段输入，其中62帧由I2C+校准重建 | 4.089153～19.997929秒 | 3986 | 全部精确匹配，最大差0 |

连续模型结果与D1及I2C不断流相符。重建比较不是独立证明STM32当时发送了全部62个缺测包；纯实测两段检查已单独给出，避免依赖这项推断。首段初始化过程和中途历史重启计数没有直接观测，不作启动/恢复验收。

4948帧实测D0到同SEQ D1的包起点延迟平均867.738µs，范围867～868µs。该量包含接收输入包的串行时间，不能解释为单独的FIR计算耗时。

## 静止与移动响应

下表D1均已乘4，单位与校准D0相同；标准差描述此段波动，不是内部128点窗口的RMS读数。

| 时间段与指标 | X | Y | Z |
|---|---:|---:|---:|
| 移动前0～5.5秒D0标准差 | 147.082 | 88.405 | 97.520 |
| 同段D1恢复尺度后均值 | −1.408 | −1.736 | −1.565 |
| 同段D1恢复尺度后标准差 | 107.665 | 60.921 | 43.976 |
| 6.1秒后D0标准差 | 716.222 | 1121.976 | 1487.515 |
| 同段D1恢复尺度后标准差 | 502.022 | 362.974 | 323.709 |
| 同段D1恢复尺度后最小值 | −3332 | −2032 | −2940 |
| 同段D1恢复尺度后最大值 | 3672 | 1960 | 2000 |

移动前Z约1g的重力直流经处理后接近零，移动后的非零动态输出明显增加，行为与去直流加低通滤波一致。手动移动并非已知频率、幅值的标准激励，不据此判定精确频响；瞬时峰值超过某门限也不代表窗口RMS和连续窗口报警条件已经满足。

## 验收状态与下一步

- 新校准公式板上数值验证：本次4947帧匹配，已取得证据，不再写“尚无新固件实际输出”。正式版本身份与整机签收仍待补。
- B07：真实输入稳态逐帧运算已取得直接证据；从已知初始化开始、全程无缺测的完整记录仍未验证。无需因本次D0缺测就改RTL或重拟合校准参数。
- B08：继续用配对debug bit/ltx，以 `debug_feature_valid_o == 1` 触发，保存静止和移动两种有效窗口的原始ILA数据及CSV，包含窗口ID、首末SEQ、MS/RMS/峰值、quality/alarm_valid、alarm_axes和收发/重建/作废计数。GUI显示名可以是hw_ila_1，按探针信号名辨认stage7_ila。
- 若要一次补齐严格B07启动证据：停止STM32发送，重新配置同版debug FPGA；先启动DL16采集，再让STM32启动，保存初始化及首包到静止、移动、恢复静止的完整记录。固定探头和线缆，仅移动传感器支撑，保留D0/D1/I2C；如受20秒长度限制，至少保存清晰的启动与后段动态。无需再做六面校准。
- B09受控数字频率、B10中断恢复/冷启动、3ms周期与此前静止瞬态的根因仍分别待验收/定位。

## 可复现记录

实际执行并退出0：

```powershell
& 'C:\Users\QQ165\.cache\codex-runtimes\codex-primary-runtime\dependencies\python\python.exe' -X utf8 report/evidence/analyze_filter_test_2_20261101.py
```

日志为 `build/filter_test_2_analysis_20261101.log`，末行 `PASS filter_test_2_analysis_completed originals_unchanged` 表示本次分析和原文件不变检查完成，不表示整个项目验收通过。

派生结果为 `report/evidence/filter_test_2_20261101_analysis/analysis.json` 与 `comparison.csv`。CSV的 `input_source` 区分实测和重建输入；首段点参考仅为展示，可信判定须采用报告所列已收敛区间。脚本使用标准库及既有协议解析器，没有更改RTL、固件、约束、Vivado缓存、下载设置或原始采集文件；本轮没有重新仿真、构建或操作硬件。
