FFsteve/zynq_vibration_monitor/report/fixed_filter_ila_validation_20261101.md

# 固定源滤波回传与ILA零特征检查

日期：2026-11-01。用户提供原波形、D0/D1 UART CSV和ILA触发结果PNG，保存在 `report/evidence/fixed_filter_ila_20261101/`。**本份5秒记录的固定源滤波归零回传通过；ILA截图支持有效窗口的零特征与无报警状态。动态特征、报警置位/解除及历史重启原因尚未验收，不把整个B08标为通过。**

## 输入与实际执行

四份文件为 `ila_debug.atkdl`、`uart_d0_ila_debug.csv`、`uart_d1_ila_debug.csv`、`ila.png`。原波形ZIP CRC通过，设置为20MS/s、5秒、Buffer、RLE关闭、1.5V门限。四文件分析前后SHA256相同，未修改原始证据。

```powershell
& 'C:\Users\QQ165\.cache\codex-runtimes\codex-primary-runtime\dependencies\python\python.exe' -X utf8 report/evidence/analyze_fixed_filter_ila_20261101.py
```

实际退出0，标记 `PASS_FIXED_SOURCE_FILTERED_UART` 和 `PASS fixed_filter_analysis originals_unchanged`。分析复用逐位/起止位核验、独立协议解码和连续性检查，额外逐包验证固定输入、零三轴输出、对应SEQ和输出CHK=SEQ。输出为 `report/evidence/fixed_filter_ila_20261101_analysis/analysis.json`。

ILA截图由本轮实际打开查看后人工读取，JSON明确标记人工审阅；没有提供原始ILA CSV或数据文件，不能把PNG分析伪称为逐采样点自动比对。atkdl是DL16波形，不是ILA原始数据。串口采集与ILA截图也未证明属于同一时间区间，两类证据分别解释，不仅凭重复SEQ跨记录配对。

## UART固定源与滤波输出

| 项目 | D0输入 | D1回传 |
| --- | --- | --- |
| 完整合法包 | 1250 | 1250 |
| 三轴 | 每包均为1/−1/−32768 | 每包均为0/0/0 |
| 首末SEQ | A3～84，正常回绕5次 | 与D0对应包全部相同 |
| XOR与字节位值 | 全部正确 | 全部正确，CHK=SEQ |
| 序号缺口/重复 | 0/0 | 0/0 |
| UART警告/字节起止位问题 | 0/0 | 0/0 |
| 未组包字节/尾部缓存 | 0 | 0 |

D0首末包起点0.00207705～4.998013秒，平均包间隔3.9999487ms、最小3.992ms、最大4.002ms，约250.003包/秒。本份固定源记录未出现此前SensorSource中的约3ms间隔。D1包起点相对D0同包平均延后867.738微秒，范围约867～868微秒。

固定向量有意包含−32768，不把这个输入端点解释为传感器饱和，也不把向量合成幅值换算为真实重力。零输出验证了本次恒定输入的去直流与滤波回传路径；单一恒定输入不能测出5～30Hz通带、50Hz以上衰减或动态数值精度。

固定源没有3ms短间隔，为后续优先核查SensorSource的DATA_RDY/轮询节拍提供对照，但不能仅凭此确定传感器内部采样、时基或硬件的唯一根因。

## ILA截图中的实际读数

| 信号 | 图中情况 | 本轮解释 |
| --- | --- | --- |
| 三轴MS/RMS/绝对峰值 | 均为0 | 固定输入去直流后的零特征符合预期 |
| quality_valid | 1 | 截图区间数据质量有效 |
| alarm_valid | 1 | 报警状态有效 |
| alarm_axes | 000 | 有效无报警状态，不是质量无效造成的假解除 |
| window_id | C1→C2，即193→194 | 触发附近有新窗口提交 |
| seq_start/seq_end | 3E/BD→BE/3D | 两组模256跨度均127，符合128样本窗口 |
| dropped_count | 0 | 该截图时刻外部回传丢弃计数为0 |
| filter_restart_count | 2 | 已存在两次滤波历史重建事件，原因未确认 |
| aborted_windows | 2 | 已存在两次活动窗口作废，原因未确认 |

图中左侧值栏的feature_valid=0对应黄色光标在记录开始处；红色T位于中部，窗口编号与SEQ范围在附近发生变化。不能用左侧这个0认定触发失败，也不能凭压缩截图声称已自动核对20ns单拍。后续可把光标移动到提交位置并放大，或导出ILA数据检查。

该快照只覆盖短时间，不能据窗口编号变化直接测得512ms更新周期。历史重建/作废计数不为0，可能涉及此前停止发送、复位、切换程序或序号变化，但现有证据不能确定。两个计数也不能与稍后5秒UART记录强行关联为本段错误，不能说从配置启动至今零异常。

后续B10从新配置FPGA的干净状态开始，记录诊断计数随操作的变化，按实际事件核对断流/恢复；保留本次已有计数，不清零后覆盖原证据。

## 通过范围与下一步

- B03本份FixedSource滤波归零回传：通过，1250个完整对应包。
- B08固定源有效零窗口快照：符合预期，已取得截图证据；整项仍待动态数值、窗口发布对齐、报警置位/解除等验证。
- B06固定源对照：本份约4ms，不能替代SensorSource短间隔问题定位。
- B09动态频响、B10异常恢复/冷启动、B12完整版本演示：本次没有执行。

下一步进行B07真实输入同次滤波对照：STM32使用新参数SensorCalibratedTrial，FPGA仍可使用同版debug bit/ltx；从可重建初始状态的干净启动开始保存D0/D1。D0已校正，D1为去直流/FIR后signed16线缆值，乘4恢复尺度；静止下通常接近零而非每包必为零，轻微运动只用于趋势演示。准确比对以D0事件序列驱动定点参考，精确频响仍需受控激励。

本轮只离线读取、分析和人工审阅用户已有截图，未操作硬件、重新采集、修改固件/RTL/约束、重建Vivado或改变rc1。按用户此前下载说明将本次解释为rc1/debug滤波调试版，完整版本与板测元数据仍随最终演示归档。
