FFsteve/zynq_vibration_monitor/docs/stage4_test_plan.md

# 第四阶段测试与验收计划

设计日期：2026-10-30；执行更新：2026-10-31。本文保留验收合同，实际完成范围以 `../report/stage4_validation.md` 为准，复现操作见 `stage4_test_guide.md`。

## 本轮可以执行的数值检查

```powershell
& 'C:\Users\QQ165\.cache\codex-runtimes\codex-primary-runtime\dependencies\python\python.exe' -X utf8 host/stage4_reference.py
```

需要NumPy；本机已有依赖，未安装新库。输出为 `build/stage4_reference/` 下的频响CSV、18组样本/去直流/滤波期望CSV和JSON；系数写入 `data/reference/stage4/`。这是可重复执行的数值设计检查，没有调用ModelSim或Vivado。系数是设计产物，改变设计参数后不能静默沿用旧RTL结果。

检查包括常量、满幅、正负阶跃、预置零历史后的冲激、正负翻转、交替极值、固定种子随机和5/10/20/30/50/60/80/100Hz正弦；另检查半单位舍入、窄输出饱和和系数符号对齐的累加界限。分别使用无界整数点积与NumPy卷积，浮点基线参考不复刻未来RTL状态机。

## 单轴去直流自检

- 正常：首样本建立基线并输出0，恒定0/正偏置/负偏置/正负极值，阶跃和渐变。
- 数值：Q16基线、33位差、向负无穷移位和远离零的半单位舍入；输入 -32768→32767 及反向，不能在16位减法处先溢出。
- 事件：无有效事件期间状态冻结，每拍输入、间隔输入和长暂停的样本域结果一致。
- 恢复：全局复位、有效样本同拍restart、空闲restart不生成数据；新序列不继承旧基线。
- 验收：每个有效样本恰好一个对应结果，位级匹配Python整数参考，输出无X/Z，基线范围成立。

## 单轴FIR自检

- 系数：63个、signed18、和65536、对称、文件哈希一致；测试缺失文件时不能得到PASS。
- 卷积：冲激响应、常量、正负阶跃、随机及系数符号对齐的极值；验证tap0对应当前样本，环形地址62→0正确。
- 精度：完整35位乘积、41位累加、不逐项截断；舍入正负和半单位正确；默认18位无意外饱和，窄输出变体验证正负饱和。
- 时序：接受沿到输出严格190拍，最短接纳间隔191拍；忙时保持请求和数据，未握手不写历史。
- 初始化：未写历史不产生X，前62样本补零，第63个history_full；restart同拍输入后再次从计数1开始。
- 恢复：LOAD/MUL/ACC/ROUND各阶段复位，旧在途结果不外泄；后续合法输入重新输出。
- 频域：使用整数RTL输出估计稳态正弦增益，对应Python结果及衰减验收；不用只看波形平滑程度代替频率检查。

## 三轴调度自检

- 三轴使用不同幅度、符号与频率，SEQ携带不同值，确认独立历史且同拍提交，不能把三个轴的样本混合。
- 验证193拍输出延迟、194拍最短接纳间隔、250包/s正常间隔及不规则空闲；合法输入与输出计数对应。
- 只在接纳时更新基线和FIR。忙时一拍事件产生overrun和丢弃计数，当前快照保持；下一接纳样本重启恢复。
- 验证FF→00正常、跳号/重复重启、内部丢弃后的重启，历史完整标志重新累计。
- 用足够长于计算延迟的缩短测试阈值覆盖断流阈值前/边界/后；断流只标记一次，无伪样本，恢复时建立新基线。
- 全局复位优先于接纳、完成和超时；输入与复位同拍不接纳，不能出现重置后旧输出。
- 交叉验收：逐样本位级对照Python期望；同时与使用量化系数的独立浮点基线/卷积比较，正常未饱和时误差不超过2个输出计数。

## 通信适配自检

- 通过真实UART位流发送包，独立解码返回字节；原始十字节包保持内容、SEQ和XOR不变。
- 在内部结果端核对滤波SEQ和三轴数据，不要求从原始回传包读到滤波结果。
- 坏包头、坏XOR、停止位错误、各处截断、超时及后续恢复；坏帧不推进滤波器。
- 负数、极值、载荷含A5/5A、SEQ回绕和跳号；SEQ不连续时原始包仍按既有约定回传，滤波支路重建状态。
- 250包/s至少覆盖多个SEQ回绕；串口输入正常下无滤波overrun。额外高频事件压力在模块级单独施加，不假装物理UART可每拍一包。
- 本轮真实静止记录只有约12个完整样本，短于63抽头历史，不能据此验证真实滤波频响；可作字段回放，不能作传感器效果验收。

## ModelSim 与 Vivado 的实现后检查

RTL/TB获批并创建后，运行脚本应分别编译四个测试顶层，复制并核验系数，运行到自检完成。ModelSim使用vlog/vsim；Vivado仿真使用xvlog/xelab/xsim。两者调用同一组期望向量，不用其中一个仿真器生成另一个的期望。

每次先把结果标为NOT_RUN，检查当前退出码、超时看门狗、结果文件和 `PASS ... errors=0` 标记，不能沿用历史PASS。结果统一写入独立 `build/modelsim_stage4/` 和 `build/xsim_stage4/`。波形至少保留基线、样本有效/接纳、MAC状态/索引、乘积/累加、输出SEQ及历史标志。

`sim/run_stage4.ps1` 已实现；完整命令和ModelSim/XSim GUI操作见 [测试指南](stage4_test_guide.md)。

综合在独立目录作 out-of-context 检查，目标器件沿用现有工程，时钟目标20ns；报告LUT/FF/DSP/存储及内部时序，不因计算只需约4us就省略时序检查。当前板级top不接该滤波支路，不能综合一个会把未使用滤波逻辑全部优化掉的原始top后声称新模块零资源。

若未修改既有通信源，不因文档/系数变更重复全部板级构建；集成验证发现改动必要时，再选择对应原有回归。没有实际执行，不声称RTL仿真、综合或板测通过。

## 上板与阶段完成标准

第四阶段软件验收需：四个模块对应自检在两仿真器通过、位级输出对照通过、频域/动态范围符合合同、隔离综合资源与内部时序有实际记录。原始回传回归需保持正确。

上板滤波演示不是本轮默认动作。后续接入特征模块或明确的滤波结果观测通道后再做；无需现在修改针脚或烧录设置。即使RTL检查通过，也应把物理采样均匀性、传感器初始化/校准和真实滤波效果列为单独实物验收。
