FFsteve/zynq_vibration_monitor/report/sensor_source_validation_20261030.md

# SensorSource 实物采集核查

日期：2026-10-30。用户授权通过电脑操作已打开的 ATK-LogicView，检查其此前采集的数据。本轮只查看、另存和导出已有记录，没有开始新采集、复位硬件、重新烧录或修改固件/RTL/XDC。

## 结论

**本段记录的传感器数据通信闭环通过；传感器静止测量值验收暂未通过，不能宣布 SensorSource 全部验收完成。**

- 12 组完整 I2C 六字节读取，均与随后 D0 包内三轴字段以及 D1 对应回传逐字节一致。
- D0 的 12 个完整包为 ED～F8，D1 的 13 个完整包为 EC～F8；所有完整包 XOR 正确，各路所见完整包序号连续，无重复。D0 开头只有 EC 包末尾三个字节，不能把两路完整包数量不同解释成 FPGA 多发。
- 37 笔完整 I2C 事务的地址/寄存器/读数和 ACK 模式符合当前驱动：25 笔 3A 状态轮询、12 笔 3B 起六字节读取，读事务末字节 NACK 正常。记录末尾另有一笔未完成的 3B 读取，不计入完整事务。
- 捕获未包含 WHO_AM_I、复位写入或配置回读；初始化验收仍未完成。
- 用户明确本次采集时“完全静止平放”。三轴合成原始计数平均约 21961.82；若源码规定的 ±2g 配置确实生效，相当于约 1.34044g，与静止约 1g 的期望不符。该问题不能因通信正确而忽略。

## 获取与证据保存

通过 computer-use 技能操作既有 ATK-Logic V1.1.2.1 / DL16 窗口，观察到采集状态栏为 50 ms、20 MHz、阈值 1.5V、深度 1 MSa/ch、USB2.0。根据既有用户测点描述和界面通道标签，将 D0 作为 STM32 输入、D1 作为 FPGA 回传、D2/D3 作为 I2C 两线；没有重新检查实物探头接法。

从协议列表分别选中 D0 UART、D1 UART、I2C，通过“导出协议数据”导出整个解码表，并另存原始波形工程：

- [原始采集工程](evidence/sensor_source_20261030.atkdl)
- [D0 协议 CSV](evidence/sensor_source_d0_20261030.csv)
- [D1 协议 CSV](evidence/sensor_source_d1_20261030.csv)
- [I2C 协议 CSV](evidence/sensor_source_i2c_20261030.csv)
- [独立分析脚本](evidence/analyze_sensor_capture_20261030.py)
- [逐包结果与文件 SHA256](evidence/sensor_source_analysis_20261030.json)

厂商 CSV 为 GB18030 编码，保留原始字节；新增 Python、Markdown、JSON 为 UTF-8。CSV 是协议解码记录，不是原始采样 BIN。原始 atkdl 的 ZIP CRC 检查通过，且含通道 0～3 的采样文件；没有通过重新采集覆盖数据。原工程中已有的所有设置并非均获独立验证，本轮不以运行中的 Keil 源码替代实际下载版本的证明。

## 逐包比较

下表各行均核对 I2C 六字节＝D0 的 XH～ZL＝D1 的 XH～ZL，D0/D1 完整十字节相同且 XOR 正确。三轴使用大端有符号 16 位补码。

| SEQ | I2C 六字节／UART 三轴字段 | X | Y | Z | CHK |
|---|---|---|---|---|---|
| ED | 01 DA FE DC 55 C2 | 474 | -292 | 21954 | 83 |
| EE | 02 92 FE E4 55 A4 | 658 | -284 | 21924 | 95 |
| EF | 01 FC FE E4 55 B4 | 508 | -284 | 21940 | E9 |
| F0 | 02 06 FF 1C 55 6E | 518 | -228 | 21870 | 2C |
| F1 | 02 44 FF 52 56 00 | 580 | -174 | 22016 | 4C |
| F2 | 01 92 FF 5E 56 02 | 402 | -162 | 22018 | 94 |
| F3 | 02 56 FF 6C 55 70 | 598 | -148 | 21872 | 11 |
| F4 | 02 28 FE C4 55 DC | 552 | -316 | 21980 | 6D |
| F5 | 01 DC FE 44 55 FC | 476 | -444 | 22012 | 3B |
| F6 | 02 C0 FE 90 55 BE | 704 | -368 | 21950 | B1 |
| F7 | 01 DA FE 56 55 E8 | 474 | -426 | 21992 | 39 |
| F8 | 02 8A FE A8 55 90 | 650 | -344 | 21904 | E3 |

例如 ED 包：I2C 从 3B 读取 `01 DA FE DC 55 C2`，D0 与 D1 都为 `A5 5A ED 01 DA FE DC 55 C2 83`。原始计数的传输、符号和顺序正确；不能据此保证物理加速度值准确。

采集左边界的 D0 仅有 `56 02 45`，D1 的 EC 包为 `A5 5A EC 02 1A FF 1A 56 02 45`，尾部一致，且 EC 正好在 ED 前面。这支持它是窗口开始前已开始输入的包；缺失的输入前七字节不作直接对照通过。

## 时序

- I2C 解码的数据位常见宽度 10 us，与约 100 kHz 相符；不以 SDA 的任意高低电平宽度代替 SCL 周期测量。
- 六字节事务结束到 D0 起始位为约 9.15～16.10 us。
- D0 起始到对应 D1 起始为约 863.80～863.85 us，符合最后停止位中点确认后启动整包回传的设计。回传无需等到输入解码器绘出的整个停止位结束。
- ED→EE 起点间隔为 2.99475 ms；其余十个间隔为 3.99300～4.00170 ms，十个间隔平均 3.999945 ms。包含首个短间隔的十一段平均为 3.908564 ms，不能只报告排除它后的平均值。

本次没有证据定位约 3 ms 间隔的根因。当前程序按毫秒时基轮询 DATA_RDY，UART 起点不是传感器内部采样时钟本身；轮询相位等是待验证解释，不能直接当作结论。需补较长记录，检查短间隔分布、有效样本频率及是否漏读；没有 FIFO，仅凭序号连续不能证明传感器内部零漏样。

## 静止量值问题

用户在核查过程中明确表示采集时完全静止平放。12 组完整数据的平均三轴为：

```text
X = 549.50
Y = -289.17
Z = 21952.67
三轴合成模长的平均值 = 21961.82 原始计数
```

项目模块手册 `docs/hardware/mpu6050_module_manual.pdf` 第 7 页表格说明：AFS_SEL=0 时为 ±2g、16384 LSB/g。当前 `stm32/bsp/mpu6050.c` 的初始化意图为 `1C=00`，包含关闭加速度自检位、选择该量程；但本段稳态捕获没有实际 1C 配置回读。因此以下换算明确以该配置真实生效为条件：

```text
21961.82 / 16384 = 1.34044g
```

这与静止合成加速度应约为 1g 不符。单纯改变平放的朝向只改变各轴分量，不应把合成模长从 1g 变为 1.34g。本次 I2C 原始字节和两路 UART 字段一致，已排除本段可比数据在 STM32 打包或 FPGA 回传中被改成这些数值；尚不能区分实际配置、偏置、比例误差、模块个体等原因。不直接认定芯片损坏，也不把 Z 减去常数写进程序掩盖问题。

## 下一步验收

1. 保持 SensorSource，补一段覆盖复位后初始化的 2 s 立即采集。由用户在采样已经开始后复位 STM32，检查 75→68、6B 复位/唤醒、1A=02、19=03、1C=00、38=01 的实际写入及配置回读，尤其是 1C 的自检位和量程位。第一约 200 ms 初始化不要求匀速发包。
2. 分别记录 Z 朝上和 Z 朝下、完全静止的原始数据，标明姿态；必要时扩展为 X/Y/Z 正反六面。利用正反均值和半差区分零偏与比例问题，再决定是否需要校准或模块检查。没有新证据前不修改驱动或协议。
3. 补 1～2 s 或更长的稳态记录，检查周期分布、完整包对照和序号回绕。当前 50 ms 不代表长期稳定、异常恢复或严格 250 Hz 验收完成。

## 实际执行与修改边界

在项目根目录运行：

```powershell
& 'C:\Users\QQ165\.cache\codex-runtimes\codex-primary-runtime\dependencies\python\python.exe' -X utf8 report/evidence/analyze_sensor_capture_20261030.py
```

实际结果标记：`PASS_COMMUNICATION_CAPTURE_MEASUREMENT_PENDING`。脚本对全部可比包执行独立协议解码、XOR、序号、I2C ACK 模式、六字节内容及时间顺序检查，并校验采集归档。JSON 保留逐包结果、边界字节和文件哈希，便于复核。

本轮新增采集证据、分析脚本、JSON 与本记录，更新项目上下文、下一步任务、分析仪指南和 AI 日志。未修改 RTL、STM32 程序、XDC、Vivado 自动生成缓存或烧录设置；未重复行为仿真和软件构建。

同日后续已取得 Z 朝下静止记录。用户确认仅翻转、程序配置未改；Z 均值约 -11375.83，与本次正值约 +21952.67 联合初估中点约 +5288.42，支持较大 Z 零偏的解释，但尚不能确定根因或直接校准。后续证据和完整边界见 [Z 朝下及正反对照报告](sensor_zdown_validation_20261030.md)。本报告原有采集证据与结论不改写。
