FFsteve/zynq_vibration_monitor/report/sensor_zdown_validation_20261030.md

# Z 朝下静止采集及正反对照

日期：2026-10-30。用户说明本次 Z 朝下静止采集，并授权操作 ATK-LogicView 检查；核查过程中进一步确认两次之间仅翻转模块，程序配置未改。

## 结论

**本次 12 组完整数据的 I2C→STM32 UART→FPGA 回传对照通过，Z 翻转后符号正确改变；原始静止量值仍未达到验收要求。**

两次 Z 均值由 +21952.67 变为 -11375.83，正反不对称。以近似正反水平、配置不变为条件，Z 零偏初估约 +5288.42 计数，而每 g 的变化量初估约 16664.25 计数，较接近 ±2g 配置的标称 16384。结果更支持较大偏置的解释，不能据此断言偏置根因、认定芯片损坏或直接使用该值完成校准。

## 数据来源与原始证据

通过 computer-use 技能打开已运行的 ATK-LogicView，保留本次已有 50 ms 记录。状态栏为 20 MHz、1.5V、1 MSa/ch、DL16/USB2.0。没有重新采样、复位或烧录。

- [原始波形工程](evidence/sensor_zdown_20261030.atkdl)
- [D0 UART 协议 CSV](evidence/sensor_zdown_d0_20261030.csv)
- [D1 UART 协议 CSV](evidence/sensor_zdown_d1_20261030.csv)
- [I2C 协议 CSV](evidence/sensor_zdown_i2c_20261030.csv)
- [独立分析脚本](evidence/analyze_sensor_zdown_20261030.py)
- [逐包结果、边界记录与 SHA256](evidence/sensor_zdown_analysis_20261030.json)
- [上次正值静止记录](sensor_source_validation_20261030.md)

三路 CSV 从对应协议列表经界面导出，保留厂商 GB18030 原始字节；原始 atkdl 为新文件，不覆盖上次记录。采集归档 CRC 校验通过，含四路采样文件。没有检查实物接线或利用运行中的源码替代实际配置回读证据。

## 完整通信核对

两路 UART 各含 12 个完整包，SEQ 为 66～71（十六进制）连续，无完整包重复、跳号或 XOR 错误。全部 12 笔完整 3B 六字节读数与随后 D0 三轴字段一致，D1 对应整包与 D0 逐字节一致。

| SEQ | I2C 六字节／UART 三轴字段 | X | Y | Z | CHK |
|---|---|---|---|---|---|
| 66 | 0B 3A FC 64 D3 D0 | 2874 | -924 | -11312 | CC |
| 67 | 0B FA FC CC D3 BE | 3066 | -820 | -11330 | CB |
| 68 | 0A D4 FC 64 D3 82 | 2772 | -924 | -11390 | 7F |
| 69 | 0B 7E FC 52 D3 8A | 2942 | -942 | -11382 | EB |
| 6A | 0B A6 FC A6 D3 70 | 2982 | -858 | -11408 | 3E |
| 6B | 0B 24 FC 64 D3 86 | 2852 | -924 | -11386 | 89 |
| 6C | 0B E6 FC AE D3 74 | 3046 | -850 | -11404 | 74 |
| 6D | 0B 22 FC 62 D3 BE | 2850 | -926 | -11330 | B7 |
| 6E | 0B A8 FC 5E D3 A8 | 2984 | -930 | -11352 | 14 |
| 6F | 0C 04 FC 88 D3 A8 | 3076 | -888 | -11352 | 68 |
| 70 | 0B 24 FC 66 D3 34 | 2852 | -922 | -11468 | 22 |
| 71 | 0B 9C FC 6C D3 7C | 2972 | -916 | -11396 | D9 |

例如 SEQ=66：I2C 读取 `0B 3A FC 64 D3 D0`，D0/D1 都为 `A5 5A 66 0B 3A FC 64 D3 D0 CC`。这是大端有符号数据，Z 的 D3D0 应解码为 -11312。

完整 I2C 事务共 38 笔：26 笔 3A 状态读取、12 笔 3B 起六字节读取，地址与数据 ACK 正常，最后一个读字节 NACK 符合结束读事务的要求。本记录同样没有 WHO_AM_I、复位写入或配置回读，因此不关闭初始化验收项。

### 采集起点的停止位错误

D1 在 80.95 us 有一条 `Stop bit error`，位于首个完整包之前；其附近解码字节为 27、9F，没有完整 A5 5A 包头。第一个完整回包从约 3.345 ms 开始，之后 12 个完整包的起停位、数据位数与协议检查均通过。

该现象与采集窗口在上一包中途开始、软件解码未对齐相符，但没有更早的波形，不能证明其唯一原因。脚本在 JSON 中保留全部前缀字节和警告，将它们与后续完整包分别记录，不把整段记录描述为零错误，也不把这条边界警告计成已证明的 FPGA 内部故障。后续从帧前空闲开始的捕获可复核。

### 本段时序

11 个 D0 包起点间隔为 3.99300～4.00170 ms，平均 4.00010 ms；本段未见上次约 3 ms 的短间隔。对应 D1 起点较 D0 延后约 863.80～863.85 us，与现有接收器在末字节停止位中点确认后回传的设计相符。50 ms 结果不替代长期时序或传感器内部零漏样验收。

## 两姿态数值对照

| 数据集 | 完整样本数 | X 均值 | Y 均值 | Z 均值 |
|---|---|---|---|---|
| 上次静止、Z 为正 | 12 | 549.50 | -289.17 | +21952.67 |
| 本次 Z 朝下静止 | 12 | 2939.00 | -902.00 | -11375.83 |

本次平均合成模长按源码预期 ±2g 配置换算约 0.71926g，上次约 1.34044g。这说明翻转改变了符号，但正反原始值没有围绕零对称，不能把翻转响应正常解释成测量值已正常。

对于近似正反的两个静止姿态，使用一阶模型 `Z正=b+S`、`Z反=b-S`：

```text
b ≈ (21952.67 + (-11375.83)) / 2 = +5288.42 计数
S ≈ (21952.67 - (-11375.83)) / 2 = 16664.25 计数/g
```

模块手册 `docs/hardware/mpu6050_module_manual.pdf` 第7页给出 AFS_SEL=0、±2g、16384 LSB/g。估计的 S 比该标称值高约 1.71%，而估计 b 约为标称 0.323g，因而较大的加性偏置更值得优先检查，而不是单纯把问题解释成量程倍数不对。

这些是条件性的初估：实际 1C 配置尚未直接读回验证；每次只有 12 组，精确水平、两姿态反向程度和温漂没有测量。本次 X 也明显不为零，不能分清姿态偏差、横轴零偏或其他误差。不能据此对所有三轴写入固定校正，也不能把用这两组数据拟合后得到的正负对称当成独立校准验收。

## 下一步

1. 优先补初始化捕获：立即采集 2 s，开始后由用户复位 STM32，核对 WHO_AM_I、配置写入/回读，尤其 1C 的自检位与量程。当前不改 FPGA RTL 或通信协议。
2. 在配置确认后，采集较长的 X/Y/Z 正反六面静止记录，尽量找平且减小线缆拉扯，标明姿态；重复回到同一姿态检查可重复性。每面 1～2 s 可比当前 50 ms 提供更多数据。
3. 根据六面数据决定校准方案或进一步检查模块；本轮不写入上述临时偏置值，不修改 STM32 驱动或传感器寄存器。

## 实际执行与修改

```powershell
& 'C:\Users\QQ165\.cache\codex-runtimes\codex-primary-runtime\dependencies\python\python.exe' -X utf8 report/evidence/analyze_sensor_zdown_20261030.py
```

实际输出：`PASS_COMPLETE_CHAINS_BIAS_HYPOTHESIS_PENDING`，D0/D1 各12个完整包、12组三路内容匹配，完整I2C事务38笔。脚本复用前次独立 UART 核查函数，仅在内存中切换本次输入；此前脚本、CSV、波形和结果文件未修改。JSON 记录边界警告、每组内容、时序、正反估计及证据哈希。

本轮仅新增本次证据、分析脚本、JSON 和报告，更新项目状态、下一步任务、前次报告导航及 AI 日志；没有修改固件、RTL、XDC 或烧录设置，没有启动新采集、复位硬件或重复构建。
