FFsteve/zynq_vibration_monitor/report/stage4_design_validation.md

# 第四阶段设计与数值验证记录

日期：2026-10-30。状态：**设计和数值检查通过；RTL 实现尚待方案批准。**

后续更新：2026-10-31用户已批准实现，四个RTL模块和双仿真器验收已完成，见 [实现验证记录](stage4_validation.md)。下文保留2026-10-30数值设计阶段的历史边界，不将两轮结果混写。

用户同意第三阶段基本通信目标作为后续基础，允许将 MPU6050 零偏问题留待后续排查，并要求进入第四阶段。用户进一步确认暂按250Hz采样、保留5～30Hz、抑制50Hz及以上设计。实物初始化回读、量值和长期时序事项没有因此关闭。

## 本轮成果

- [具体设计](../docs/stage4_design.md)：三轴去直流、63抽头FIR、接口/位宽/状态机/时序、缺包与断流恢复、与既有通信的连接边界。
- [验收计划](../docs/stage4_test_plan.md)：四个拟建RTL模块的正常、错误和恢复自检，双仿真器及隔离综合要求。
- [数值参考](../host/stage4_reference.py)：自行生成系数、无界整数参考、独立NumPy卷积、浮点基线参考和正弦增益检查。
- [量化系数](../data/reference/stage4/fir_lp_63_q16.csv)、[18位系数存储文件](../data/reference/stage4/fir_lp_63_q16.mem)：63项，对称，和65536，16个小数位。
- [本轮数值结果快照](stage4_numeric_design.json)：完整18组用例统计、频响与边界，区别于未来RTL仿真结果。

没有创建新的 `.v`、Testbench、仿真运行脚本或Vivado工程；没有改动已有RTL、STM32、XDC或下载设置。后续文件职责和验收条件已具体列出，不以数值模型替代RTL实现。

## 实际执行

本机Python运行时已有NumPy 2.3.5；没有安装SciPy、绘图库或联网获取系数。在项目根目录运行：

```powershell
& 'C:\Users\QQ165\.cache\codex-runtimes\codex-primary-runtime\dependencies\python\python.exe' -X utf8 host/stage4_reference.py
```

本轮实际输出 `PASS_NUMERIC_DESIGN_ONLY`，18组、共41728个输入样本的数值检查通过，另有舍入、窄输出饱和和累加界限检查。结果目录 `build/stage4_reference/` 包含频响CSV、各用例逐样本CSV和JSON，精简摘要已保存到本记录所链接的快照。

系数存储文件SHA256：`b9b74fb39759cf352d2b388ea15650b0a1522d1f15dd6f4861f622d7b580fc35`。

首次文件证据检查发现Windows文本写入把LF转换为CRLF，实际存储文件哈希与内存中计算的哈希不一致；系数数值不受影响。已改为固定LF的字节写入，再完整执行数值检查和文件核查，最终以磁盘文件SHA256验证一致，不沿用第一次文件核查结果。

## 定量结果

| 项目 | 本轮计算结果 | 设计验收 |
|---|---|---|
| 级联5～30Hz增益 | -0.107272～+0.155827dB | -0.25～+0.25dB，通过 |
| 级联50～125Hz最差增益 | -58.950567dB | 不高于-55dB，通过 |
| 系数和 | 65536 | 精确低通单位直流增益，通过 |
| 系数绝对值和 | 117520 | 用于保守动态范围证明 |
| 累加绝对值界限 | 7701673200 | 41位累加器足够 |
| 输出绝对值保守界限 | 117518.21计数 | 默认signed18覆盖 |
| 本轮整数结果相对独立浮点参考的最大误差 | 0.932469计数 | 不超过2计数，通过 |
| FIR群延迟 | 31样本＝124ms | 信号特性，区别于预计3.86us计算延迟 |

频率扫描间隔0.005Hz，以本轮量化系数的传递函数评估，不是实物扫频。浮点对照使用同一量化系数但独立浮点基线和NumPy卷积，用于隔离固定点实现舍入误差；不是宣称相对未量化理想系数也只有2计数误差。理想与量化系数的L1差约0.000393758，极端输入下相应误差应另行计入。

### 整数模型正弦测量

每组4000点，输入为6000计数直流加10000计数正弦，稳态后取2000点作基频投影。结果是数值模型输出，不是RTL或传感器实测。

| 频率 | 整数模型增益 |
|---|---|
| 5Hz | -0.107305dB |
| 10Hz | +0.083259dB |
| 20Hz | +0.150368dB |
| 30Hz | +0.153377dB |
| 50Hz | -61.475657dB |
| 60Hz | -61.537855dB |
| 80Hz | -64.148132dB |
| 100Hz | -75.830287dB |

这些结果支持当前系数进入RTL实现。不能将大信号正弦测得的衰减推广到任意小信号：低于量化噪声的信号会受到整数舍入限制。

### 用例覆盖与未覆盖范围

已执行常量0、偏置21953、正负极值、冲激、正负阶跃、正负翻转、交替满幅、固定种子随机及八个频率正弦。对每组执行无界整数卷积与NumPy整数卷积逐样本比较，检查固定点相对浮点参考误差、输出及累加器界限；常量初始化结果为0，阶跃末端残留不超过1计数。

另外检查了正负半单位舍入、正负非半单位舍入、8位输出饱和变体，以及63项输入按系数符号对齐时达到的最坏累加界限。

尚未执行：时钟周期/FSM自检、busy/overrun、无效事件暂停、SEQ/断流重启、UART适配、ModelSim、XSim、资源综合或上板。它们必须由后续真实RTL和配套TB检查，不能由当前数组运算声称通过。

## 评审后实现顺序

1. 按设计合同实现单轴 `dc_remove` 和自检，核对Q16、极值、舍入及有效事件时序。
2. 实现单轴 `fir_lp_serial` 和自检，核对63抽头、环形地址、190拍延迟及期望向量。
3. 实现三轴 `vibration_filter`，核对193拍输出、过载、序号与断流恢复。
4. 实现 `filter_monitor_core` 集成自检，验证原始UART回传不变；运行双仿真器和隔离综合，按实际结果更新验证报告。

等待具体方案批准的依据为项目 `AGENTS.md` 的“先解释设计，包括输入输出、寄存器、状态机、周期时序和验收标准；编写较大规模的新 RTL 前，等待用户批准。”本轮已经完成可供批准的设计和数值检查，不要求用户重复批准已确认的频段，也不把第四阶段授权解释为传感器校准通过。
