FFsteve/zynq_vibration_monitor/report/stage4_validation.md

# 第四阶段：RTL实现与实际验证

日期：2026-10-31。结论：**第四阶段软件验收通过；实物滤波联调留到最终阶段。**

用户已批准按此前具体方案继续实现，并要求以后每阶段主要代码完成后由助手自行运行仿真、报告结论。本轮实际完成四个Verilog模块、对应自检及运行脚本，在ModelSim SE-64 2020.4与Vivado XSim 2020.2上执行；另对计算模块完成Vivado 2020.2隔离OOC综合、布局布线及内部时序检查。

设计合同见 [设计说明](../docs/stage4_design.md)，复现和GUI看波形见 [测试指南](../docs/stage4_test_guide.md)，机器可读摘要、源码SHA256见 [验证快照](stage4_validation.json)。原始设计数值记录继续保留在 `stage4_design_validation.md`，不把历史数值检查冒充后续RTL仿真。

## 实现内容与作用

| 文件 | 职责 |
|---|---|
| `rtl/dc_remove.v` | 每轴Q16基线估计，仅随有效样本更新，17位相减避免溢出，正负半单位远离零舍入 |
| `rtl/fir_lp_serial.v` | 63抽头环形历史、每轴一套串行乘加、41位累加、18位输出及饱和保护 |
| `rtl/vibration_filter.v` | 三轴快照/SEQ对齐，忙时丢弃计数，跳号/重复/断流重建历史 |
| `rtl/filter_monitor_core.v` | 复用既有通信核心，原始回传旁增加内部滤波结果接口 |
| `sim/tb/tb_*.v`中的四个新增测试 | 自检正常、错误、复位和恢复，逐样本对照独立期望 |
| `.gitattributes` | 固定系数存储文件的LF，避免Windows检出换行破坏SHA256 |
| `sim/tb/stage4_check.vh`、`stage4_negative_cases.v` | 统一完成/评分标记；缺失系数与非法阈值拒绝测试 |
| `host/stage4_vectors.py` | 从数值参考生成单轴、三轴和串口集成期望向量 |
| `host/check_stage4_captures.py` | 对实际RTL导出重新比对，并测量实际输出正弦增益 |
| `sim/run_stage4.ps1`及ModelSim/XSim脚本 | 双工具编译运行，系数哈希、结果、导出及负向检查 |
| `sim/check_stage4_negative.ps1`及专用脚本 | 预期拒绝必须有明确错误标记且不能走到意外接纳哨兵 |
| `scripts/check_stage4_synthesis.ps1/.tcl` | 独立OOC计算模块资源和内部时序，不操作板级工程 |

RTL、TB和脚本说明性注释使用中文；新PS1为UTF-8 BOM。没有修改原有UART RX/TX/解析器、通信核心、板级top、STM32、XDC或烧录设置。18位滤波结果保留为内部接口，没有静默截成16位原始字段，也没有改十字节协议。

当前下载在板上的旧top不会因新增源码自动出现滤波效果；D1仍应回传原始包。后续特征模块可连接新增内部接口。

## 实际命令

从项目根目录执行：

```powershell
powershell.exe -NoProfile -ExecutionPolicy Bypass -File .\sim\run_stage4.ps1 -Simulator both
```

该最终一键流程退出码0，包含四项自检、两套RTL导出检查以及每工具两项负向用例。日志在 `build/stage4_final_run.log`。随后补足集成测试的1～9字节各截断位置，针对该修改单独重跑：

```powershell
powershell.exe -NoProfile -ExecutionPolicy Bypass -File .\sim\run_stage4.ps1 -Simulator both -Test filter_monitor_core
```

最终针对性回归同时补足载荷含A55A/5AA5及有符号极值的检查，退出码0，日志在 `build/stage4_adapter_final.log`，下表采用最新结果。

```powershell
powershell.exe -NoProfile -ExecutionPolicy Bypass -File .\scripts\check_stage4_synthesis.ps1
```

最终OOC流程退出码0，结果为 `PASS stage4_ooc setup_slack=9.198 hold_slack=0.117`。所有输出位于隔离的 `build/`，没有生成比特流或连接Hardware Manager。

## 双仿真器自检结果

| 自检 | ModelSim checks | XSim checks | 最终错误数 |
|---|---:|---:|---:|
| dc_remove | 98192 | 98192 | 两者均0 |
| fir_lp_serial | 8222769 | 8222769 | 两者均0 |
| vibration_filter | 1604429 | 1604429 | 两者均0 |
| filter_monitor_core | 2490721 | 2490721 | 两者均0 |

checks是断言执行次数，包含每周期时序评分，不能解释为同等数量的独立测试场景。

- 单轴：18组41728个输入，覆盖常量、偏置、冲激、阶跃、正负极值/翻转、交替和随机，以及八个正弦频率；去直流和FIR位级结果与独立Python期望一致。
- 舍入/饱和：显式构造正负半计数基线；FIR首系数-13配合±32768产生±6.5计数点积，验证远离零舍入，并检查半单位前一计数；窄8位输出验证正负饱和及标志。
- 握手/历史：190拍FIR输出、191拍最短接纳；保持请求直到ready、忙时脉冲不写入历史；环形地址回绕、第63样本历史完整、无效历史不泄漏X。
- 三轴：4000组不同频率/偏置/幅度，输出同拍，193拍计算延迟；SEQ多次FF→00，跳号、重复、过载、断流阈值前/边界/后、长暂停和多个处理中状态复位均恢复。
- 集成：加速通道600个正常包及两个以上SEQ回绕，另加包头出现在载荷中、有符号极值、坏包头/校验、九个截断位置、停止位错误、后续合法恢复和全局复位；原始字节独立按串口位时间解码，恢复后完整输出符合期望。
- 默认参数：另一路采用50MHz/115200，254、255、0三个包，验证默认时序、原始回传和固定三轴去直流结果。

加速集成通道的BIT_CLKS=10，4000拍样本间隔、12000拍断流阈值；仿真20ns时钟下是时间压缩的逻辑测试，不冒充真实4ms采样或板测。默认参数通道单独覆盖实际434拍/位及约200000拍包间隔。

两套工具均正确拒绝缺失系数和 `GAP_TIMEOUT_CLKS=193`，四项负向结果均为PASS。对应日志中的ERROR是预期拒绝，正常模块评分仍必须errors=0。没有让错误用例沿用正常PASS文件。

## 实际RTL输出的数值与频率

两个引擎的 `rtl_fir.csv` 各41728行、`rtl_triple.csv` 各4000行，独立后处理逐样本比对通过。单轴FIR的输入来自Python去直流参考，完整三轴测试则输入原始signed16数据，实际执行RTL去直流和FIR，二者的覆盖范围在JSON中分别标注。

| 频率 | 两引擎单轴RTL输出增益 |
|---|---:|
| 5Hz | -0.107305dB |
| 10Hz | +0.083259dB |
| 20Hz | +0.150368dB |
| 30Hz | +0.153377dB |
| 50Hz | -61.475657dB |
| 60Hz | -61.537855dB |
| 80Hz | -64.148132dB |
| 100Hz | -75.830287dB |

实际三轴级联分别为X/10Hz +0.083259dB、Y/30Hz +0.153158dB、Z/60Hz -61.650551dB。数值参考的全频率扫描仍支持5～30Hz约-0.107～+0.156dB、50～125Hz最差约-58.951dB；表中RTL测量是离散正弦频点，不声称实际做了每个频点的RTL扫频或实物扫频。

计算延迟已按周期实测：FIR190拍，三轴193拍（50MHz下3.86us），最短三轴接纳间隔194拍。FIR信号群延迟31样本/124ms；整个去直流级联另有频率相关相位。

## 隔离实现资源与时序

对象是 `vibration_filter`，器件 `xc7z010clg400-1`，时钟20ns；不是原始板级top或完整监测系统资源。

| 项目 | 最终OOC实现结果 |
|---|---:|
| LUT | 2282 |
| FF | 3901 |
| DSP | 3 |
| BRAM | 0 |
| 推断锁存器 | 0 |
| 内部建立最差裕量 | +9.198ns |
| 内部保持最差裕量 | +0.117ns |
| 无时钟／未约束内部端点 | 0／0 |

保留的DRC为3条DPOP-1（DSP输出流水建议）和1条ZPS7-1 Warning；未压制或降低严重性，没有Critical Warning/Error。另有OOC端口缺少父级位置的Route 35-198、HD.CLK_SRC时钟父级位置提示；58个输入、165个输出端口未设外部延迟，需最终连接到父级后检查。**这些OOC内部数据不构成板级完整时序签核。**

内部建立/保持使用同一filter_clk下全部寄存器之间的路径检查，并保留 `internal_setup.rpt`、`internal_hold.rpt`；没有增加false_path或放宽20ns目标。没有父级接口和真实时钟缓冲位置，端口不被虚构成外部同步器件。

## 遇到的问题与纠正

1. 初次在受限执行环境启动ModelSim时报系统DLL重定位错误，XSim子编译器也未完成。改在获准的常规进程环境运行已安装工具，版本及仿真正常；没有修改Windows安全设置、工具安装或许可。
2. 首次XSim命令错误地沿用ModelSim的 `+incdir+` 语法，改为xvlog的 `-i`；修正后重新编译与运行，没有将编译失败计为PASS。
3. 实现阶段明确了断流计数的阈值边界：用可保存LIMIT的饱和计数，区分“本沿达到阈值”与“已经过期”，避免历史标志提前一拍失效，TB验证前/等于/后一拍。
4. 首次OOC给抽象端口设置0ns输入/输出延迟，出现输入端到首级寄存器保持违例，最差-0.502ns。该接口没有父级路径依据，与原定内部时序验收范围不同。已移除虚构端口预算，保留20ns计算时钟，严格检查内部寄存器建立/保持，明确把接口和父级时钟签核留给集成；没有修改RTL或用false_path掩盖内部路径。首次报告保存在 `build/stage4_synthesis/initial_zero_io_*`，不把首次失败改写成通过。

XSim还会提示测试台刻意未连接的诊断输出，负向参数顶层也有未连接输出提示；它们不表示实际模块输入悬空。最终结论依据退出码、自检计数、导出结果和具体时序范围，不能称为所有工具零警告。

## 阶段边界与下一步

本阶段已完成批准的软件实现和阶段内验证。无需现在重复上板测试；以后每阶段主要内容完成后自行执行对应仿真，再给出准确结论，必要时作隔离综合。除非用户另行要求，统一上板联调留到最终阶段。

下一步可进入窗口均方值、峰值和阈值特征的设计评审，再决定RTL实现。MPU6050初始化/校准、真实采样均匀性、长期记录和实物滤波效果仍单列保留；去直流不替代传感器校准。现有板级top与协议保持原始回传，不把本阶段软件通过描述为新设计已经下载到板上。
