FFsteve/zynq_vibration_monitor/report/stage5_design_validation.md

# 第五阶段设计及数值参考验证

日期：2026-10-31。状态：**本记录保留方案确认前的数值设计证据。用户随后确认实现，最新结果见[第五阶段实现验收](stage5_validation.md)。**

用户要求继续原定第五阶段。已核对项目上下文和第四阶段接口，形成 [具体设计](../docs/stage5_design.md) 和 [测试计划](../docs/stage5_test_plan.md)：128样本非重叠窗口，三轴均方值、绝对峰值和整数RMS；每轴2000/1500计数滞回、两个完整窗口确认。阈值是可参数化的演示初值，不能宣称真实故障门槛。

在方案确认前，仅完成数值设计：没有新建第五阶段 `.v`、TB或仿真运行脚本，没有修改第四阶段RTL、板级top、STM32、协议或XDC，没有重新采集/烧录。

## 实际执行

```powershell
& 'C:\Users\QQ165\.cache\codex-runtimes\codex-primary-runtime\dependencies\python\python.exe' -X utf8 host/stage5_reference.py
```

脚本使用Python标准库，实际退出码0，输出 `PASS_STAGE5_NUMERIC_DESIGN_ONLY`。结果位于 `build/stage5_reference/`，包括开方输入/期望文本和JSON；摘要保存在 [数值快照](stage5_numeric_design.json)。

| 实际检查 | 结果 |
|---|---|
| 逐二位开方与独立math.isqrt对照 | 10033个36位值全部一致，根与余数正确 |
| 完整窗口 | 9组，每组128个三轴样本，包含首末项冲激、正负极值和随机 |
| 最负输入 | 峰值/RMS正确得到131072，不回绕成负值 |
| 最负输入的128项能量 | 每轴2199023255552，即2⁴¹，默认43位累加覆盖 |
| 首/末冲激 | 均方与峰值相同，末样本没有被遗漏 |
| 窗长参数 | 1、2、4、128、1024，各两个完整窗口 |
| 样本域恢复 | SEQ回绕正常，跳号/重复重建，显式clear废弃部分窗口 |
| 报警 | 等于阈值、死区中断连续计数、两窗置位/解除、三轴独立和最大阈值 |
| 非法参数/数值 | 10项均被参考拒绝 |

根算法对照包括零、小整数、平方附近、2³⁵及2³⁶边界和固定种子10000个随机输入。参考输出还检验 `root²<=n<(root+1)²` 和余数定义。128个最大负输入平方得到MS=2³⁴、RMS=131072，说明阈值平方和能量不能用32位integer保存。

名义窗口更新间隔512ms，首项至末项实际相隔508ms；两窗确认需两个完整特征事件，不能用PL时钟或零填充替代缺失样本。

## 验证边界

本轮检查只在样本域和数值域运行，未验证18拍开方、22拍窗口末项流水、ready/overrun、并发clear、报警对齐、UART接入、ModelSim/XSim或资源时序。这些在本数值记录形成时是待实现的RTL验收项，不能因数值参考通过而声称第五阶段完成。

本方案将质量失效与“报警为0”分开表示；三轴MS/RMS/峰值输出是内部接口，原始UART回传不改变。5～30Hz滤波和此前传感器原始偏差问题都沿用第四阶段边界。

## 本轮文件

- 新增 `host/stage5_reference.py`、设计、测试计划、本记录和数值快照。
- 更新README入口、项目上下文、后续任务与AI日志。
- 后续四个主要RTL为 `isqrt_u36`、`window_features`、`threshold_alarm`、`feature_monitor_core`；现已在用户批准后实现，详见最新验收报告。

当时等待方案确认的依据为 `AGENTS.md`：“先解释设计，包括输入输出、寄存器、状态机、周期时序和验收标准；编写较大规模的新 RTL 前，等待用户批准。”接口、寄存器、状态机、周期及验收已经在设计中具体列出；实现后的常规仿真按此前授权自动执行。
