FFsteve/zynq_vibration_monitor/report/stm32_fixed_uart_validation.md

# STM32 固定数据 UART：用户截图核查记录

日期：2026-10-29。用户提供逻辑分析仪通道 P0 的四张 UART 截图，询问程序是否正常以及下一步测试。以下记录来源于用户实物采集截图，区别于此前 Testbench 仿真；没有远程操作硬件或重新采集。

## 四包内容与核查结果

截图中的完整字节人工转录如下，未从图片重新执行波形级 UART 解码：

| 截图 | 十字节数据 | SEQ（十六进制／十进制） | 解码三轴 | XOR |
|---|---|---|---|---|
| 1 | A5 5A 9A 00 01 FF FF 80 00 1B | 9A / 154 | 1，-1，-32768 | 正确，1B |
| 2 | A5 5A 9B 00 01 FF FF 80 00 1A | 9B / 155 | 1，-1，-32768 | 正确，1A |
| 3 | A5 5A 9C 00 01 FF FF 80 00 1D | 9C / 156 | 1，-1，-32768 | 正确，1D |
| 4 | A5 5A 9D 00 01 FF FF 80 00 1C | 9D / 157 | 1，-1，-32768 | 正确，1C |

固定载荷各字节 XOR 为 81，所以 CHK=SEQ XOR 81。四组结果分别为 9A XOR 81=1B、9B XOR 81=1A、9C XOR 81=1D、9D XOR 81=1C，与截图一致。

使用项目独立 PC `host/protocol.py` 的 decode 对上述人工转录字节进行检查，四组均返回预期 Sample，未发生校验异常。这个检查验证截图可见字节符合协议，不是对分析仪原始采样文件的重放。

与当前 `stm32/app/acquisition.c` 的 FixedSource 分支及 `sample_packet.c` 对照，包头、十字节长度、大端补码、固定三轴、序号和 XOR 均符合预期。因此可以记录为：**STM32 固定样本 UART 发包的四包截图内容初步验证通过。**

## 原始截图保留

原图按原始字节复制保存，没有裁剪、标注或修改：

- [截图 1](evidence/stm32_fixed_uart_20261029_01.png)
- [截图 2](evidence/stm32_fixed_uart_20261029_02.png)
- [截图 3](evidence/stm32_fixed_uart_20261029_03.png)
- [截图 4](evidence/stm32_fixed_uart_20261029_04.png)

```text
01 SHA256 b8ccc8856dd4e6fea388c6f49dca7119f8f585211a734c5560c00203fa3c2778
02 SHA256 002d138d928e365c6ce018236941654705759599d4adefec0b80c3faec3f1214
03 SHA256 161ca35ea9b74979176b7a5876f8e96f3bd6a20153f0e5bafc5824abcda410e4
04 SHA256 4c2837676699ee53203baa5bddb97941dab1265b0697236ce6acf5ac0ea62be5
```

## 首批四张截图的验证边界

本节描述首批截图本身的边界；后续补充的时间测量见文末。

- 裁剪图没有时间刻度或测量游标，不能独立确认 8.68 us 位时间、约 0.87 ms 包时长和 4 ms 包周期。
- 这四个所示序号连续，不等于证明长时间、所有包均无丢失或重复。
- 没有 FPGA 回传通道与输入的同次捕获，不能判断 FPGA 已接收、校验、入队并成功回传。
- 没有 I2C 截图，不能判断 MPU6050 身份、配置、采集和真实采样时序。
- 未提供实际测点照片、原始 atkdl/采样文件、最终固件下载日志或当前 FPGA 配置证据，不推断这些事项已经确认。

## 下一步测试顺序

1. **补齐发送时序**：在同一段 100～200 ms 捕获中，保留时间轴。测明确的单个位单位时间（约 8.68 us）、完整十字节包（约 0.87 ms），并测相邻包第一个 A5 的起始位下降沿间隔（目标约 4 ms）。不要把相同数据位合并的平台当成一个位宽。
2. **固定数据 FPGA 回传**：保持 STM32 FixedSource；确认 FPGA 下载运行当前 top，保留正确的直连接线，UART2 与 COM2/RS485 的冲突跳帽断开。用同次双通道捕获比较 FPGA 输入与输出，各自配置 UART 115200/8N1。默认 ACK_ONLY=0 应回完整十字节包，同一个 SEQ、三轴与 CHK 一致；不能因为收不到 06 而判错。例外为另行生成并实际运行 ACK_ONLY=1 的设计。
3. **较长固定数据记录**：记录 1～2 秒并检查完整包数量、序号模 256 回绕、重复、跳号及校验；首尾截断包单独处理。没有原始完整记录不能宣称长时间零丢包。
4. **独立传感器测试**：再换 SensorSource，按逻辑分析仪指南抓取初始化的 WHO_AM_I=68、配置回读、3A 状态及 3B 起六字节。使用四路同次捕获，把 I2C 六字节与 UART 三轴字段对应，再比较 FPGA 回传。

若 FPGA 当前还没有可运行的第三阶段设计，第 2 步暂不作通过/失败判定，可先做第 1、3 步与独立 SensorSource 的 I2C 检查。既有实现报告的 ZPS7-1 配置警告不因本次 STM32 截图而关闭，FPGA 下载准备按单独流程处理。

本轮只新增截图证据和分析记录、更新项目状态与 AI 日志，没有修改固件、RTL、XDC 或烧录配置，也没有重复运行行为仿真或构建。

## 后续时间测量与 D1 波形（2026-10-29）

用户补充四张截图，并说明 D1 接 FPGA 的 M15(TX)，当前仍为 FixedSource，未测 SensorSource。测点连接来自用户描述，没有据此声称已检查实物接线。以下数值读取截图并独立计算，没有操作仪器或重新采集。

| 图 | 用户截图读数 | 分析与边界 |
|---|---|---|
| 1 | 单个位宽 8.7 us；完整高低交替周期 17.4 us；工具显示 57.47 kHz | 115200 的理想位时间为 8.68056 us，读数基本符合；交替周期包含两个位，57.47 kHz 不是 UART 波特率 |
| 2 | 长高电平宽度 3.13365 ms；工具周期 3.1423 ms、318.24 Hz | 是局部边沿/电平测量，不是两个包起点的间隔；两个时间相差 8.65 us，约一个位时间 |
| 3、4 | T1=101.11565 ms，T2=105.1087 ms | 相减为 3.99305 ms，对应约 250.435 包/s；相对 4 ms 短 6.95 us，偏差约 -0.174% |

十字节 8N1 总共 100 位，理想发送时长为 0.868056 ms；4 ms 包周期下，从完整停止位结束计算的空闲时间约 3.131944 ms。但逻辑分析仪的高电平脉宽从上升沿开始，可能包含最后一个停止位，不能直接把它等同于完整包结束后的空闲时间。如果最后校验字节最高位为 0，且测量的是它进入停止位的上升沿到下一包起始下降沿，则其前方包内时长约为 99 位；3.13365 ms 加 99 位的理想时间等于 3.993025 ms，与标签差值吻合。这是基于边沿位置的条件解释，当前截图没有清晰字节解码，不能当作本次校验字节已经核对。

单组 3.99305 ms 支持“接近目标 4 ms”，不证明精确周期或长期稳定性。6.95 us 的偏差不能仅用 20 MS/s 下约 50 ns 的采样间隔解释；仍需确认两个游标都落在包头 A5 起始位的下降沿，测多个周期及短期变化，才决定是否需要进一步检查时钟或调度。不能由截图直接归因为某个时钟故障，也不据此修改程序。

图 3 可见第二路较输入延后出现串行波形，与整包接收后再回传的设计相符。但 D1 尚无可清晰读取的完整十字节解码，现阶段仅记录回传方向有活动，不能宣布 FPGA 闭环通过。接收器在最后停止位中点确认字节，因此回传开始可能稍早于输入解码器绘出的完整停止位结束边界，这本身不构成错误。

下一步保持 FixedSource：在同一次捕获中给 D0、D1 分别配置 UART 解码（TX=D0 / TX=D1，RX 不选，115200、8N1、低位先发、hex、不反相），对照每路完整包的 SEQ、三轴和 CHK。默认 ACK_ONLY=0 应回传相同十字节内容。再以相同 A5 起始下降沿测连续 20 个间隔，总长目标约 80 ms，除以 20 求平均，同时观察各相邻间隔和序号；首尾截断包单独处理。以上检查后再进行 SensorSource 的 I2C 和三轴测试。

后续四张原图按字节复制保留：

- [时间截图 1](evidence/stm32_fixed_uart_timing_20261029_01.png)
- [时间截图 2](evidence/stm32_fixed_uart_timing_20261029_02.png)
- [时间截图 3](evidence/stm32_fixed_uart_timing_20261029_03.png)
- [时间截图 4](evidence/stm32_fixed_uart_timing_20261029_04.png)

本次仅更新本记录、项目上下文与 AI 日志，保存用户截图。未修改程序、约束或下载设置；未重新执行仿真、构建或硬件测试。

## 固定数据双通道回传核查（2026-10-29）

用户继续提供两张 D0/D1 完整解码截图，明确仍使用 FixedSource，并报告其他包也相同。结合此前用户提供的测点描述，本节将 D0 作为 STM32 发往 FPGA 的输入、D1 作为 FPGA 回传；没有远程检查探头实际连接。下表仅列本次图片中可直接核对的两组包，不将“其他也相同”的用户观察扩展为自动统计结论。

| 图 | D0 完整十字节 | D1 完整十字节 | 独立核查 |
|---|---|---|---|
| 1 | A5 5A CB 00 01 FF FF 80 00 4A | A5 5A CB 00 01 FF FF 80 00 4A | 逐字节相同；SEQ=203；三轴 1/-1/-32768；CB XOR 81=4A |
| 2 | A5 5A CC 00 01 FF FF 80 00 4D | A5 5A CC 00 01 FF FF 80 00 4D | 逐字节相同；SEQ=204；三轴 1/-1/-32768；CC XOR 81=4D |

使用 Python 将图片字节人工转录成 bytes，逐组比较 D0/D1，并调用 `host.protocol.decode` 检查四个包，均得到预期 Sample，四次 XOR 检查均通过，CB→CC 序号连续。这是截图可见字节的独立协议检查，没有重新对原始电平采样文件解码。执行方式为 `python -X utf8 -`，使用本机已配置 Python 路径；没有运行串口采集、RTL 仿真或重新烧录。

**验收结论：按用户所述测点，所示两组 FixedSource 的 STM32→FPGA→UART 回传基本功能板测通过。** 位宽和约 4 ms 周期沿用前次截图的初步测量。回传发生在输入整包附近结束之后，符合当前整包解析后重组发送的外部行为；不能仅凭两个合法包证明内部所有错误处理、队列路径或长期无丢包。没有 SensorSource/I2C 证据，不把此结果写成 MPU6050 或整个第三阶段实物验收通过。

### 原始证据

- [回传截图 1](evidence/fpga_fixed_return_20261029_01.png)，SHA256：851d40bfbc1a998f568c9ddf0f2524ee7143b66b6612981e90927f447e26a422。
- [回传截图 2](evidence/fpga_fixed_return_20261029_02.png)，SHA256：a5eab762e94297891e285dd4fa4e678bd385201052e09f52768794445a53be02。

原图按字节复制并检查一致性，没有裁剪或标注。

### 后续测试

1. 保存当前捕获；补一段 1～2 s 的 FixedSource 双路记录，检查对应完整包一致、序号连续且 FF→00 回绕正确。按约 250 包/s 估算数量，首尾截断包不计入完整包对比；跨 20 个间隔复核包周期。仅人工抽查时，不声称全记录自动统计零丢包。
2. 接线符合既有指南后，将 Keil 目标切换为 SensorSource，全量编译并下载 STM32；当前 FPGA 整包回传设计保持运行，无需为更换数据来源修改 RTL 或重新编写协议。
3. 按逻辑分析仪指南立即采集初始化：确认 WHO_AM_I 寄存器 75 读回 68、配置回读正确，再检查 3A 状态和从 3B 起的六字节采集。该六字节应与对应 D0 的 XH～ZL 一致，D1 对应包再与 D0 一致；缓慢转动传感器时观察三轴随姿态变化，不把数值变化本身当成全部验收。

本轮更新此记录、`docs/project_context.md`、`report/ai_devlog.md` 并保存两张截图；程序、RTL、XDC 和烧录设置均未修改。
