FFsteve/zynq_vibration_monitor/report/competition_rehearsal_validation_20261101.md

# 比赛演练三阶段检查结果

日期：2026-11-01。用户按精简比赛演练要求保存三张截图，位置为 `report/evidence/fixed_filter_ila_20261101/filter_test_final/`。

## 结论

本次静止、运动报警、放稳恢复三种状态均正确，比赛演练的功能展示检查通过。结合前期初始化、校准、通信、滤波和窗口精确对照证据，可以结束本轮默认功能测试，进入比赛材料整理及演示文件归档。不再要求额外报警边沿或原始数据采集。

本轮实际逐张打开PNG人工审阅，并以Python将十六进制数换算为十进制，执行整数开方、峰值界限及计数关系核查。数值为截图人工转录，不冒称自动读取了本次未提供的ILA CSV或连续UART记录。截图没有覆盖整个上电操作过程，不将它们单独当作冷启动全过程证据，也不因此要求重采。

## 三种状态

截图光标均位于触发点右侧，01/02为Sample809，03为Sample783，左侧Value为新窗口数值。

| 状态 | X/Y/Z均方值MS | X/Y/Z RMS | X/Y/Z绝对峰值 | alarm_axes | quality_valid / alarm_valid |
|---|---|---|---|---|---|
| 01_static.png | 560 / 565 / 884 | 23 / 23 / 29 | 60 / 65 / 83 | 000 | 1 / 1 |
| 02_alarm.png | 11373847 / 684880 / 1644015 | 3372 / 827 / 1282 | 5314 / 1802 / 2696 | 001，X报警 | 1 / 1 |
| 03_recovery.png | 314 / 332 / 476 | 17 / 18 / 21 | 39 / 44 / 59 | 000 | 1 / 1 |

三轴RMS均精确满足 `floor(sqrt(MS))`，峰值平方不小于均方值。静止和放稳恢复均为较低RMS，运动时X轴RMS达到演示置位门限以上；本轮实际报警轴是X，不沿用前轮Z报警的描述。

02图红色触发标记附近可直接看到alarm_axes从0变1。前窗X轴MS=0x52D433、RMS=0x919=2329，后窗MS=0xAD8D17、RMS=0xD2C=3372，两窗MS均达到2000平方，报警在后窗置位，符合连续两窗规则。

03图中报警位已经恢复0，quality_valid与alarm_valid仍为1，支持有效测量状态下的正常恢复。本图捕获时解除已经完成，不包含解除边沿或紧邻的两个解除窗口；按照本次已约定的比赛演练范围，该状态证据足够，不追加边沿要求。

光标处feature_valid=0正常：它表示截图当前选中的是窗口发布后保持阶段，不能据此判定触发失败。前期filter_test_4原始CSV已验证单拍发布与保持，本轮不重复该项。

## 连续运行的辅助证据

| 状态 | 窗口ID | 接收计数 | 完成计数 | 丢弃计数 | 重建 / 作废累计计数 |
|---|---:|---:|---:|---:|---|
| 静止 | 4338 | 555865 | 555864 | 0 | 3 / 3 |
| 报警 | 4549 | 582873 | 582872 | 0 | 3 / 3 |
| 恢复 | 4733 | 606425 | 606424 | 0 | 3 / 3 |

静止到报警窗口增加211，接收计数增加27008，恰为211×128；报警到恢复窗口增加184，接收计数增加23552，恰为184×128。三张图计数持续推进，重建/作废累计量保持3、丢弃始终0，与持续运行后恢复的解释相符，不呈现复位后计数清零的迹象。

每张图接收领先发送完成计数1包，与触发附近的正常流水相符，不当作丢包证明。累计3次历史重建/作废原因并未由三张截图追溯，本轮不追加无关排查。非连续截图不用于声称中间每个PL周期都已观察。

## 实际检查及文件指纹

使用本机运行时Python的 `-X utf8 -c` 执行人工转录数值的检查，实际返回 `PASS final_demo_manual_transcription_arithmetic_checks`。核对内容为9个MS/RMS开方关系、9个峰值界限、3个接收/完成差值、2个窗口与样本增量关系，以及X轴两高窗口门限。

| 文件 | SHA256 |
|---|---|
| 01_static.png | 89e4bbfeb5dab8f663ae24d33dd36b11a2c59c6362604dbf70a69ca667afcf63 |
| 02_alarm.png | 3e49e8ec8b9af052ba5b8293a58bb289a07f3c868bcce96610e4549642556d94 |
| 03_recovery.png | fe8f234b6b8e519ecbe21019745b731b1bb089419fe9a7444d95236dee63a210 |

仅新增检查报告及项目状态说明，没有修改原始截图、功能代码、RTL、约束、Vivado缓存或下载设置；本轮未执行新硬件操作、仿真或构建。

## 下一步

整理比赛报告/答辩材料，复用已有精确数值、FIR量化、资源和时序证据；将当前配对debug bit/ltx与新校准STM32程序明确归档，并附最短演示步骤。现有约250.5Hz采样、约3ms短间隔及标准物理频响未测等限制按此前范围说明。除非演示出现新问题或比赛规则明确要求，不再默认追加功能测试。
