FFsteve/zynq_vibration_monitor/report/filter_test_3_validation_20261101.md

# 第三次真实滤波与ILA窗口核查

日期：2026-11-01。原始目录：`report/evidence/fixed_filter_ila_20261101/filter_test_3/`。

## 结论

本份记录的B07同次输入/滤波回传检查通过：4915帧D0均与I2C原始值按新校准公式计算的结果相同；4914个完整D1包从SEQ=0首包开始逐帧精确匹配定点参考，三轴最大误差均为0，包括历史预热过程。没有重建输入，也没有丢弃前1024样本。末个D1包位于20秒右边界，仅采到前六个完整字节和后续部分位，已单列，不计为中途丢包。

本次实际捕获到初始化及首包，补齐上次记录缺少的滤波开始阶段。用户所述操作为先ILA、再复位一次STM32、随后采集；记录时间以导出文件为准：0.178秒起存在初始化事务，0.383823秒出现SEQ=0首包。没有观测到FPGA全局复位；首包前D0无串口字节持续超过12ms，按已核对的RTL断流规则，首次恢复输入时重建基线及FIR历史。因此本次可用从首包建基线的参考，不再按未知历史预热后才对照。这不等于三轮整机冷启动通过。

ILA截图为复位之前的独立证据：相邻窗口ID、128样本SEQ范围和MS/RMS算术关系均合理，质量与报警状态有效，报警位为0；没有原始ILA波形/CSV，未完成与本次UART输入逐窗配对、完整报警和恢复验收。

## 原始文件与实际设置

目录包含 `filter_test_3.atkdl`、I2C CSV、D0/D1 CSV及 `ila_3.png`。归档CRC通过，实际20秒、20MS/s、Buffer、RLE启用、1.5V门限。5个原始文件的分析前后SHA256一致；指纹保存在派生JSON。PNG已实际打开人工审阅，数值人工转录，不冒称来自原始ILA CSV。

## 初始化、校准与通信

| 记录 | 实际结果 |
|---|---|
| MPU6050身份 | 0.178470～0.178863秒，寄存器75读取68 |
| 初始化写入 | 6B=80复位，随后6B=01、1A=02、19=03、1C=00、38=01 |
| 配置实际回读 | 0.379613～0.381599秒，6B/1A/19/1C/38依次为01/02/03/00/01 |
| I2C | 14715笔完整事务，ACK及事务结构检查无异常；3A读取9788次，3B六字节读取4915次 |
| D0 | 4915完整包，从SEQ=00连续至32，共19次回绕；无警告、起止位问题、XOR错误、内部缺口或丢弃字节 |
| D1 | 4914完整包，从SEQ=00连续至31；同样无内部通信错误；末包SEQ=32被记录右边界截断 |
| 校准闭环 | 4915笔I2C六字节按sixface_r1_20261101_validated的Q16零偏/比例、舍入、饱和计算，与4915帧实测D0完全一致 |

最后完整D0起点19.998559秒，D1对应包约在19.999427秒开始，无法在20秒边界内发完。实际已捕获前缀 `A5 5A 32 FF 8F 00` 与参考末包一致；预计末包三轴为−113/+34/+96，但未完整采到的字段不写成实测通过。

D0包起点到同SEQ D1包起点平均867.737µs，范围867～868µs。它包括输入包的串行接收时间，不能当作FIR计算耗时。I2C读取结束至校准D0包起点的延迟统计保存在JSON。

## 从首包开始的定点滤波对照

使用当前63抽头Q16系数，SHA256与rc1源码清单一致。参考按现有RTL规定执行：首样本建Q16基线且去直流输出0，后续误差算术右移5位更新基线；去直流舍入、FIR点积、舍入及signed18饱和，最后算术右移2位打包为signed16。新分析结果另与既有 `host/stage4_reference.py` 及NumPy独立卷积全部一致。

4914个完整回传包从第0帧起三轴全部匹配，最大线缆整数误差 `[0,0,0]`，预热剔除数为0、输入重建数为0。这比filter_test_2仅稳态分段对照的证据完整，B07按本份记录通过。

精确匹配对象是实际UART的signed16字段。D1乘4用于恢复尺度，丢失的两位不能从串口恢复，不将本次结果写成内部signed18逐位直接观测。受控频响另属B09，不由手动运动替代。

## 静止至缓慢移动的响应

前段三轴均值近似Z朝上。0～2秒D0均值约−139.16/−591.47/16452.40计数，即−0.00849/−0.03610/+1.00417g；输出去除了重力和静态分量。早期仍存在短时波动，不将“先静止”解释成每个样本应为常数，也不据此撤销此前静止瞬态待定位事项。

以下为各时间段D1乘4后的三轴均方根，单位为校准计数。它们是离线按整段数据计算的量，不是实测内部128点RMS，也不表示这些时间点就是操作者开始运动的精确时刻。

| 时间段（秒） | X | Y | Z |
|---|---:|---:|---:|
| 0～2 | 43.3 | 37.9 | 65.7 |
| 2～4 | 90.1 | 88.0 | 124.9 |
| 4～6 | 183.3 | 99.6 | 99.4 |
| 6～8 | 489.2 | 284.4 | 434.0 |
| 8～10 | 751.4 | 184.1 | 331.8 |
| 10～12 | 543.6 | 310.9 | 411.3 |
| 12～14 | 405.4 | 233.9 | 262.9 |
| 14～16 | 849.0 | 225.9 | 440.4 |
| 16～18 | 723.6 | 279.3 | 442.7 |
| 18～20 | 748.1 | 240.5 | 439.0 |

约6秒后的动态成分明显增大，主要体现在X轴，符合缓慢移动时姿态和加速度变化的表现。慢动作中的低频变化会被基线跟踪削弱，不能要求滤波输出与带重力D0等幅。运动频率和幅值未受控，因此不作标准频响结论。

在已验证回传的参考滤波序列上，从第63个样本开始按128点非重叠窗口，可预测37个完整窗口，最大RMS三轴为1099/381/533，均低于报警置位门限2000。这意味着本次缓慢运动预计不足以触发默认“两窗均达到2000”的条件；没有报警不等于报警模块故障。该结果属于模型预测，没有本时段ILA数据证明实际报警位的完整时序。

## 复位之前的ILA截图

截图十六进制数已换算为十进制。这里的前/后窗是红色触发标记两侧，不能冒充本次UART记录的静止/运动两个指定时段。

| 信号 | 前窗 | 后窗 |
|---|---:|---:|
| window_id | 2220（8AC） | 2221（8AD） |
| seq_start / seq_end | 3E / BD | BE / 3D |
| X均方值 / RMS / 绝对峰值 | 573 / 23 / 54 | 1253 / 35 / 169 |
| Y均方值 / RMS / 绝对峰值 | 514 / 22 / 62 | 6778 / 82 / 344 |
| Z均方值 / RMS / 绝对峰值 | 914 / 30 / 75 | 14029 / 118 / 550 |

两窗SEQ模256跨度均为127，即包含128个样本；后窗紧接前窗，ID递增1。三轴RMS均严格等于 `floor(sqrt(MS))`，峰值平方均不小于均方值。后窗数值增大且远低于报警置位门限，截图中 `quality_valid=1`、`alarm_valid=1`、`alarm_axes=000` 与此不冲突。

`dropped_count=0`，`filter_restart_count=6`、`aborted_windows=6` 在截图范围内没有增加。它们是此前运行累计量，不是本次复位后记录新增6次错误；无法由单张图追溯6次的具体原因。rx_frame_count从285348变为285349，completed_count保持285348，处于接收与发送流水过程中，不能将这一瞬间相差1解释为丢包。

左侧feature_valid=0仍是起点光标数值，图中间有触发事件。没有原始ILA数据，未自动验证单拍宽度、跨窗口时间间隔或窗口能量与当时输入样本逐点一致；约20.48µs的短截图也不能证明512ms更新周期。B08得到真实非零窗口快照证据，完整报警/恢复仍未验证。

## 时序问题与验收更新

D0平均包间隔3.991603ms、最小2.994ms、最大4.019ms，实际约250.526包/秒。41次约3ms短间隔中3次位于启动最初几包，其余38次在后段周期性出现。无SEQ缺口不等于严格均匀采样；此前采样时序问题仍未解决。

- B07：本份记录通过，包括STM32重启后首包及滤波预热回传，右边界半包单列。
- B08：真实非零窗口数值/SEQ/有效状态截图证据增加；原始ILA数据及受控置位/解除过程仍缺。
- B10：已取得一次STM32重启后初始化及滤波恢复输出证据；没有覆盖失效瞬间和整个恢复过程的同步ILA，也没有三轮整机冷启动，维持未验证。
- B11：新公式实际输出检查增加至本次4915帧；不再重复六面校准。实际下载文件身份、静止瞬态和周期问题仍待闭环。

下一步保留当前参数与RTL，补原始ILA数据：在持续运行中先保存静止有效窗口，再对移动时有效窗口触发，保存数据而非仅PNG。如要验收报警，须使用获准的受控数字激励验证连续两窗置位/解除，不以慢摇时alarm_axes=0判失败，也不直接降低现有门限来凑通过。随后补同步中断恢复观察与三轮冷启动。若已有设备不支持受控数字发送，则B09如实保留未验证，先完成已有设备能执行的窗口和恢复观察。

## 实际执行与文件

```powershell
& 'C:\Users\QQ165\.cache\codex-runtimes\codex-primary-runtime\dependencies\python\python.exe' -X utf8 report/evidence/analyze_filter_test_3_20261101.py
```

实际退出0，日志 `build/filter_test_3_analysis_20261101.log` 末行 `PASS filter_test_3_analysis originals_unchanged`。初次临时预览命令误用不存在的partial字段而中止，改为partial_packets后成功；未影响原始数据或最终结论。正式分析包含旧参考/独立卷积、初始化、逐包校准、滤波、末包边界、截图算术和原文件指纹断言。

派生文件为 `report/evidence/filter_test_3_20261101_analysis/analysis.json` 与 `comparison.csv`。JSON的 `predicted_windows_not_measured_ila` 明确标注预测窗口；CSV将最后不完整回包的实测字段留空。未改固件、RTL、约束、原始数据、Vivado缓存或下载设置；本轮未重新仿真、构建或执行硬件操作，分析对象为用户实际保存的记录。
