FFsteve/zynq_vibration_monitor/report/filter_test_4_validation_20261101.md

# 静止与运动ILA窗口精确对照

日期：2026-11-01。输入为 `report/evidence/fixed_filter_ila_20261101/filter_test_4/static/` 与 `motion/`。

## 结论

本轮完成B08中的窗口数值核查：静止新发布的一窗、运动前后两窗的三轴均方值MS、整数RMS和绝对峰值，均与同次输入驱动的定点参考精确一致，首末SEQ也一致。两份原始ILA各1024点，feature_valid均只在第512点为1，明确观察到单个PL周期的有效脉冲；相应窗口字段在该点更新并保持。

运动中直接观察到Z轴报警位100。参考给出两个连续高窗口，ILA中已置位状态与参考一致；紧接的第一个低窗口中报警继续保持，也符合连续两窗解除规则。当前ILA缓冲没有覆盖0→1置位边沿或1→0解除边沿，完整报警时序仍未验收，不把模型预测的解除写成实测解除。

静止两路各4752个完整包无内部错误。运动D0有5帧缺测和一次Stop bit error/Break，D1全部4834帧连续、I2C也完整，因此缺测段用I2C加已验证校准公式重建并标注。该段输入重建不冒充实测D0；另外单独以缺测后纯实测连续段核查3145帧回传，全部精确匹配。

## 操作说明与证据身份

用户确认static未重新下载FPGA，motion重新下载过FPGA，两份ILA均在对应DL16的20秒记录期间触发。未将全局计数默认从本次采集起点清零。static发布窗口ID5620，motion发布窗口ID54；通过所有窗口特征的唯一精确匹配定位，而非把累计ID当成本次局部窗口下标。数值可对应，不要求用户为ID非零重新采集。

每个目录均包含原始atkdl、三份协议CSV、原始ila.ila、ILA CSV和PNG。14个原文件前后SHA256一致，四个归档的ZIP CRC通过；两份ila.csv分别与各自ila.ila内的waveform.csv字节完全相同。两张PNG已实际打开人工审阅，关键数值以原始CSV解析为准。实际DL16参数均为20秒、20MS/s、Buffer、RLE、1.5V门限。

## 初始化、校准与滤波

| 项目 | static | motion |
|---|---:|---:|
| 第一完整D0起点 | 1.033871秒，SEQ=0 | 0.7072498秒，SEQ=0 |
| I2C完整六字节读取 | 4752 | 4834 |
| 实测D0完整包 | 4752 | 4829 |
| 实测D1完整包 | 4752 | 4834 |
| I2C按新Q16校准与实测D0精确匹配 | 4752 | 4829 |
| D1与完整输入参考精确匹配 | 4752 | 4834，其中5帧输入为重建 |
| 内部D1序号缺口、XOR/位错误 | 0 | 0 |
| 平均包间隔 | 3.991316ms | 3.991463ms |
| 实际包率 | 250.543922包/秒 | 250.534720包/秒 |
| 约3ms短间隔次数，含启动阶段 | 41 | 41 |

两份均捕获身份75=68及6B/1A/19/1C/38的01/02/03/00/01回读，完整I2C事务结构和ACK无异常。末端残留的部分I2C事务位于20秒采集右边界，单列保留，不判为中途失败。

首包前无UART字节持续超过12ms，按现有RTL断流重建规则，从SEQ=0建立基线和历史。定点计算采用原系数、既有host/stage4_reference.py，并以NumPy独立卷积复核；系数SHA256与rc1源码清单一致。线缆字段是signed18滤波结果算术右移2位，逐包对照误差为0。对ILA特征计算直接使用内部18位参考值，不拿D1乘4的截断还原值代替。

运动D0在3.338473～3.358198秒附近出现Break，完整包间隔为24.002ms，SEQ从147到153，缺148～152五帧。I2C与D1仍连续，较支持D0探测/采集路径受扰，但未定位具体电气原因。将这5笔实测I2C值按校准公式恢复输入后4834个D1全部匹配；缺测后从3.359220秒开始的4169帧连续实测D0，另按signed32基线全范围传播并排除1024样本后，3145帧结果唯一且与D1精确一致。静止同类保守核查3728帧也全部一致。

## 静止窗口：第一有效窗精确匹配

ILA发布ID为5620（15F4），精确匹配本次局部窗口0，包含原始样本下标62～189、SEQ 3E～BD；末输入约1.785865秒。输入全为实测D0，无重建。

| 轴 | MS：实测ILA＝参考 | RMS：实测ILA＝参考 | 绝对峰值：实测ILA＝参考 |
|---|---:|---:|---:|
| X | 4736 | 68 | 180 |
| Y | 3656 | 60 | 174 |
| Z | 1166 | 34 | 91 |

quality_valid在1024点均为1；alarm_valid于第512点从0变1，alarm_axes为000，符合首个完整可信窗口发布。触发前显示ID5619及旧MS/RMS/峰值，但alarm_valid=0，表示尚无当前有效报警状态；RTL的特征数据寄存器在失效期间可以保留旧值，不能把它当成本次前一完整窗口。恢复后首窗SEQ再次为3E～BD，而累计window_id继续增加，符合STM32重启后重建、FPGA全局未复位的行为。

触发时rx_frame_count为720674；与本次窗口末样本计数190对应，推得本次首包前累计720484帧。不是本次20秒收了72万帧，也不是采样率计算的分母。

## 运动窗口：相邻两窗精确匹配

两窗分别唯一对应本次局部窗口6和7，硬件ID相对局部窗口固定偏移47，说明本次记录前已有运行历史。用户确认motion重新下载过FPGA，不能据此假定其在本份记录首包前没有接收其他数据。此偏移不影响数值核查，也不能将本份记录当作从FPGA配置时刻起的完整冷启动记录。

| 项目 | 前窗 | 后窗，在feature_valid事件发布 |
|---|---|---|
| ILA窗口ID | 53（35） | 54（36） |
| 本次局部窗口 | 6 | 7 |
| SEQ范围 | 3E～BD | BE～3D |
| 约末输入时刻 | 4.525秒 | 5.036秒 |
| X：MS / RMS / 峰值 | 1741162 / 1319 / 4968 | 280696 / 529 / 1566 |
| Y：MS / RMS / 峰值 | 1784437 / 1335 / 4128 | 269254 / 518 / 1075 |
| Z：MS / RMS / 峰值 | 4958190 / 2226 / 9251 | 106036 / 325 / 928 |
| quality_valid / alarm_valid | 1 / 1 | 1 / 1 |
| alarm_axes | 100 | 100 |

表中全部特征均为实测ILA与参考相等。两窗本身的128项输入均有实测D0；其之前滤波历史包含3.34秒处5笔I2C重建输入，这个依赖单独保留，未称其历史全部来自D0。

触发时rx_frame_count为7450，窗口7末样本的本次累计数为1086，故本次输入之前累计6364帧。触发前特征仍是上一窗口，但接收计数已推进到7449，不能用该计数减旧窗口末样本数倒推基值。

## Z轴报警的解释

默认置位门限为2000，解除门限1500，各需要连续两个完整窗口。参考与观测范围分开如下：

| 本次局部窗口 | 约末输入时刻 | Z轴RMS | 参考报警位 | 直接ILA证据 |
|---|---:|---:|---|---|
| 5 | 4.014秒 | 2975 | 000，第一个高窗口 | 本窗未在ILA缓冲中，数值来自参考 |
| 6 | 4.525秒 | 2226 | 100，连续第二个高窗口 | ILA保存此窗特征和已置位100，但没有0→1边沿 |
| 7 | 5.036秒 | 325 | 100，第一个低窗口，保持 | ILA发布此窗，数值和100状态精确匹配 |
| 8 | 5.547秒 | 416 | 000，连续第二个低窗口 | 仅模型预测解除，当前ILA没有覆盖 |

后窗RMS已经低于1500而报警仍为100，是连续两窗确认规则的预期行为。不能据此说报警卡住，也不能由参考窗口8推断实测解除已通过。

当前截图中的alarm_axes=4是十六进制/十进制4，三位二进制为100，表示Z报警，X/Y未报警。这次运动强度比filter_test_3大，实际已出现足够的Z轴窗口能量；不再沿用“本次运动没有达到报警条件”的旧结论。

## 脉冲、保持与诊断

两份CSV的TRIGGER及feature_valid均仅在样本512为1，按50MHz时钟为单拍20ns；窗口数据字段在第512点更新，其他拍保持，质量均有效。静止SEQ字段因新流首窗恰与旧保留字段相同而不发生数值跳变，不以其未变化判失败。完整缓冲1024点按50MHz约20.48µs，不能单凭该缓冲实测窗口约0.511秒的发布周期；本次约0.511秒来自同次输入窗口末项时间差。

两份dropped_count均0。static的filter_restart_count/aborted_windows各8，motion各2，均未在ILA缓冲内增加；它们是累计诊断，不认定为本次采集中新增8或2次错误。当前原始数据不足以追溯全部历史事件原因。触发前后rx领先completed一个包是发送流水过程，不当作输出丢包。

静止D0均值−149.144/−594.762/16493.366计数，三轴滤波还原标准差33.161/40.167/54.451计数；运动时变为523.828/449.774/701.241计数。静止仍有短时输入偏离，所有样本保留，未把它们删掉后宣称传感器无瞬态。约3ms短间隔也仍存在，窗口数值通过不等于物理采样均匀性通过。

## 验收状态与下一步

- B07保留通过；静止新增4752帧无缺测记录，运动完整对照4834帧的5笔重建依赖单列。
- B08窗口数值子项通过：本次共3个有效窗口的MS/RMS/峰值及SEQ精确匹配，单拍发布和保持已由原始CSV核查；整体项目仍缺报警置位/解除边沿、同步失效/恢复的完整证据。
- 实测Z报警及第一个低窗口保持状态与参考一致；下一步优先保存alarm_axes从100到000且alarm_valid保持1的正常解除，并保留同次输入；如补置位边沿则捕获000到100。质量失效导致的清零不算正常解除。
- 随后B10同步观察按住STM32复位后的quality/alarm_valid失效、恢复预热和首窗，并做三轮整机冷启动；B09受控数字频率仍单独未验证。
- 不需因累计window_id非零重做本轮，不改校准参数、FIR或报警门限。移动时继续固定探头和线缆，避免再出现D0测量缺口。

## 实际执行与派生文件

```powershell
& 'C:\Users\QQ165\.cache\codex-runtimes\codex-primary-runtime\dependencies\python\python.exe' -X utf8 report/evidence/analyze_filter_test_4_20261101.py
```

实际退出0，日志 `build/filter_test_4_analysis_20261101.log` 末行 `PASS filter_test_4_analysis_completed originals_unchanged` 表示离线分析完成且原始文件未改，不表示整机最终验收通过。

派生目录 `report/evidence/filter_test_4_20261101_analysis/` 包含summary.json、static_analysis.json、motion_analysis.json及两份逐帧CSV；保存完整ILA快照、精确匹配、所有参考窗口、告警预测及原始输入指纹。分析还分别检查I2C/校准、现有定点参考/独立卷积、完整UART帧、纯实测基线范围、归档CRC和嵌入CSV一致性。

本轮只新增分析、报告和进度记录，未改RTL、固件、约束、原始采集、Vivado缓存或下载设置；未重新仿真、构建或执行硬件操作。
