FFsteve/zynq_vibration_monitor/report/sixface_r2_validation_20261101.md

# 第二轮固定参数验证与重复记录问题

日期：2026-11-01。用户提供 `xp_r2/xn_r2/yp_r2/yn_r2/zp_r2/zn_r2` 六目录。本轮严格使用第一轮留存参数，未用第二轮参数替换验证参数。结论：文件包含五份独立记录，yp_r2实际重复xn_r2；有效五面的可比通信通过，主轴及合成均值满足建议指标，但xp/xn/zn的非主轴残差超出建议范围。第二轮尚未完整通过，正式校准仍为false。

## 实际执行与固定参数

```powershell
& 'C:\Users\QQ165\.cache\codex-runtimes\codex-primary-runtime\dependencies\python\python.exe' -X utf8 report/evidence/analyze_sixface_r2_20261101.py > build/sixface_r2_analysis_20261101.log
```

实际退出0，标记 `PASS r2_analysis_completed originals_and_r1_parameters_unchanged`，表示分析运行完成，不表示数据校准通过。另实际执行结果断言与哈希核查，确认重复标记、Y重复性不可评估、可比通信和输入完整性正确。

参数读取自 `report/evidence/20261101_sixface_r1_analysis/sixface_fit.json` 中的精确有理数，并保存/复核该文件SHA256。参数始终为b=727.653493/−552.006188/5217.627726计数，S=16308.281038/16473.528743/16751.809000计数/g。六份原波形CRC和24份输入分析前后SHA256通过，第一轮参数未改。

输出位于 `report/evidence/20261101_sixface_r2_analysis/`，包括每目录完整检查JSON、原始帧/固定参数校正CSV及 `r2_validation.json`。JSON中 `validation_dataset_complete=false`、`invalid_poses=["yp"]`、`all_suggested_mean_criteria_pass=false`、`formal_calibration_pass=false`。无效yp数据的诊断计算保留以便追溯，但不能解释为Y朝上物理测量。

## yp_r2不是独立Y朝上记录

yp_r2与xn_r2的D0、D1、I2C三个CSV分别逐字节相同：

| 类型 | 两目录共同SHA256 |
| --- | --- |
| D0 UART | f8f3ecd12a94f8daaf3f0aa986d39135efcd6a0ec15d9b13e05983bd049b3e0e |
| D1 UART | a8031c4638d1330693c2ee139e05d49a7f08aecf2f028384b567db00c6705f61 |
| I2C | 6749b6979fa24c5f3549c8911bd7fb10ea4a51ca13fc22d83531fb334a6a0882 |

两份atkdl外部文件哈希不同，但逐通道按排序条目计算内部采样bin内容指纹后，D0～D3四路全部相同。每路48个bin条目、50331648字节；核查不是只比较文件名、均值或外层ZIP。两个目录都包含均值约−15568/−702/+6218的记录，其主轴是负X，不能当作正Y。

因此不能把假yp与yn计算出的巨大Y零偏/灵敏度差当成器件失效。最终JSON把Y重复性诊断值设为null。需要查找真正的Y朝上原始记录；如果没有另存，需重新采集Y朝上。仅从当前yp_r2原波形重新导出CSV不能找回缺失的Y朝上，因为原波形本身也是重复采样。

## 五份独立记录的通信

文件均配置20秒、20MS/s、Buffer、RLE、四通道、1.5V门限，无复位长间断。每目录D0有5010个完整包，六目录文件总计30060包，但独立记录只有25050包，不能把重复yp计作额外独立样本。

| 有效姿态 | D0完整包 | 可比I2C→D0 | 可比D0→D1 | 内部SEQ/XOR/配对异常 |
| --- | --- | --- | --- | --- |
| xp_r2 | 5010 | 5010 | 5009 | 无 |
| xn_r2 | 5010 | 5010 | 5009 | 无 |
| yn_r2 | 5010 | 5010 | 5009 | 无 |
| zp_r2 | 5010 | 5010 | 5010 | 无 |
| zn_r2 | 5010 | 5010 | 5009 | 无 |

可比项目全部一致，完整事务ACK正确。部分记录最后一包的回传在采集尾部未完整保存，单列为边界；未将其当作内部丢包。重复yp本身的数据通信也可以一致，但通信一致不使其成为有效Y朝上记录。本轮没有新增初始化回读、下载版本哈希或ILA证据。

## 第一轮固定参数的独立结果

| 姿态 | 校正后X/Y/Z均值，g | 合成幅值均值 | 主轴均值误差 | 非主轴均值判定 |
| --- | --- | --- | --- | --- |
| xp_r2 | +0.99549 / +0.08376 / +0.05859 | 1.000731g | 0.004511g | 未满足，Y/Z超过0.05g |
| xn_r2 | −0.99924 / −0.00913 / +0.05969 | 1.001072g | 0.000760g | 未满足，Z超过0.05g |
| yp_r2 | 无有效独立Y朝上记录 | 不作姿态验收 | 不评估 | 重复xn，待补 |
| yn_r2 | +0.01175 / −0.99951 / −0.03160 | 1.000102g | 0.000485g | 满足本次建议均值指标 |
| zp_r2 | −0.00479 / +0.00171 / +1.00070 | 1.000730g | 0.000699g | 满足本次建议均值指标 |
| zn_r2 | +0.08176 / −0.06526 / −0.99526 | 1.000777g | 0.004740g | 未满足，X/Y超过0.05g |

采用既定建议：主轴均值误差≤0.05g，非主轴均值绝对值≤0.05g，各姿态合成幅值均值0.97～1.03g。这些是项目初步目标，不是器件保证。有效五面主轴和合成均值均满足，但只yn/zp同时满足全部均值指标；不能因此宣称整机或每个样本均通过。

合成幅值保持约1g、主轴略低且横轴分量增加，与摆放倾斜几度相容，是优先核对方向；这只是依据向量关系的推断，不排除轴间误差、偏置变化或其他测量条件。不能只凭合成幅值约1g就跳过横轴验收，也不能直接认定模型失效或芯片损坏。

## 重复性诊断与剩余波动

仅用于诊断、没有用于校正的第二轮X/Z两点估计，与第一轮对比：

| 轴 | 两轮零偏差，计数 | 灵敏度相对差 | 建议重复性范围 |
| --- | --- | --- | --- |
| X | −30.588 | −0.2635% | 在约164计数/1%以内 |
| Y | 无法评估 | 无法评估 | 缺少独立正Y |
| Z | +45.551 | −0.2020% | 在约164计数/1%以内 |

X/Z结果提供主轴偏置及比例重复性的支持，但六面独立验证仍缺Y且有横轴超限。没有据诊断值重新拟合第二轮来使结果通过。

xp_r2在约2.429861和2.433863秒有两个X主轴样本偏离本面中位数超过500计数，分别涉及X约16344～17780；保留全部样本。其他有效面的主轴在该定位规则下无超阈样本，不表示所有形式瞬态均已排除。旧60秒静止瞬态仍待查。

xp/zp各40次、xn/yn/zn各39次约3ms间隔；平均发包率仍约250.49～250.50包/秒，无内部SEQ缺口。周期问题没有因第二轮量值验证而解决，也没有修改时间标签。

## 下一步

1. 先查找真正的Y朝上第二轮原始记录。若尚未保存，重新摆正Y正方向向上采20秒，保存到新目录如 `yp_r2b`，不要覆盖当前重复证据；当前原波形重复，不能靠重新导出修复。
2. 不必立即把六面全部重测。先加强xp/xn/zn的水平或垂直支撑，松手并等待稳定，用轴标识和水平参考核对姿态，保存针对性复核记录到 `xp_r2b/xn_r2b/zn_r2b`。保留本轮未通过记录，不挑选样本替代它们。
3. 继续用原SensorSource采未补偿数据，仍以第一轮固定参数处理新记录；不要改成旧SensorCalibratedTrial或重新拟合来掩盖第二轮残差。
4. 若姿态精度确认后残差仍重复超限，再评审模型和硬件/测量条件；同时时序与静止瞬态独立排查。现阶段不更新固件参数、不宣布正式校准通过。

本轮仅新增分析与结果文档、更新状态和开发日志，未改第一轮参数、固件、RTL、约束、原始采集或rc1；未执行仿真、编译、烧录或硬件操作。
