FFsteve/zynq_vibration_monitor/report/sixface_r2b_validation_20261101.md

# 第二轮补采与针对性复测分析

日期：2026-11-01。用户已删除原重复的yp_r2并用新文件替换；xp/xn/zn补采文件后缀为_r2b，仍位于原_r2目录。本轮明确按文件后缀选取，不误读同目录的旧记录，不覆盖此前未通过报告或派生分析。

**结论：新yp数据有效且不再重复；xp/xn/zn复测均满足既定均值指标，原yn/zp继续满足；目前只剩Y朝上Z均值残差+0.091213g未满足0.05g目标。三轴偏置与灵敏度重复性诊断通过建议范围，第一轮参数未改，正式校准仍未通过。**

## 实际执行与选取来源

```powershell
& 'C:\Users\QQ165\.cache\codex-runtimes\codex-primary-runtime\dependencies\python\python.exe' -X utf8 report/evidence/analyze_sixface_r2b_20261101.py > build/sixface_r2b_analysis_20261101.log
```

实际退出0。另实际执行结果与指纹断言：来源映射正确、无重复姿态、当前36份目录文件SHA256前后相同、第一轮参数SHA256不变、新yp四份输入均与此前误保存版本不同，可比通信与重复性判定正确。

| 姿态 | 目录 | 本轮使用的文件后缀 |
| --- | --- | --- |
| xp | xp_r2 | xp_r2b |
| xn | xn_r2 | xn_r2b |
| yp | yp_r2 | yp_r2，新替换的真实Y朝上 |
| yn | yn_r2 | yn_r2，此前有效记录 |
| zp | zp_r2 | zp_r2，此前有效记录 |
| zn | zn_r2 | zn_r2b |

每个后缀对应原波形、D0、D1和I2C四份文件，共选取24份。因为xp/xn/zn目录同时保留旧_r2文件，指纹核查覆盖目录内36份当前文件；不将另外12份旧文件冒充本轮重新分析。原重复yp文件已由用户删除，旧报告中的指纹和派生结果继续保留，不声称本轮仍能复核被删除的旧原文件。

对原第二轮分析器只增加显式文件后缀映射，默认使用_r2的行为不变；本轮入口指定独立输出目录 `report/evidence/20261101_sixface_r2b_analysis/`。固定参数始终来自第一轮 `sixface_fit.json` 的精确有理数：b约727.653493/−552.006188/5217.627726，S约16308.281038/16473.528743/16751.809000，不用复测数据重拟合后再验收。

## 采集与通信完整性

六份选定原波形CRC通过，均为20MS/s、20秒、Buffer/RLE、四通道。总计30059个完整D0包，无复位长间断；完整区间SEQ连续，候选XOR、ACK及内部配对检查无异常，未见UART警告。

| 选定姿态 | D0完整包 | 可比I2C→D0 | 可比D0→D1 |
| --- | --- | --- | --- |
| xp_r2b | 5010 | 5009 | 5010 |
| xn_r2b | 5009 | 5009 | 5009 |
| 新yp_r2 | 5010 | 5010 | 5010 |
| yn_r2 | 5010 | 5010 | 5009 |
| zp_r2 | 5010 | 5010 | 5010 |
| zn_r2b | 5010 | 5010 | 5010 |

可比项全部一致。xp最初一包输入前的I2C事务位于可比左边界外；xn最左侧有对应输入未完整捕获的上一份D1回包；yn末包回传在右边界截断。均与首尾时间范围相符，作为边界项保存，不计内部正常区间失败。

新yp的原始均值约662.567/15865.115/6745.606，主轴为正Y，六份D0指纹互不相同，之前yp重复xn的问题已经解决。以上为采集内容核对，未新增初始化回读、下载版本哈希、ILA或算法板测结论。

## 固定第一轮参数的结果

建议均值指标沿用原方案：主轴与目标差≤0.05g、非主轴均值绝对值≤0.05g、合成幅值均值0.97～1.03g。不是器件保证，也不要求每一个样本都在均值目标范围内。

| 姿态 | 校正后X/Y/Z均值，g | 合成幅值均值，g | 最大非主轴均值绝对值 | 本次均值判定 |
| --- | --- | --- | --- | --- |
| xp_r2b | +1.000506 / +0.001563 / +0.005068 | 1.000527 | 0.005068g | 满足 |
| xn_r2b | −0.999411 / +0.042283 / −0.039523 | 1.001092 | 0.042283g | 满足 |
| 新yp_r2 | −0.003991 / +0.996576 / +0.091213 | 1.000768 | 0.091213g | 未满足，Z超过0.05g |
| yn_r2 | +0.011754 / −0.999515 / −0.031599 | 1.000102 | 0.031599g | 满足 |
| zp_r2 | −0.004790 / +0.001714 / +1.000699 | 1.000730 | 0.004790g | 满足 |
| zn_r2b | −0.028136 / −0.006725 / −0.998649 | 0.999087 | 0.028136g | 满足 |

六份主轴和合成幅值均值均满足建议目标，5份同时满足非主轴要求。xn虽然通过，但横轴残差约0.04g，不能描述成所有横轴接近零或高精度校准。

对比原第二轮，xp最大横轴均值残差由约0.08376降至0.00507g，xn由0.05969降至0.04228g，zn由0.08176降至0.02814g。参数未变，说明重新摆放及采集条件对结果有重要影响；不能据此唯一确定原偏差来自摆放。

新yp的Z残差不是由短暂样本单独造成：Z样本标准差约0.002758g，而均值约+0.091213g。若校准后的偏差全部来自姿态倾斜，按均值向量计算相对正Y约5.23度；这是条件性解释，不是实测角度或已排除模型/偏置问题的证据。

## 两轮重复性诊断

只为检查重复性，使用选定第二轮/复测数据另算两点估计，但这些估计没有用于上表校正：

| 轴 | 第二轮诊断零偏 | 相对第一轮零偏差 | 灵敏度相对差 |
| --- | --- | --- | --- |
| X | 736.585527 | +8.932034计数 | −0.00417% |
| Y | −576.214571 | −24.208383计数 | −0.19546% |
| Z | 5234.800599 | +17.172872计数 | −0.03263% |

均满足原建议的约164计数零偏差和1%灵敏度差。它们支持偏置/比例的重复性，但不能抵消Y正面横轴不满足要求；而且本轮是保留原有效姿态并针对未通过姿态复测的来源组合，不冒充同一次新完整六面采集或跨重启验证。

## 周期与瞬态

xp/xn/yn各39次、yp/zp/zn各40次约3ms间隔，平均线上发包率约250.49～250.50包/秒。周期问题没有消失，依然需要DATA_RDY轮询和相对时基分析；不能因量值均值改善而将均匀250Hz标为通过。

在主轴相对本面中位数偏离超过500计数的定位规则下，新yp约0.632296秒有1个样本，其余选定五面无此类主轴样本。所有样本均保留，规则只用于定位，不是完整异常检验；之前60秒的明显静止瞬态仍为待查，不能宣布已排除。

## 下一步

1. 重复保存问题已解决，xp/xn/zn针对性复测已满足本次均值目标，不必再次全部重采。
2. 只对Y朝上进行姿态核对和定向复测：以模块轴标识为准，让正Y尽量竖直向上，检查绕X方向的倾斜，采用稳定支撑和水平/直角参考；放手等稳定后再采20秒。保存到新后缀如 `yp_r2b`，保留当前真实yp_r2的未通过记录。
3. 仍用原SensorSource采原始数据，使用第一轮固定参数复核。若机械姿态确认后仍稳定出现约0.09g残差，停止盲目重复采集或改参数迎合目标，转而检查模型与测量条件。
4. 当前结果为五面均值指标满足、三轴偏置/比例重复性满足，整体静态离线验证尚缺最后一面通过。`formal_calibration_pass=false`；未更新旧SensorCalibratedTrial，尚无新参数C实现/编译/烧录或板测通过。

本轮只修改离线分析入口/参数映射并新增结果和说明，更新进度与AI日志；没有改第一轮参数、用户原始采集、固件、RTL、约束或rc1，没有执行仿真、构建或硬件操作。
