FFsteve/zynq_vibration_monitor/board/fpga/debug/release_result.txt

PASS buzzer_release variant=debug mode=1 setup_slack=7.377 hold_slack=0.020
