FFsteve/zynq_vibration_monitor/report/evidence/filter_test_2_20261101_analysis/comparison.csv

index | reply_time_s | seq | input_source | input_x | input_y | input_z | wire_x | wire_y | wire_z | restored_x | restored_y | restored_z | point_x | point_y | point_z | low_x | low_y | low_z | high_x | high_y | high_z
0 | 0.0012055 | 250 | measured_d0 | 4 | -525 | 16471 | -1 | 2 | 0 | -4 | 8 | 0 | 0 | 0 | 0 | -2 | -2 | -3 | 1 | 1 | 0
1 | 0.0052072 | 251 | measured_d0 | -319 | -656 | 16553 | -1 | -2 | -5 | -4 | -8 | -20 | 0 | 0 | 0 | -9 | -9 | -13 | 8 | 8 | 4
2 | 0.00920885 | 252 | measured_d0 | 30 | -517 | 16570 | 0 | -3 | -9 | 0 | -12 | -36 | 0 | 0 | 0 | -15 | -15 | -22 | 14 | 14 | 7
3 | 0.01321055 | 253 | measured_d0 | -138 | -527 | 16510 | 2 | -3 | -9 | 8 | -12 | -36 | 0 | 0 | 0 | -15 | -15 | -22 | 15 | 15 | 8
4 | 0.01720355 | 254 | measured_d0 | -303 | -674 | 16449 | 5 | -1 | -6 | 20 | -4 | -24 | 0 | 0 | 0 | -25 | -25 | -26 | 25 | 25 | 23
5 | 0.02120525 | 255 | measured_d0 | -2 | -537 | 16488 | 6 | 1 | -1 | 24 | 4 | -4 | 0 | 0 | 0 | -36 | -36 | -31 | 35 | 35 | 40
6 | 0.0252069 | 0 | measured_d0 | -189 | -609 | 16504 | 4 | 2 | 6 | 16 | 8 | 24 | 0 | 0 | 0 | -35 | -35 | -30 | 34 | 34 | 39
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
