FFsteve/zynq_vibration_monitor/report/evidence/filter_test_3_20261101_analysis/comparison.csv

index | input_time_s | seq | input_x | input_y | input_z | reference_fir_x | reference_fir_y | reference_fir_z | expected_wire_x | expected_wire_y | expected_wire_z | measured_wire_x | measured_wire_y | measured_wire_z | complete_reply
0 | 0.38382315 | 0 | 20 | -581 | 16418 | 0 | 0 | 0 | 0 | 0 | 0 | 0 | 0 | 0 | 1
1 | 0.3868266 | 1 | -215 | -499 | 15260 | 0 | 0 | 0 | 0 | 0 | 0 | 0 | 0 | 0 | 1
2 | 0.38982135 | 2 | -32 | -517 | 16277 | 0 | 0 | 1 | 0 | 0 | 0 | 0 | 0 | 0 | 1
3 | 0.3928248 | 3 | -6 | -444 | 16267 | 0 | 0 | 1 | 0 | 0 | 0 | 0 | 0 | 0 | 1
4 | 0.39682645000000005 | 4 | -241 | -497 | 16285 | 0 | 0 | 0 | 0 | 0 | 0 | 0 | 0 | 0 | 1
5 | 0.40082815 | 5 | 39 | -515 | 16355 | 0 | 0 | -1 | 0 | 0 | -1 | 0 | 0 | -1 | 1
6 | 0.40482115 | 6 | -166 | -557 | 16553 | 0 | 0 | -2 | 0 | 0 | -1 | 0 | 0 | -1 | 1
7 | 0.4088228 | 7 | -349 | -601 | 16674 | 0 | 0 | 0 | 0 | 0 | 0 | 0 | 0 | 0 | 1
8 | 0.4128245 | 8 | -144 | -529 | 16688 | 1 | 0 | 2 | 0 | 0 | 0 | 0 | 0 | 0 | 1
9 | 0.4168262 | 9 | -283 | -690 | 16574 | 1 | 0 | 3 | 0 | 0 | 0 | 0 | 0 | 0 | 1
10 | 0.42082785 | 10 | -213 | -710 | 16537 | 0 | 0 | 1 | 0 | 0 | 0 | 0 | 0 | 0 | 1
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
