FFsteve/zynq_vibration_monitor/report/evidence/filter_test_4_20261101_analysis/motion_frames.csv

index | reply_time_s | seq | input_source | input_x | input_y | input_z | reference_fir_x | reference_fir_y | reference_fir_z | wire_x | wire_y | wire_z
0 | 0.7081175500000001 | 0 | measured_d0 | 567 | -481 | 15890 | 0 | 0 | 0 | 0 | 0 | 0
1 | 0.71112095 | 1 | measured_d0 | -476 | -332 | 15999 | 0 | 0 | 0 | 0 | 0 | 0
2 | 0.7141244000000001 | 2 | measured_d0 | -82 | -290 | 16175 | 1 | 0 | 0 | 0 | 0 | 0
3 | 0.7171104500000001 | 3 | measured_d0 | -64 | -259 | 16674 | 1 | 0 | 0 | 0 | 0 | 0
4 | 0.72112085 | 4 | measured_d0 | -295 | -111 | 16465 | 1 | 0 | -1 | 0 | 0 | -1
5 | 0.7251225 | 5 | measured_d0 | -8 | -175 | 16277 | 0 | 0 | -1 | 0 | 0 | -1
6 | 0.7291155 | 6 | measured_d0 | -92 | -302 | 16523 | -1 | 0 | 0 | -1 | 0 | 0
7 | 0.7331172 | 7 | measured_d0 | -512 | -452 | 16964 | -1 | 0 | 1 | -1 | 0 | 0
8 | 0.73711885 | 8 | measured_d0 | 49 | -8 | 16040 | 2 | 0 | 0 | 0 | 0 | 0
9 | 0.74112055 | 9 | measured_d0 | -197 | -267 | 16611 | 4 | 0 | -1 | 1 | 0 | -1
10 | 0.74511355 | 10 | measured_d0 | -193 | -312 | 16459 | 3 | -1 | -2 | 0 | -1 | -1
11 | 0.74911525 | 11 | measured_d0 | 16 | -185 | 16484 | -1 | -1 | -2 | -1 | -1 | -1
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
