FFsteve/zynq_vibration_monitor/report/evidence/filter_test_4_20261101_analysis/static_frames.csv

index | reply_time_s | seq | input_source | input_x | input_y | input_z | reference_fir_x | reference_fir_y | reference_fir_z | wire_x | wire_y | wire_z
0 | 1.034739 | 0 | measured_d0 | -610 | -1034 | 16844 | 0 | 0 | 0 | 0 | 0 | 0
1 | 1.037742 | 1 | measured_d0 | -562 | -911 | 16122 | 0 | 0 | 0 | 0 | 0 | 0
2 | 1.040746 | 2 | measured_d0 | -520 | -855 | 16895 | 0 | 0 | 1 | 0 | 0 | 0
3 | 1.043741 | 3 | measured_d0 | -369 | -923 | 16809 | 0 | 0 | 0 | 0 | 0 | 0
4 | 1.047742 | 4 | measured_d0 | 348 | 350 | 12899 | 0 | 0 | 1 | 0 | 0 | 0
5 | 1.051744 | 5 | measured_d0 | -815 | 1263 | 14810 | -1 | -1 | 3 | -1 | -1 | 0
6 | 1.055746 | 6 | measured_d0 | -474 | -517 | 15952 | 0 | -3 | 4 | 0 | -1 | 1
7 | 1.059739 | 7 | measured_d0 | 296 | -2126 | 18480 | 0 | -1 | 1 | 0 | -1 | 0
8 | 1.06374 | 8 | measured_d0 | 177 | -1142 | 16645 | 0 | 3 | -5 | 0 | 0 | -2
9 | 1.067742 | 9 | measured_d0 | -494 | -340 | 16242 | -1 | 5 | -7 | -1 | 1 | -2
10 | 1.071744 | 10 | measured_d0 | -126 | 463 | 15105 | -2 | 2 | -2 | -1 | 0 | -1
11 | 1.075745 | 11 | measured_d0 | -293 | -637 | 16566 | -2 | -6 | 9 | -1 | -2 | 2
12 | 1.079738 | 12 | measured_d0 | 8 | -989 | 16981 | 0 | -11 | 15 | 0 | -3 | 3
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
