FFsteve/zynq_vibration_monitor/data/measured/ila/motion.csv

Sample in Buffer | Sample in Window | TRIGGER | debug_feature_valid_o | debug_quality_valid_o | debug_alarm_valid_o | debug_alarm_axes_o[2:0] | debug_window_id_o[31:0] | debug_seq_start_o[7:0] | debug_seq_end_o[7:0] | debug_ms_x_o[34:0] | debug_ms_y_o[34:0] | debug_ms_z_o[34:0] | debug_rms_x_o[17:0] | debug_rms_y_o[17:0] | debug_rms_z_o[17:0] | debug_peak_x_o[17:0] | debug_peak_y_o[17:0] | debug_peak_z_o[17:0] | debug_rx_frame_count_o[31:0] | debug_dropped_count_o[31:0] | debug_completed_count_o[31:0] | debug_filter_restart_count_o[31:0] | debug_aborted_windows_o[31:0]
Radix - UNSIGNED | UNSIGNED | UNSIGNED | HEX | HEX | HEX | HEX | HEX | HEX | HEX | HEX | HEX | HEX | HEX | HEX | HEX | HEX | HEX | HEX | HEX | HEX | HEX | HEX | HEX
0 | 0 | 0 | 0 | 1 | 1 | 4 | 00000035 | 3e | bd | 0001a916a | 0001b3a75 | 0004ba7ee | 00527 | 00537 | 008b2 | 01368 | 01020 | 02423 | 00001d19 | 00000000 | 00001d19 | 00000002 | 00000002
1 | 1 | 0 | 0 | 1 | 1 | 4 | 00000035 | 3e | bd | 0001a916a | 0001b3a75 | 0004ba7ee | 00527 | 00537 | 008b2 | 01368 | 01020 | 02423 | 00001d19 | 00000000 | 00001d19 | 00000002 | 00000002
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
