FFsteve/zynq_vibration_monitor/data/measured/ila/static.csv

Sample in Buffer | Sample in Window | TRIGGER | debug_feature_valid_o | debug_quality_valid_o | debug_alarm_valid_o | debug_alarm_axes_o[2:0] | debug_window_id_o[31:0] | debug_seq_start_o[7:0] | debug_seq_end_o[7:0] | debug_ms_x_o[34:0] | debug_ms_y_o[34:0] | debug_ms_z_o[34:0] | debug_rms_x_o[17:0] | debug_rms_y_o[17:0] | debug_rms_z_o[17:0] | debug_peak_x_o[17:0] | debug_peak_y_o[17:0] | debug_peak_z_o[17:0] | debug_rx_frame_count_o[31:0] | debug_dropped_count_o[31:0] | debug_completed_count_o[31:0] | debug_filter_restart_count_o[31:0] | debug_aborted_windows_o[31:0]
Radix - UNSIGNED | UNSIGNED | UNSIGNED | HEX | HEX | HEX | HEX | HEX | HEX | HEX | HEX | HEX | HEX | HEX | HEX | HEX | HEX | HEX | HEX | HEX | HEX | HEX | HEX | HEX
0 | 0 | 0 | 0 | 1 | 0 | 0 | 000015f3 | 3e | bd | 000005f03 | 000006e2d | 000014fce | 0009b | 000a7 | 00125 | 0025b | 00317 | 005e7 | 000aff21 | 00000000 | 000aff21 | 00000008 | 00000008
1 | 1 | 0 | 0 | 1 | 0 | 0 | 000015f3 | 3e | bd | 000005f03 | 000006e2d | 000014fce | 0009b | 000a7 | 00125 | 0025b | 00317 | 005e7 | 000aff21 | 00000000 | 000aff21 | 00000008 | 00000008
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
