FFsteve/zynq_vibration_monitor/report/evidence/calibration_trial_20261031/xn_corrected.csv

seq | start_s | raw_x | raw_y | raw_z | x_g | y_g | z_g | corrected_x | corrected_y | corrected_z | clipped_axes
236 | 0.00296275 | -15452 | -424 | 6466 | -0.993614183624351 | 0.006758123912427645 | 0.07066524646073678 | -16279 | 111 | 1158 | 0
237 | 0.0069644500000000005 | -15638 | -422 | 6520 | -1.0050533025251926 | 0.0068795273360041905 | 0.07390571632886767 | -16467 | 113 | 1211 | 0
238 | 0.010966150000000001 | -15480 | -480 | 6482 | -0.9953362015234024 | 0.0033588280522843894 | 0.07162538568092372 | -16308 | 55 | 1174 | 0
239 | 0.01495915 | -15584 | -440 | 6590 | -1.0017322680055936 | 0.005786896523815287 | 0.07810632541718547 | -16412 | 95 | 1280 | 0
240 | 0.0189608 | -15694 | -512 | 6450 | -1.0084973383232956 | 0.0014163732750596717 | 0.06970510724054986 | -16523 | 23 | 1142 | 0
241 | 0.0229625 | -15474 | -416 | 6506 | -0.9949671976878914 | 0.007243737606733825 | 0.0730655945112041 | -16302 | 119 | 1197 | 0
242 | 0.0269642 | -15678 | -416 | 6502 | -1.0075133280952662 | 0.007243737606733825 | 0.07282555970615738 | -16507 | 119 | 1193 | 0
243 | 0.0309659 | -15592 | -500 | 6502 | -1.0022242731196083 | 0.002144793816518941 | 0.07282555970615738 | -16420 | 35 | 1193 | 0
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
