FFsteve/zynq_vibration_monitor/report/evidence/calibration_trial_20261031/xp_corrected.csv

seq | start_s | raw_x | raw_y | raw_z | x_g | y_g | z_g | corrected_x | corrected_y | corrected_z | clipped_axes
46 | 0.0006284999999999999 | 16838 | 474 | 6444 | 0.9922414578174605 | 0.061268261098296285 | 0.06934505503297976 | 16257 | 1004 | 1136 | 0
47 | 0.0046302 | 17022 | 542 | 6478 | 1.0035575754397985 | 0.06539597749989881 | 0.07138535087587698 | 16442 | 1071 | 1170 | 0
48 | 0.0086319 | 17002 | 516 | 6380 | 1.0023275626547616 | 0.06381773299340372 | 0.06550449815223205 | 16422 | 1046 | 1073 | 0
49 | 0.0126249 | 16848 | 480 | 6474 | 0.9928564642099789 | 0.06163247136902592 | 0.07114531607083026 | 16267 | 1010 | 1166 | 0
50 | 0.01662655 | 17082 | 594 | 6410 | 1.0072476137949087 | 0.06855246651288897 | 0.06730475919008254 | 16503 | 1123 | 1103 | 0
51 | 0.02062825 | 16982 | 546 | 6338 | 1.001097549869725 | 0.0656387843470519 | 0.06298413269924137 | 16402 | 1075 | 1032 | 0
52 | 0.02462995 | 16942 | 460 | 6344 | 0.9986375242996516 | 0.06041843713326047 | 0.06334418490681147 | 16362 | 990 | 1038 | 0
53 | 0.0286316 | 17084 | 554 | 6298 | 1.0073706150734123 | 0.06612439804135808 | 0.06058378464877406 | 16505 | 1083 | 993 | 0
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
