FFsteve/zynq_vibration_monitor/report/evidence/calibration_trial_20261031/yn_corrected.csv

seq | start_s | raw_x | raw_y | raw_z | x_g | y_g | z_g | corrected_x | corrected_y | corrected_z | clipped_axes
134 | 0.0034865499999999997 | 994 | -17006 | 5720 | 0.017825329511357686 | -0.9997976609607059 | 0.02589875531952131 | 292 | -16381 | 424 | 0
135 | 0.00748825 | 782 | -17060 | 5614 | 0.004787193989968275 | -1.0030755533972726 | 0.01953783298578292 | 78 | -16434 | 320 | 0
136 | 0.0114899 | 964 | -16960 | 5592 | 0.01598031033380258 | -0.9970053822184453 | 0.018217641558025896 | 262 | -16335 | 298 | 0
137 | 0.0154829 | 792 | -17008 | 5658 | 0.005402200382486643 | -0.9999190643842824 | 0.02217821584129697 | 89 | -16383 | 363 | 0
138 | 0.0194846 | 766 | -17132 | 5616 | 0.0038031837619388856 | -1.0074460766460283 | 0.019657850388306287 | 62 | -16506 | 322 | 0
139 | 0.0234863 | 964 | -16984 | 5636 | 0.01598031033380258 | -0.9984622233013638 | 0.020858024413539945 | 262 | -16359 | 342 | 0
140 | 0.027488 | 786 | -16982 | 5564 | 0.005033196546975622 | -0.9983408198777873 | 0.016537397922698774 | 82 | -16357 | 271 | 0
141 | 0.03148965 | 906 | -16970 | 5646 | 0.012413273257196043 | -0.9976123993363281 | 0.021458111426156775 | 203 | -16345 | 352 | 0
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
