FFsteve/zynq_vibration_monitor/report/evidence/calibration_trial_20261031/yp_corrected.csv

seq | start_s | raw_x | raw_y | raw_z | x_g | y_g | z_g | corrected_x | corrected_y | corrected_z | clipped_axes
55 | 0.0014157 | 364 | 15856 | 5230 | -0.020920073217299523 | 0.9949819918255027 | -0.0035055082987033304 | -343 | 16302 | -57 | 0
56 | 0.00541735 | 554 | 15946 | 5276 | -0.009234951759450523 | 1.0004451458864472 | -0.0007451080406659147 | -151 | 16391 | -12 | 0
57 | 0.00941905 | 370 | 16008 | 5246 | -0.020551069381788502 | 1.0042086520173201 | -0.002545369078516403 | -337 | 16453 | -42 | 0
58 | 0.01342075 | 412 | 15938 | 5282 | -0.017968042533211354 | 0.9999595321921411 | -0.0003850558330958171 | -294 | 16383 | -6 | 0
59 | 0.017422450000000003 | 532 | 15956 | 5200 | -0.010587965822990934 | 1.00105216300433 | -0.005305769336553819 | -173 | 16401 | -87 | 0
60 | 0.02141545 | 342 | 15922 | 5276 | -0.022273087280839935 | 0.9989883048035287 | -0.0007451080406659147 | -365 | 16367 | -12 | 0
61 | 0.0254171 | 514 | 15892 | 5274 | -0.011694977329523997 | 0.9971672534498806 | -0.0008651254431892806 | -192 | 16338 | -14 | 0
62 | 0.029418800000000002 | 524 | 16002 | 5240 | -0.011079970937005629 | 1.0038444417465906 | -0.002905421286086501 | -182 | 16447 | -48 | 0
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
