FFsteve/zynq_vibration_monitor/report/evidence/fixed_filter_ila_20261101/filter_test_final/02_alarm.png

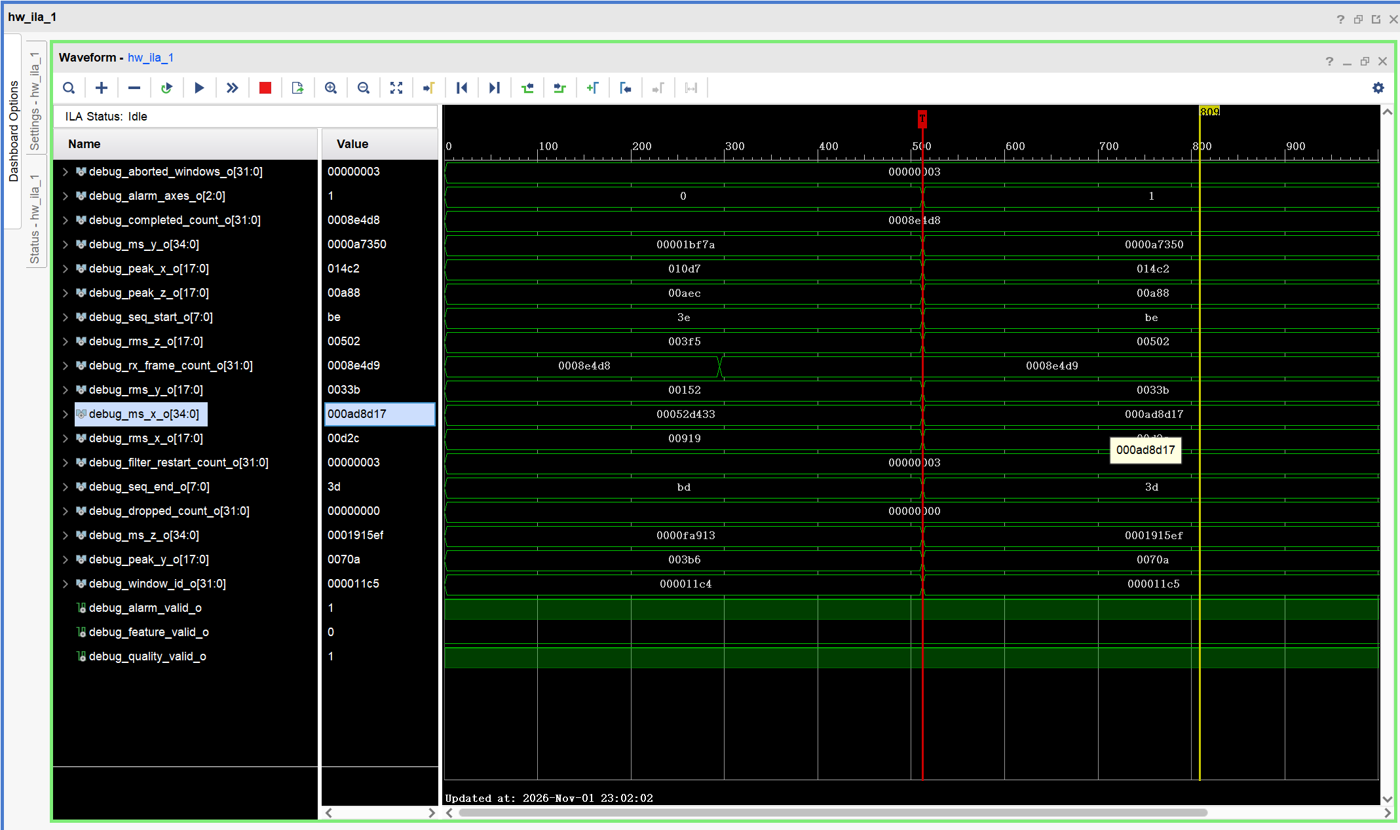
report/evidence/fixed_filter_ila_20261101/filter_test_final/02_alarm.png
