FFsteve/zynq_vibration_monitor/report/ai_devlog.md

# AI 协作开发日志

记录每次重要交互的日期时间、任务、用户请求或链接、AI 建议、采纳或否决情况、发现的错误、准确验证命令或板测步骤、真实结果与证据路径，以及可复用指导的更新。区分建议、图纸结论、仿真证据和实测结果。

| 日期 | 任务 | AI 建议 | 用户决定或纠正 | 验证证据 | 状态 |
|---|---|---|---|---|---|
| 2026-09-21 | 初始交接 | 初始架构和未验证 XDC | 等待实物检查 | 无 | 未验证 |
| 2026-10-27 | 第一阶段授权 | 仅实现 UART RX、自检 TB、仿真入口与文档 | 用户明确要求完成第一阶段，不引入后续 RTL | `docs/uart_rx_design.md`、`docs/stage1_test_guide.md` | 已实现 |
| 2026-10-27 | 原理图纠错 | PL_GCLK 从 U13 纠正为 U18，记录连接器与供电路径 | 核心板第 3、7、10 页及底板第 1、5 页图面已核；仍需实测 | `docs/hardware_pinmap.md`、`constr/top_candidate.xdc` | 图纸确认，未板测 |
| 2026-10-27 | UART RX 设计 | 两级同步、五状态中心采样、每位 434 拍、同步复位和坏停止位恢复 | 采用此前解释的接口与状态机，协议不变 | `rtl/uart_rx.v`、`docs/uart_rx_design.md` | 所测用例仿真通过 |
| 2026-10-27 | ModelSim 回归 | 全字节、连续发送、相位、波特率/抖动、起止错误、BREAK、复位、毛刺、奇数分频 | ModelSim SE-64 2020.4 实跑接收 1398 字节、8 次预期错误，测试失败为零 | 命令 `.\sim\run_uart_rx.ps1 -Simulator both`；`build/modelsim_uart_rx/transcript.log`；11:52:04，Asia/Shanghai | 通过 |
| 2026-10-27 | Vivado XSim 回归 | 用另一仿真器运行相同 RTL/TB | XSim 2020.2 实跑计数与结束时刻一致 | 同一命令；`build/xsim_uart_rx/xsim.log`；11:52:13，Asia/Shanghai；`report/stage1_validation.md` | 通过，未综合或板测 |
| 2026-10-27 | 启动脚本纠错 | 显式传仓库根目录，XSim Tcl 路径使用正斜杠，运行前作废旧结果 | 失败启动不计为通过，最终脚本已验证 | `sim/run_uart_rx.ps1`、`sim/modelsim/run_uart_rx.do` 和验证报告 | 已纠正 |
| 2026-10-27 | 临时文件清理 | 仅清理 D:/build/modelsim_uart_rx 的失败启动产物 | 自动审批依据项目规则拒绝删除；未删除，未绕过 | `report/stage1_validation.md`；目录仍在，不影响最终结果 | 等待明确清理批准 |
| 2026-10-27 | 剩余风险 | 核实板卡/芯片、电压、振荡器和跳线，后续完成顶层时序与跨时钟域检查 | 不猜复位脚；候选 XDC 不用于 RX 独立仿真；不实现解析器、TX、PS 或烧录 | `docs/stage1_test_guide.md`、`docs/next_task.md` | 等待实物检查和用户评审 |
| 2026-10-27 | 文档和注释中文化 | 第一阶段 Markdown 与说明性注释使用中文，保留命令、标识符及自动日志标记 | 用户明确要求；长期规则写入 `AGENTS.md`，不改变功能代码 | 修改前后非注释代码完全一致；ModelSim 2020.4 与 XSim 2020.2 重新编译通过；PowerShell 语法和 UTF-8 BOM 检查通过；详见 `report/stage1_validation.md` | 已完成；本轮未重跑完整仿真 |
| 2026-10-27 | 第二阶段授权 | 实现包解析器与 TX，各自自检，并验证模块链路 | 用户接受第一阶段、暂缓上板、要求继续第二阶段；本轮不增加板级顶层 | `docs/stage2_design.md` | 已实施 |
| 2026-10-27 | 当前协议约定 | 沿用十字节布局，采用此前已解释的 2 ms 超时、滑动恢复、原子提交和序号诊断 | 属于第二阶段实现选择；未改变包头、XOR 或大端，也不宣称已实测 | `docs/project_context.md`、`rtl/packet_parser.v` | 当前约定，后续变更仍需批准 |
| 2026-10-27 | 解析器 TB 纠错 | 单个 A5 不应计为完整包头候选校验错误 | 首次测试期望多计一次，导致后续计数检查连带失败；只纠正 TB 期望，不放宽功能检查 | `sim/tb/tb_packet_parser.v`、`report/stage2_validation.md` | 已纠正并重跑 |
| 2026-10-27 | 第二阶段 ModelSim | 三项独立测试与模块链路 | 2020.4 实跑全部通过，解析器 118 包；TX 完成 666 帧、复位终止 20 帧；链路 103 字节/8 包 | `powershell.exe -NoProfile -ExecutionPolicy Bypass -File .\sim\run_stage2.ps1 -Simulator modelsim`；19:33:39 至 19:33:50；`build/modelsim_stage2/` | 三项通过，错误数为 0 |
| 2026-10-27 | 第二阶段 XSim | 相同 RTL/TB 交叉验证 | 2020.2 三项实跑通过，统计与仿真结束时刻均与 ModelSim 一致 | `powershell.exe -NoProfile -ExecutionPolicy Bypass -File .\sim\run_stage2.ps1 -Simulator xsim`；末项 19:34:35 完成；`build/xsim_stage2/` | 三项通过，错误数为 0 |
| 2026-10-27 | 第一阶段保护与范围 | 保留 RX、原 TB、约束和既有证据，新增内容使用中文 | RX/TB 哈希与本轮开始一致；没有综合、实现或上板；没有 STM32、PC 程序或 PS | `report/stage2_validation.md`、`docs/stage2_test_guide.md` | 第二阶段完成，等待用户评审 |
| 2026-10-27 | 第三阶段授权 | 完成原始通信闭环、PC 日志和标准库采集工程 | 用户接受第二阶段并要求继续，保持暂缓上板 | `docs/stage3_design.md` | 软件与仿真实施完成 |
| 2026-10-27 | 用户提供 STM32 库 | 核查 Libraries 后引用实际 CMSIS/标准库，不套用 HAL | 提供的是库，不含应用模板；自建两目标 Keil 工程；HSE 8 MHz/72 MHz 为软件默认，未当成实物确认 | `stm32/README.md`、库哈希清单 | 库修改数为 0，未核再分发授权前本地忽略 |
| 2026-10-27 | PL 回传设计 | 当前包快照加等待队列、满时丢新包、同拍出入队允许接纳、等待最终 TX done | 默认整包；ACK 参数互斥，不更改输入协议；不猜外部复位脚 | `rtl/return_controller.v`、`docs/stage3_design.md` | 实现并自检 |
| 2026-10-27 | 集成 TB 纠错 | 完整十字节需足够排空时间；显式 16 位激励避免 XSim task 负值表达式出现 X | 定位 TB 激励与等待错误，未更改既有 UART/解析器或放宽评分 | `sim/tb/stage3_serial_case.v`、`report/stage3_validation.md` | 最终双仿真器重跑通过 |
| 2026-10-27 | 第三阶段 FPGA 检查 | 复位、回传控制、核心、顶层分别自检 | ModelSim 2020.4 与 XSim 2020.2 四项均通过，checks 为 124/78/255/272，errors=0 | `sim/run_stage3.ps1`、`build/*_stage3/` | 仿真通过，未综合/板测 |
| 2026-10-27 | PC 记录与交叉验收 | 保存原始字节/CSV/JSON，独立解析并比对仿真期望 | 7 项自检通过；两仿真器各整包 24/ACK 24，字节一致；故意跳号/重复保留诊断 | `host/`、`build/pc_stage3/run_20261027_203935_323867/` | 离线通过，pyserial 未安装、未开串口 |
| 2026-10-27 | 固件测试与编译 | 模拟依赖验证应用，再使用实际库全量重建 | 全 65536 个补码编码值、错误恢复及 C/Python 32 包对照通过；Keil 两目标 0 错误/0 警告 | `stm32/test_portable.ps1`、`stm32/build_keil.ps1`、`build/stm32/` | 编译链接通过，未运行硬件 |
| 2026-10-27 | 证据与下一步 | 中文操作指南和第三阶段记录；待用户评审后决定第四阶段 | 不把模拟数据当作原始传感器日志；继续暂缓实物检查/烧录，不进入 FIR/PS | `docs/stage3_test_guide.md`、`docs/next_task.md`、`report/stage3_validation.md` | 第三阶段软件交付，实物验收待授权 |
| 2026-10-28 | STM32 板型资料与引脚适配 | 读取五份核心板/扩展板资料，图文交叉核查；将 MPU6050 改接通讯接口 2 的 I2C2/PB10/PB11，为 OLED 保留 PB6/PB7；保留 PA9 TX | 用户要求按实际板型调整程序；新接线是本轮选定方案，不假定用户已这样插线；文档内下载建议不作为授权 | `docs/stm32_board_review.md`、`stm32/config/board_pinmap.h`、`docs/hardware_pinmap.md` | 图纸确认，未实测/上板 |
| 2026-10-28 | 晶振与接口复用核查 | Y1 标称 8 MHz，与既有 HSE_VALUE 一致；确认 PA9 与 USB 桥 RXD 默认跳帽路径、VCC4 可选电压 | 保留时钟配置；不改 BOOT/SWD/烧录设置；记录 USB 桥型号文字差异，不猜实际芯片 | 核心板原理图 PDF 第 4/5/6 页、扩展板第 3/4 页及核查记录 | 供电跳帽、频率和插线仍未验证 |
| 2026-10-28 | 引脚修改后的回归 | 通用 I2C 驱动及调用/Keil 路径同步更新，避免名称仍误导为 I2C1 | 可移植 C 测试和 32 包 C/Python 对照通过；11:34:50/11:34:52 两目标全量重建 0 错误/0 警告 | `stm32/test_portable.ps1`、`stm32/build_keil.ps1`、`build/stm32/*/keil_build.log` | 软件检查通过，未改 FPGA 或协议，未重复 FPGA 仿真 |
| 2026-10-28 | FPGA 正式约束授权 | 结合新规格书、原理图与呼吸灯示例，完成三个端口的正式约束 | 用户说明实板与原理图一致；采用现有工程 xc7z010clg400-1；U18/K14/M15，50 MHz/LVCMOS33；当前无复位/LED 端口，不照搬 N16/J16 | `constr/top.xdc`、`docs/fpga_constraints.md` | XDC 完成，UART2 与板载 USB/UART3 区别已说明 |
| 2026-10-28 | 异步 UART 时序 | 实现阶段精确切断输入到第一级同步 D，保留两级之间时序；不虚构同步 IO 延迟 | 不修改已通过测试的 RTL；ASYNC_REG/两级路径由实际工具检查 | `constr/uart_rx_cdc.xdc`、`build/fpga_constraints_check/cdc.rpt`、`rx_sync_timing.rpt` | CDC-3 Info，第二级路径仍受时序约束 |
| 2026-10-28 | 约束检查脚本纠错 | XDC 不支持 if/unset 检查，布尔属性不能限定为字符串 TRUE | 检查移到 Tcl，XDC 保留受支持命令；首次失败不算通过 | `scripts/check_fpga_constraints.tcl`、`docs/fpga_constraints.md` | 修正后全流程重跑通过 |
| 2026-10-28 | 首次 PL 实现检查 | 隔离目录进行综合、优化、布局、布线、IO/CDC/DRC/时序检查，不操作原缓存 | Vivado 2020.2 在 15:50:57 完成；WNS=12.708 ns、WHS=0.037 ns、内部未约束端点=0；251 LUT/314 FF | `scripts/check_fpga_constraints.ps1`、`build/fpga_constraints_check/` | 当前配置实现检查通过，DRC 仍有 ZPS7-1 Warning；无比特流/板测 |
| 2026-10-28 | 项目引用和边界 | 本地 XPR 约束列表改为正式 XDC 与实现专用 CDC 文件，保留 PS7 提示 | 不加 PS7、不屏蔽 DRC、不修改协议/RTL/下载设置；源 PDF 和 RTL 哈希保持一致 | `vivado_project/zynq_vibration_monitor.xpr`、`docs/fpga_constraints.md` | 软件引脚约束完成，PS7 配置警告留待比特流/上板前评估 |
| 2026-10-28 | 当前接线指南 | 按原理图和当前代码生成逐针说明：两板 PA9→UART2_RX 加共地，FPGA TX→外置串口 RXD；附传感器 I2C2、P1 隔离及 VCC4 选择 | 用户要求生成文档；再次读取核心板/扩展板/传感器原理图并核对页面图像；不把文档内接线流程当作当前操作授权 | `docs/wiring_guide.md`、README 导航；UTF-8、链接和空白检查 | 仅文档，未改程序/约束，未接线/烧录/板测，未重复构建 |
| 2026-10-28 | 逻辑分析仪测试方法 | 读取用户 DL32/DL32 Plus 参数 PDF；建议先四路/20 MS/s/1.6V，分固定 UART、FPGA 对照、I2C 身份及六字节采集检查 | 依据真实源码说明 8.68 us 位时间、固定包、地址七位/八位显示、末字节 NACK、约 200 ms 初始化与停止位中点回传；未将预期写成实测 | `docs/logic_analyzer_guide.md`、仪器规格第 2 页、原理图与当前源码 | 操作说明完成；型号/软件/探头针序未猜测，未实际采集、未下载，未改代码/约束 |
| 2026-10-29 | 用户确认 DL16 并修订方案 | 按型号差异 XLSX 和 ATK-Logic V1.5 手册修正为 DL16/USB2.0/250 MS/s Buffer/1 Gbit/20 针 2.54 mm/两路 PWM，移除 Roll 与串行高级触发建议 | 保留适用的四路20 MS/s、1.6V和探测点；补充 ATK-Logic 菜单、正常/循环/立即区别，启动事务改用2秒立即采集以免预采样或提前触发漏采；原始 BIN 不等于 UART 字节 | `docs/logic_analyzer_guide.md`；差异表“产品差异”B6:D14及合并区域；手册 PDF 第5/6/19～30/34～36/40/41页 | 资料核查与文档更正；原文件未修改，未实际操作仪器/采集波形，未改固件/RTL/约束 |
| 2026-10-29 | 中途测试的 COM2 跳帽与电脑连线核查 | 确认共地/PA9→K14方向正确；若为底板P1的COM2跳帽，断电断开以避免SP3232 ROUT1与PA9共同驱动RX；区分JTAG/DAP、DL16和USB-TTL串口用途 | 用户描述已在接线测试，实物跳帽位置尚无照片；按原理图确认路径，未把描述当成供电/下载/通信已通过的证据 | `docs/hardware/zynq_baseboard_v3_9.pdf`第1/5页、核心板第3/12页；`docs/wiring_guide.md`、project_context更新 | 说明与文档修订，未改代码/约束、未操作硬件、未重复构建 |
| 2026-10-29 | STM32 固定包首次用户截图核查 | 逐包人工转录并用独立PC解码器检查：SEQ 9A～9D、三轴1/-1/-32768、CHK 1B/1A/1D/1C 全部符合 FixedSource | 用户提供四张实际采集截图；原图不作改动保留，截图内容与用户提供的实测来源分开说明，不能替代完整时序/长期/FPGA/传感器验收 | `report/stm32_fixed_uart_validation.md`、`report/evidence/stm32_fixed_uart_20261029_*.png`；转录字节 decode 四项通过 | 四包内容初步通过；建议补4ms/位宽测量、固定包FPGA回传、再测I2C与SensorSource；未改代码或操作硬件 |
| 2026-10-29 | FixedSource 时序与 D1 活动截图 | 8.7 us 单个位宽符合 115200；17.4 us 为两位交替周期；包起点标签相差 3.99305 ms；3.13365 ms 高电平不能当作包周期，318.24 Hz 不能当作包频率 | 独立算术核查，偏差 -6.95 us/-0.174%；不归因于 50 ns 采样间隔；D1 测点来自用户描述，延后波形尚缺清晰逐包解码，SensorSource 未测 | `report/stm32_fixed_uart_validation.md` 文末、`report/evidence/stm32_fixed_uart_timing_20261029_*.png`；截图原样保留并核对复制哈希 | 时序初步符合预期，待同次 D0/D1 解码及多周期检查；未修改程序/约束、未操作硬件或重新构建 |
| 2026-10-29 | FixedSource 双通道整包回传截图核查 | D0/D1 两组十字节分别完全一致，SEQ CB/CC、三轴1/-1/-32768、CHK 4A/4D；人工转录后 Python 逐字节比较和独立 decode 四项均通过 | 测点沿用用户描述；所示两组基本回传功能板测通过，用户另报告其他包相同；不扩展为长期统计或 SensorSource 验收 | `report/stm32_fixed_uart_validation.md`、`report/evidence/fpga_fixed_return_20261029_01.png`、`02.png`；原图复制一致性及 SHA256 检查 | 固定数据基本闭环已获截图支持；下一步较长记录及 I2C/真实三轴对照；未修改程序/约束，未操作硬件或重复仿真/构建 |
| 2026-10-30 | SensorSource 已有记录的电脑核查 | 用户授权通过 computer-use 技能查看 ATK-Logic；保存50ms/20MS/s/1.5V已有波形，导出D0/D1/I2C协议CSV，独立脚本核对12组三路一致、XOR/序号和37笔完整I2C事务ACK | 实际执行分析，通信通过；D0边界截断解释D1多一个EC包，末尾I2C截断不计完整事务；未启动采集、复位或烧录 | `report/sensor_source_validation_20261030.md`、原始atkdl、三CSV、分析脚本与JSON；归档CRC与SHA256 | 50ms通信闭环通过，不能推广长期零丢包或初始化通过 |
| 2026-10-30 | 静止量值与周期边界纠正 | 用户明确完全静止平放，12组合成计数均值21961.82；按源码预期1C=00及模块手册第7页16384LSB/g为约1.34044g；一段2.99475ms，其余十段接近4ms | 不因传输正确认定测量正常；实际配置回读未捕获，偏置/比例/配置等根因未定，不直接改Z补偿；补初始化及正反静止记录 | 本轮报告、模块手册第7页图文核查；`docs/project_context.md`、`docs/next_task.md`、分析仪指南 | 传感器量值验收未通过，周期长期验收待补；未修改固件/RTL/XDC或重复构建 |
| 2026-10-30 | Z朝下静止记录及正反对照 | 用户授权操作ATK，确认仅翻转未改程序配置；保存另一50ms工程和三CSV，独立脚本核对12个完整包66～71的I2C/D0/D1一致、XOR/序号正确，38笔完整I2C应答正确 | D1在80.95us有前缀停止位警告，保留边界记录，不宣称全记录零错误；完整包间隔均值4.00010ms | `report/sensor_zdown_validation_20261030.md`、原始atkdl/CSV、`analyze_sensor_zdown_20261030.py`和JSON；归档CRC与哈希通过 | 所示完整通信链路通过，未新增采集/复位/烧录，未改固件/RTL/XDC |
| 2026-10-30 | Z轴偏置假设细化 | 正反Z均值+21952.67/-11375.83，中点+5288.42，半差16664.25计数/g；与标称16384较接近，支持较大加性偏置 | 仅为近似正反姿态和配置相同下的初估；每次12组，姿态/实际配置未完全验证，不认定模块损坏、不直接写入补偿 | 本次JSON与正反报告，前次原始证据保持不变；更新上下文和后续任务 | 先补初始化回读，再六面较长记录/重复验证；传感器量值尚未验收通过 |
| 2026-10-30 | 第四阶段授权和范围 | 用户接受第三阶段基本通信成果并允许偏差后续处理，授权第四阶段，确认暂按250Hz、5～30Hz保真及50Hz以上抑制设计 | 三轴去直流+63抽头定点低通；保留原始包，内部18位结果不静默覆盖原始字段；不把暂缓校准写成通过 | `docs/stage4_design.md`、`docs/stage4_test_plan.md` | 按AGENTS先完成具体设计和数值参考，待方案确认再编写主要新RTL |
| 2026-10-30 | 第四阶段数值设计实际执行 | NumPy2.3.5，自生成窗函数系数；无界整数点积与独立卷积、浮点基线对照，18组41728样本通过，另查舍入/饱和/累加界限 | 级联通带-0.107～+0.156dB，阻带最差-58.951dB；当前最大误差0.9325计数；41位累加/18位输出覆盖界限；群延迟124ms | `host/stage4_reference.py`、`data/reference/stage4/`、`report/stage4_design_validation.md`及JSON快照 | 仅数值检查通过，无新RTL/TB、无ModelSim/XSim/综合/板测；未改STM32、现有RTL/XDC/烧录配置 |
| 2026-10-30 | 系数文件证据检查纠错 | Windows文本模式将LF改为CRLF，首次磁盘系数SHA256核查失败；改为固定LF字节写入，系数整数与频响不变 | 修正后重跑完整数值检查及文件哈希验证，不沿用首次文件检查结论 | `host/stage4_reference.py`、第四阶段数值验证记录 | 磁盘系数与记录哈希最终一致；与RTL或硬件测试无关 |
| 2026-10-31 | 第四阶段实现授权和工作方式 | 用户明确批准继续编写RTL/TB，要求每阶段完成后自行仿真，最终阶段统一上板联调 | 实现三轴去直流/63抽头FIR/调度及通信适配；未改既有原始通信、板级top、STM32、XDC或烧录设置 | 四个新增RTL、TB和 `docs/stage4_test_guide.md` | 主要方案已批准，常规自检自动运行；未把去直流当传感器校准 |
| 2026-10-31 | 双仿真器及数值实际执行 | ModelSim2020.4与XSim2020.2四项均通过，最终checks 98192/8222769/1604429/2490721，errors=0；41728单轴、4000三轴、600正常串口包及九处截断/错误恢复 | RTL逐样本导出与独立Python相同；另测频率、正负半单位、窄输出饱和、保持请求、SEQ回绕/跳变/断流和复位；两个参数负向用例均被拒绝 | `report/stage4_validation.md/.json`、`build/*_stage4/`；全流程及集成最终针对性回归日志 | 第四阶段软件验收通过，未上板 |
| 2026-10-31 | 执行环境和脚本纠错 | 受限环境ModelSim DLL重定位/XSim子编译失败，获准常规进程正常；xvlog不接受+incdir，改-i | 不改Windows安全/工具/许可；首次失败不算仿真通过；修正后双工具重跑 | `sim/run_stage4.ps1`、实际执行日志 | 常规环境执行成功；不是仿真器不可用或用户程序错误 |
| 2026-10-31 | 隔离实现及接口边界纠正 | 首次虚构0ns端口预算出现输入保持-0.502ns；按原定OOC内部范围移除无父级依据的端口预算，严格20ns检查全部内部寄存器，无false_path | 最终内部setup9.198ns/hold0.117ns，2282LUT/3901FF/3DSP/0BRAM；0未约束内部端点，端口/父级时钟仍待集成，DRC 3条DPOP-1+1条ZPS7-1 Warning | `scripts/check_stage4_synthesis.*`、`build/stage4_synthesis/`；首次报告另存 | 内部时序检查通过，不能宣称整体板级签核或零警告 |
| 2026-10-31 | 第五阶段方案与授权 | 先完成128样本MS/峰值/整数RMS及2000/1500两窗滞回具体设计，用户明确确认四个RTL及自动双工具仿真 | 仅PL，内部signed18输入/unsigned35MS/unsigned18RMS与峰值，保持原始十字节与板级top | `docs/stage5_design.md`、`stage5_test_plan.md`、用户确认 | 方案已获批准；演示阈值不是实物故障门槛 |
| 2026-10-31 | 第五阶段数值和RTL实现 | Python无界整数/math.isqrt参考，新增isqrt_u36/window_features/threshold_alarm/feature_monitor_core及各自自检 | 根18拍、窗口末样本22拍；完整精度平方累加，最负输入绝对值正确，缺包/断流清窗使alarm_valid失效 | `host/stage5_reference.py`、`stage5_vectors.py`、四RTL/TB及数值/实现报告 | 数值与RTL证据分开，去直流不代表传感器校准 |
| 2026-10-31 | 第五阶段双仿真器实际执行 | ModelSim/XSim四项最终checks231556/131447/10365/94715，均0错误；10033开方、109窗口、5008报警拍、2200原始回传包及默认参数冒烟 | 正常/边界/错误/恢复，九处截断，质量标志及发布边界注入；全部在途窗口位置clear/rst/过载；两工具实际导出逐项一致；八非法参数均被拒绝 | `report/stage5_validation.md/.json`、`build/stage5_full_run.log`、`stage5_window_final.log`、各工具输出 | 第五阶段软件验收通过，无上板；主UART仿真压缩50倍，不声称实物采样通过 |
| 2026-10-31 | 第五阶段测试与编辑纠错 | 初稿217拍漏算进入滤波1拍，改为218拍/4.36us；复位后首包需既有UART高电平等待，TB加20拍空闲 | 未改旧UART/滤波；未用输出标注规则一度跨模块误添加端口，修正后完整双工具重跑；首次失败不算通过 | 设计、TB、首次诊断日志及最终实际结果 | 边界和证据已纠正，没有放宽20ns目标或改变协议 |
| 2026-10-31 | 第五阶段完整内部核心隔离实现 | Vivado2020.2 OOC实际综合/布局/布线，3205LUT/5894FF/6DSP/0BRAM/0锁存，20ns内部setup9.063ns/hold0.088ns | 0未约束内部端点；保留3DPOP-1+3DPOP-2+1RTSTAT-10+1ZPS7-1 Warning，父级时钟及2输入/846输出接口未签核 | `scripts/check_stage5_synthesis.*`、`build/stage5_synthesis/`及验收报告 | 内部实现通过，非板级签核；未改本地工程/约束/下载设置，最终阶段统一上板 |
| 2026-10-31 | 原分期持久化与第六阶段批准 | 用户补充原计划截图：六为系统联调与量化，七为回归/修复/交付；转录计划并归档原图，明确最终阶段统一上板 | 具体设计先形成，用户确认十字节滤波尺度4、独立顶层、双工具和两模式完整实现 | `docs/stage_plan.md`、`stage6_design.md`、原图及用户确认 | 避免压缩后将第六阶段误解为上位机阶段；实测未执行 |
| 2026-10-31 | 第六阶段完整链路与回传 | 新增return_source_select/system_monitor_core/system_top，复用已有全计算支路并用单一新发送队列输出；原始直传或滤波signed18右移2位，PC乘4 | 全262144输入转换与独立参考正确；内部18位MS/RMS/报警不受传输缩放影响；包内无模式位，必须保存元数据 | 三RTL/配套TB、host/stage6_reference.py、stage6_vectors.py及设计 | 原前五阶段RTL和输入协议、STM32、旧top/XDC/工程未改 |
| 2026-10-31 | 第六阶段双工具实际执行 | ModelSim/XSim各5项最终checks786437/561050/277/78/171，均0错误；两模式各5632包/40窗，X/Y/Z隔离，默认参数坏包恢复，九处截断/SEQ/断流/复位 | 暂停256样本接纳在途1+等待4、丢弃251，计算继续；复位丢弃积压及在途结果；两非法模式均拒绝；原队列/解析器定向回归通过 | `build/stage6_final_run.log`、`report/stage6_validation.md/.json`和归档 | 软件通过，主通道约43.4倍压缩，另用真实50MHz/115200独立顶层验证，不称实测 |
| 2026-10-31 | 第六阶段量化与证据 | 实际RTL量化10/30/60Hz为+0.083199/+0.153248/-61.650538dB，线缆还原误差0～3；首位4/198拍、特征218拍 | 实际默认包内字节无空隙，整包43400拍/868us，包起点200000拍/4ms；坏包跨越后400000拍；CSV/二进制/时间戳跨工具哈希一致 | `report/evidence/stage6/`、`stage6_quantification.csv`、check_stage6_captures.py及JSON | 合成输入，非传感器实测；记录工具显式尺度、拒绝覆盖，physical_test_pass保持null |
| 2026-10-31 | 板级优化问题及实际纠正 | 原始回传模式仅网络MARK_DEBUG/KEEP导致计算支路被opt_design删除，检测失败；网络DONT_TOUCH亦不足，网表显示无实际保留寄存器 | 改为427位明确保留的调试快照真实负载，不参与功能反馈；重新通过全计算分支及唯一UART TX检查，未放宽检查 | 初次261LUT/371FF/0DSP证据归档；最终system_top及implementation脚本/报告 | 最终快照开销计入资源，不用残留通信小网表冒充完整链路；未插ILA |
| 2026-10-31 | 第六阶段完整双模式板级实现 | 原始3401LUT/6101FF，滤波3324LUT/6091FF，均6DSP/0BRAM/0锁存；20ns内部setup5.205/8.300ns，hold0.037/0.028ns | 0未约束内部端点；CDC-3 Info深度2，第二级仍计时；每模式3DPOP-1+3DPOP-2+1RTSTAT-10+1ZPS7-1 Warning，保留异步UART IO提示 | `build/stage6_implementation_verified.log`、归档资源/时序/CDC/DRC、源码快照 | 实现检查通过，未生成比特流或上板；第七阶段仍需全回归/冻结/最终重建和实物演示 |
| 2026-10-31 | 第六阶段编码和计数纠错 | 新包装层输出改wire以满足Verilog模块驱动约束；长序列激励修正一拍并新增严格4608拍周期断言 | 未修改既有正确模块；最终双工具全套重跑；第四/五阶段39项源哈希保持不变 | 最终日志、源码哈希和UTF-8/BOM/链接检查 | 首次编译/计数/优化失败不算通过证据 |
| 2026-10-31 | 最终回归和完整性核对 | 按原第七阶段执行所有阶段及旧失败边界，核对已知要求，不把新版未板测或未知比赛条款写成全部满足 | 用户要求最后收尾和完整上板方案；18RTL/19TB，双工具42阶段运行/24负向拒绝、PC11/C65536值和32向量/Keil双目标实际通过 | `report/stage7_validation.md/.json`、`requirements_audit.md`、最终回归日志 | 软件候选完成，整体实物与校准仍待验收 |
| 2026-10-31 | 最终三版与观测入口 | 从同一功能源码重建raw/filtered/ILA，生成bit/ltx；ILA21组427位，PL50MHz，避免要求新增引脚或PS | 三版setup5.205/8.300/5.432ns、hold0.037/0.028/0.014ns，debug6695LUT/11520FF/12BRAM；各8项DRC Warning，非零警告 | `scripts/build_release.*`、`build/stage7_release/`及最终日志 | 只构建、未连接JTAG/COM或下载；ILA尚未板上触发 |
| 2026-10-31 | 工具包装和ILA纠错 | PowerShell5.1把unittest正常stderr当异常，改为收集stderr且严格检查退出码；开启采集条件的ILA比较单元1不合法，改2 | 初次失败不算通过；修正后全部回归和三个发布变体均重新执行成功 | 首次与最终日志、回归脚本和发布脚本 | 未改正确功能RTL、不放宽时序或屏蔽DRC |
| 2026-10-31 | 可重复板测与技能 | 复核实际PDF接线/DL16参数，提供B01～B12、下载及ILA观察、受控数字频率/报警路径；补项目技能、NumPy依赖 | 回放只用假设备测试短写/无突发补发/失败中止/旧记录保护；技能quick_validate通过，PyYAML仅本地build工具目录 | `docs/board_test_plan.md`、`host/board_test.py`、`host/test_board_tools.py`、`skill/fir-validation/` | 方案不是实测；无受控源时不把手摇当频响标准 |
| 2026-10-31 | 冻结与交付 | v1.0-rc1候选、源码ZIP与SHA256、三FPGA版、两STM32 AXF/HEX和数字fixtures；拒绝覆盖冻结同版 | HEX4748/4196数据字节，校验/EOF/Flash范围通过；保留本地Libraries依赖与厂商资料授权边界 | `scripts/package_release.py`、源码/发布清单、交付包 | 未推送或发布，板测修复须另建候选版本 |
| 2026-10-31 | 第七阶段中断前计划复核与补交 | 逐项核对原计划，确认软件回归/最终构建/冻结已完成，但42份波形及部分构建/首次失败日志未随rc1归档 | 独立补交证据包，不改rc1目录或功能源码；原计划整机冷启动与完整实物演示仍未执行 | `report/stage7_completion_review.md`、补充包evidence_manifest/review_manifest；波形ZIP CRC与逐文件SHA256通过 | 软件交付遗漏已补齐，整机实物待验收；本条为冻结后工作区日志追加，不属于rc1原源码快照 |
| 2026-10-31 | GUI 展开设计的 CDC 警告定位与修正 | 用户报告12-4739；磁盘工程保存旧top，同时启用新旧CDC，完整系统CDC误用于综合；新增按顶层选择且仅用于实现的配置脚本，附中文操作说明 | 在隔离Vivado2020.2工程实际复现原警告；top/system_top修正后展开均无12-508/12-4739；分别综合后第一级D命中1个，第二级路径仍计时，例外报告保留精确端点 | `scripts/configure_project_cdc.tcl`、`scripts/check_project_cdc.tcl`、`docs/vivado_cdc_warning_fix.md`；`build/project_cdc_check/result.txt`及日志/时序/例外报告 | 未改用户打开的xpr、RTL、原XDC内容或冻结发布包，待用户在GUI执行配置；未布局布线或上板；脚本初稿使用不支持的USED_IN_SIMULATION属性失败，移除后完整重跑通过，首次失败不算通过证据 |
| 2026-10-31 | GUI FIR 系数资源遗漏修正 | 用户继续报告Synth8-4445；原63项18位系数存在可读，GUI工程未登记；上次CDC检查复制系数到工作目录掩盖了资源缺失，明确承认覆盖范围遗漏 | 更新配置脚本，在system_top下登记原系数为Memory File，检查格式/可读性/同名冲突并支持重复执行；独立持久工程先复现缺失警告，再不复制系数执行展开及launch_runs synth_1 | `scripts/configure_project_cdc.tcl`、新增`check_project_memory.tcl`、修正说明；`build/project_memory_check/result.txt`、run.log及工程synth_1/runme.log | 实际通过：登记后无8-4445/12-4739，系数仅登记1份，工程综合0警告/0严重警告/0错误，CDC端点命中1个；原系数SHA256 B9B74FB39759CF352D2B388EA15650B0A1522D1F15DD6F4861F622D7B580FC35；未修改RTL/系数/用户xpr/冻结包，GUI需重新执行更新脚本，未布局布线或上板 |
| 2026-10-31 | MPU6050六面采集与校准方案 | 用户报告新链路传输与第三阶段相似并询问校准；复核SensorSource配置回读、原始十字节及前次正反Z短记录，提出六面各20秒、两轮独立数据，先离线估计三轴零偏和比例 | 仅用D0或raw回传；禁止用去直流/FIR结果估计静态零偏；DL16长记录与初始化分开；重力保留、signed16/XOR/SEQ检查、样本波动和重复性验证；0.05g等为建议项目目标，不是器件规格 | 新增`docs/mpu6050_calibration.md`，参考现有源码/实测报告及ADI AN-1057；此前bz约5288.42仍为条件性初估 | 仅形成操作方案并记录建议；未新增采集、计算正式系数、修改固件/RTL/冻结包或宣称校准通过，后续固化需明确原始/校准字段语义并重测 |
| 2026-10-31 | 六面短记录分析与实验校准修正 | 用户补齐X/Y并要求结合旧Z分析修正，确认同一MPU6050，Z来自第三阶段；四份新数据实际仍50ms，合计六面73完整包；零偏初值704.160/-535.333/5288.417，比例1.007626/0.994537/0.983183 | 保存原始证据，逐字节位/起止位/XOR/序号核查及独立流解析通过；六归档CRC通过；xn/旧zp有约3ms周期，横轴残差最高0.137g，配置跨阶段一致性及长记录独立验证仍未完成 | 新增校准分析脚本、定点模块/参数、独立SensorCalibratedTrial工程与C/Python测试，修改acquisition编译期开关和Keil构建入口；完整报告`report/mpu6050_calibration_analysis_20261031.md/.json` | 三轴196608输入、65536C包与有理数参考一致，较理想浮点最多差1计数，错误/恢复/饱和/固定源绕过通过；原可移植C及三个Keil目标均通过，HEX4808字节校验/Flash范围通过；formal_calibration_pass=false，未烧录、未改RTL/原始工程/冻结包，原SensorSource仍是raw，实验目标D0已校准不能再次当raw拟合 |
| 2026-10-31 | 对照早期实施对话复核项目缺口 | 用户提供FPGA学习项目建议链接；read_thread实际返回5轮且无更早游标，核对硬件/流程/Git/复现/Skill建议，不把旧助手口述当正式赛事规则 | 核心18RTL/19TB及历史软件证据齐全；新raw观察不证明滤波/特征板测；发现Git只有初始提交和v0.0、大量成果未跟踪，统一回归未覆盖新增校准，无GUI一键建工程/干净检出复现记录，report缓存仍可被提交 | 新增report/reference_conversation_gap_audit_20261031.md；更新final_board_record.md如实记录部分通信/短记录及未验收边界；原理图PDF只读提取和渲染核对旧描述 | 仅文档核对；未修改功能源码/约束/冻结包，未重跑仿真或实现、未操作硬件、未commit/tag/push；正式指南与更早完整方案仍未获得，FFT/PS/GUI不自动升级为本版必选 |
| 2026-10-31 | 用户授权保存并上传当前Git检查点 | 用户明确要求将当前内容上传到git，授权在既有main分支提交并推送origin/main；先fetch核对本地与远端均为初始提交，无分歧 | 待新增约5.3MB源码/文档/选定证据；补齐放行目录后的Python缓存忽略，关闭Git自动换行以保持源码和证据哈希，MEM仍固定LF；原始厂商PDF/Libraries、Vivado工作区和build下载产物继续忽略 | 本次实际提交与远端同步结果由Git历史及推送后远端OID核查记录证明；未操作硬件、未改功能代码或冻结包，不因上传而将实验校准和板测标为通过 | 这是当前进度检查点，包含实验校准状态与剩余验收清单；不新增正式发布标签，也不执行强制推送 |

| 2026-11-01 | 旧对话追溯与新对话接续 | 用户要求在卡死旧对话中追溯并充分理解项目；通过read_thread六批读取可返回46轮，到开头hasMore=false，核对当前设计/状态/关键源码和历史证据 | 区分七阶段软件候选完成、历史基本通信、正式校准及完整板测待验收；Git已保存到4714435，旧报告未提交结论过时；raw/filtered尺度、内部特征、实验校准与rc1边界保留 | 新增report/progress_handoff_20261101.md；实际只读核验rc1源码ZIP177项、发布载荷97项、实验校准源码12项/固件2项/证据13项SHA256全部匹配；当前原177项中8项为冻结后变化 | 未重新仿真/实现/Keil或操作硬件，不把历史PASS称为本轮重跑；旧附件未逐张重审，未重做引脚/供电签核，补充波形大ZIP未重新全检；正式校准false，统一回归仍未含实验校准，完整板测和干净复现待做，原冻结包未修改 |
| 2026-11-01 | 下一步实物操作顺序说明 | 用户要求根据现有文档详细说明下一步；读取校准方案、上板方案、引脚文档和初始化/分析源码，重新提取并查看底板第1/5页、核心连接器第12页、模块原理图及F盘扩展板第3/4页 | 采用专用校准文档每面20秒两轮，另建session目录保留旧50ms数据；先版本确认与原始链路，再初始化实测回读、预热、12份六面原始记录和60秒时序，之后离线独立验证、滤波/ILA/恢复与冻结 | 图纸可读并已查看，实物接线/供电未测；现有calibrate_mpu6050.py为旧文件映射且formal_calibration_pass固定false，后续须适配新输入和独立第二轮，不将旧脚本成功当正式验收 | 只读资料和生成build/next_steps_review_20261101核对页面、追加本日志；未改功能代码/约束/冻结包，未仿真/编译/下载/重新采集；初始化先做一份、长记录先验证一份真实时长再批量采集，避免再次采成50ms |
| 2026-11-01 | GUI ILA首屏设置说明 | 用户提供Set Up Debug首屏，所示debug网络、clk_IBUF_BUFG时钟域及427位与system_top调试快照相符；未看到滚动区域全部信号，不据截图宣布完整配置通过 | 建议保留全部观测总线Data and Trigger，检查隐藏的feature_valid/quality_valid/alarm_valid/window_id等；按既有构建参数1024深度、0输入流水、Capture control启用、Advanced trigger关闭，比较单元如可设则2 | 核对scripts/build_release.tcl及probe_map.tsv，查阅AMD UG908 2020.2向导和2021.1属性说明；GUI自动probe顺序可能不同，手工新bit必须配本次ltx且不混用rc1 | 仅提供操作说明和追加日志，未操作Vivado或硬件、未创建调试核/重建/下载；ILA不改变RETURN_FILTERED，默认raw不自动成为filtered；1024点50MHz连续捕获仅20.48us，窗口事件用feature_valid触发 |
| 2026-11-01 | session01初始化与Z朝上20秒分析 | 用户提供四份采集并确认原SensorSource、固定静止且Z正向朝上，中途复位一次；原文件只读哈希前后相同、ZIP CRC通过，实际20MS/s/20s/Buffer/RLE/1.5V四路 | 读75=68及6B/1A/19/1C/38=01/02/03/00/01通过；14763完整I2C事务ACK检查通过，4931完整包I2C-D0-D1一致；复位间断320.779ms，前264/后4667包，末尾多一笔I2C对应D0半包边界保留 | 新增独立分析脚本、JSON/帧CSV及session01_initialization_zup_20261101.md，更新next_task和板测表；实际命令为运行时python.exe -X utf8 report/evidence/analyze_session_20261101.py，最终退出0；首次时间标签容限过严失败修正，绘图缺matplotlib已移除未交付图 | 复位后去首秒4415包，均值675.672/-653.086/21979.931，合成1.342788g；35个约3ms间隔约每0.5秒重复，平均250.500包/s；轮询相位关系仅假设，正式校准false；未仿真/构建/下载/硬件操作或改RTL/约束/原始数据，不拼接复位前后作为正式20秒姿态样本 |
| 2026-11-01 | 无复位Z正反与60秒分析 | 用户提供60s/noreset_zp/noreset_zn三目录，并确认60秒全程固定静止未主动触碰；三归档CRC与12输入文件前后SHA256通过，实际60/20/20秒 | 15030/5010/5009个D0完整包连续；60秒15030与正面5010组三路内容核对通过，可比D0-D1全相同；正面左边界停止位警告及首尾不完整包保留；负面I2C CSV与D0哈希完全相同，判误导出不冒充I2C验证 | 新增analyze_noreset_20261101.py、结果JSON/帧CSV及noreset_zpair_60s_20261101.md；原分析i2c函数增加可选文件名默认不变；运行时python.exe -X utf8 report/evidence/analyze_noreset_20261101.py实际退出0，另对配对/边界/原始哈希断言核查通过 | 新bz5217.627726/Sz16751.809/kz0.978043625仅初值，未写固件；60秒120次约3ms间隔每约0.502秒重复，250.503包/s；Z瞬态13704～30258且用户未触碰，三路一致，根因未定，完整样本保留；formal_calibration_pass=false，未改RTL/约束/固件/冻结包、未仿真或操作硬件 |
| 2026-11-01 | Z朝下I2C补导出复核 | 用户替换原误导出的I2C CSV；当前为I2C Bits/Address/data/Packets，SHA256=219fefb8422d85a041c9db5d136d8fc203442b9237e4b96274bae74c39586dc8，另外三输入指纹与首次分析相同 | 14991完整I2C事务ACK正确，3A9981/3B5010；5009完整包I2C-D0-D1全一致，无内部配对失败；末笔读取结束19.9999105s，对应末尾截断A5，不当丢包；原首边界额外D1仍单列 | 复用分析器只重跑noreset_zn并另存20261101_noreset_analysis/zn_i2c_recheck，保留首次误导出JSON；Python脚本实际退出0、PASS zn_i2c_recheck；更新分析报告、next_task和板测表撤销I2C待补状态 | 未改固件/RTL/约束或操作硬件；均值、Z两点初值、39次约3ms间隔和formal_calibration_pass=false不变；本轮核验新输入未被分析修改，不声称其与用户补导出前哈希相同 |
| 2026-11-01 | 第一轮六面长记录分析完成 | 用户补齐noreset_xp/xn/yp/yn并确认同模块、原SensorSource固件配置未改且静止采集；重读含正确I2C的六面，6归档CRC及24输入前后SHA256通过 | 四新面各5010完整D0包，六面共30059；所有可比I2C-D0-D1一致，无内部配对/SEQ缺口；首尾截断与旧zp起点警告保留；新四份各39个约3ms间隔 | 新增analyze_sixface_20261101.py、独立JSON/原始帧和校正CSV、sixface_r1_analysis_20261101.md，更新下一步/校准说明/板测表；运行时python.exe -X utf8 report/evidence/analyze_sixface_20261101.py实际退出0，精确有理数/浮点均值及输入哈希断言通过 | 新b727.653493/-552.006188/5217.627726，k1.004642976/0.994565297/0.978043625；同批最大横轴均值残差0.049664g、合成均值1.000146～1.002082g；xp/yn静止瞬态、xn横轴缓变及周期问题保留；主轴±1g系拟合非独立验收，r2待采，formal_calibration_pass=false；未改旧实验参数/固件/RTL/约束/rc1或操作硬件 |
| 2026-11-01 | 第二轮固定参数独立验证与重复采样识别 | 用户提供六个r2目录；实际读取第一轮精确参数且SHA256前后不变，6归档CRC及24输入哈希通过；发现yp_r2与xn_r2三CSV分别相同，进一步逐通道核对原始bin，四路也相同，不是仅CSV误导出 | 五有效姿态各5010完整D0，可比三路全一致，首尾截断单列；固定r1后yn/zp满足建议均值指标，xp/xn/zn非主轴残差约0.059～0.084g未满足；yp无效重复不作Y朝上验收，Y重复性设null，X/Z偏置差-30.588/+45.551计数、灵敏度差-0.2635/-0.2020% | 新增analyze_sixface_r2_20261101.py、各姿态JSON/原始与校正CSV、r2_validation.json和sixface_r2_validation_20261101.md；运行时python.exe -X utf8 report/evidence/analyze_sixface_r2_20261101.py实际退出0，另对重复/门控/原始与r1哈希断言通过；更新下一步/校准说明/板测表 | 没有用r2拟合参数替换验证参数；先补真正yp，再加强支撑针对xp/xn/zn复核，不覆盖现有失败记录；周期3ms和旧60秒瞬态未解决，formal_calibration_pass=false；未改固件/RTL/约束/rc1或操作硬件 |
| 2026-11-01 | 补采r2b与新yp固定参数复核 | 用户替换重复yp并在原目录新增xp/xn/zn_r2b；显式后缀映射选24份分析、核验目录内36文件哈希及6波形CRC，第一轮精确参数SHA256不变，新yp四文件均不同于旧重复输入 | 可比三路全一致，无内部SEQ/XOR/配对问题，首尾单列；xp/xn/zn_r2b及原yn/zp均满足建议均值指标；新yp仍有Z均值+0.091213g超0.05g，非重复保存问题，不能靠重拟合r2通过 | 新增analyze_sixface_r2b_20261101.py、原r2分析器增加默认不变的可选后缀映射，独立输出20261101_sixface_r2b_analysis及sixface_r2b_validation_20261101.md；实际运行时python.exe -X utf8 report/evidence/analyze_sixface_r2b_20261101.py退出0，哈希/来源/重复性断言通过 | 三轴两轮偏置差+8.932/-24.208/+17.173计数、灵敏度差-0.00417/-0.19546/-0.03263%，满足建议；若yp残差全为倾斜对应约5.23度仅条件性推断；只针对yp姿态复测，不全部重采，不改r1参数/固件/RTL/约束/rc1或硬件，formal_calibration_pass=false；3ms和旧60秒瞬态待查，旧重复yp原文件系用户删除，本轮保留历史报告 |
| 2026-11-01 | 新yp_r2b及六面离线静态指标通过 | 用户新增同目录yp_r2b，显式选xp/xn/yp/zn_r2b及原yn/zp_r2，固定第一轮精确参数复核；6归档CRC及目录内40文件哈希前后通过，r1参数SHA256未变 | 新yp5010完整D0、5010组三路输入对照，5009可比回传相同、末包边界截断；校正均值-0.026069/+1.000052/+0.027492g，合成均值1.000789g，六面静态均值目标全部满足；两轮偏置差+8.932/+4.423/+17.173计数，灵敏度差-0.00417/-0.02166/-0.03263%均满足 | 新增analyze_sixface_r2b_complete_20261101.py和独立结果、sixface_static_pass_20261101.md，更新下一步/校准说明/板测表；实际运行时python.exe -X utf8 report/evidence/analyze_sixface_r2b_complete_20261101.py退出0，随后finalize_summary与条件/哈希断言实际通过，标记OFFLINE_STATIC_PROJECT_CRITERIA_PASS | offline_static_validation_pass=true；保留新固件板测false及总体formal标记边界，不将脚本保守false误写为离线数据失败；新yp仍39次3ms与2个主轴短时偏离，样本保留，旧60秒瞬态待查；不再为凑均值重采六面，下一步新固件实现验证；未改参数头/固件/RTL/约束/原始数据/rc1或执行硬件操作 |
| 2026-11-01 | 用户授权更新六面验证参数并生成新固件 | 用户明确要求按此前测试更新参数，采用已独立静态验证的第一轮精确参数，不重拟合r2；校准ID=sixface_r1_20261101_validated，b_Q16=47687499/-36176278/341942451，k_Q16=65840/65180/64097，来源JSON记录r1/验证指纹 | 更新参数头及校准测试默认分析文件，保留UTF8 BOM；先归档旧头/AXF/HEX再重建；原SensorSource/FixedSource、协议、算法、Keil工程/下载设置、RTL/约束和rc1未改 | 实际196608轴值/65536C包精确参考通过，较理想校正最大差[1,1,1]；错误恢复/饱和/固定源绕过和原可移植65536值/32向量通过；首次Keil旧ArmCC DLL重定位失败日志保留，换执行环境后FixedSource/SensorSource/SensorCalibratedTrial均0错误0警告；实际C映射30059六面样本仍全满足静态均值指标且无饱和，HEX4808字节/EOF/Flash范围通过 | 新report/mpu6050_calibration_params_20261101.json、calibration_firmware_update_20261101.md及evidence/calibration_firmware_20261101证据；新版副本build/stm32_calibration_versions/sixface_r1_20261101_validated，HEX SHA256=895bbfa1f1076716d045b9235c65d62adbddf2c927687b5f0cc3e177c75a41d5；未烧录/板测、未仿真或Vivado，3ms和静止瞬态未修复，统一第七阶段仍未覆盖校准专项，不冒称全项目回归或发布完成 |
| 2026-11-01 | 两个Keil工程功能差异核对 | 用户询问最终下载目标及校准工程是否缺少功能；逐项解析SensorSource与SensorCalibratedTrial的源文件和TargetOption | 编译目标选项差异只有APP_ACCEL_CALIBRATION=1及输出/列表目录；原采集main/acquisition、I2C/MPU6050、USART、时基、组包及标准库共用，校准目标另加accel_calibration.c；未发现省略原SensorSource功能 | 说明当前校准后联调使用vibration_calibration.uvprojx/SensorCalibratedTrial或本次版本HEX；两工程输出基名均vibration_monitor，须按目标/目录区分；uvprojx未变日期不代表参数旧，实际改的是参数头 | calibration.uvoptx目前不存在，DAP选择可能需在新工程设置中核对，未代为修改或烧录；项目功能完整性与尚未完成新固件板测/3ms和瞬态问题分别说明，未新增测试通过声明 |
| 2026-11-01 | 校准暂时收尾后按原计划转算法板测 | 用户明确暂结束传感器校准，保留离线/参数/软件构建已完成及新固件板测待证据；核对原stage_plan和board_test_plan，不新增功能阶段 | 下一步先B03+固定源ILA快照：FixedSource、filtered/debug，D0固定三轴、D1零三轴，feature_valid触发检查有效窗口及零特征/无报警；之后B07真实滤波、B09数字频率报警、B10恢复冷启动、最终回归/演示 | 更新next_task最新接续及final_board_record过时总述；明确手工ILA不自动改变RETURN_FILTERED，真实校准D0不再等于I2C原始字节，滤波D1需乘4；3ms与旧静止瞬态继续待查，不回写已解决 | 本轮仅计划/文档接续，无仿真/构建/下载/硬件操作，不将校准暂时收尾改写为整体验收通过，不重复六面或已有60秒记录 |
| 2026-11-01 | 当前GUI bit/ltx可用范围核对 | 用户询问impl_1/system_top.bit与ltx是否可用并说明已加载板上；只读xpr、综合/实现日志、调试XDC、ltx及已有报告，不修改Vivado生成文件 | 顶层system_top、RETURN_FILTERED=0，u_ila_0 21组427位；bit生成成功、既有WNS5.573ns/WHS0.016ns、8项DRC Warning；Tcl同次write_bitstream/write_debug_probes，SHA256保存gui_bitstream_20261101.json | 当前可做FixedSource+ILA内部零特征验证，D1仍应与D0相同；probe19/20/18/17对应feature_valid/quality_valid/alarm_valid/window_id，不能照搬预制版probe0；要D1零三轴需filtered模式另构建或使用已配对产物 | 未重跑仿真/实现、未连接硬件管理器或读取板上UUID，不把用户已下载报告当本轮独立板测；未改RTL/约束/xpr/生成缓存，更新接续文档和AI记录 |
| 2026-11-01 | Hardware Manager调试文件错配定位 | 用户提供控制台：PROBES/FULL_PROBES为rc1/fpga/debug/system.ltx，而PROGRAM.FILE为rc1/fpga/filtered/system.bit，随后no supported debug cores和stage7_ila UUID被丢弃 | 原构建仅debug版插入stage7_ila，filtered版只有滤波回传；需将PROGRAM.FILE改为同目录debug/system.bit并重新program/refresh，ltx不能给无核bit增加ILA | 仅依据用户日志与已读构建脚本定位，给出明确配对路径/命令，未代为修改Hardware Manager或下载；不先把此错配归因为PL时钟/扫描链，不声称修正后已在板上验证 | filtered仍可独立测试串口滤波但不支持ILA；当前需要ILA时使用debug bit+debug ltx，完整板测状态不变 |
| 2026-11-01 | FixedSource滤波归零与ILA截图检查 | 用户保存ila_debug.atkdl、两UART CSV及ILA PNG；本轮实际解析5秒20MS/s记录，ZIP CRC与4输入前后哈希通过，图片实际打开人工审阅 | D0/D1各1250完整包，输入1/-1/-32768、输出0/0/0，SEQ对应/XOR/位值/起止位全通过，无缺口重复/警告；间隔均值3.999949ms、范围3.992～4.002ms，无3ms；ILA质量/报警有效，MS/RMS/峰值0，alarm_axes0，window C1-C2及SEQ模差127 | 新增analyze_fixed_filter_ila_20261101.py、独立analysis.json及fixed_filter_ila_validation_20261101.md，实际运行时python.exe -X utf8 report/evidence/analyze_fixed_filter_ila_20261101.py退出0；B03本份记录通过，B08仅零快照证据，后续B07真实输入 | ILA图历史filter_restart/aborted_windows各2如实保留，原因未定；左值栏feature_valid=0对应起点光标，不据此判触发失败或伪称验证单拍/512ms周期；只有PNG无原始ILA数据，不假定其与稍后UART为同一时段；未重新采集/操作硬件/改固件RTL约束或重建，SensorSource时序及动态报警仍待验收 |
| 2026-11-01 | 新校准真实输入与filter_test_2滤波核查 | 用户确认FPGA未重配、STM32启动后才采集，约5.76秒开始移动且可能碰探头；实际20秒20MS/s/RLE，4输入前后SHA256及归档CRC通过 | D1共5010完整包无SEQ/XOR/位值问题，I2C六字节5009笔；4947帧I2C按新Q16校准与实测D0全匹配。D0有16警告/Break、8处停止位问题和62帧缺测，集中5.763～6.041秒，D1/I2C连续，探测受扰为推断而非已定位电气原因 | 新增analyze_filter_test_2_20261101.py及独立JSON/逐帧CSV、filter_test_2_validation_20261101.md；实际运行时python.exe -X utf8 report/evidence/analyze_filter_test_2_20261101.py退出0。初态按signed32全范围传播、分段跳过1024样本：纯实测两段2892帧精确匹配；含62帧I2C校准重建的整体后段3986帧也匹配，来源分列，不签首段初始化 | 更新next_task和板测记录，撤销没有新固件实际输出的过时状态；39次约3ms仍在，本次无新增ILA，不宣称RMS/报警/冷启动通过。B07完整无缺测及已知启动仍待补；未改固件/RTL/约束/原始数据/Vivado设置或操作硬件，后续先动态ILA并补干净启动，不重采六面 |
| 2026-11-01 | filter_test_3从首包滤波及复位前ILA核查 | 用户说明先ILA、复位STM32后采集，先静止再慢移；实际文件含0.178秒身份/初始化及0.383823秒SEQ=0首包，首包前D0无字节超过12ms，按现有断流重建规则确定滤波初态，不当FPGA全局复位 | 4915帧I2C经新Q16校准与D0全匹配；4914完整D1从首包及预热起精确匹配，差0、无输入重建或前段剔除；末SEQ32包六字节前缀匹配但被20秒右边界截断，不当内部丢包。41次约3ms仍在，约250.526包每秒 | 新增analyze_filter_test_3_20261101.py、独立JSON/逐帧CSV及filter_test_3_validation_20261101.md；运行时python.exe -X utf8 report/evidence/analyze_filter_test_3_20261101.py实际退出0，旧stage4参考及NumPy独立卷积、协议/初始化/校准/末包/原始5文件哈希断言通过。首次临时预览误用partial键中止，改用partial_packets后成功 | 实际打开ila_3.png人工核对：8AC到8AD、128点SEQ、MS开方得RMS、峰值合理、quality与alarm_valid为1、axes0、drop0，历史restart/aborted各6未在截图增加。图发生于后续复位前，不能与UART逐窗配对；37个后续窗口RMS最大1099/381/533属模型预测，不当实测ILA。B07本记录通过，B08/恢复/冷启动仍待；未改RTL固件约束原始证据或操作硬件，不重采六面 |
| 2026-11-01 | 第三次滤波通过后的具体ILA操作安排 | 用户询问下一步；先读现有B08/B10方案并核对本机Vivado2020.2的write_hw_ila_data、upload_hw_ila_data、get_hw_ilas与run_hw_ila帮助 | 新增ila_next_capture_20261101.md，安排static/motion独立同步记录；各重配同版debug、DL16从STM32启动前采集，静止预先布置触发，运动中再布置触发，完整导出ILA与CSV后才开始下一份，避免此前ILA与复位后UART不同运行无法配对 | 提供Tcl Console上传及原始ILA/CSV写盘命令，无-force，按现有hw_ila_1命名；1024连续PL采样约20.48us，不误设仅feature_valid捕获等待1024窗口；真实静止不要求零特征，不降低报警门限 | 仅新增说明与接续文档，未执行Vivado Tcl、连接硬件、修改下载设置或重跑仿真构建；下一步数值对照完成后继续恢复/冷启动和受控数字报警，3ms仍独立待定位 |
| 2026-11-01 | filter_test_4静止与运动原始ILA精确核查 | 用户保存两目录全部7文件，确认static未重配、motion重配过FPGA且ILA均在各自DL16期间触发；14输入前后SHA256及4ZIP CRC通过，两ila.csv与各自.ila内waveform.csv字节相同，PNG实际打开 | static4752帧校准与滤波全匹配；motion4829帧实测校准匹配、I2C/D1共4834帧连续，D0在3.34秒缺5帧并有Stop bit error/Break，独立标注I2C校准重建，4834滤波匹配，缺测后纯实测保守初态核查3145帧匹配 | 静止发布ID5620精确匹配局部窗口0；运动ID53/54精确匹配局部6/7，三窗9特征均一致，累计ID非0不当无法配对。原始CSV各1024点、512点唯一feature脉冲、字段同点更新保持。静止触发前alarm_valid0配旧保留特征，触发后1；运动Z报警100及下一低窗保持与模型相同，未直接捕获置位/解除边沿 | 新增analyze_filter_test_4_20261101.py、独立结果/逐帧CSV、filter_test_4_validation_20261101.md并更新进度/验收；实际运行时python.exe -X utf8 report/evidence/analyze_filter_test_4_20261101.py退出0，旧stage4与NumPy卷积及stage5窗口/报警参考交叉核查。纠正旧窗快照接收计数不能减旧窗样本数倒推累计基值，当前事件按末项对齐 | B08窗口数值子项通过、整体报警/恢复仍待；模型高窗2975/2226及后低窗325/416不全冒充ILA实测。两份41次3ms保留，原始静止瞬态不删；不因ID重采、不改阈值或参数。未操作硬件、改RTL固件约束原始证据/下载设置或重跑仿真构建 |
| 2026-11-01 | 窗口数值通过后安排Z报警边沿采集 | 用户询问下一步；核对当前threshold_alarm两窗置位/解除规则、本机2020.2 run_hw_ila的AND与ALWAYS属性，并查阅AMD UG908的Binary R/F/X含义 | 新增alarm_edge_capture_20261101.md及next_task入口，两份独立记录使用RXX与FXX，组合feature_valid/quality_valid/alarm_valid均为1；按住STM32复位重配、先DL16后启动，置位运行持续运动，解除运行从开始等待下降沿，避免人工切换错过约0.5秒窗口 | 方案补充两窗门限参考及正常解除与失效清零区别、20秒未触发时停止等待单独归档、原始ILA与CSV导出；沿用现有配置参数，不引入高级触发/新RTL或改门限 | 仅文档和操作指导；R/F定义有官方文档依据但本轮未连硬件执行，未声称触发或报警板测新通过。本机set_property独立帮助文件未找到，不据此推断命令不可用；最终方案采用GUI设置 |
| 2026-11-01 | 按独立比赛项目纠正过重验收范围 | 用户询问剩余测试必要性并强调不是上市工程项目；重读project_context明确目标为复杂度可控、可演示并量化FIR效果资源，核对既有阶段和实物证据，未取得比赛规则全文 | 承认此前把完整验收表机械当必做清单导致范围偏重；新增competition_closeout_20261101.md，默认收敛为一次完整演练、观察正常解除、可顺带复位恢复及整理当前演示文件/已有材料。边沿逐拍、全部实物频点、三轮冷启动、重复校准/长采集和已自检覆盖的故障注入改为可选，不再自动阻塞比赛收尾 | 更新next_task入口及final_board_record范围说明；保留原始未测状态和已有证据，不伪造通过。采样约250.5Hz/3ms短间隔、静止瞬态和标准机械频响限制如实说明，是否升级修复取决于演示影响或具体评分要求 | 本轮只调整计划/文档，未执行新测试、硬件操作、构建、代码/约束或发布变更；当前校准STM32与旧rc1程序须在演示文件中区分，不借简化测试混淆版本 |
| 2026-11-01 | 比赛范围下的一次完整演练指导 | 用户询问精简演练具体操作，核对competition_closeout及已有第4次证据，确认配对debug bit/ltx和新校准HEX副本存在 | 新增competition_rehearsal_20261101.md及next_task入口：一次重启配置，feature/quality/alarm_valid三行固定1，alarm_axes依次==000、!=000、==000，AND触发静止/报警/恢复状态，任一轴报警即可；保持ALWAYS1024点与512位置 | 明确ILA是快照，后续状态需重新Run Trigger、Value光标移到触发右侧；放稳恢复保持程序运行，alarm_valid和quality_valid仍为1才算正常解除，不要求采边沿。最少三张截图或一段视频，DL16新长记录/CSV不作要求，复位恢复为可选 | 本轮只给操作说明，未执行硬件操作、改功能代码/约束/下载设置或重跑构建，不将指导预期写成演练通过；后续演练成功后转材料与版本归档，不追加无关测试 |
| 2026-11-01 | 比赛最终三阶段演练截图检查通过 | 用户保存filter_test_final的01_static/02_alarm/03_recovery三图；本轮逐张打开查看，光标在触发右侧809/809/783；人工转录十六进制数并实际运行Python整数开方/峰值/计数关系检查，PASS final_demo_manual_transcription_arithmetic_checks | 静止RMS23/23/29、报警0；运动3372/827/1282、报警1即X轴；恢复17/18/21、报警0。三种状态quality/alarm_valid均1，报警图直接见0到1，X前后RMS2329/3372符合连续两高窗；恢复边沿虽不在图内，状态证据满足已约定比赛演练范围，不追加采集 | window4338/4549/4733与rx555865/582873/606425增量严格为128倍，drop均0，restart/aborted均3且不增加，支持连续运行后有效恢复；不冒称截图覆盖完整上电流程或全部周期。新增competition_rehearsal_validation_20261101.md，更新next_task及板测表，B08按比赛功能范围通过，版本/材料归档仍待 | 默认功能测试结束，后续转比赛材料与当前文件归档，不继续机械要求边沿、三轮冷启动或完整工程未测项。原图未改，无硬件操作、仿真/构建、RTL固件约束或下载设置变更 |
| 2026-11-01 | 用户新增板载蜂鸣器小扩展并完成软件自检 | 先读project_context/hardware_pinmap与实际底板1/5、核心板3/7/12页并渲染查看，追踪BEEP经J2.60/X3.60/B35_L23_P到M14，S8050高有效、Bank35图面3.3V；旧G盘规格书不可用，另由厂家领航者资源说明确认有源 | 用户请求授权小模块，先说明接口、单输出寄存器、无FSM/分频、20ns响应及验收范围后实施：新增alarm_buzzer、独立system_buzzer_top和buzzer.xdc，保持原system_top及18份RTL、STM32/协议/门限不变；旧RTL哈希与rc1一致，新顶层归一化差异仅输出支路/端口及默认filtered | 实际sim/run_buzzer.ps1的ModelSim/XSim两用例均通过，单模块42检查、顶层12732334检查各0错误；1056合法包与1坏包，UART和427位快照逐拍等价，覆盖报警/解除、坏校验和断流恢复。首次环境DLL问题换正常环境，初次TB超时常量改显式64位后重跑通过，失败日志保留 | 新Vivado只构建build/buzzer_release/debug，新旧文件隔离；首次启动环境访问失败后正常环境重试，当前构建尚在进行，不先宣称时序/bit或实物发声通过。新增设计/报告/检查JSON及pinmap/next_task记录，不操作硬件或旧工程缓存 |
| 2026-11-01 | 独立蜂鸣器debug构建完成 | scripts/build_buzzer.ps1实际退出0，生成build/buzzer_release/debug/system.bit与system.ltx，顶层system_buzzer_top、RETURN_FILTERED1、50MHz、M14/LVCMOS33/DRIVE8/SLOW实际IO报告核对通过 | 内部setup7.377ns/hold0.020ns，0无时钟寄存器/0未约束内部端点；6625LUT/11521FF/6DSP/12BRAM，较原debug增加1FF、DSP/BRAM不变，LUT整体映射变化不解释为负开销。DRC8项Warning类别/数量如旧，无Error/Critical，构建总Warning消息45如实区分；CDC仅10项CDC-3及2项CDC-9 Info | 新bit SHA256=2631a9d1d3e89ccb0ec4de3fe9626d780cc754945f69c6f3dffbdafb57ee7b4b；新ltx与旧debug字节相同因探针配置未变，仍建议从新目录配对下载。旧rc1四个FPGA下载文件指纹全部不变，新构建指纹/资源保存build.json及build_manifest.json | 更新验证报告、设计、接续及板测范围说明；原演练为无蜂鸣器版本，不充作新声音板测。用户只需保持STM32当前程序并下载新bit/ltx确认响停；未代为连接或下载硬件、未修改旧工程/缓存/原有RTL或门限，不要求重跑整套比赛验收 |
| 2026-11-01 | 依据正式初级组指南制定一晚收尾计划 | 用户提供F盘比赛PDF及4页截图，选择初级组并希望一晚完成；普通环境无法访问F盘，换正常执行环境只读成功，PDF共28页，读取3.3及通用部分并渲染查看物理22～25/28页，原文件SHA256=c6ad82acd4f7bdcd13bd412e232ed85d05f2a87dd5e2cdd04f9d219f88b569fc | 确认纯RTL/PL和Zynq-7010允许，PYNQ仅推荐；2020.2可保留但需说明及复现；Skill与真实AI交互必交；权重30/20/20/15/15。第六部分决赛一页英文官方模板海报另列，不强加初级组PYNQ或其他赛道AI PC/容器要求 | 只读审计发现README/历史规则状态过时、Skill项目耦合、AI日志多为摘要、缺统一报告及许可证；旧打包器仅收旧3FPGA/2STM32目标，遗漏新校准与蜂鸣器组合。Git候选524文件约1880.20MiB，几乎全为原始证据，未发现非ASCII/空格路径，不能直接全量公开 | 新增competition_evening_plan_20261101.md及正式缺口表，给出约5小时主线、最多6小时、当前证据复用与真实基线限制，独立架构优化对照仅余量提高项；更新next_task及历史审计提示。未执行材料制作/新实验/打包/许可选择或Git推送，不把规划当完成，也不复制指南进公开仓库 |

| 2026-11-02 | 蜂鸣器交付、MIT与全流程Skill | 用户明确确认最终上板和蜂鸣器正常响应，并授权当前版本Git提交及GitHub同步；自有代码使用MIT，最终设计报告后续完成 | 后台分页读完旧聊天46轮/当前37轮（含本轮读取截点），仅导出用户/对外答复；不含内部推理、工具和附件，历史纠错保留；新技能覆盖图纸到七阶段、校准/多源实测/蜂鸣器/交付 | 新增根README与独立skill/README、工具版本2020.2、第三方依赖锁定、配对bit/ltx/校准HEX、精选原始UART无损压缩与参考；工程包不依赖旧xpr缓存 | 真实4914完整回包重新解码并与独立整数/卷积参考一致；11项主机自检通过；新Skill格式和异列名正常/错误/恢复脚本通过；首次系统临时目录写入受限、设置本次进程TEMP到工作区后通过，PyYAML使用既有本地验证依赖 | 公开仓库排除第三方库/原始PDF/长期原件；本地独立包保留原许可库，设计报告未完成，不将软件检查当本轮重新板测 |
| 2026-11-02 | 独立工程包真实复现核查 | 主版本提交af8a7c9已实际推送并通过ls-remote核对；按用户指定目录生成工程包 | 从独立目录实际运行XSim两项，42/12732334检查均errors=0；Keil校准全量重建0错误0警告，HEX与交付哈希相同；4914真实回包、11主机自检、文件指纹及88依赖导入通过 | report/final_package_review_20261102.md/.json记录命令、结果与范围；包中根README与skill/README分开，最终清单526文件，第三方依赖保留原许可 | 实际完成工程包/Skill核查；本轮没有重新Vivado实现或操作硬件，原始长期记录继续本地保留；最终设计报告按用户要求后续完成 | 生成的仿真/编译输出归档到原工作区build/final_verification，包仅保留必要源文件和选定历史发布证据 |
| 2026-11-02 | 官方模板设计报告正文完成 | 读取官方DOCX及两段历史交互、阶段报告、原始实测与实际原理图；用户确认暂缺照片，保留待补位置 | 完成22页设计报告，保留模板页面/页眉页脚和五部分，补系统/流程图、真实数据曲线、ILA与量化证据，标明Vivado2020.2和证据边界 | 原模板SHA256未变，成品结构/字数核查及6项技能审计退出0；Word原生只读导出，经技能渲染适配后逐页查看22页；20个未修改部件逐字节一致 | 三处实物照片仍待补，不伪造、不把数值模型当机械实测；同步本地最终包及文件指纹，无新RTL/固件/仿真实现/板测或Git推送 |
| 2026-11-02 | 自有RTL与STM32详细中文注释 | 按用户要求在原目录及提交包共40份自有源码添加职责、运行流程、时序/位宽、设计取舍与错误恢复说明；新增362行，厂商库保留 | 去注释后词法记号、预处理及综合工具指令内容/位置40/40相同；XVLOG2020.2全部20模块编译通过；两个既有主机自检通过，校准覆盖196608轴值 | Keil首次受限环境CreateProcess失败，保留日志后正常环境重试，三个目标均0错误0警告；校准HEX与发布哈希完全一致 | 同步40份源码与核查/日志到最终包并更新指纹；未重新RTL仿真、综合实现或板测，未更改功能/协议/参数/下载设置，未推送Git |
| 2026-11-02 | 中文报告名称与完成状态同步 | 用户明确要求保留技术文档word版.docx和技术文档pdf版.pdf，更新清单/README并移除当前照片待办 | 以用户补图后的两份文件为权威输入，同步原目录；PDF23页，DOCX结构完整，无旧照片占位文字；正文及图片字节未改 | 清单登记两份文件及新指纹、报告完成true；校验器移除历史未完成硬编码，打包器仅对指定两份名称允许中文且不重复收英文初稿 | 初稿22页逐页检查保留为历史范围，不冒称新版23页重做视觉审核；更新AI日志与当前归档说明，随后实际校验，无RTL/固件/下载文件修改、构建板测或Git推送 |
| 2026-11-02 | 最终报告与中文注释授权Git同步 | 用户确认独立工程包已移出当前目录，明确要求再次提交并同步GitHub | 本次纳入40份自有源码中文注释、补图后的中文Word/PDF、README/当前报告状态及校验和组包脚本；英文初稿、厂商库、缓存和外移包不提交 | 提交前实际文件核验通过，33个发布文件/88个依赖及40个注释后源码指纹一致；远端main为4809384，与本地基线相同 | 既有Keil/XVLOG/协议校准验证结论按原记录保留，本次未重新硬件测试；本条在提交前写入，提交及远端同步以实际Git记录和最终回执为准 |
