FFsteve/zynq_vibration_monitor/board/fpga/debug/probe_map.tsv

probe | signal | width
0 | feature_valid_o | 1
1 | quality_valid_o | 1
2 | alarm_valid_o | 1
3 | alarm_axes_o | 3
4 | window_id_o | 32
5 | seq_start_o | 8
6 | seq_end_o | 8
7 | ms_x_o | 35
8 | ms_y_o | 35
9 | ms_z_o | 35
10 | rms_x_o | 18
11 | rms_y_o | 18
12 | rms_z_o | 18
13 | peak_x_o | 18
14 | peak_y_o | 18
15 | peak_z_o | 18
16 | rx_frame_count_o | 32
17 | dropped_count_o | 32
18 | completed_count_o | 32
19 | filter_restart_count_o | 32
20 | aborted_windows_o | 32
