FFsteve/zynq_vibration_monitor/(commit log)

2026-10-31 Save PL vibration monitor stages and experimental calibration
    [fir_lp_63_q16.csv, samples_comparison.csv, sensor_source_d0_20261030.csv, sensor_source_d1_20261030.csv, sensor_source_i2c_20261030.csv, sensor_zdown_d0_20261030.csv, sensor_zdown_d1_20261030.csv, sensor_zdown_i2c_20261030.csv]
2026-11-02 Release verified buzzer prototype with MIT docs and reusable workflow skills
    [comparison.csv, frames.csv, motion.csv, motion_frames.csv, noreset_zn_frames.csv, probe_map.tsv, static.csv, static_frames.csv]
2026-11-02 补充中文源码注释并归档最终设计报告
